whyvas/filament-falcon/docs/SPEC.md

# The Filament Falcon: master spec (v0.1)

A three-seat home spaceship cockpit: two small front seats (kids) side by side, one larger seat behind and centered (dad). Everything that a person touches is 3D printed and bolts to a wooden frame. This file is the single source of truth that the CAD, electronics, and game folders all follow. If something here has to change, change it here too.

## Computer
Linux Mint, AMD Ryzen 9 5900X (12c/24t), Radeon RX 6800 XT (16 GB, Vulkan/Mesa RADV), 32 GB RAM.
Four displays on the 6800 XT (2 x DP 1.4, 1 x HDMI 2.1, 1 x USB-C; max 4 heads, so all four heads are now in use), all 1920 x 1080 (mechanical details in `docs/mechanical/displays.md`). Screen roles, with the owner's xrandr output names as of v0.3:
- LEFT WINDOW (PILOT): Sceptre C275B-144R, 27" 1800R curved, up to 144 Hz (run at 75 Hz), VESA 100. Output DisplayPort-2.
- RIGHT WINDOW (OPS): Sceptre C275W-1920RN, 27" 1800R curved, 75 Hz, VESA 75. Output DisplayPort-1.
- KIDS' CONSOLE: ViewSonic TD2220, 21.5" optical touch (USB-B), VESA 100, DVI-D/VGA only -> DP (or USB-C) to DVI-D adapter. It lies flat in the reclining center console between the kids and faces them when reclined. Output DisplayPort-0. Use it in landscape (the game also handles portrait). The touch input must be mapped to this output (`xinput map-to-output`; `game/tools/setup_displays.sh` does it and `game/run.sh` runs it before every launch). While the game runs, `game/tools/touch_isolate.sh` keeps touches off the mouse pointer and the Commander's keyboard focus.
- COMMANDER: a 31.5" 1920 x 1080 monitor at dad's seat (mouse + keyboard, no touch). Output HDMI-A-0.
- The game assigns the roles by output name and physical size (console = the ~22" or portrait panel, commander = the biggest remaining screen, windows left to right). Each role can be pinned to any output in the settings file or on the Commander SETUP page. With only three screens the Commander UI becomes a tab on the kids' console (Esc). With fewer, dev mode tiles all four views in one window.
- VR: a Meta Quest 3 on a USB-C cable to the same PC, streamed by WiVRn (Flatpak `io.github.wivrn.wivrn`), which is the OpenXR runtime while the headset is connected. Setup in `docs/game/VR_SETUP.md`.
- With all four heads used, a later projector dome (`docs/mechanical/projector_dome_study.md`) has to replace the two window monitors, or use a USB/DP-MST splitter.

## Seats and motion
(Changed on the `cad` branch, v0.2: the swinging/raised seat platform is gone. Details in `frame/README.md`.)
- The seats sit on a floor-level frame. Flight sequence: (1) the kids' seat cradle (both kid seats, side consoles, sticks, center touchscreen) reclines 35 deg backwards, astronaut launch-style; (2) then the instrument POD (both monitors, dash panels, overhead panels) rotates down from its parked position above the kids into place in front of them. Exit = reverse order (pod up first, then seats upright).
- Both motions use 12 V self-locking linear actuators (2 for the cradle; ONE for the pod, in the left casing, with a steel torque tube tying the right pod cheek to the driven left one), slow (~35-40 s per motion). The pod's gas struts make it slightly lift-biased so an actuator failure sends it up, away from the kids, its pivot is the reclined head centre so it cannot approach the faces, steel hard stops set the end positions with measured clearances (>= 195 mm to the thighs, >= 250 mm to the head), and spring pawls lock it mechanically both UP and DOWN.
- Hardwired sequencing with limit switches: the pod can only come down when the seats are fully reclined, and the seats can only move while the pod is up and locked.
- Controls only at dad's seat, hardwired (no microcontroller in the loop): key switch, E-stop, a momentary hold-to-run FLT/BRD toggle, plus a latch-release lever that must be held for any pod motion (two-hand control). Circuit: 20 A fuse, key + E-stop drop a MOTION relay, 4 automotive relays as 2 H-bridges (cradle, pod), NC limit switches each bridged by a 1N5408, lock and lever switches in the relay coil paths, a safety edge on the pod chin in series with "pod DOWN" (`docs/electronics` diagram 04).
- The software may READ cradle/pod positions but never drives the actuators: three separate dry contacts through PC817 optocouplers into Falcon Command: CRADLE_RECLINED (GPIO39), POD_DOWN_LOCKED (GPIO40) and the optional POD_UP_LOCKED (GPIO41). The game shows POD UP / MOVING / DOWN-LOCKED and SEATS UPRIGHT / MOVING / RECLINED on the Commander screen and announces "pod coming down" etc. over the intercom.
- Dad's seat is fixed (no recline, no pod): he is the safety observer and must see the kids while anything moves.
- Homemade 4-point harnesses through a printed hub that houses the kit's own buckles (positioning harness, not crash-rated; load path through webbing and a steel ring). Motion only after the "harnesses fastened" step of the checklist (honour system, game shows it).

## Roles (designed to be equally fun)
- Left seat, PILOT ("Flight"): rotation and main engine. Joystick = pitch/roll/yaw + trigger. Throttle lever. Engine arm (covered toggle), ignition button, landing gear lever, flight-assist mode rotary (OFF / STAB / PROGRADE / HOLD), airbrake/flaps, boost, view cycle, horn.
- Right seat, OPS ("Systems/Commander"): translation, systems, and payload. Joystick = RCS translate X/Y + Z(twist) + trigger (also drives the robotic arm, tractor beam, and sensor camera depending on mode). Power distribution toggles (REACTOR, LIFE SUPPORT, SHIELDS, COMMS, SENSORS), mode rotary (RCS / ARM / SCANNER), cargo bay doors, docking clamp, scanner ping, fire suppression, nav target select, jump/warp arm + engage (covered).
- Each mission gives both seats a hero moment (e.g. Pilot flies the launch and landing; Ops does the docking translation, arm capture, and hyperspace jump).
- Rear seat, COMMANDER / MISSION CONTROL (dad): crew-motion hold switch + pod release lever (hardwired), key switch MASTER POWER, mission select rotary, START / PAUSE, MASTER CAUTION reset, failure-injection buttons (ENGINE FIRE, CABIN LEAK, POWER FAULT, SENSOR GLITCH), INTERCOM push-to-talk and ALL-CALL/PA buttons, cockpit lights dimmer.
- Optional 4th crew member, SPACEWALKER (VR): wears the Quest 3 and does spacewalks (EVA) standing in a clear area OUTSIDE the cockpit frame: handrails, SAFER jetpack, tether, tools, samples, the robotic arm's foot restraint. The crew sees them in the window views and camera feeds; the Commander starts and ends every EVA. Optional: everything also works on screen with no headset.
- Overhead console (shared, above the kids): launch checklist switch row (BATTERY, FUEL PUMPS, AVIONICS, APU START, GUIDANCE, IGNITION ARM), cabin lights, beacon, strobe, EJECT (covered, just for fun), each with a backlit label and status LED.
- Each kid also has a push-to-talk button on their board (16 mm momentary, within reach of the stick).
- Kids' console touchscreen (game UI, only for the two kids): attitude ball, speed/altitude tapes, fuel, engine/gear/flaps/assist, power distribution toggles, RCS/ARM/SCANNER mode, cargo doors, docking clamp, nav target and steer-to, overhead checklist status, camera feeds (docking/arm/chase), each kid's current task and MASTER CAUTION, a TALK pad per kid. Every touch control mirrors a hardware control; plugged-in hardware wins. While a board is unplugged its panels are drawn on screen (virtual panels, generated from the CAD layouts; guarded switches need two taps), with a touch joystick for a missing stick; the same for Falcon Command on the Commander screen.
- Commander screen (game UI, dad, mouse/keyboard): mission select and briefing, START/PAUSE/RESTART/skip step, harness check, failure injection, MASTER CAUTION reset, difficulty and assist settings, time warp, live score, a mission-control overview (orbit map, telemetry, crew status with both kids' current tasks, ship health, faults, crew position, intercom TALK / ALL-CALL / mutes), controls test, board status (plugged in or virtual), the Falcon Command panels on screen, the intercom page, and SETUP (screen roles, headsets, quality, FPS cap, vsync).

## Panels
- Dark panel body, white letters that go all the way through the panel so LEDs behind shine through them. One multi-material 3MF per panel: the panel and the letters are separate objects, each with its own extruder and colour. The letter object includes a 0.8 mm box behind every label (diffuser, inside the light box).
- A WS2812B strip channel on the back directly behind each lettered label, with light-blocking walls between labels. ONE continuous WS2812B strip snakes through every panel; segments are mapped later in `shared/led_segments.json`.
- Every panel uses one mounting standard: a 40 mm grid, M5 bolts into M5 T-nuts (or 1/4-20 if the owner prefers) pressed into 18 mm (3/4") plywood rails. Max part size 220 x 220 mm so it fits most printer beds; bigger panels split along the grid with alignment pins.
- Standard holes: 6.2 mm mini toggle, 12 mm and 16 mm momentary buttons, 19 mm/22 mm arcade buttons, 5 mm LED, EC11 rotary encoder (7 mm), key switch (19 mm), plus printed toggle covers (missile-switch guards).

## Electronics
- Microcontroller: ESP32-S3 (DevKitC-1 or equivalent with the native USB port). Reason: native USB so it enumerates as a real HID joystick on Linux and Windows with no drivers; the ESP8266 and classic ESP32 have no native USB.
- Three boards, each its own USB HID gamepad with a distinct product name: "Falcon Pilot" (left), "Falcon Ops" (right), "Falcon Command" (dad + overhead). Falcon Command is a composite device (HID + USB CDC serial) and also drives the single WS2812B data line.
- Lots of switches go through 74HC165 shift registers or MCP23017 expanders; analog axes go to ADC1 pins (3.3 V reference).
- The game sends LED state to Falcon Command over the CDC serial port using the protocol in `shared/led_protocol.md`.

## Intercom (ICS)
- Three USB headsets (Pilot, Ops, Commander). Each mic is heard in the other two headsets (optional low sidetone in your own); game audio (engine, alarms) and the voice callouts reach all three, with per-seat game and intercom volume.
- Per seat: VOX (threshold, attack, hang, live level meter) or push-to-talk (board button, keyboard key, or the on-screen TALK pad). Commander extras: ALL-CALL / PA to both kids (ducks game audio and the kids' mics), mute either kid's mic, and the MISSION CONTROL channel that carries the game's callouts.
- Optional radio effect: 300-3400 Hz band-pass, light compression, static, squelch tail, mic click / roger beep.
- Implementation: a separate low-latency helper (`game/tools/falcon_ics.py`, Python + numpy) on the PulseAudio protocol (`pactl`/`parec`/`pacat`), so it works on PulseAudio and PipeWire (`pipewire-pulse`). 5 ms blocks, target < 40 ms mic-to-ear. The game talks to it over localhost UDP (game -> 47810, helper -> 47811), routes its own output to the helper's `falcon_game` sink and its callouts to `falcon_mc`; `run.sh` starts it; without it the game plays sound normally.
- 4th seat SPACEWALKER: the Quest 3's speaker and mic as exposed by WiVRn ("WiVRn" sink, "WiVRn(microphone)" source), picked automatically; "suit radio" sound (400-2600 Hz, more static, Quindar tones); PTT on the left Touch controller. If the devices are missing the seat is empty (or a 4th USB headset is used).
- Headsets are assigned on Commander SETUP / ICS (IDENTIFY plays a tone in one headset), saved by product name + USB serial + USB port so replugging or re-ordering keeps them.

## Shared files (contracts between folders)
- `shared/panel_labels.json`: every backlit label id, its panel, and its text (written by CAD).
- `shared/input_map.json`: every game action -> device name + button index or axis (written by firmware; the game loads it and falls back to built-in defaults).
- `shared/led_segments.json`: label id -> start index + LED count on the one strip (placeholder until the owner measures the real strip).
- `shared/led_protocol.md`: serial protocol from game to Falcon Command.

## Game
Godot 4 (latest stable 4.x), Forward+ renderer on Vulkan, four windows (one per display: left window, right window, kids' console, commander), GDScript, plus the intercom helper (Python). Missions: launch to orbit, dock with a space station, lunar landing, asteroid-field rescue/mining, reentry and runway landing, plus a free-flight sandbox.
- VR spacewalks run in a SEPARATE process of the same project (`godot --xr-mode on -- --eva-client`, `run.sh --eva-vr`) that owns the OpenXR session and streams the astronaut's pose to the cockpit over localhost UDP 47820 at >= 60 Hz (~90 Hz); the cockpit interpolates it (45 ms buffer) and never loads OpenXR, so it runs unchanged with no headset or runtime. Spacewalks: window visit, antenna swap, asteroid sample + beacon, moonwalk, Canadarm rescue; the kids' console gets an EVA page (suit telemetry, HELMET CAM, EVA DRONE) during an EVA.

## Folders
- `cad/` 3D models (OpenSCAD source + exported 3MF + PNG renders); `frame/` wooden frame drawings, cut list, BOM.
- `firmware/` ESP32-S3 code; `docs/electronics/` wiring diagrams.
- `game/` Godot project; `docs/game/` design notes.
