whyvas/filament-falcon/frame/cut_list.md

# Cut list (generated by `frame/frame_model.py`)

All sizes in mm with inches in brackets. 2x4 = 38 x 89 mm actual (1.5" x 3.5").
Groups: **fixed** = base, nose box, towers/casings, ramp, dad dais; **cradle** = the reclining kid-seat frame; **pod** = the rotating instrument pod. Check every length against your real lumber before cutting.

| # | Group | Part | Material | Length | Width | Notes |
|---|---|---|---|---|---|---|
| 1 | fixed | Sill L | 2x4 (38 x 89) | 2450 (8' 0.5") |  | on edge, full length |
| 2 | fixed | Sill R | 2x4 (38 x 89) | 2450 (8' 0.5") |  | on edge, full length |
| 3 | fixed | Base cross, nose rear | 2x4 (38 x 89) | 1860 (6' 1.2") |  | 2x4 laid FLAT (actuators pass over it) |
| 4 | fixed | Base cross, cradle front | 2x4 (38 x 89) | 1860 (6' 1.2") |  | 2x4 laid FLAT; carries the cradle rest pads |
| 5 | fixed | Base cross, nose front | 2x4 (38 x 89) | 1860 (6' 1.2") |  | on edge between the sills |
| 6 | fixed | Base cross, cradle pivot | 2x4 (38 x 89) | 1860 (6' 1.2") |  | on edge between the sills |
| 7 | fixed | Base cross, casing front | 2x4 (38 x 89) | 1860 (6' 1.2") |  | on edge between the sills |
| 8 | fixed | Base cross, dais front | 2x4 (38 x 89) | 1860 (6' 1.2") |  | on edge between the sills |
| 9 | fixed | Base cross, dais mid | 2x4 (38 x 89) | 1860 (6' 1.2") |  | on edge between the sills |
| 10 | fixed | Base cross, rear | 2x4 (38 x 89) | 1860 (6' 1.2") |  | on edge between the sills |
| 11 | fixed | Base cross, recline stops | 2x4 (38 x 89) | 1860 (6' 1.2") |  | 2x4 laid FLAT (38 high) between the sills |
| 12 | fixed | Nose post front L | 2x4 (38 x 89) | 369 (14.5") |  | corner post |
| 13 | fixed | Nose post rear L | 2x4 (38 x 89) | 369 (14.5") |  | corner post |
| 14 | fixed | Nose post front R | 2x4 (38 x 89) | 369 (14.5") |  | corner post |
| 15 | fixed | Nose post rear R | 2x4 (38 x 89) | 369 (14.5") |  | corner post |
| 16 | fixed | Nose box front skin | 12 mm ply | 1960 (6' 5.2") | 470 (18.5") | 12 mm ply, full width |
| 17 | fixed | Nose box lid | 12 mm ply | 1936 (6' 4.2") | 300 (11.8") | screwed down (service lid), carpet on top = foot step |
| 18 | fixed | Nose box rear wall | 12 mm ply | 1860 (6' 1.2") | 369 (14.5") | 2 slots 80 x 360 for the actuators + brush strip; >= 30 mm gap to the cradle front |
| 19 | fixed | Tower post outer L | 2x4 (38 x 89) | 1011 (3' 3.8") |  | pod pivot: 25 mm shaft in a 4-bolt flange bearing / SHF25 + 6 mm steel plate on the post |
| 20 | fixed | Tower post inner L | 2x4 (38 x 89) | 1011 (3' 3.8") |  | inner shaft support (the 25 mm pod shaft is carried at both ends) |
| 21 | fixed | Casing post L d1262 | 2x4 (38 x 89) | 1011 (3' 3.8") |  | casing corner post |
| 22 | fixed | Casing post outer L d1262 | 2x4 (38 x 89) | 1011 (3' 3.8") |  | casing corner post |
| 23 | fixed | Casing post L d1922 | 2x4 (38 x 89) | 1011 (3' 3.8") |  | casing corner post |
| 24 | fixed | Casing post outer L d1922 | 2x4 (38 x 89) | 1011 (3' 3.8") |  | casing corner post |
| 25 | fixed | Casing tie L | 2x4 (38 x 89) | 190 (7.5") |  | top tie inner/outer posts |
| 26 | fixed | Side skin (casing) L | 12 mm ply | 1112 (3' 7.8") | 698 (2' 3.5") | 12 mm ply outer skin |
| 27 | fixed | Casing back L | 12 mm ply | 1112 (3' 7.8") | 278 (10.9") |  |
| 28 | fixed | Side skin (nose) L | 12 mm ply | 470 (18.5") | 300 (11.8") |  |
| 29 | fixed | Tower post outer R | 2x4 (38 x 89) | 1011 (3' 3.8") |  | pod pivot: 25 mm shaft in a 4-bolt flange bearing / SHF25 + 6 mm steel plate on the post |
| 30 | fixed | Tower post inner R | 2x4 (38 x 89) | 1011 (3' 3.8") |  | inner shaft support (the 25 mm pod shaft is carried at both ends) |
| 31 | fixed | Casing post R d1262 | 2x4 (38 x 89) | 1011 (3' 3.8") |  | casing corner post |
| 32 | fixed | Casing post outer R d1262 | 2x4 (38 x 89) | 1011 (3' 3.8") |  | casing corner post |
| 33 | fixed | Casing post R d1922 | 2x4 (38 x 89) | 1011 (3' 3.8") |  | casing corner post |
| 34 | fixed | Casing post outer R d1922 | 2x4 (38 x 89) | 1011 (3' 3.8") |  | casing corner post |
| 35 | fixed | Casing tie R | 2x4 (38 x 89) | 190 (7.5") |  | top tie inner/outer posts |
| 36 | fixed | Side skin (casing) R | 12 mm ply | 1112 (3' 7.8") | 698 (2' 3.5") | 12 mm ply outer skin |
| 37 | fixed | Casing back R | 12 mm ply | 1112 (3' 7.8") | 278 (10.9") |  |
| 38 | fixed | Side skin (nose) R | 12 mm ply | 470 (18.5") | 300 (11.8") |  |
| 39 | fixed | Ramp cheek L | 18 mm ply | 905 (2' 11.6") | 621 (2' 0.4") | triangular ply cheek under the ramp, screwed to the base (profile: see drawing 04) |
| 40 | fixed | Ramp cheek R | 18 mm ply | 905 (2' 11.6") | 621 (2' 0.4") | triangular ply cheek under the ramp, screwed to the base (profile: see drawing 04) |
| 41 | fixed | Ramp cheek centre | 18 mm ply | 905 (2' 11.6") | 621 (2' 0.4") | centre support (profile: see drawing 04) |
| 42 | fixed | Crush-zone ramp | 18 mm ply | 1083 (3' 6.6") | 1280 (4' 2.4") | 18 mm ply sloping sheet, parallel to the reclined seat backs, 120 mm below them; foam on top |
| 43 | fixed | Dais joist L | 2x4 (38 x 89) | 750 (2' 5.5") |  | 2x4 on edge on the base crosses + 72 mm block-up |
| 44 | fixed | Dais joist C | 2x4 (38 x 89) | 750 (2' 5.5") |  | 2x4 on edge on the base crosses + 72 mm block-up |
| 45 | fixed | Dais joist R | 2x4 (38 x 89) | 750 (2' 5.5") |  | 2x4 on edge on the base crosses + 72 mm block-up |
| 46 | fixed | Dais deck | 18 mm ply | 1200 (3' 11.2") | 750 (2' 5.5") |  |
| 47 | fixed | Dais front skin | 12 mm ply | 1200 (3' 11.2") | 250 (9.8") |  |
| 48 | fixed | Dad seat box | 18 mm ply box | 520 (20.5") | 450 (17.7") | outer 520 x 450 x 420 (W x D x H): top 520x450, 2 sides 450x402, front+back 484x402. 18 mm ply box, foam cushion |
| 49 | fixed | Dad seat back | 18 mm ply | 1310 (4' 3.6") | 520 (20.5") |  |
| 50 | fixed | Commander console | 18 mm ply box | 240 (9.4") | 400 (15.7") | outer 240 x 400 x 700 (W x D x H): top 240x400, 2 sides 400x682, front+back 204x682. CMD_A + CMD_B bay; motion switch + key + E-stop on CMD_B |
| 51 | fixed | Pod release lever box | 12 mm ply | 510 (20.1") | 160 (6.3") | left of dad's seat: 2 Bowden-cable latch release levers (second hand for the pod motion) |
| 52 | cradle | Cradle rail L | 2x4 (38 x 89) | 560 (22.0") |  | on edge; UCP205 pillow block bolted under the rear end (pivot) |
| 53 | cradle | Cradle rail R | 2x4 (38 x 89) | 560 (22.0") |  | on edge; UCP205 pillow block bolted under the rear end (pivot) |
| 54 | cradle | Cradle cross, front | 2x4 (38 x 89) | 1540 (5' 0.6") |  | 2x4 laid FLAT under the deck edge (actuators pass under it) |
| 55 | cradle | Cradle cross, actuator | 2x4 (38 x 89) | 1540 (5' 0.6") |  | on edge between the rails |
| 56 | cradle | Cradle cross, seats | 2x4 (38 x 89) | 1540 (5' 0.6") |  | on edge between the rails |
| 57 | cradle | Cradle cross, rear | 2x4 (38 x 89) | 1540 (5' 0.6") |  | on edge between the rails |
| 58 | cradle | Cradle joist L | 2x4 (38 x 89) | 371 (14.6") |  | between the crosses (pocket screws) |
| 59 | cradle | Cradle joist C | 2x4 (38 x 89) | 371 (14.6") |  | between the crosses (pocket screws) |
| 60 | cradle | Cradle joist R | 2x4 (38 x 89) | 371 (14.6") |  | between the crosses (pocket screws) |
| 61 | cradle | Cradle deck | 18 mm ply | 1616 (5' 3.6") | 560 (22.0") | footrest + seat base, glued + screwed |
| 62 | cradle | Cradle toe lip | 12 mm ply | 1616 (5' 3.6") | 70 (2.8") | keeps feet on the cradle |
| 63 | cradle | Cradle skirt L | 6 mm ply/hardboard | 460 (18.1") | 159 (6.3") | inner half of the telescoping side pinch guard |
| 64 | cradle | Cradle skirt R | 6 mm ply/hardboard | 460 (18.1") | 159 (6.3") | inner half of the telescoping side pinch guard |
| 65 | cradle | Kid seat box PILOT | 18 mm ply box | 340 (13.4") | 380 (15.0") | outer 340 x 380 x 193 (W x D x H): top 340x380, 2 sides 380x175, front+back 304x175. 18 mm ply box, foam cushion on top |
| 66 | cradle | Kid seat back PILOT | 18 mm ply | 1073 (3' 6.2") | 340 (13.4") | harness shoulder slots at 3 heights + headrest wings; the harness hub anchors to the cradle deck |
| 67 | cradle | Headrest wing PILOT out | 18 mm ply | 400 (15.7") | 130 (5.1") | side wings: head stays on the seat centre line |
| 68 | cradle | Headrest wing PILOT in | 18 mm ply | 400 (15.7") | 130 (5.1") | side wings: head stays on the seat centre line |
| 69 | cradle | Kid seat box OPS | 18 mm ply box | 340 (13.4") | 380 (15.0") | outer 340 x 380 x 193 (W x D x H): top 340x380, 2 sides 380x175, front+back 304x175. 18 mm ply box, foam cushion on top |
| 70 | cradle | Kid seat back OPS | 18 mm ply | 1073 (3' 6.2") | 340 (13.4") | harness shoulder slots at 3 heights + headrest wings; the harness hub anchors to the cradle deck |
| 71 | cradle | Headrest wing OPS in | 18 mm ply | 400 (15.7") | 130 (5.1") | side wings: head stays on the seat centre line |
| 72 | cradle | Headrest wing OPS out | 18 mm ply | 400 (15.7") | 130 (5.1") | side wings: head stays on the seat centre line |
| 73 | cradle | Centre console (TD2220) | 18 mm ply box | 560 (22.0") | 380 (15.0") | outer 560 x 380 x 333 (W x D x H): top 560x380, 2 sides 380x315, front+back 524x315. TD2220 drops into a 530 x 328 cut-out in the top, on a printed VESA riser + internal ply shelf; printed trim ring |
| 74 | cradle | Front pedestal | 18 mm ply box | 560 (22.0") | 180 (7.1") | outer 560 x 180 x 243 (W x D x H): top 560x180, 2 sides 180x225, front+back 524x225. pilot joystick + OPS_SIDE panel |
| 75 | cradle | Side console PILOT | 18 mm ply box | 200 (7.9") | 240 (9.4") | outer 200 x 240 x 391 (W x D x H): top 200x240, 2 sides 240x373, front+back 164x373. PILOT_SIDE + throttle + gear |
| 76 | cradle | Side console OPS | 18 mm ply box | 200 (7.9") | 240 (9.4") | outer 200 x 240 x 391 (W x D x H): top 200x240, 2 sides 240x373, front+back 164x373. Ops joystick |
| 77 | pod | Pod back sheet | 12 mm ply | 1612 (5' 3.5") | 735 (2' 4.9") | monitors' VESA adapters bolt through it |
| 78 | pod | Pod lower band (dash) | 18 mm ply | 1612 (5' 3.5") | 195 (7.7") | 2 dash bays 400 x 160 + M5 T-nuts on the 40 mm grid |
| 79 | pod | Pod top band (overhead) | 18 mm ply | 1612 (5' 3.5") | 140 (5.5") | overhead bay 600 x 120 |
| 80 | pod | Pod chin plate | 12 mm ply | 1612 (5' 3.5") | 102 (4.0") | leading edge; safety edge + 25 mm foam on its front |
| 81 | pod | Pod top cap | 12 mm ply | 1612 (5' 3.5") | 102 (4.0") |  |
| 82 | pod | Pod stiffener rail 1 | 2x4 (38 x 89) | 1612 (5' 3.5") |  | 2x4 flat behind the back sheet |
| 83 | pod | Pod stiffener rail 2 | 2x4 (38 x 89) | 1612 (5' 3.5") |  | 2x4 flat behind the back sheet |
| 84 | pod | Pod cheek L | 18 mm ply | 1183 (3' 10.6") | 907 (2' 11.7") | 2 x 18 mm ply laminated (glue + screws); UCF205 flange bearing at the pivot, crank pins for strut + actuator (profile: see drawing 04) |
| 85 | pod | Pod cheek R | 18 mm ply | 1183 (3' 10.6") | 907 (2' 11.7") | 2 x 18 mm ply laminated (glue + screws); UCF205 flange bearing at the pivot, crank pins for strut + actuator (profile: see drawing 04) |
| 86 | fixed | Casing inner wall L | 12 mm ply | 1112 (3' 7.8") | 698 (2' 3.5") | 12 mm ply between kid and mechanism (full height) |
| 87 | fixed | Casing front wall L (inner) | 12 mm ply | 1112 (3' 7.8") | 110 (4.3") | slot for the cheek next to it, brush strip on both slot edges |
| 88 | fixed | Casing front wall L (outer) | 12 mm ply | 1112 (3' 7.8") | 120 (4.7") |  |
| 89 | fixed | Casing front wall L (below slot) | 12 mm ply | 839 (2' 9.0") | 48 (1.9") | slot bottom = lowest cheek edge - 40 mm |
| 90 | fixed | Casing top L (inner) | 12 mm ply | 710 (2' 4.0") | 110 (4.3") | lift-off service lid |
| 91 | fixed | Casing top L (outer) | 12 mm ply | 710 (2' 4.0") | 120 (4.7") |  |
| 92 | fixed | Casing top L (behind slot) | 12 mm ply | 375 (14.8") | 48 (1.9") |  |
| 93 | fixed | Strut anchor post L | 2x4 (38 x 89) | 1011 (3' 3.8") |  | gas-strut lower ball stud on a steel angle bracket |
| 94 | fixed | Casing inner wall R | 12 mm ply | 1112 (3' 7.8") | 698 (2' 3.5") | 12 mm ply between kid and mechanism (full height) |
| 95 | fixed | Casing front wall R (inner) | 12 mm ply | 1112 (3' 7.8") | 110 (4.3") | slot for the cheek next to it, brush strip on both slot edges |
| 96 | fixed | Casing front wall R (outer) | 12 mm ply | 1112 (3' 7.8") | 120 (4.7") |  |
| 97 | fixed | Casing front wall R (below slot) | 12 mm ply | 839 (2' 9.0") | 48 (1.9") | slot bottom = lowest cheek edge - 40 mm |
| 98 | fixed | Casing top R (inner) | 12 mm ply | 710 (2' 4.0") | 110 (4.3") | lift-off service lid |
| 99 | fixed | Casing top R (outer) | 12 mm ply | 710 (2' 4.0") | 120 (4.7") |  |
| 100 | fixed | Casing top R (behind slot) | 12 mm ply | 375 (14.8") | 48 (1.9") |  |
| 101 | fixed | Strut anchor post R | 2x4 (38 x 89) | 1011 (3' 3.8") |  | gas-strut lower ball stud on a steel angle bracket |

**2x4 boards:** 45 pieces from **22 x 8 ft (2438 mm)** + **2 x 10 ft (3048 mm)** boards (first-fit packing, 4 mm kerf; buy 3 spares). The 2450 mm sills need 10 ft boards (or 2 x 8 ft spliced over a base cross).

Board packing:
- board 1 (10 ft): 2450  (waste 594 mm)
- board 2 (10 ft): 2450  (waste 594 mm)
- board 3 (8 ft): 1860 + 560  (waste 10 mm)
- board 4 (8 ft): 1860 + 560  (waste 10 mm)
- board 5 (8 ft): 1860 + 371 + 190  (waste 5 mm)
- board 6 (8 ft): 1860 + 371 + 190  (waste 5 mm)
- board 7 (8 ft): 1860 + 371  (waste 199 mm)
- board 8 (8 ft): 1860 + 369  (waste 201 mm)
- board 9 (8 ft): 1860 + 369  (waste 201 mm)
- board 10 (8 ft): 1860 + 369  (waste 201 mm)
- board 11 (8 ft): 1860 + 369  (waste 201 mm)
- board 12 (8 ft): 1612 + 750  (waste 68 mm)
- board 13 (8 ft): 1612 + 750  (waste 68 mm)
- board 14 (8 ft): 1540 + 750  (waste 140 mm)
- board 15 (8 ft): 1540  (waste 894 mm)
- board 16 (8 ft): 1540  (waste 894 mm)
- board 17 (8 ft): 1540  (waste 894 mm)
- board 18 (8 ft): 1011 + 1011  (waste 408 mm)
- board 19 (8 ft): 1011 + 1011  (waste 408 mm)
- board 20 (8 ft): 1011 + 1011  (waste 408 mm)
- board 21 (8 ft): 1011 + 1011  (waste 408 mm)
- board 22 (8 ft): 1011 + 1011  (waste 408 mm)
- board 23 (8 ft): 1011 + 1011  (waste 408 mm)
- board 24 (8 ft): 1011 + 1011  (waste 408 mm)

**Sheet goods** (area incl. seat/console boxes; 4 x 8 ft = 1220 x 2440 mm sheets, ~30 % waste allowance; the pod cheeks are 2 layers each):

- 12 mm ply: 9.16 m2 (99 sq ft) -> **4 sheet(s)**
- 18 mm ply: 13.48 m2 (145 sq ft) -> **6 sheet(s)**
- 6 mm ply/hardboard: 0.15 m2 (2 sq ft) -> **1 sheet(s)**
