whyvas/filament-falcon/docs/game/CREDITS.md

# Credits: The Filament Falcon game

- **Engine:** [Godot Engine](https://godotengine.org) 4.7 (MIT). It is not bundled in this repo.
- **Art:** none downloaded. The planet, clouds, city lights, Moon, terrain, star field, Milky Way, ship,
  station, asteroids and runway are all generated procedurally at run time from code and shaders in `game/`.
- **Audio:** none downloaded. Engine rumble, RCS puffs, alarms, clunks, the laser and tones are synthesized in
  `game/scripts/autoload/sfx.gd`.
- **Voice:** uses the player's system `espeak-ng` (GPL-3.0) or a user-installed piper voice at run time. Nothing is bundled.
- **Font:** Godot's built-in default font.

Total size of third-party assets in the repo: **0 bytes**.
