whyvas/filament-falcon/frame/drawings/frame_drawings.pdf

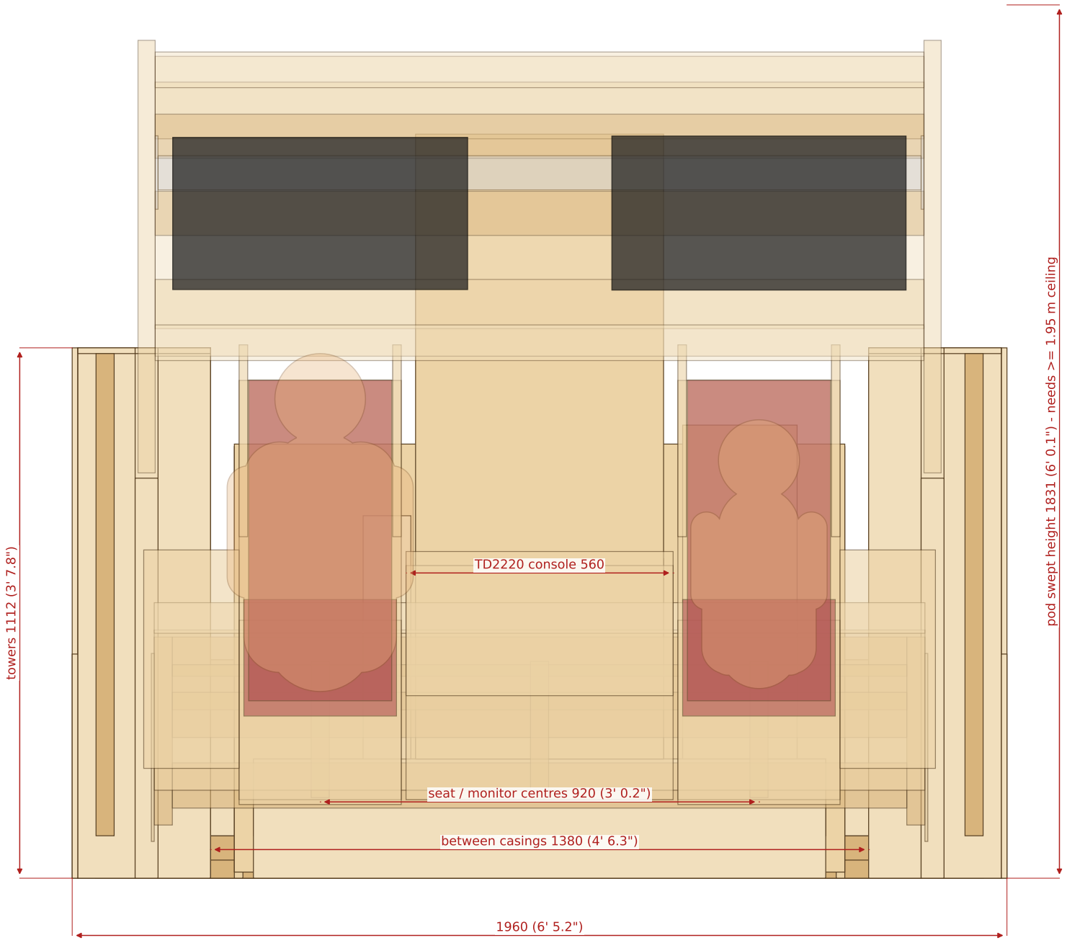
[picture p117: figure]
towers 1112 (3' 7.8"); seat / monitor centres 920 (3' 0.2"); between casings 1380 (4' 6.3"); TD2220 console 560

pod swept height 1831 (6' 0.1") - needs >= 1.95 m ceiling

Pod (blue-grey) carries both monitors, the 4 dash panels (lower band) and the 3 overhead panels (top band). The cradle carries the seats, the TD2220 centre console, both side consoles and the sticks. Dad's dais (behind) is fixed.

1. Front elevation, FLIGHT position (cradle reclined 35 deg, pod down) - nose box front skin removed
The Filament Falcon - frame v0.3 (recline + drop-down pod, single pod actuator) | all dimensions mm (inches) | 2x4 = 38 x 89 mm, ply 18 mm unless noted | generated by frame/make_drawings.py from frame/frame_model.py

the pod body never enters this | 574 mm radius around the pivot
(it rotates AROUND the head | - it cannot approach the face)

2 x cradle actuators in the nose box 10" stroke, travel 231 mm,
376 -> 607 pin-pin, PUSH to recline

ONE pod actuator (LEFT casing only)
12" stroke, 1500 N self-locking, travel 270 mm,
436 -> 706 pin-pin, retract = pod up, extend = pod down

TORQUE TUBE 2x2x1/8" steel, cheek to cheek (drives the right cheek; 298 N*m/deg)

2 x gas struts, one per side (1050 N ext / ~1575 N compressed, ~240 mm ext., >= 71 mm stroke): pod LIFT-biased +16..+88 N*m

fixed CRUSH-ZONE RAMP: 120 | mm under the
reclined seat | backs, | nothing can be trapped
between seat backs | and floor

MOTION: hold FLIGHT -> cradle reclines 0 -> 35 deg (~39 s), then the pod swings down 95 -> 40 deg (~34 s). Hold BOARD -> pod up first, then seats upright.

Clearances at the hard stops (12 yr manikin = worst case): pod chin to thighs/shins 195 mm (ISO 13854 leg >= 180), pod to head 251 mm, pod parked UP: lowest point over the seats z = 1639 mm. Eye -> screen centre: 12 yr 542 mm, 6 yr 590 mm. Pod mass 52 kg (model), CG 613 mm from its pivot.

2450 (8' 0.5")

towers 1112

200

840

pod pivot 1375 (4' 6.1") behind the front

1005

dais 250
CRADLE PIVOT
25 mm shaft, 2 x UCP205
(840, 200)

POD PIVOT = reclined
12 yr head centre
(1375, 1005)

pod chin path (r 733)
55 deg of travel
2. Side elevation + MOTION GEOMETRY (from the right, front at the right). Solid = BOARDING (upright, pod up 95 deg), blue dashed = FLIGHT (recline 35 deg, pod down 40 deg)

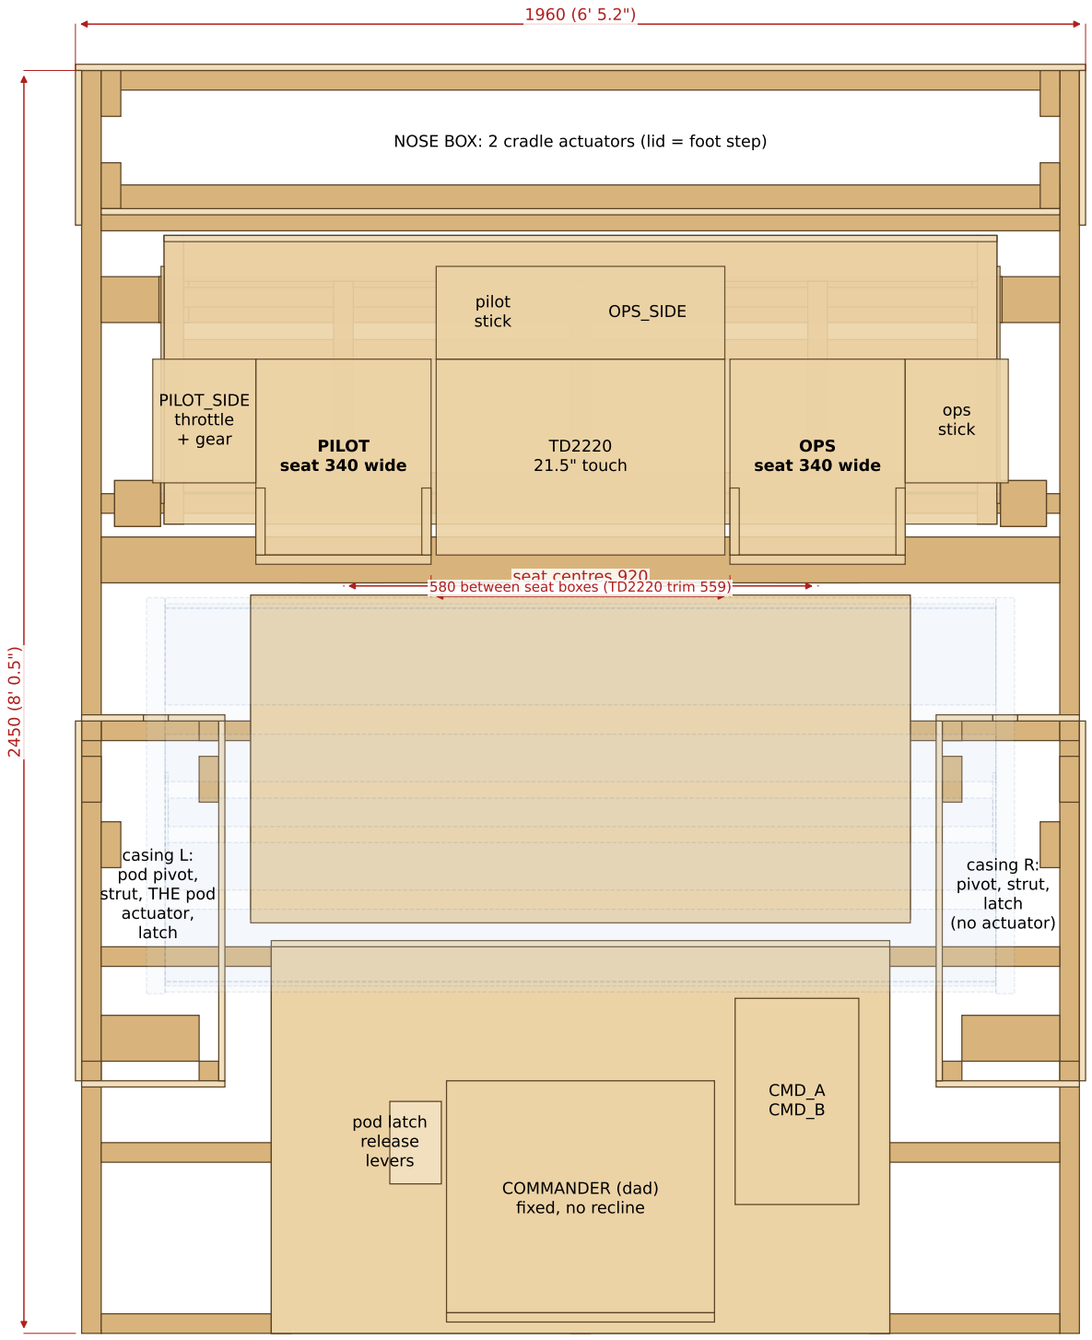
[picture p118: figure]
PILOT seat 340 wide; OPS seat 340 wide; TD2220 21.5" touch; pilot; stick; OPS_SIDE; PILOT_SIDE throttle + gear; ops stick; COMMANDER (dad); fixed, no; recline; CMD_A CMD_B pod latch; release levers; casing L:; pod; pivot,; strut,; THE pod; actuator, latch; casing R: pivot, strut, latch (no actuator)

NOSE BOX: 2 cradle actuators (lid = foot step)

seat centres 920 580 between seat boxes (TD2220 trim 559)

3. Plan view, BOARDING position (from above, front at the top; pod parked up shown dashed)

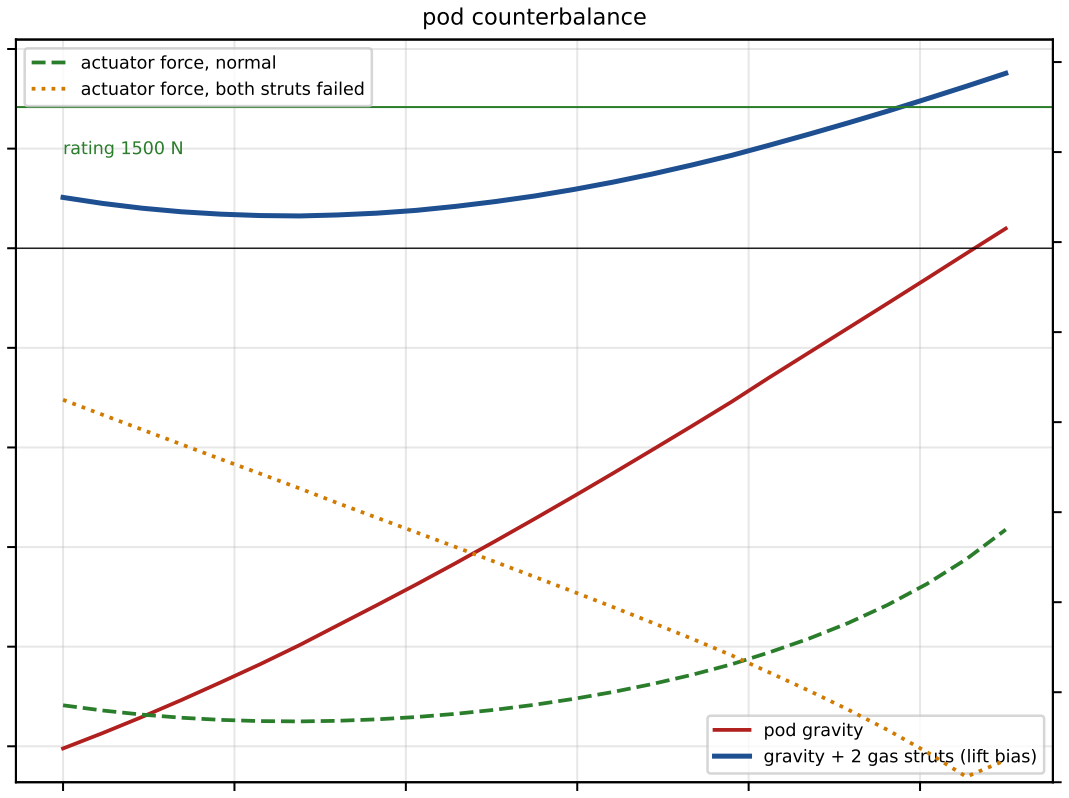
[picture p119: figure]
pod counterbalance; pod gravity; gravity + 2 gas struts (lift bias); rating 1500 N

40 | 50 | 60 | 70 | 80 | 90

### pod angle (deg): 40 = down / flight, 95 = up / boarding

−250

−200

−150

−100

−50

0

50

100

### N*m (+ = lifts)

0

200

400

600

800

1000

1200

1400

1600

### single actuator force (N)

actuator force, normal actuator force, both struts failed

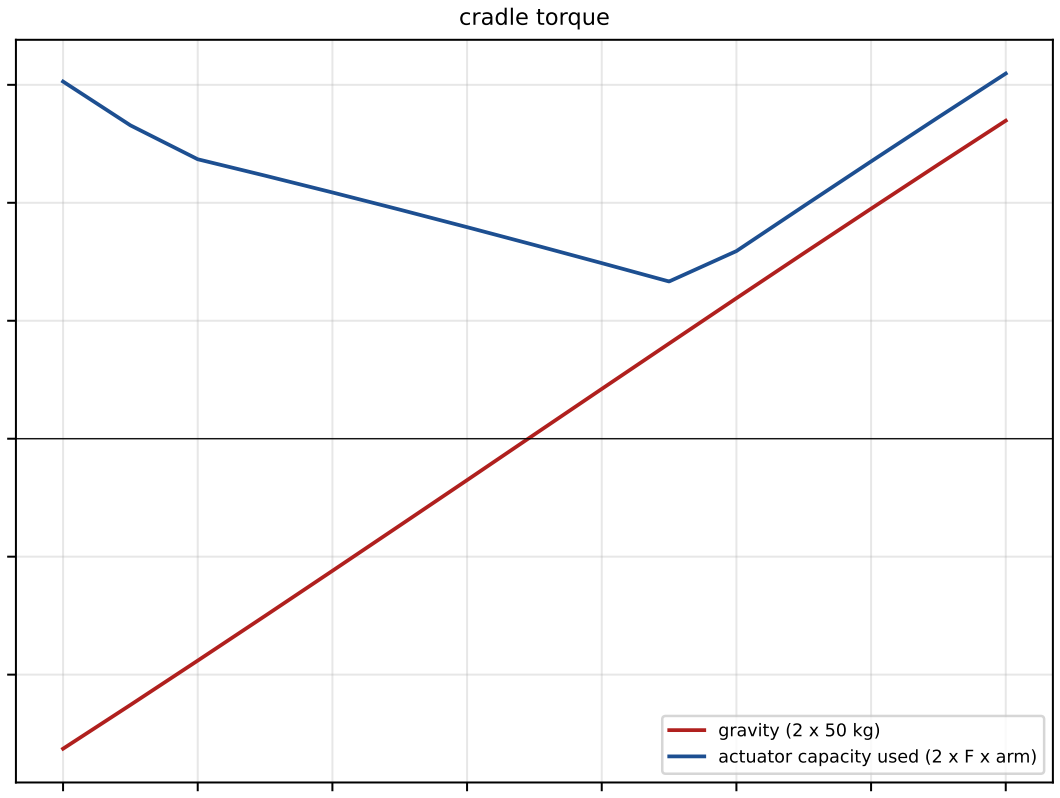
[picture p120: figure]
cradle torque; gravity (2 x 50 kg); actuator capacity; used (2 x F x arm)

0 | 5 | 10 | 15 | 20 | 25 | 30 | 35

### recline (deg)

−200

−100

0

100

200

300

N*m

## 4. Mechanism sizing, locks, hard stops and the hardwired interlock

CRADLE (both kid seats, consoles, TD2220) - recline 0 -> 35 deg about the 25 mm shaft at (840, 200)
design load: 2 occupants x 50 kg + cradle ~158 kg -> gravity torque -263 .. +270 N*m
(negative = wants to sit up: rests on the front rubber pads; positive = wants to lie back: rests on the recline stop blocks) 2 actuators, 10" (254 mm) stroke, retracted ~364 pin-pin; used travel 376 -> 607 mm
peak force 775 N EACH (incl. +40 N*m friction) -> BUY 2 x 1500 N (330 lbf) 12 V, self-locking (acme), ~5-8 mm/s

POD (2 monitors, 7 panels, torque tube, ~52 kg) - swings 95 -> 40 deg about (1375, 1005) = the reclined 12 yr head centre
gravity torque -251 .. +10 N*m; with the 2 gas struts: +16 .. +88 N*m
-> LIFT-BIASED over the whole travel: if the actuator or its clevis pin fails the pod rises to the UP stop (away from the kids); at DOWN the spring pawls + the self-locking actuator hold it; at UP the struts press it on the stop and the pawls lock it. gas struts: 2 x ~1050 N (F1, extended, progression 1.5), ~240 mm extended, >= 71 mm stroke, M8 eye ends, rod DOWN, damped
ONE pod actuator (left casing, x = -773), 12" stroke (retracted ~420), travel 436 -> 706 mm, pin (1677, 960), anchor (1402, 310)
force: normal (2 struts, +25 N*m friction) <= 561 N; | one strut failed 466 N; | BOTH struts failed 850 N
-> BUY 1 x 1500 N (337 lbf) 12 V self-locking, <= 10 mm/s (~27 s); margin 1.8x struts-failed, 2.7x normal
TORQUE TUBE 2 x 2 x 1/8 in square steel tube (50.8 x 50.8 x 3.2), 1600 mm cheek to cheek, J = 345e3 mm4, 298 N*m/deg:
normal (2 struts) | 44 N*m, twist 0.15 deg, chin | 2.1 mm, 3 MPa
far-side strut failed | 126 N*m, twist 0.42 deg, chin | 6.0 mm, 9 MPa
both struts failed | 126 N*m, twist 0.42 deg, chin | 6.0 mm, 9 MPa
actuator stall at rating vs far-side stop | 458 N*m, twist 1.53 deg, chin 22.0 mm, 32 MPa
ends: welded 6 mm plates, 4 x M10 through each 36 mm cheek + 6 mm backing plate.
Set the RIGHT cheek's stops 1-2 mm 'later' than the left so the actuator never twists the tube
against a stop; the far side is carried by the tube, not by racking the cheeks.

HARD STOPS (steel, bolted; they - not the actuators - define the end positions):
cradle upright: rails on 6 mm rubber pads (z 114); cradle reclined: seat boxes land on rubber stop blocks at 35 deg (+0.5) pod DOWN: 6 mm steel stop pin on each cheek crank lands on a rubber-faced steel angle in the casing at 40 deg
pod UP: same pin on a second stop at 95 deg. External limit switches stop the actuators 2-3 mm before each stop.

LOCKS (mechanical, both ends):
pod: spring-loaded steel pawl in each casing drops into a notch in a 6 mm steel latch plate on the cheek at UP and at DOWN (ramped like a door latch: it clicks in by itself). Dad releases both pawls with one Bowden-cable lever LEFT of his seat; a micro switch on the lever is in series with the pod motors -> the pod can only move while dad holds the lever
AND the switch (two-hand hold-to-run). 'Pawl engaged' micro switches feed the interlock below.
cradle: self-locking actuators + stops; the pod interlock keeps it from moving under a lowered pod.

HARDWIRED INTERLOCK (no microcontroller can move anything; the game only READS 3 isolated senses):
12V+ --[20A fuse]--[MOTION key]--[E-STOP NC]--+--CREW POS (ON)-OFF-(ON) hold-to-run DPDT (drives 4 relays)
ONE pod limit set: POD_UP + POD_DOWN roller switches on the LEFT (driven) cheek only; the right side has only its pawl switch. FLIGHT (toggle up):
cradle RECLINE runs | while | POD_UP_LOCKED (both pawls) | AND | NOT CRADLE_RECLINED limit
pod DOWN runs | while | CRADLE_RECLINED (both sides) AND | release lever held | AND | NOT POD_DOWN limit
BOARD (toggle down):
pod UP runs | while | release lever held | AND | NOT POD_UP limit
cradle UPRIGHT runs | while | POD_UP limit AND POD_UP_LOCKED | AND | NOT CRADLE_UPRIGHT limit
=> the pod can never come down unless the seats are fully reclined, and the seats never move under a lowered pod.
Pod chin carries a pressure-sensitive SAFETY EDGE (NC) in series with 'pod DOWN'.
Limit switches: roller-lever micro switches (NC) on the stops, 1N5408 diode across each so you can always reverse.
Relays: 4 x 30 A automotive SPDT (Bosch-type) wired as 2 H-bridges (cradle: 2 actuators in parallel; pod: 1 actuator); 12 V 20 A supply. Position senses (READ-ONLY, 3 separate NO micro switches, PC817 optos -> Falcon Command GPIO39/40/41):
CRADLE_RECLINED, POD_DOWN_LOCKED (pawl in DOWN notch), POD_UP_LOCKED (optional). Never in the motor path.
The Filament Falcon - frame v0.3 (single pod actuator) | numbers from frame/generated/geometry.json (frame_model.py) | ISO 13854 min. gaps: finger 25, hand/arm 100-120, foot 120, leg 180 mm

## 5. Pinch points, guards and computed clearances

Computed by frame_model.py from the CAD (manikins: 95th pct 12 yr / 50th pct 6 yr, capsule bodies).

POD (sweeping 95 -> 40 deg) vs the RECLINED kids - closest approach anywhere in the travel:
PILOT upper arm | 155 mm | (pod at | 95.0 deg, Pod cheek L)
PILOT thigh | 195 mm | (pod at | 40.0 deg, Pod chin plate)
PILOT shin | 220 mm | (pod at | 40.0 deg, Pod chin plate)
PILOT torso | 233 mm | (pod at | 95.0 deg, Pod cheek L)
OPS | upper arm | 241 mm | (pod at | 95.0 deg, Pod cheek R)
PILOT head | 251 mm | (pod at | 40.0 deg, Pod cheek L)
OPS | head | 261 mm | (pod at | 76.7 deg, Pod cheek R)
OPS | torso | 288 mm | (pod at | 95.0 deg, Pod cheek R)
PILOT neck | 296 mm | (pod at | 88.1 deg, Pod cheek L)
PILOT forearm | 303 mm | (pod at | 95.0 deg, Pod cheek L)

CRADLE (reclining with the pod parked up) vs fixed structure / pod / dad:
34 mm | Cradle rail L | <-> Nose box rear wall | at | 7.5 deg
35 mm | PILOT kid upper arm | <-> Casing front wall L (inner) | at 32.5 deg
35 mm | PILOT kid upper arm | <-> Casing inner wall L | at 35.0 deg
35 mm | Cradle rail R | <-> Nose box rear wall | at | 5.0 deg
40 mm | Cradle toe lip | <-> Nose box rear wall | at | 0.0 deg
47 mm | PILOT kid foot | <-> Nose box rear wall | at | 0.0 deg
60 mm | Kid seat back PILOT | <-> Casing top L (inner) | at 27.5 deg
60 mm | Headrest wing PILOT out | <-> Casing front wall L (inner) | at 30.0 deg
60 mm | Kid seat back OPS | <-> Casing inner wall R | at 35.0 deg
60 mm | Headrest wing OPS out | <-> Casing inner wall R | at 32.5 deg
64 mm | PILOT kid shin | <-> Nose box lid | at | 0.0 deg
81 mm | PILOT kid foot | <-> Nose box lid | at 17.5 deg

POD vs structure:
176 mm | Pod cheek L <-> (cradle reclined) Headrest wing PILOT out at 90.4 deg
176 mm | Pod cheek L <-> (cradle reclined) Kid seat back PILOT at 79.0 deg

Pod cheek in its casing slot: 66 mm to the inner post, 50 mm to the outer post (strut lives there).

HOW EACH PINCH POINT IS HANDLED:
1 pod chin vs knees/shins/hands : hard stop keeps >= 180 mm (leg); 25 mm foam + NC safety edge on the chin; slow (<= 10 mm/s)
2 pod vs heads | : pivot = head centre -> constant radius, the pod cannot close on a head (>= 250 mm)
3 cheeks in the casing slots | : 48 mm slot, cheek 36 mm -> 6 mm each side (< finger) + brush strip both edges
4 struts / pod actuator | : fully inside the casings (12 mm ply, screwed lids); only the cheek crosses the slot
5 cradle front vs nose box | : >= 30 mm gap all the way (finger 25) + brush strip on the actuator slots
6 cradle sides vs floor | : 6 mm hardboard skirts on the cradle sides overlap the fixed base skins (telescoping guard)
7 under the reclining seat backs: fixed crush-zone ramp 120 mm below the reclined backs (arm); foam on top
8 seat backs vs casings | : 60 mm side gap, motion is parallel to the wall (no closing edge)
9 kids' arms vs casing front edge: arm-to-casing >= 35 mm laterally at full recline; 'hands on lap' + dad watches
10 dad | : fixed seat, nothing moves within his reach except the pod back (>= 400 mm from his head)
11 cables across both pivots | : printed pivot clamps <= 60 mm from the axis + 200 mm U service loop in braided sleeve

The Filament Falcon - frame v0.3

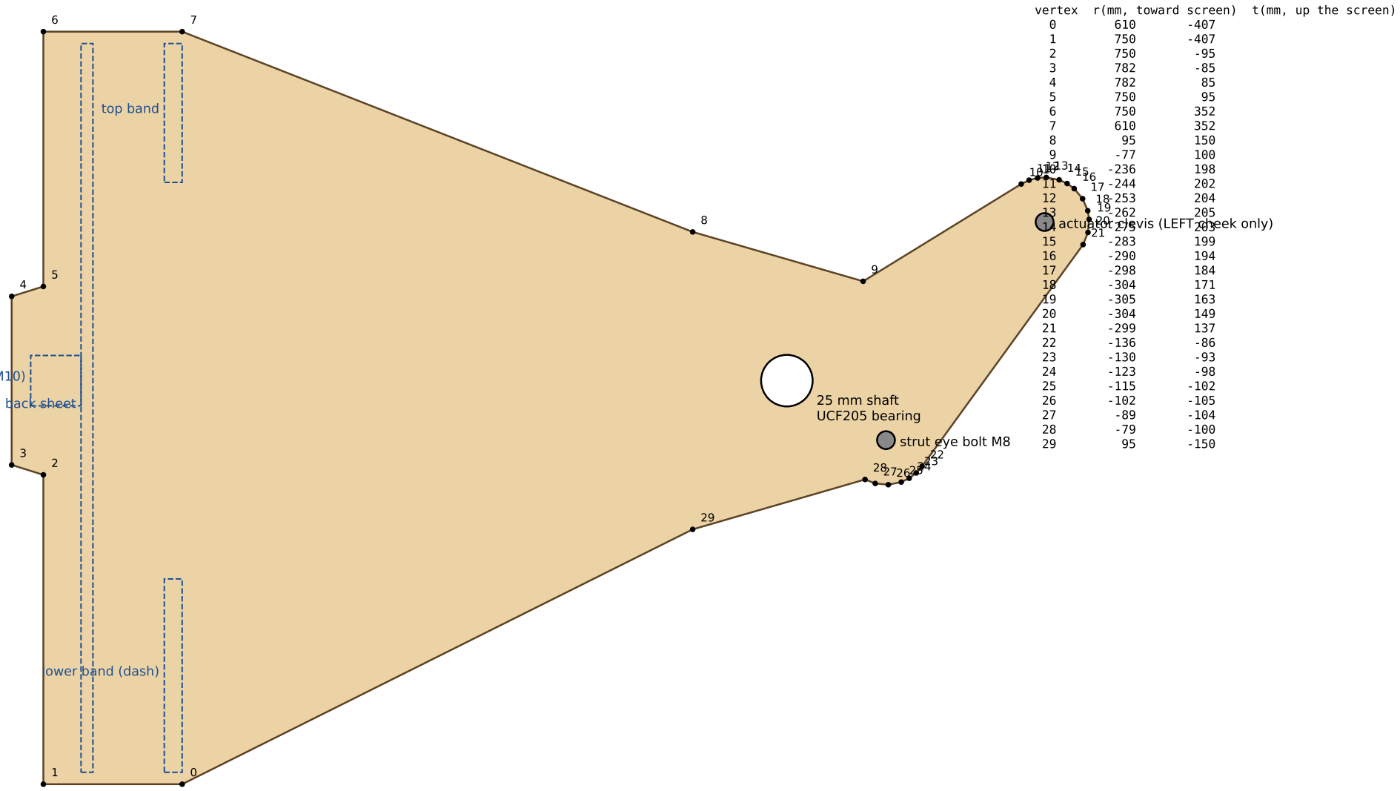
[picture p121: figure]
25 mm shaft UCF205 bearing; strut eye bolt M8; actuator clevis (LEFT cheek only); lower; band (dash); top band; back sheet; vertex; r(mm, toward screen); t(mm, up the screen)

TORQUE TUBE 2x2" + 6 mm end plate (4 x M10)

Latch plate (6 mm steel, bolted to the cheek, centred on the pivot): notches at the UP and DOWN angles.
Stop pin (12 mm steel) through the crank lobe hits rubber-faced steel angles in the casing at both ends.
Print this sheet 1:1 in tiles or transfer the coordinates; both cheeks of a side are glued + screwed together (36 mm).
6. Pod cheek (2 per side, 18 mm ply, laminated) - cutting template coordinates, pivot at (0,0), screen axis to the left

18 mm ply
band

printed panel, 3 mm

light boxes
+ switches
live in the
opening

M5 x 20 button head + washer from the front,
4-prong M5 T-nut pressed into the back of the band

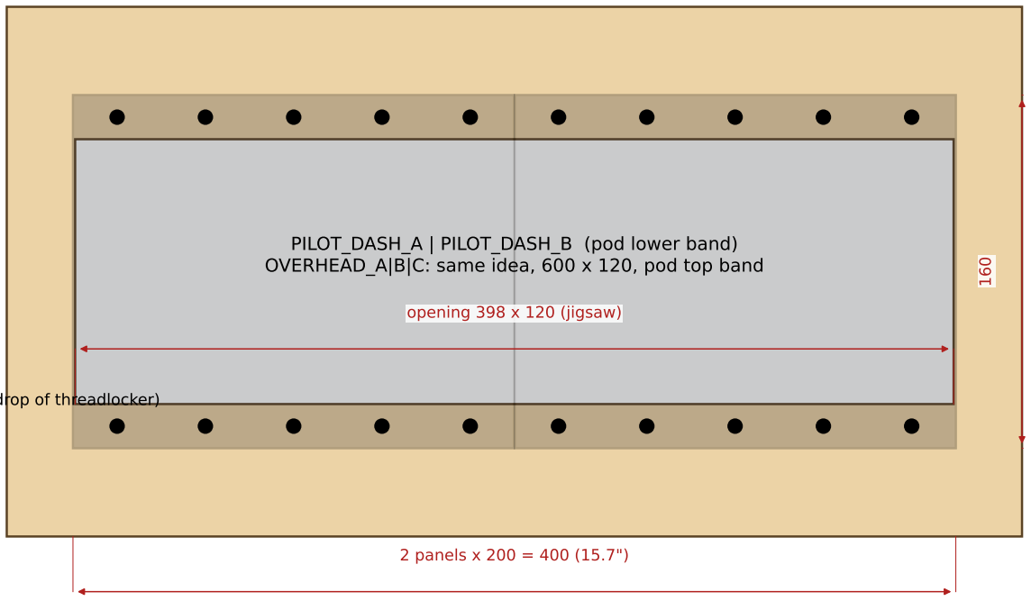
[picture p122: figure]
2 panels x 200 = 400 (15.7"); opening 398 x 120 (jigsaw)

(the pod turns the panels face-DOWN when parked: use nyloc T-nuts or a drop of threadlocker)

Panel = n x 40 mm nominal (printed 0.5 mm smaller). Top + bottom 20 mm bands sit flat on the plywood.
PILOT_DASH_A | PILOT_DASH_B (pod lower band) OVERHEAD_A|B|C: same idea, 600 x 120, pod top band
7. Panel bay detail - how every printed panel bolts to the plywood bands (40 mm grid, M5 into T-nuts)
