whyvas/filament-falcon/cad/export/png/dome_concept_3q.png

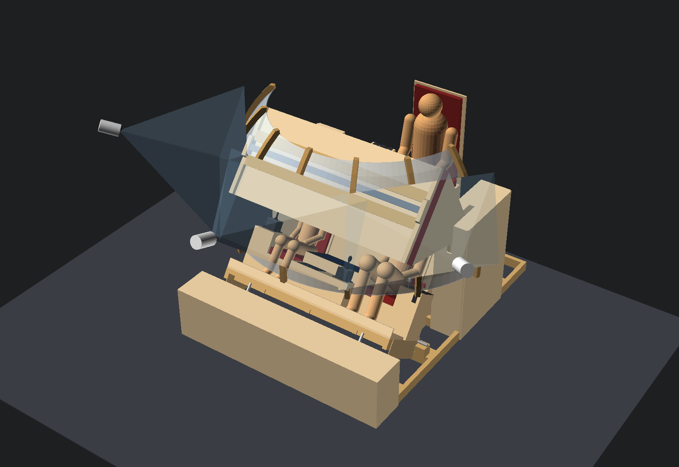
cad/export/png/dome_concept_3q.png
