whyvas/filament-falcon/cad/export/png/dome_concept_side.png

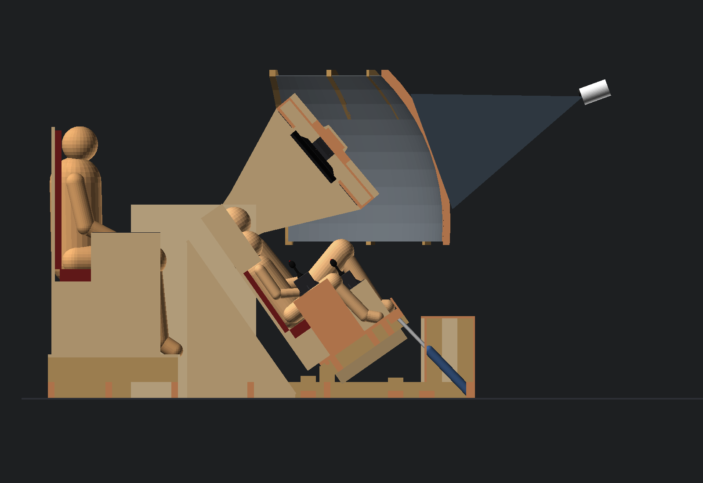
cad/export/png/dome_concept_side.png
