whyvas/filament-falcon/cad/export/png/overview_boarding.png

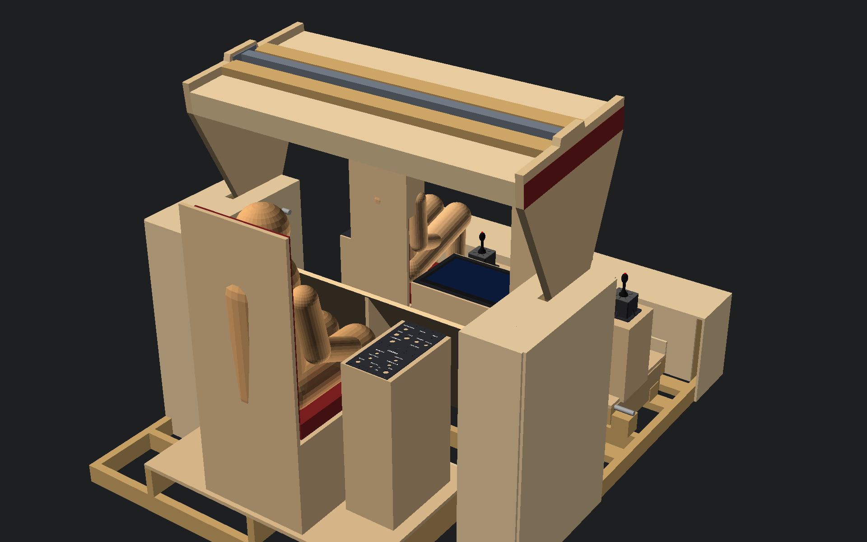
cad/export/png/overview_boarding.png
