whyvas/filament-falcon/cad/export/png/overview_boarding_front.png

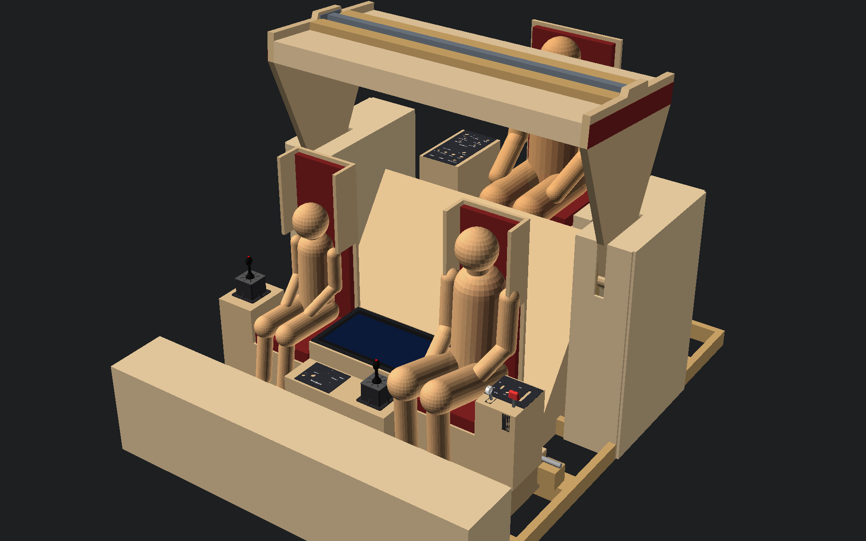
cad/export/png/overview_boarding_front.png
