whyvas/filament-falcon/cad/export/png/overview_dad_view.png

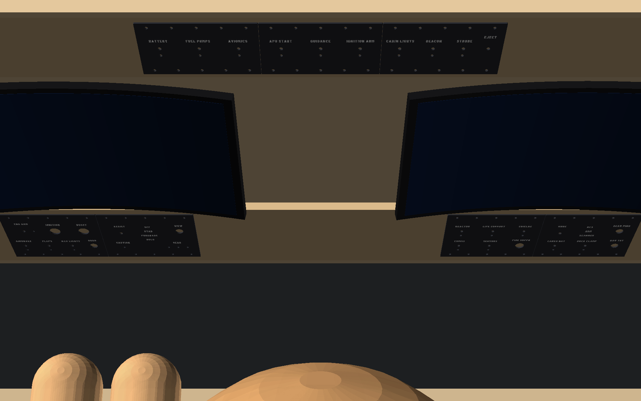
cad/export/png/overview_dad_view.png
