whyvas/filament-falcon/cad/export/png/overview_flight_front.png

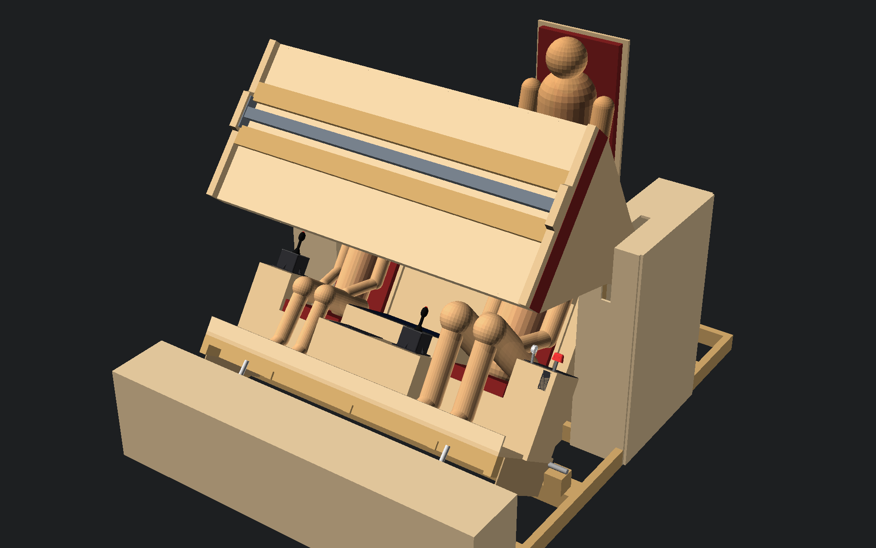
cad/export/png/overview_flight_front.png
