whyvas/filament-falcon/cad/export/png/overview_side_boarding.png

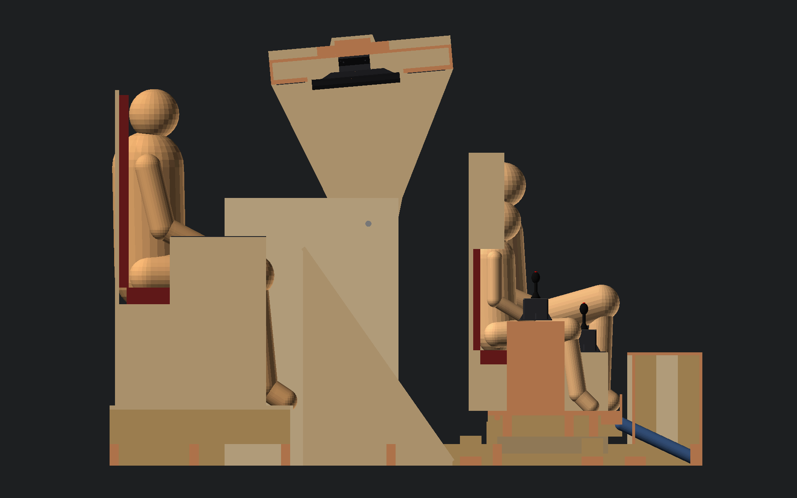
cad/export/png/overview_side_boarding.png
