whyvas/filament-falcon/cad/export/png/overview_side_flight.png

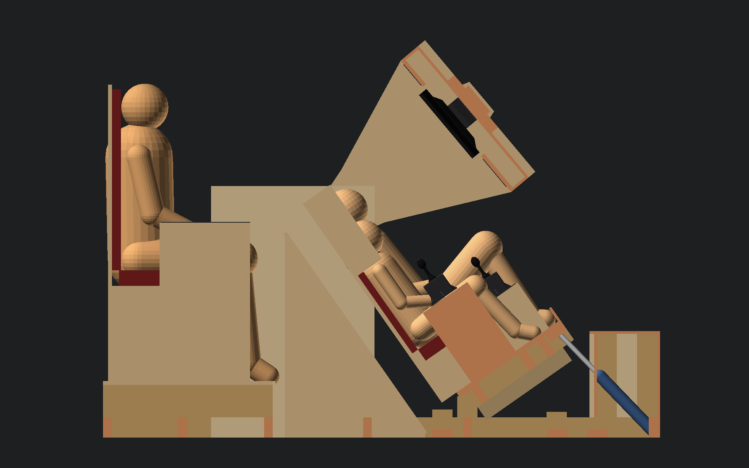
cad/export/png/overview_side_flight.png
