whyvas/filament-falcon/cad/export/png/overview_side_reclined.png

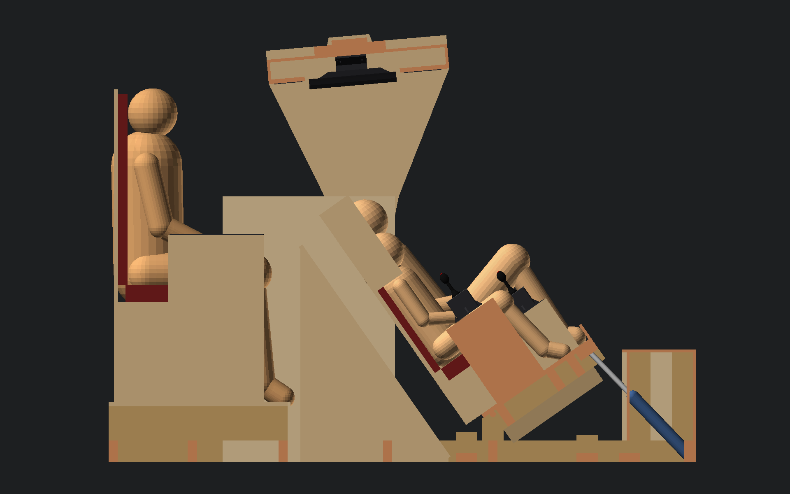
cad/export/png/overview_side_reclined.png
