whyvas/filament-falcon/cad/export/png/panels/CMD_A_back.png

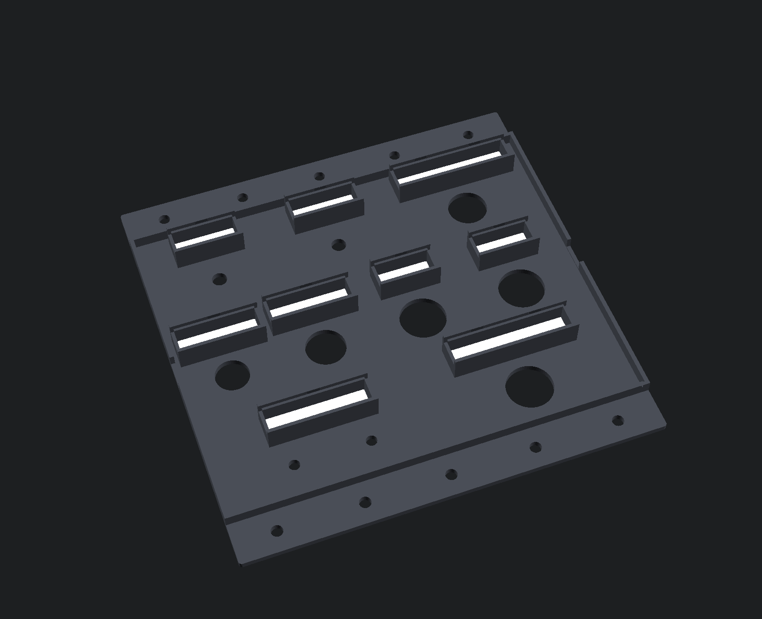
cad/export/png/panels/CMD_A_back.png
