whyvas/filament-falcon/cad/export/png/panels/CMD_A_front.png

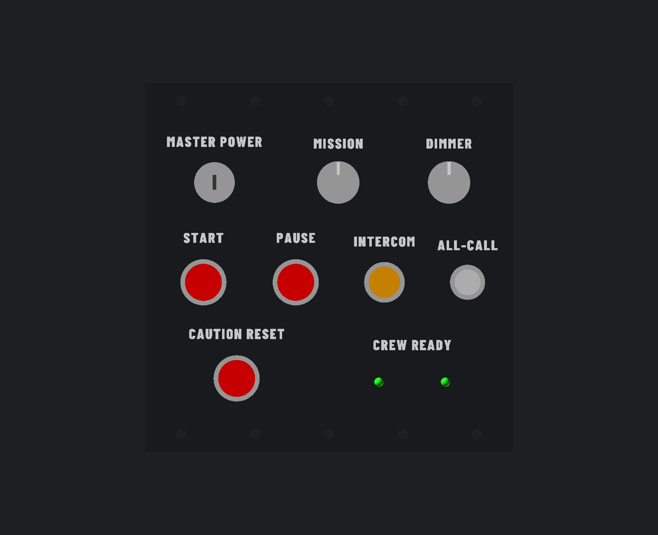
cad/export/png/panels/CMD_A_front.png
