whyvas/filament-falcon/cad/export/png/panels/CMD_B_back.png

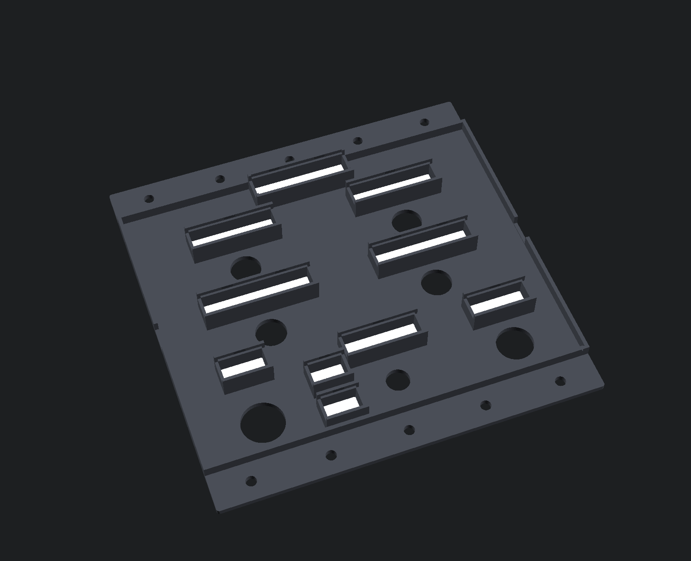
cad/export/png/panels/CMD_B_back.png
