whyvas/filament-falcon/cad/export/png/panels/CMD_B_front.png

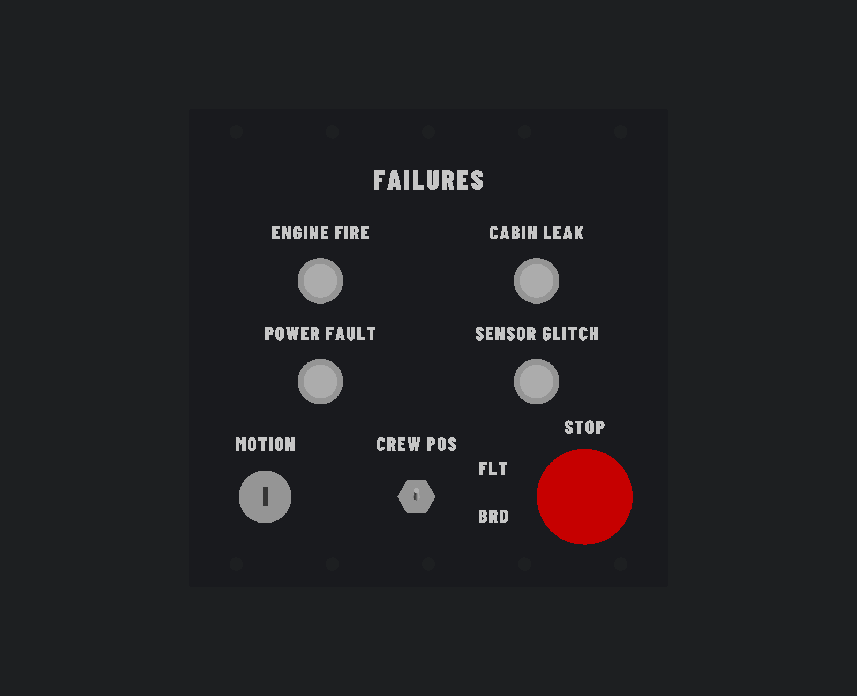
cad/export/png/panels/CMD_B_front.png
