whyvas/filament-falcon/cad/export/png/panels/OPS_DASH_A_back.png

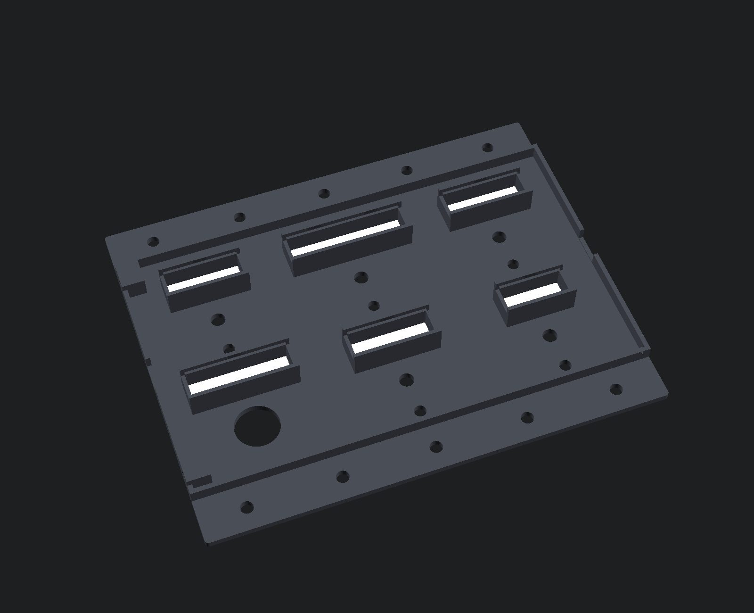
cad/export/png/panels/OPS_DASH_A_back.png
