whyvas/filament-falcon/cad/export/png/panels/OPS_DASH_A_front.png

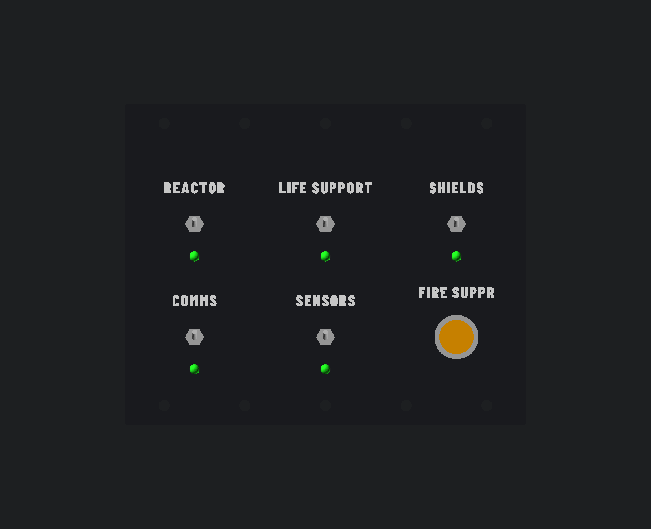
cad/export/png/panels/OPS_DASH_A_front.png
