whyvas/filament-falcon/cad/export/png/panels/OPS_SIDE_back.png

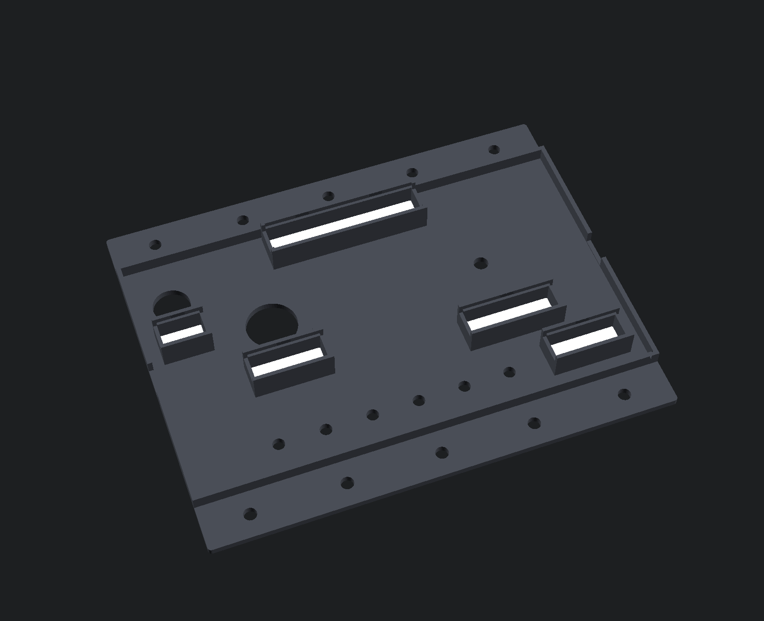
cad/export/png/panels/OPS_SIDE_back.png
