whyvas/filament-falcon/cad/export/png/panels/OPS_SIDE_front.png

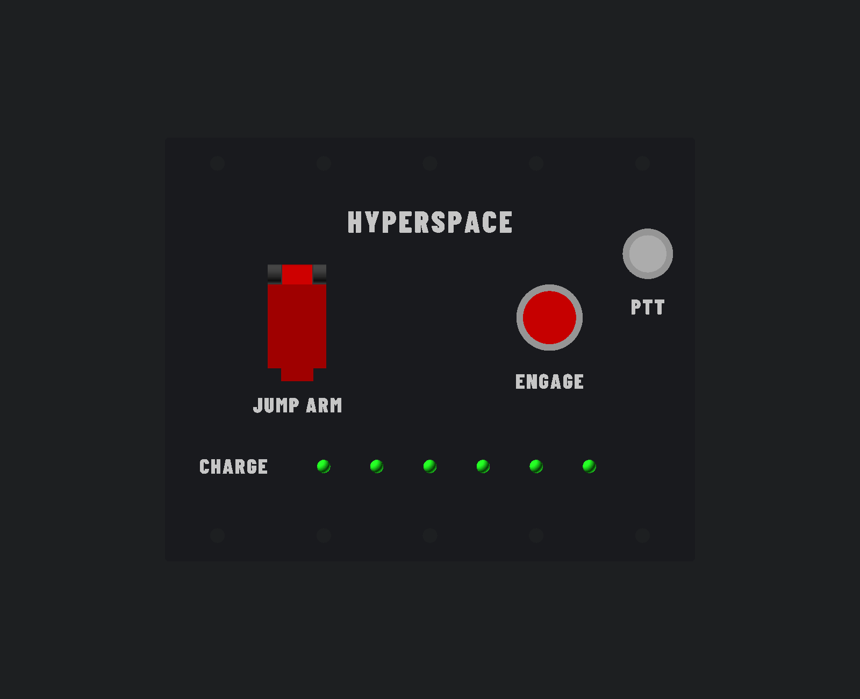
cad/export/png/panels/OPS_SIDE_front.png
