whyvas/filament-falcon/cad/export/png/panels/OVERHEAD_A_back.png

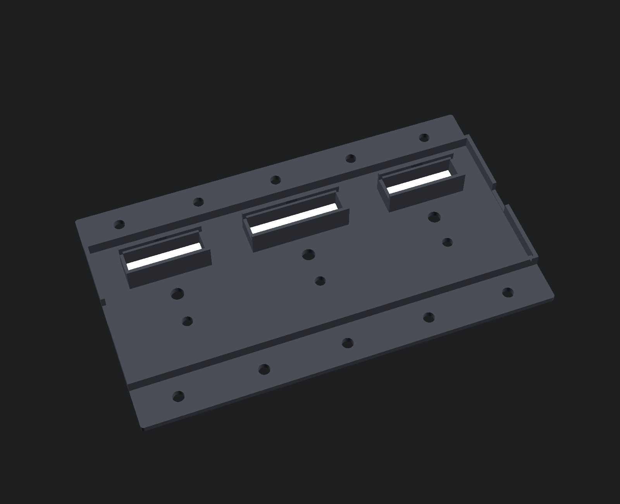
cad/export/png/panels/OVERHEAD_A_back.png
