whyvas/filament-falcon/cad/export/png/panels/OVERHEAD_A_front.png

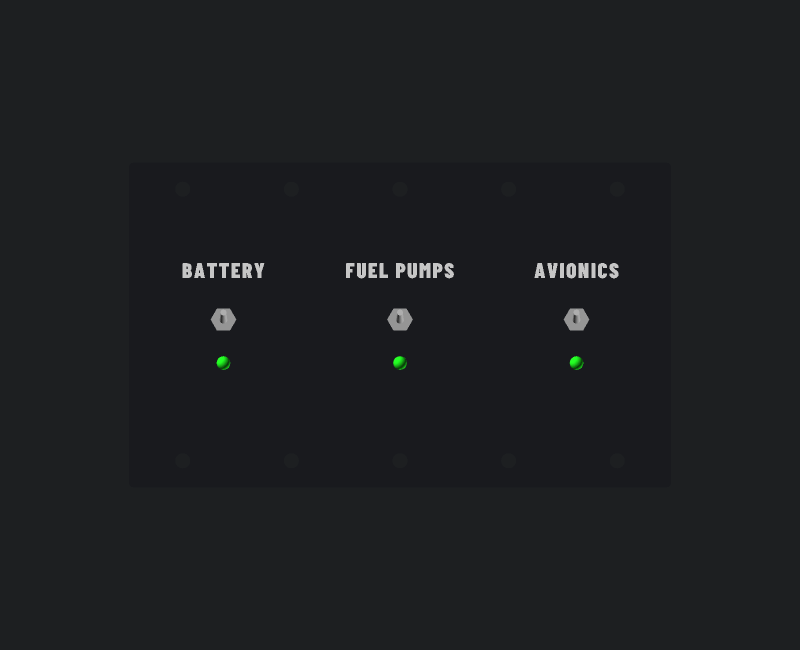
cad/export/png/panels/OVERHEAD_A_front.png
