whyvas/filament-falcon/cad/export/png/panels/OVERHEAD_C_front.png

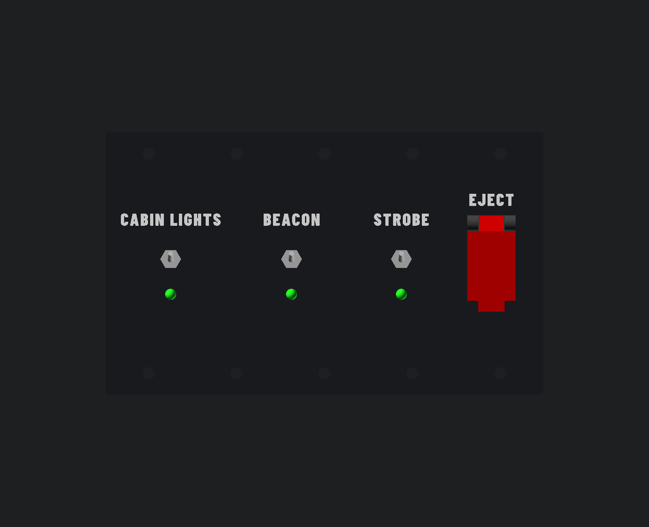
cad/export/png/panels/OVERHEAD_C_front.png
