whyvas/filament-falcon/cad/export/png/panels/PILOT_DASH_B_back.png

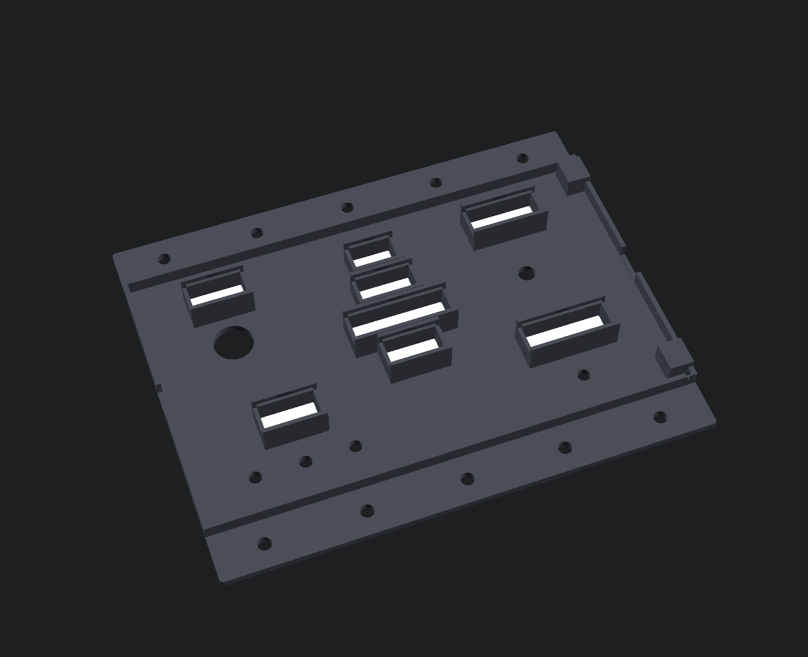
cad/export/png/panels/PILOT_DASH_B_back.png
