whyvas/filament-falcon/cad/export/png/panels/PILOT_DASH_B_front.png

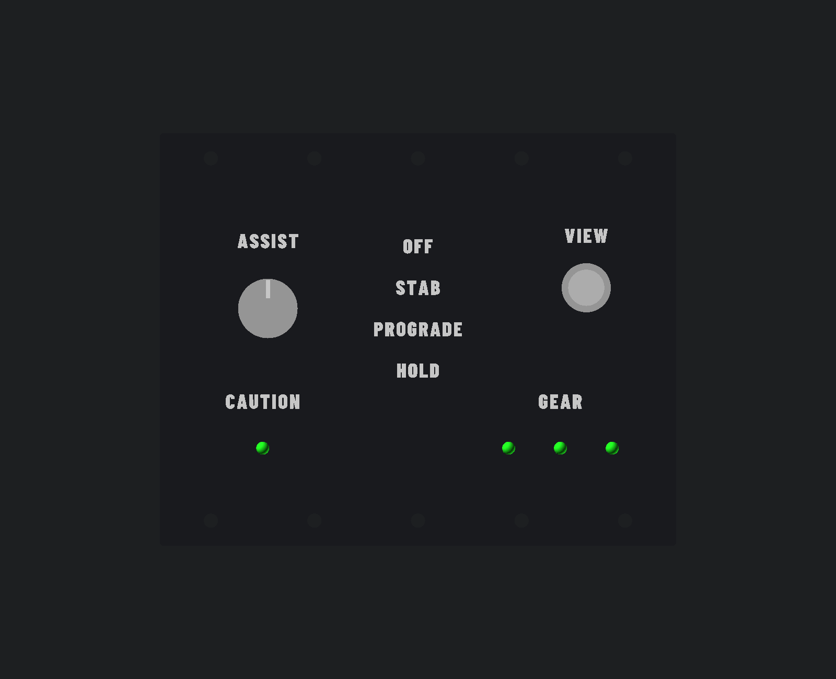
cad/export/png/panels/PILOT_DASH_B_front.png
