whyvas/filament-falcon/cad/export/png/panels/PILOT_SIDE_front.png

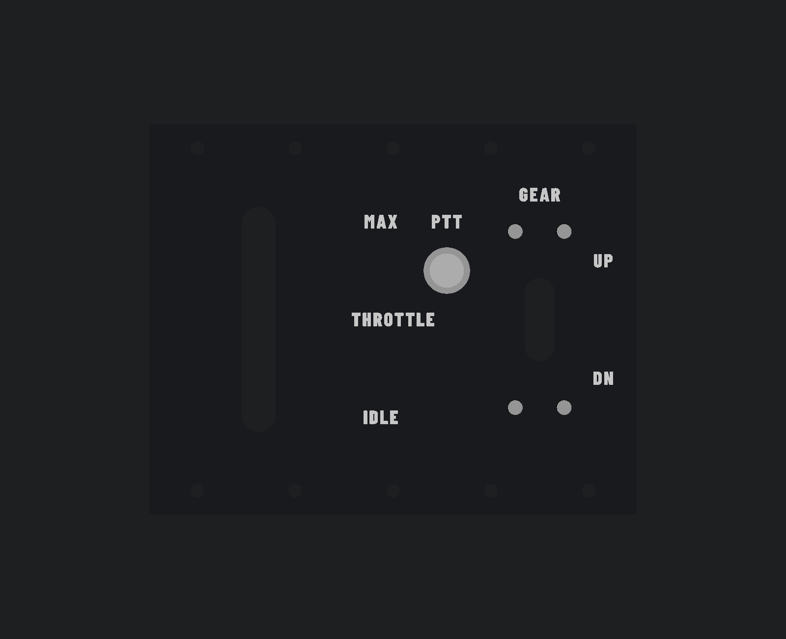
cad/export/png/panels/PILOT_SIDE_front.png
