whyvas/filament-falcon/docs/electronics/01_simple_joystick.png

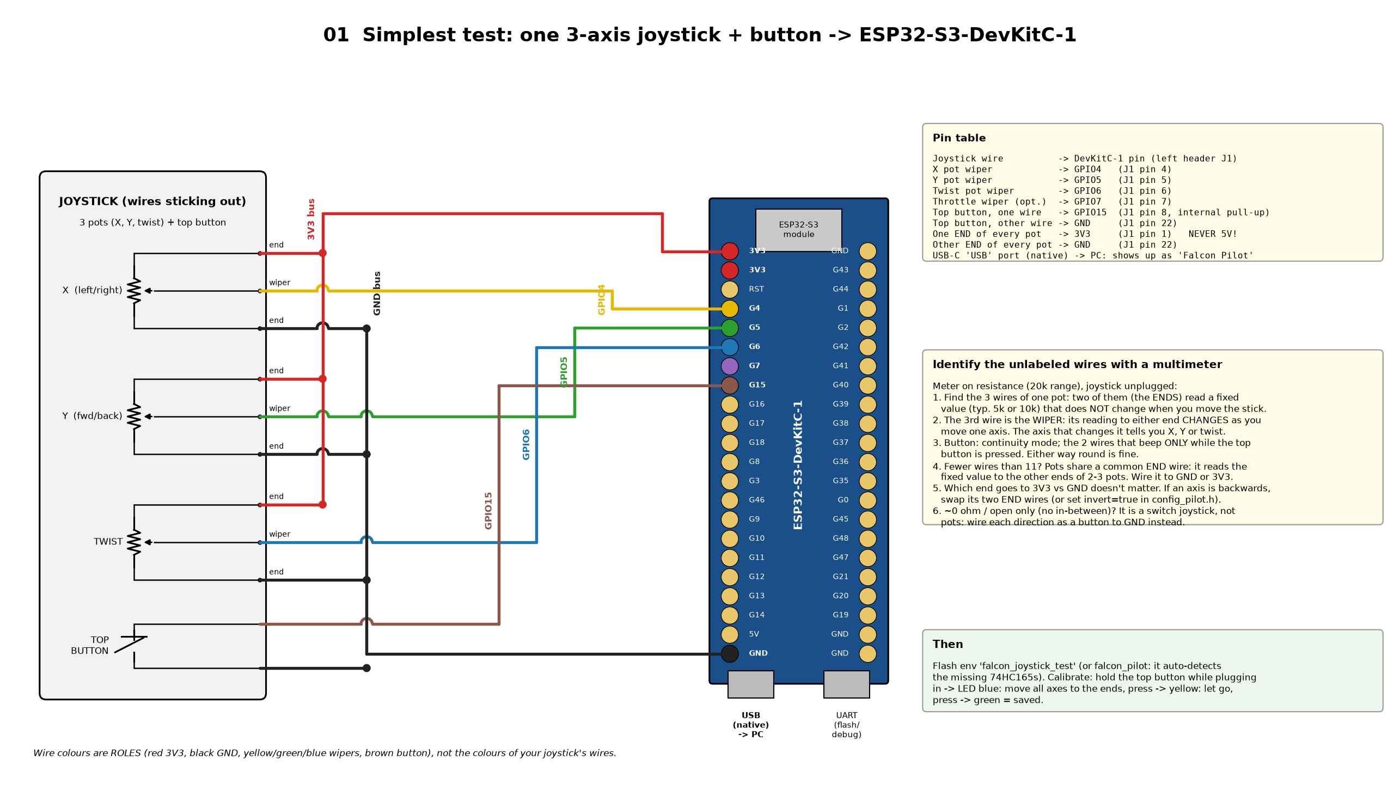
docs/electronics/01_simple_joystick.png
