whyvas/filament-falcon/docs/game/screenshots/01_launch_pad_chase.jpg

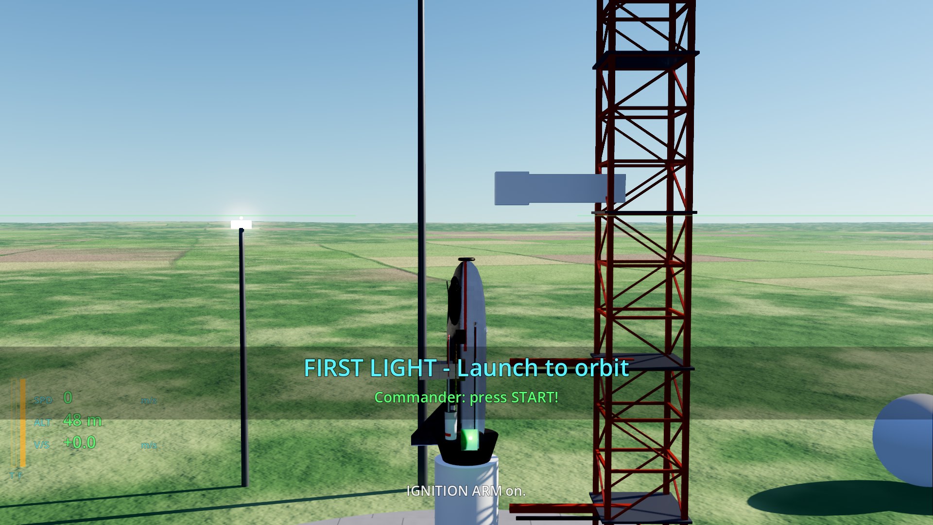
docs/game/screenshots/01_launch_pad_chase.jpg
