whyvas/filament-falcon/docs/game/screenshots/02_cockpit_tiled_briefing.jpg

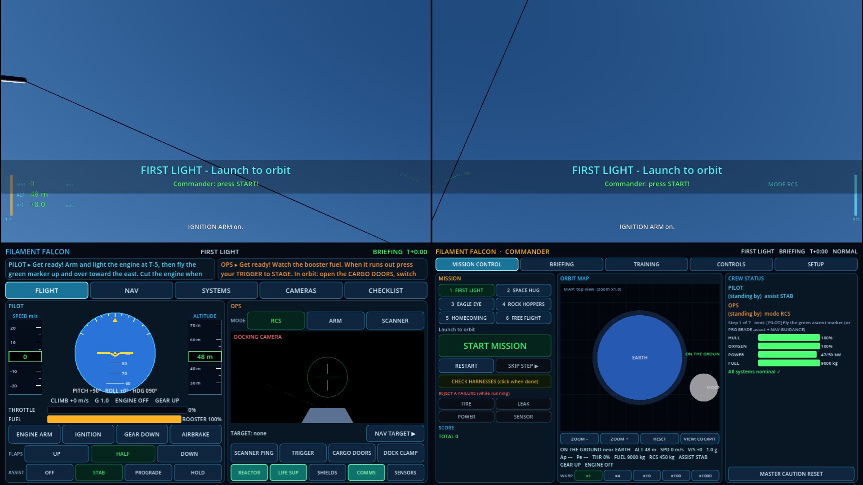
docs/game/screenshots/02_cockpit_tiled_briefing.jpg
