whyvas/filament-falcon/docs/game/screenshots/03_launch_ascent_chase.jpg

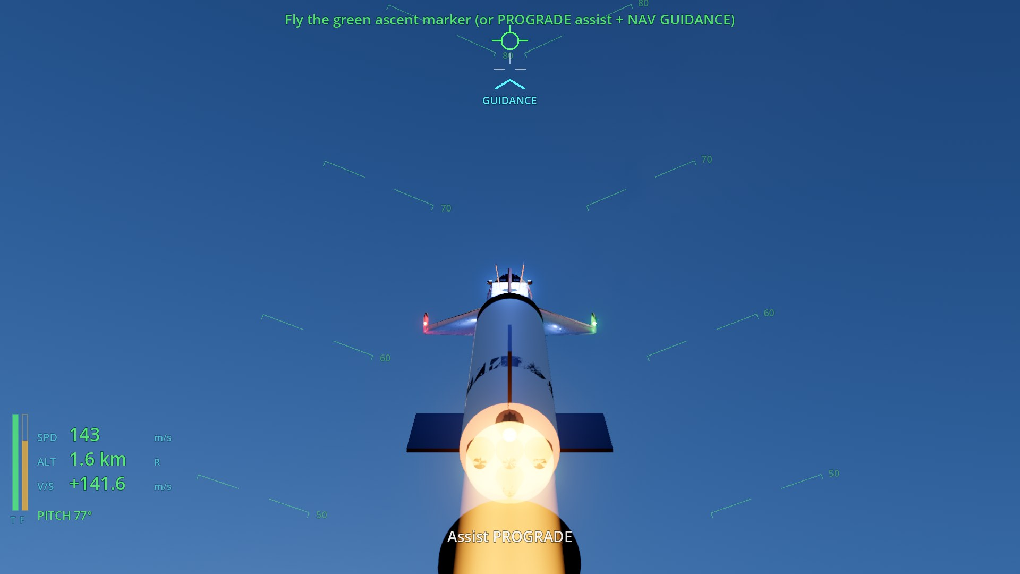
docs/game/screenshots/03_launch_ascent_chase.jpg
