whyvas/filament-falcon/docs/game/screenshots/04_launch_ascent_cockpit.jpg

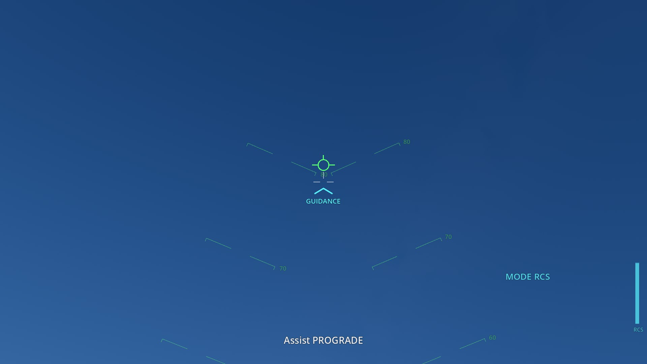
docs/game/screenshots/04_launch_ascent_cockpit.jpg
