whyvas/filament-falcon/docs/game/screenshots/05_orbit_station_tiled.jpg

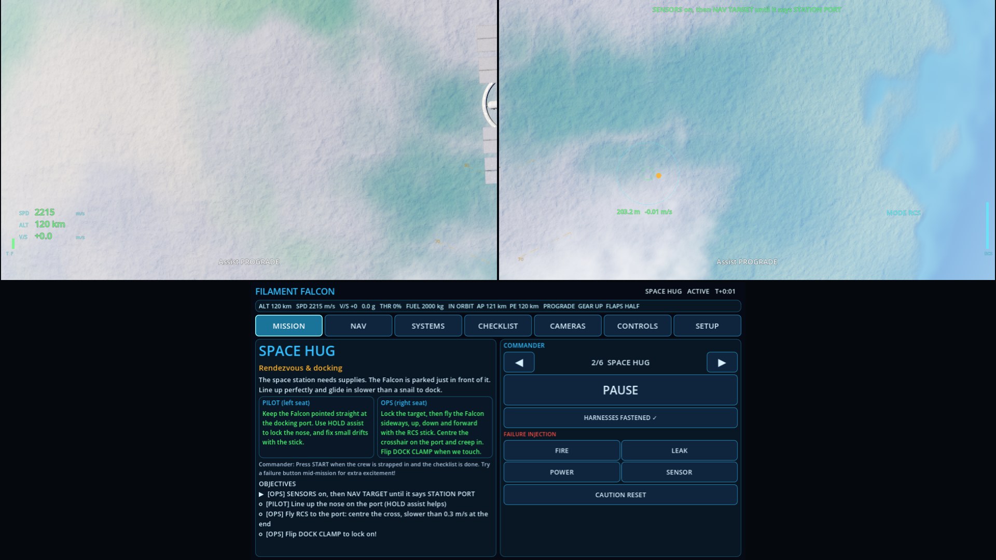
docs/game/screenshots/05_orbit_station_tiled.jpg
