whyvas/filament-falcon/docs/game/screenshots/06_orbit_station_left.jpg

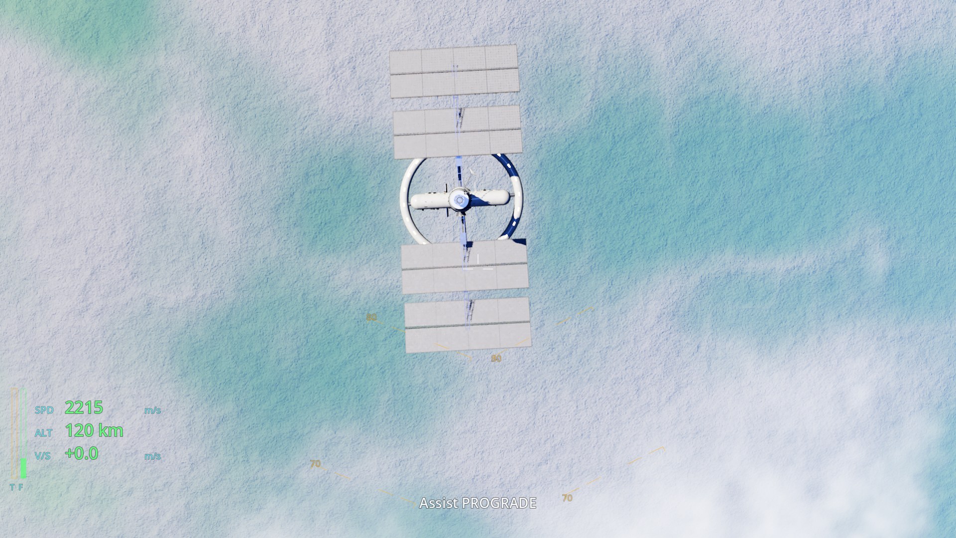
docs/game/screenshots/06_orbit_station_left.jpg
