whyvas/filament-falcon/docs/game/screenshots/09_lunar_descent.jpg

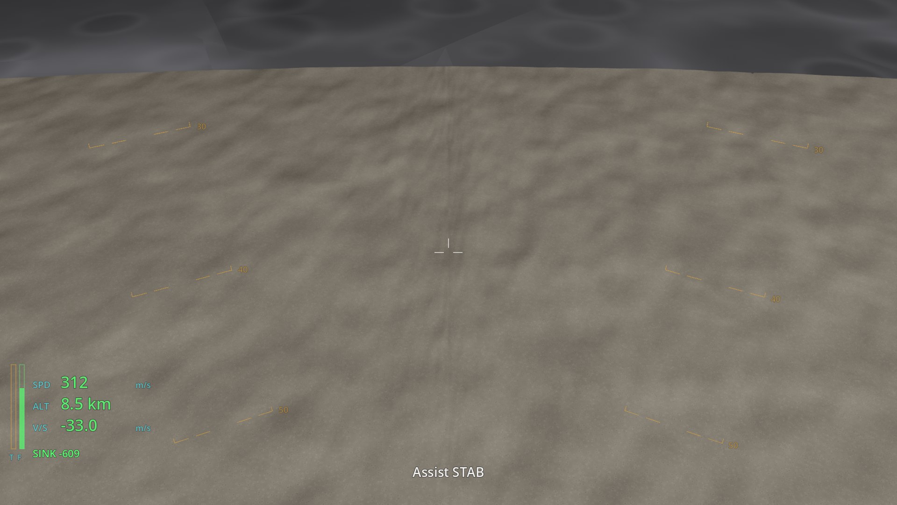
docs/game/screenshots/09_lunar_descent.jpg
