whyvas/filament-falcon/docs/game/screenshots/10_lunar_chase.jpg

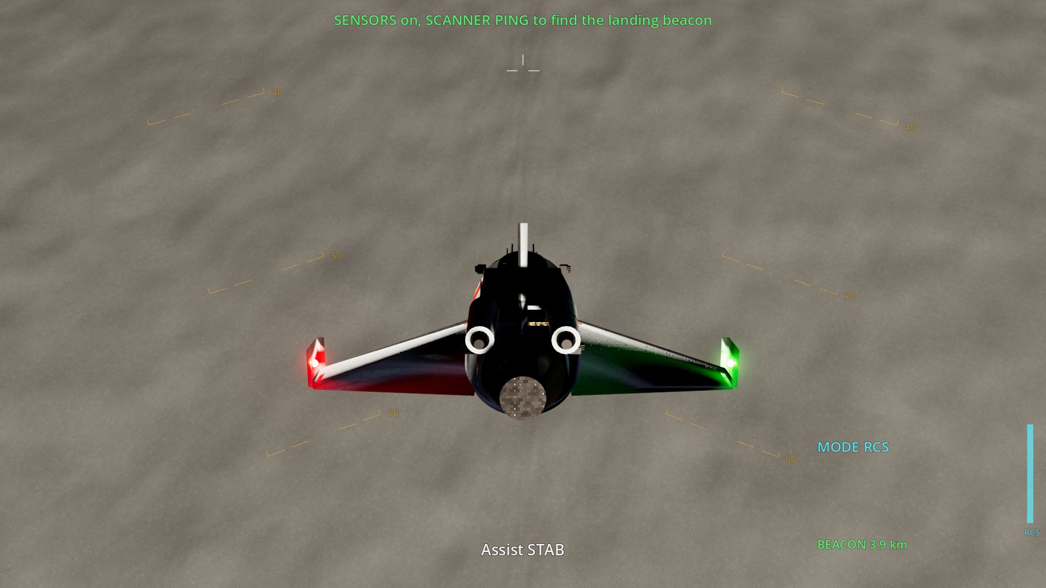
docs/game/screenshots/10_lunar_chase.jpg
