whyvas/filament-falcon/docs/game/screenshots/13_reentry_plasma_chase.jpg

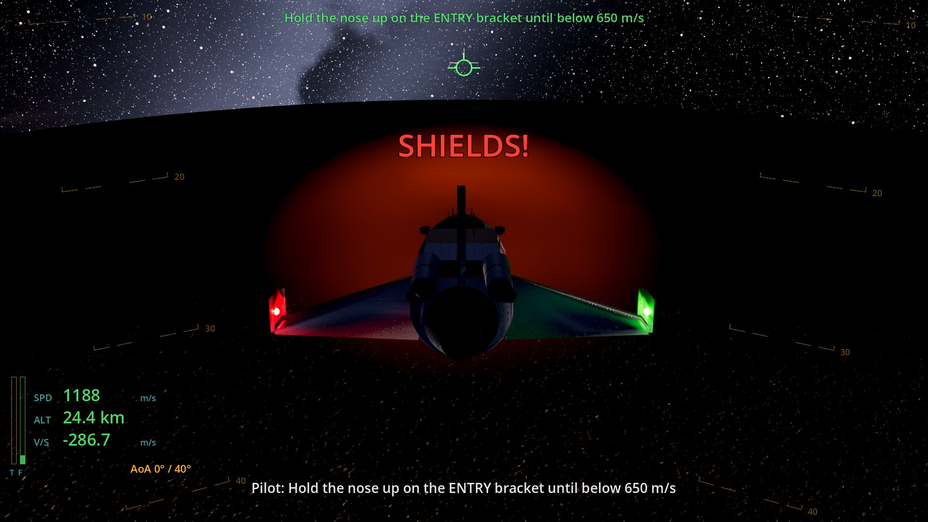
docs/game/screenshots/13_reentry_plasma_chase.jpg
