whyvas/filament-falcon/docs/game/screenshots/14_reentry_plasma_cockpit.jpg

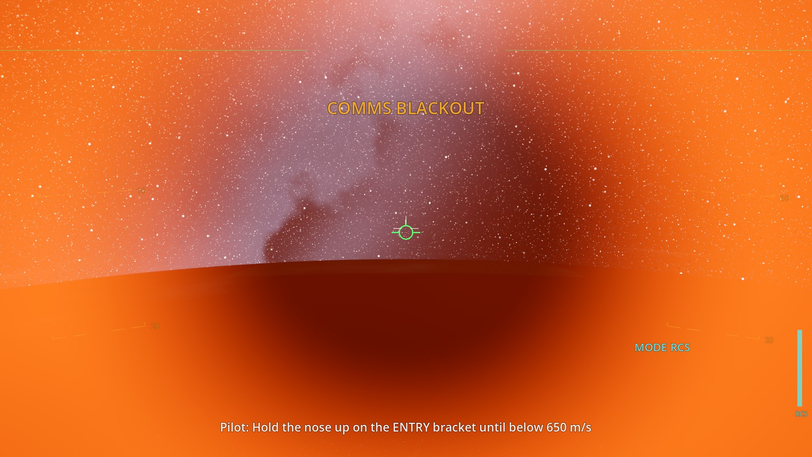
docs/game/screenshots/14_reentry_plasma_cockpit.jpg
