whyvas/filament-falcon/docs/game/screenshots/15_runway_approach.jpg

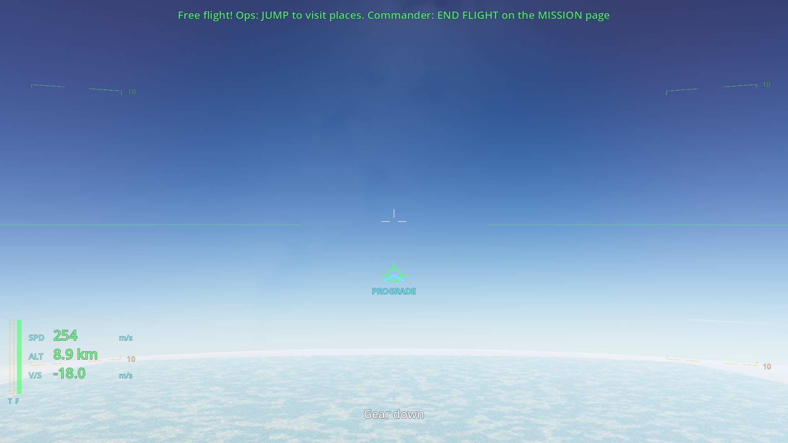
docs/game/screenshots/15_runway_approach.jpg
