whyvas/filament-falcon/docs/game/screenshots/16_runway_chase.jpg

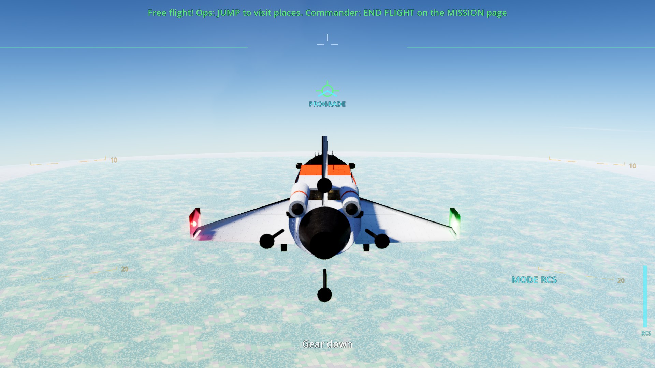
docs/game/screenshots/16_runway_chase.jpg
