whyvas/filament-falcon/docs/game/screenshots/17_mission_complete.jpg

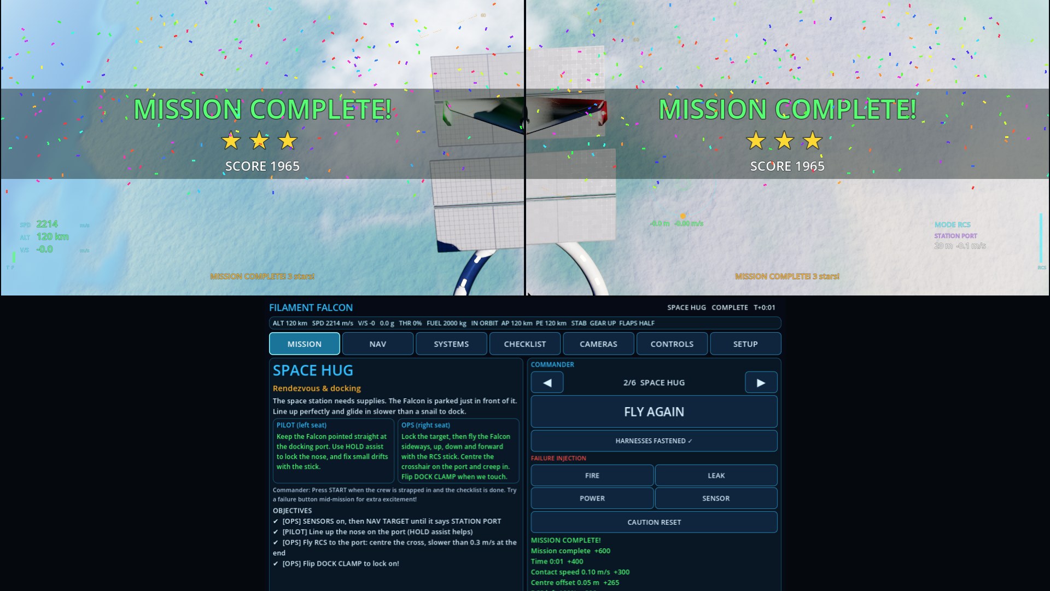
docs/game/screenshots/17_mission_complete.jpg
