whyvas/filament-falcon/docs/game/screenshots/18_console_flight.jpg

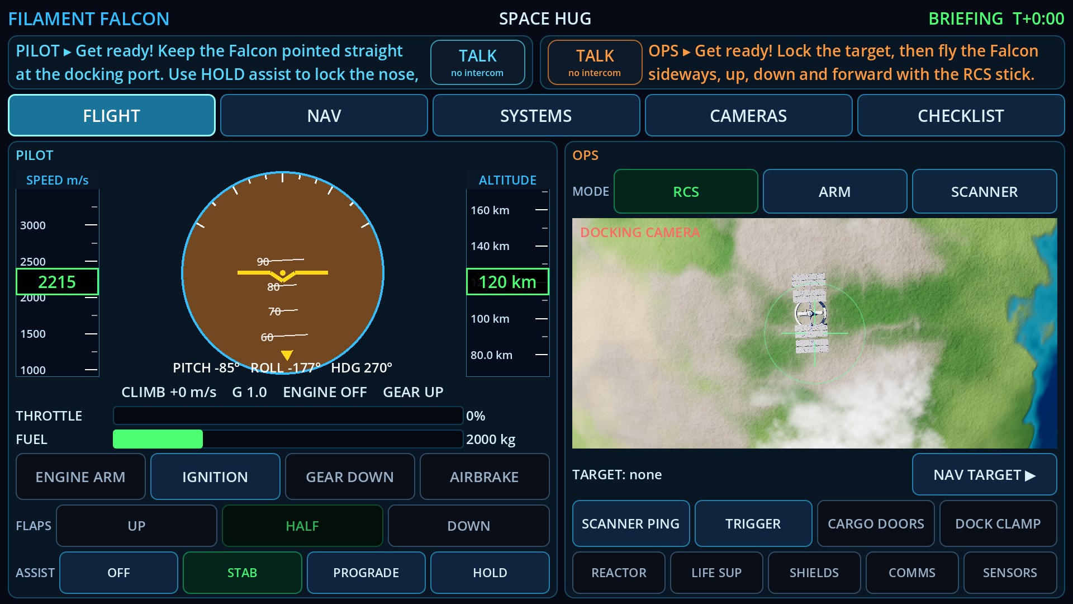
docs/game/screenshots/18_console_flight.jpg
