whyvas/filament-falcon/docs/game/screenshots/19_console_nav.jpg

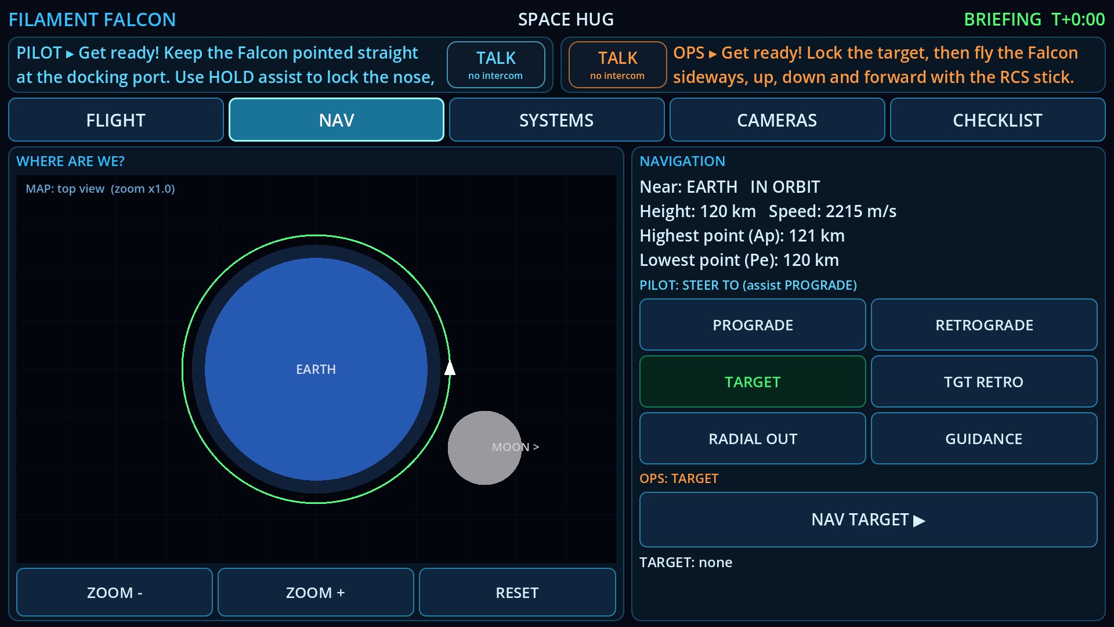
docs/game/screenshots/19_console_nav.jpg
