whyvas/filament-falcon/docs/game/screenshots/20_console_systems.jpg

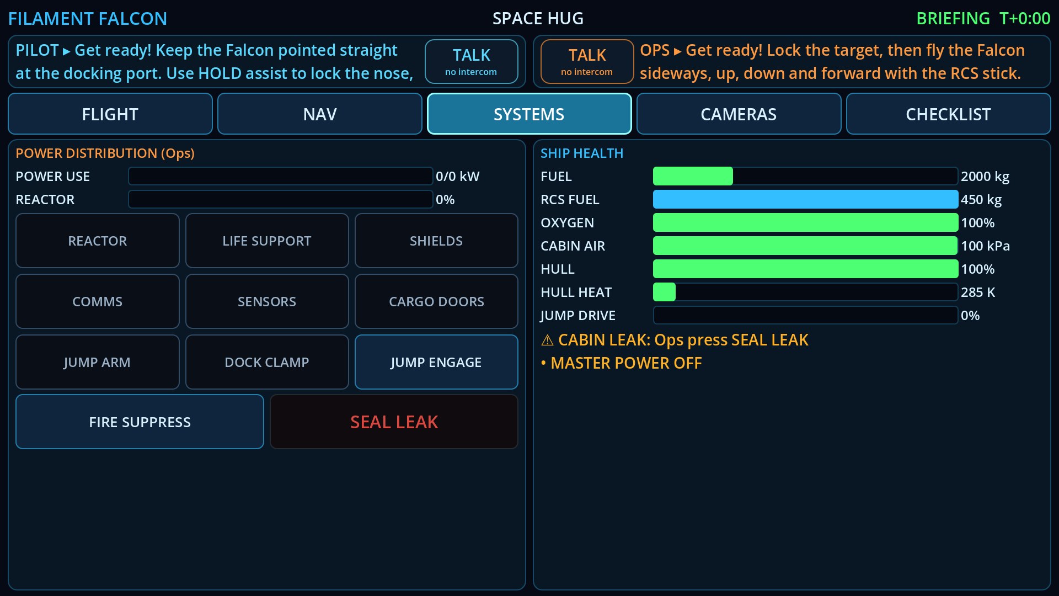
docs/game/screenshots/20_console_systems.jpg
