whyvas/filament-falcon/docs/game/screenshots/21_console_cameras.jpg

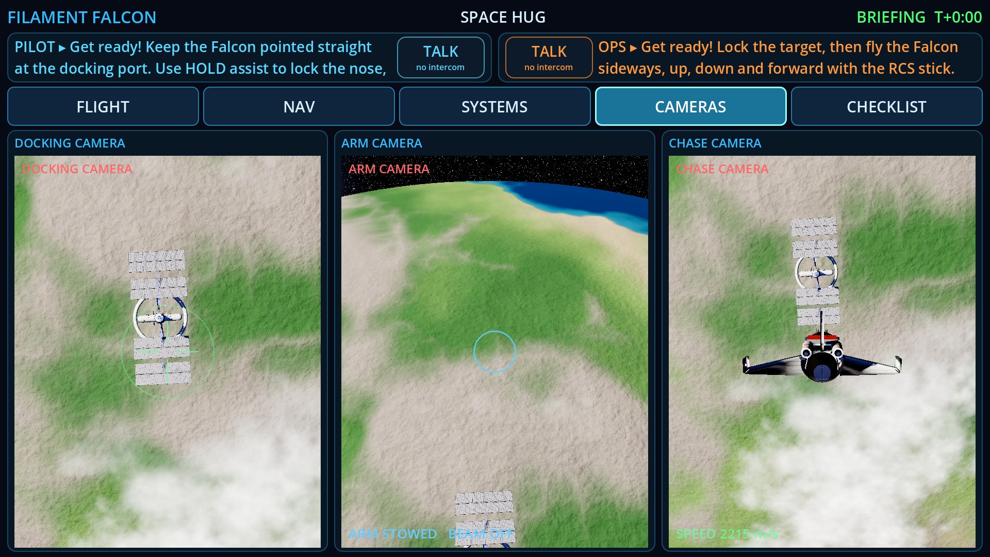
docs/game/screenshots/21_console_cameras.jpg
