whyvas/filament-falcon/docs/game/screenshots/22_console_checklist.jpg

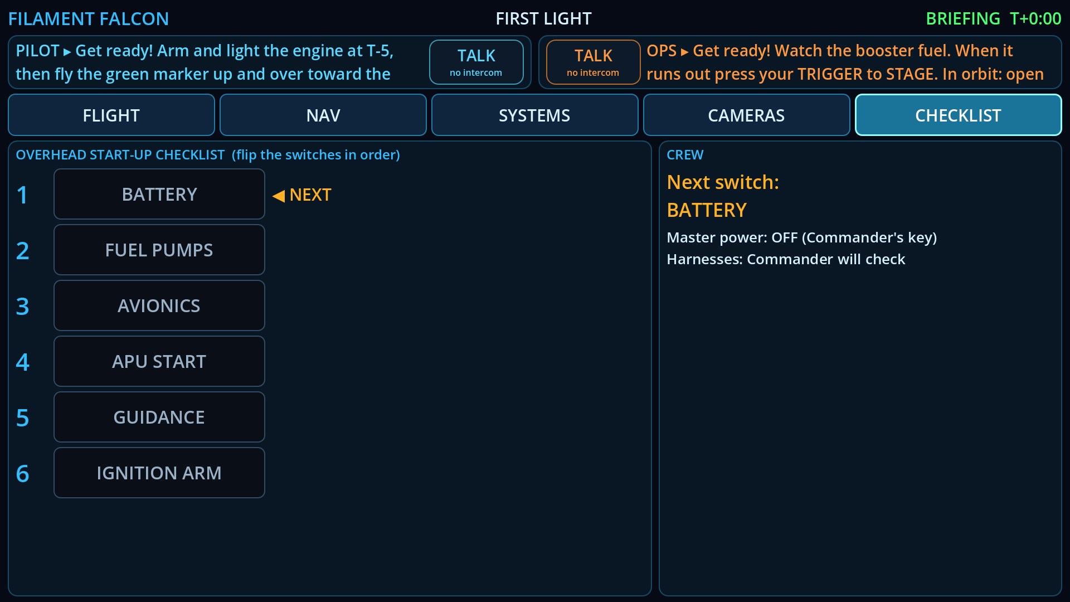
docs/game/screenshots/22_console_checklist.jpg
