whyvas/filament-falcon/docs/game/screenshots/23_commander_mission_control.jpg

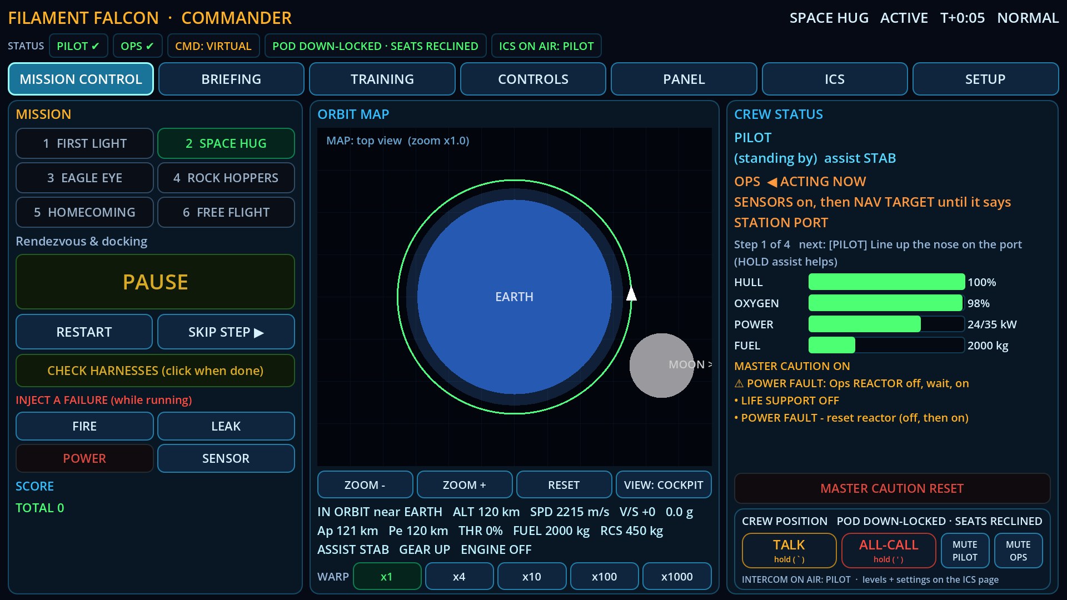
docs/game/screenshots/23_commander_mission_control.jpg
