whyvas/filament-falcon/docs/game/screenshots/24_commander_briefing.jpg

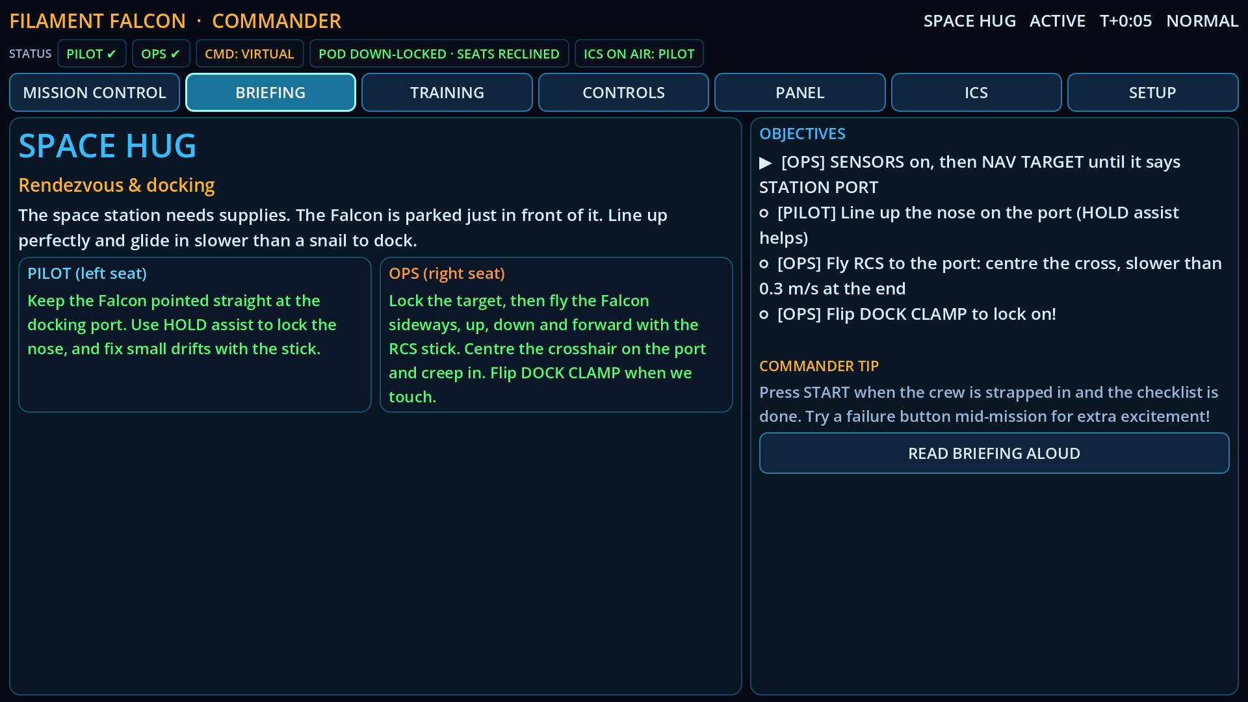
docs/game/screenshots/24_commander_briefing.jpg
