whyvas/filament-falcon/docs/game/screenshots/25_commander_training.jpg

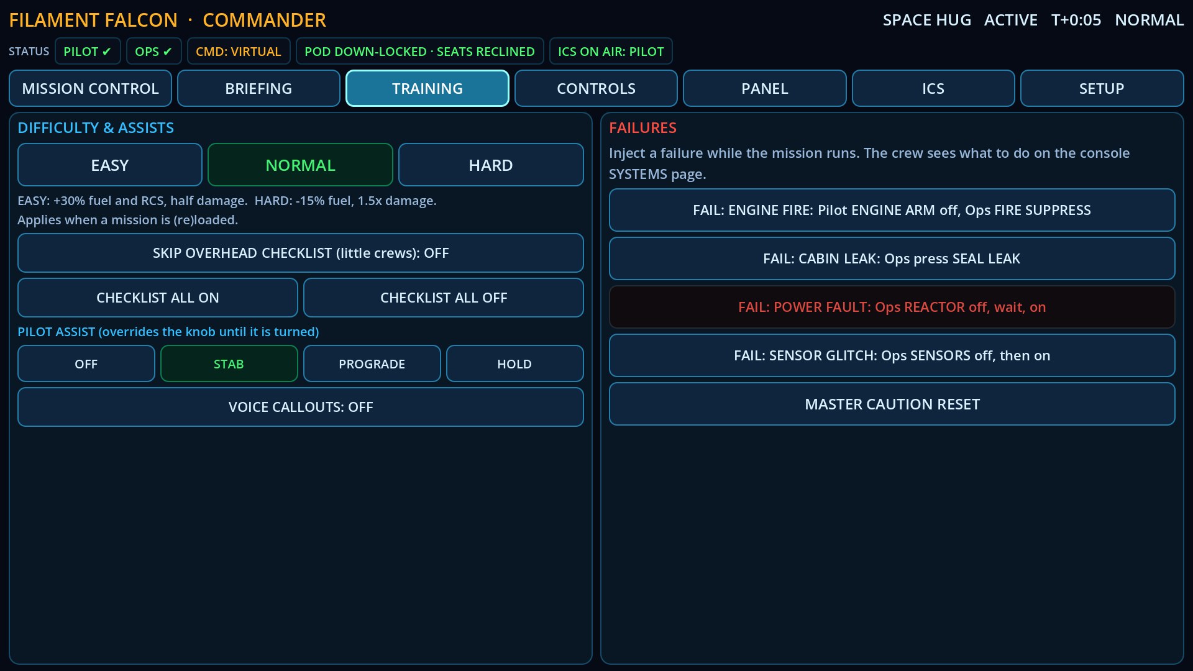
docs/game/screenshots/25_commander_training.jpg
