whyvas/filament-falcon/docs/game/screenshots/26_commander_controls.jpg

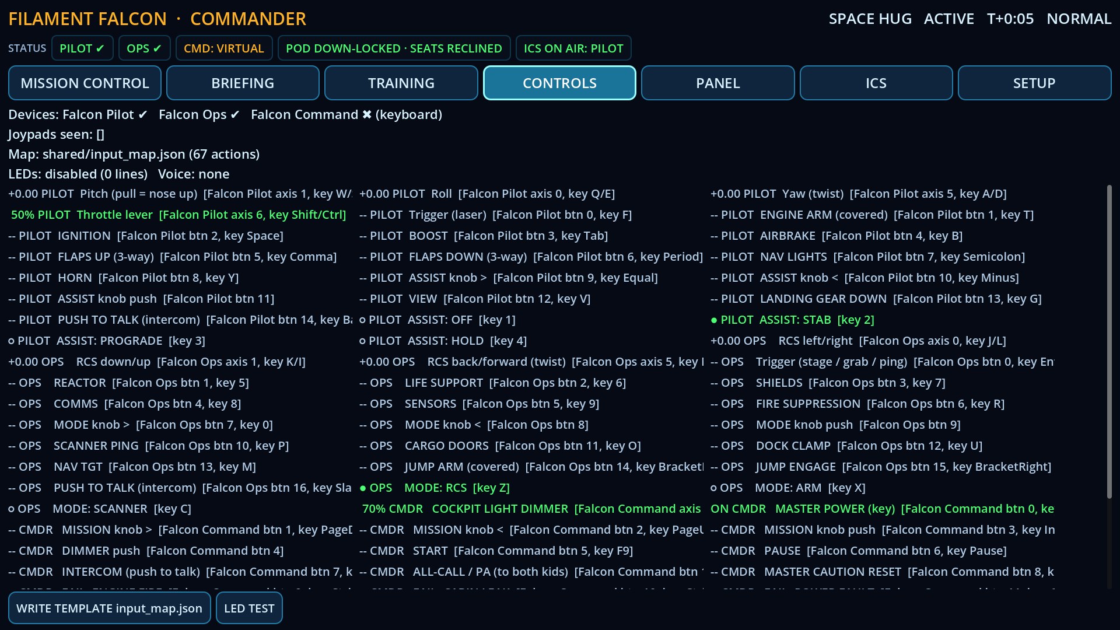
docs/game/screenshots/26_commander_controls.jpg
