whyvas/filament-falcon/docs/game/screenshots/28_console_commander_tab.jpg

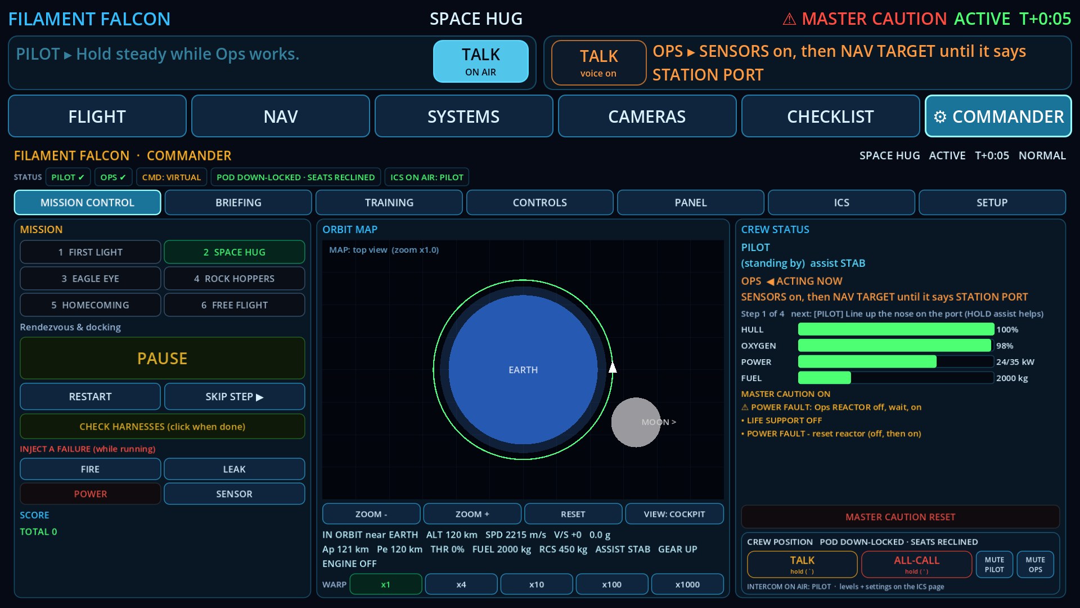
docs/game/screenshots/28_console_commander_tab.jpg
