whyvas/filament-falcon/docs/game/screenshots/29_console_virtual_panels.jpg

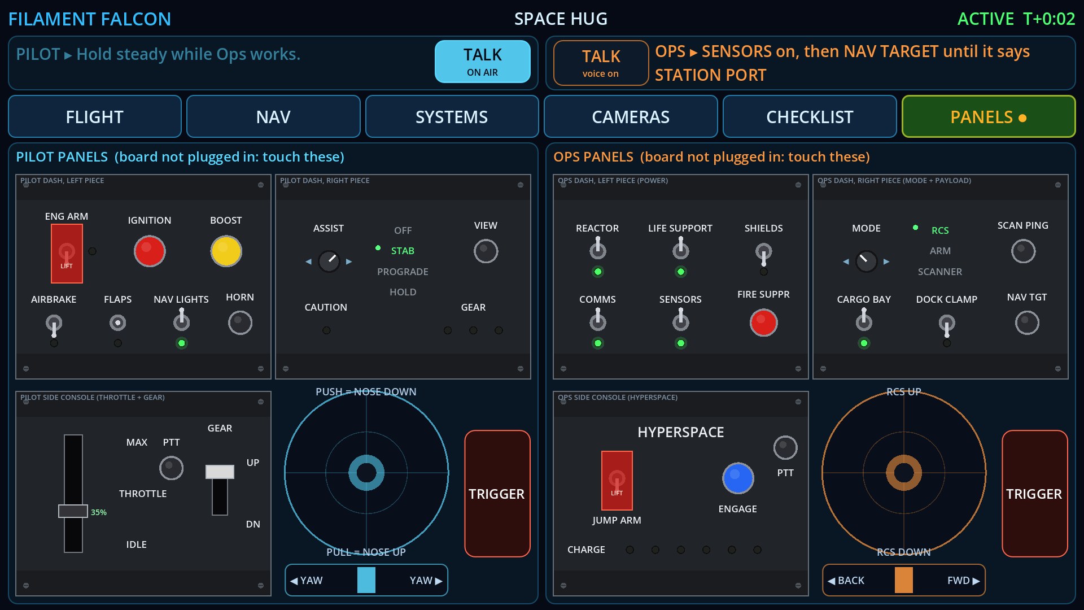
docs/game/screenshots/29_console_virtual_panels.jpg
