whyvas/filament-falcon/docs/game/screenshots/30_console_checklist_overhead.jpg

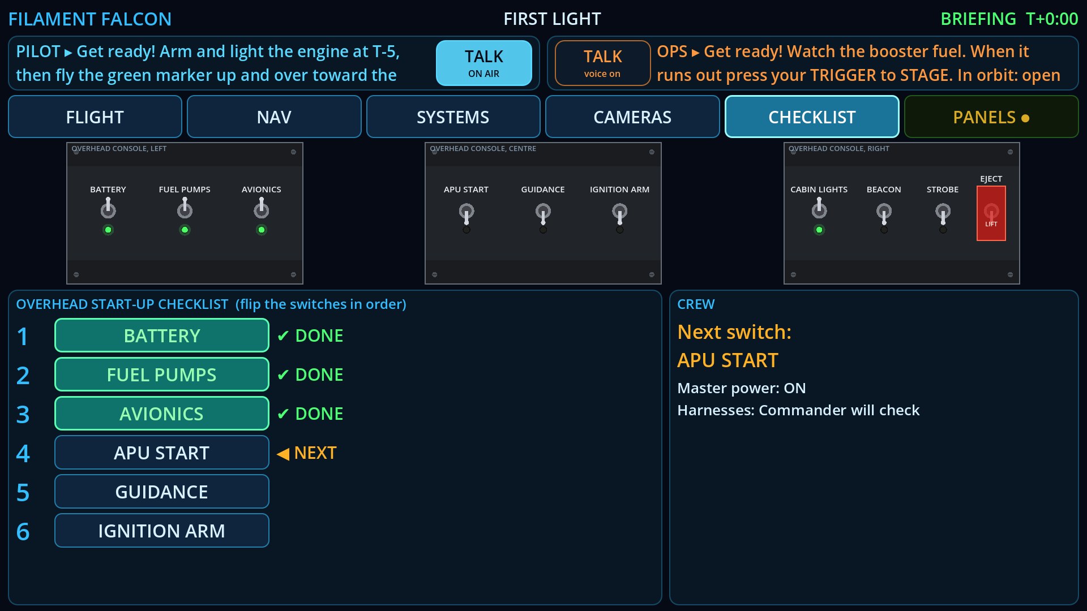
docs/game/screenshots/30_console_checklist_overhead.jpg
