whyvas/filament-falcon/docs/game/screenshots/31_commander_panel.jpg

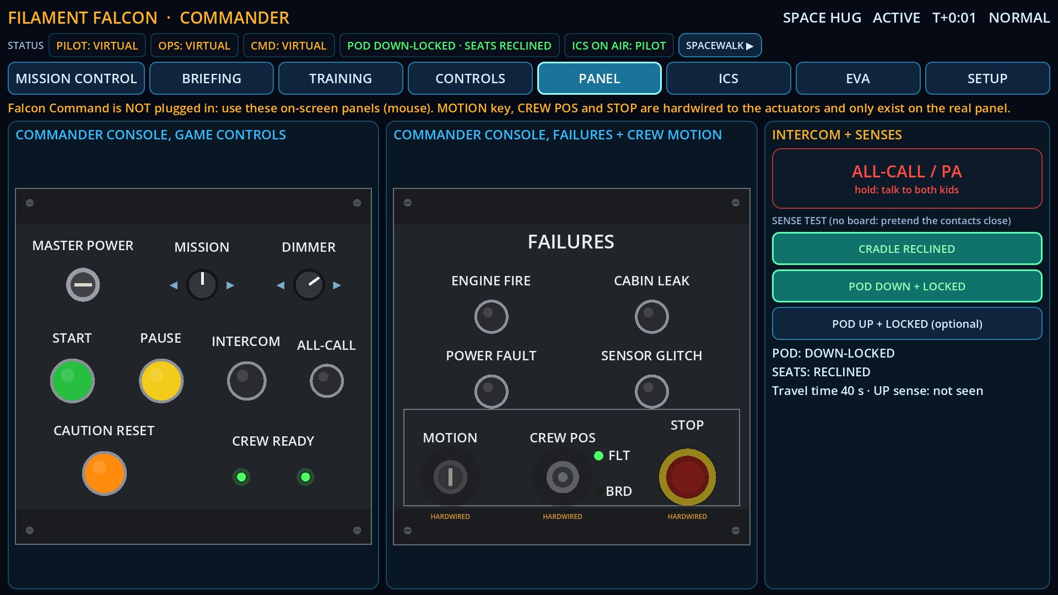
docs/game/screenshots/31_commander_panel.jpg
