whyvas/filament-falcon/docs/game/screenshots/32_commander_ics.jpg

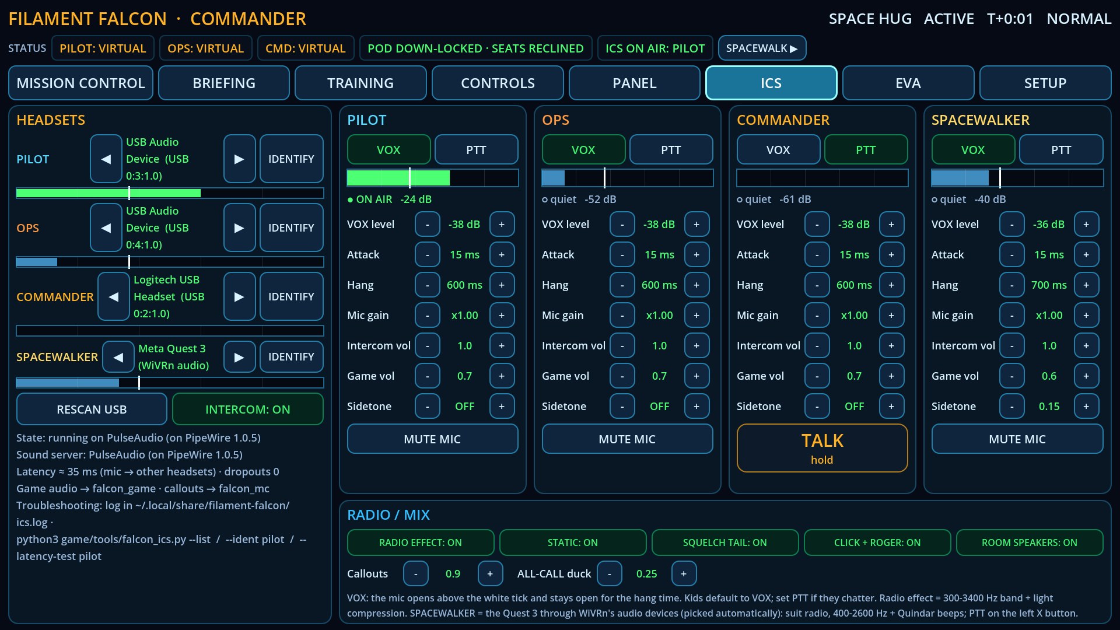
docs/game/screenshots/32_commander_ics.jpg
