whyvas/filament-falcon/docs/game/screenshots/36_console_eva_suit_telemetry.jpg

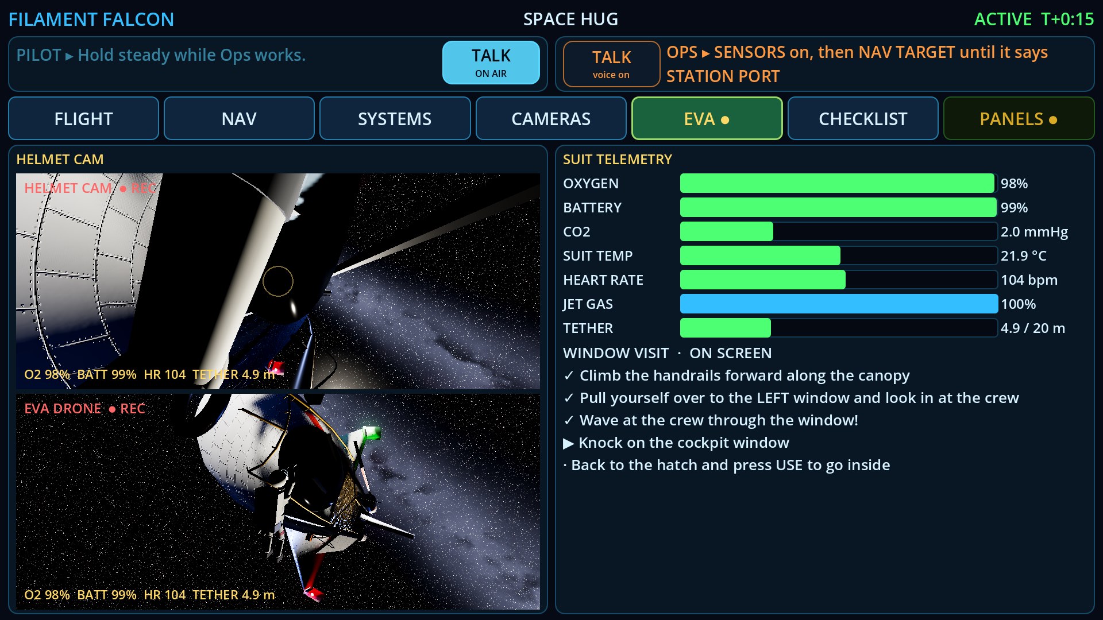
docs/game/screenshots/36_console_eva_suit_telemetry.jpg
