whyvas/filament-falcon/docs/game/screenshots/37_commander_eva.jpg

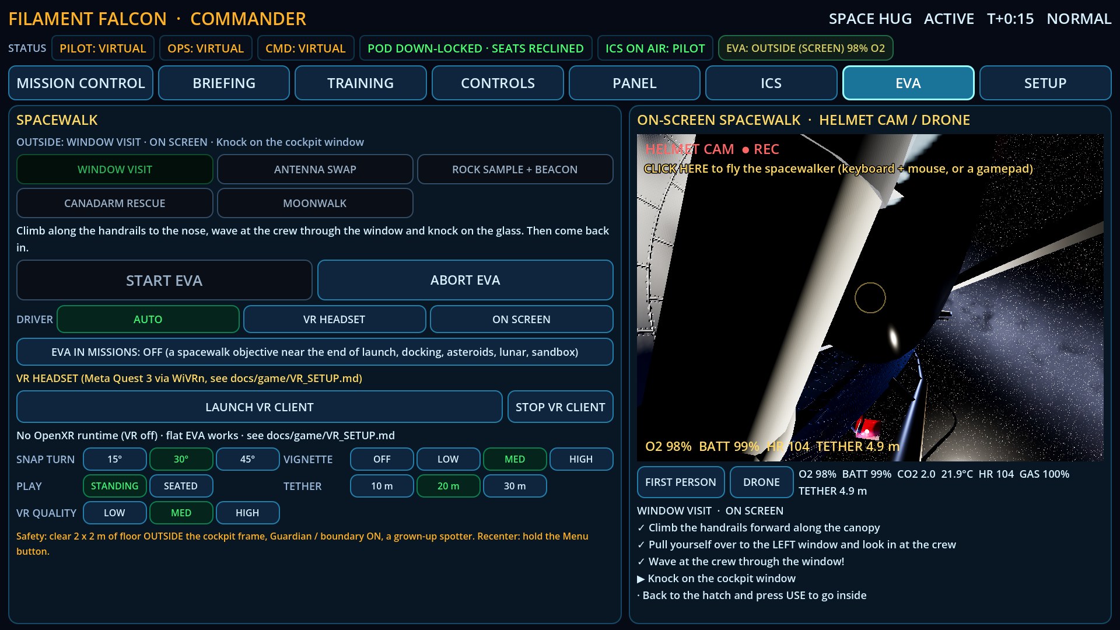
docs/game/screenshots/37_commander_eva.jpg
