whyvas/filament-falcon/docs/game/screenshots/38_eva_astronaut_view_ship_earth.jpg

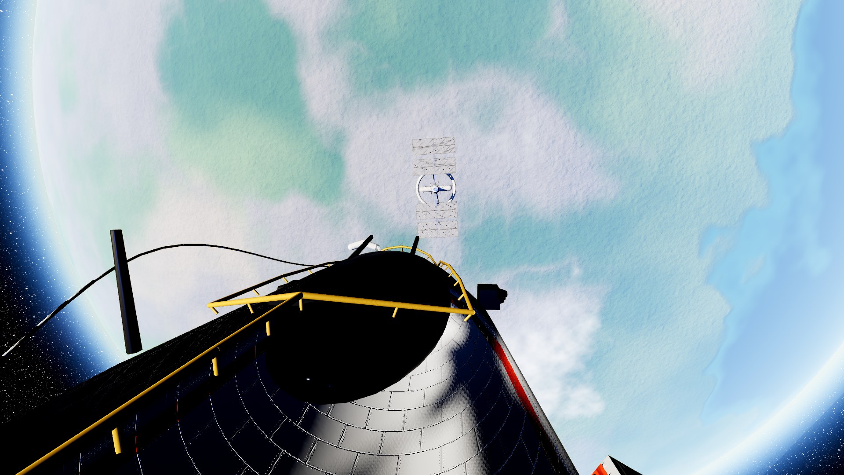
docs/game/screenshots/38_eva_astronaut_view_ship_earth.jpg
