whyvas/filament-falcon/docs/game/screenshots/39_eva_drone_view.jpg

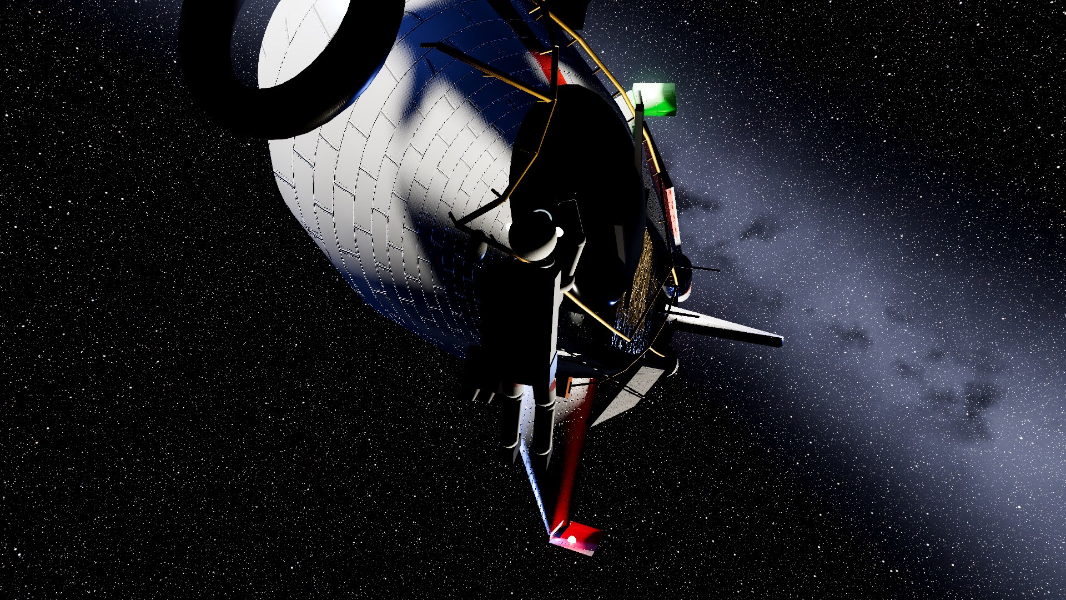
docs/game/screenshots/39_eva_drone_view.jpg
