whyvas/filament-falcon/frame/drawings/01_front_elevation.png

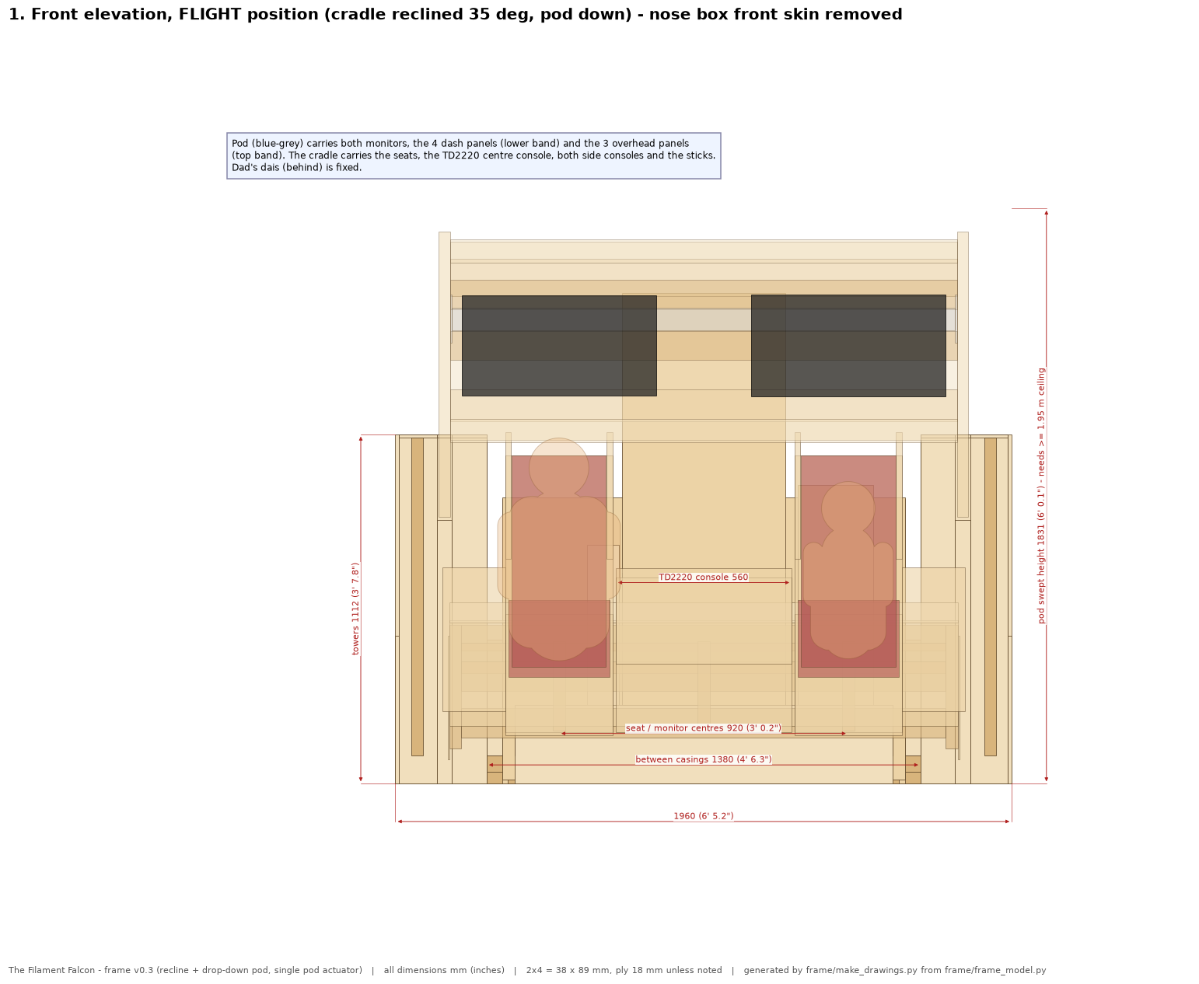
frame/drawings/01_front_elevation.png
