whyvas/filament-falcon/frame/drawings/02_side_motion_geometry.png

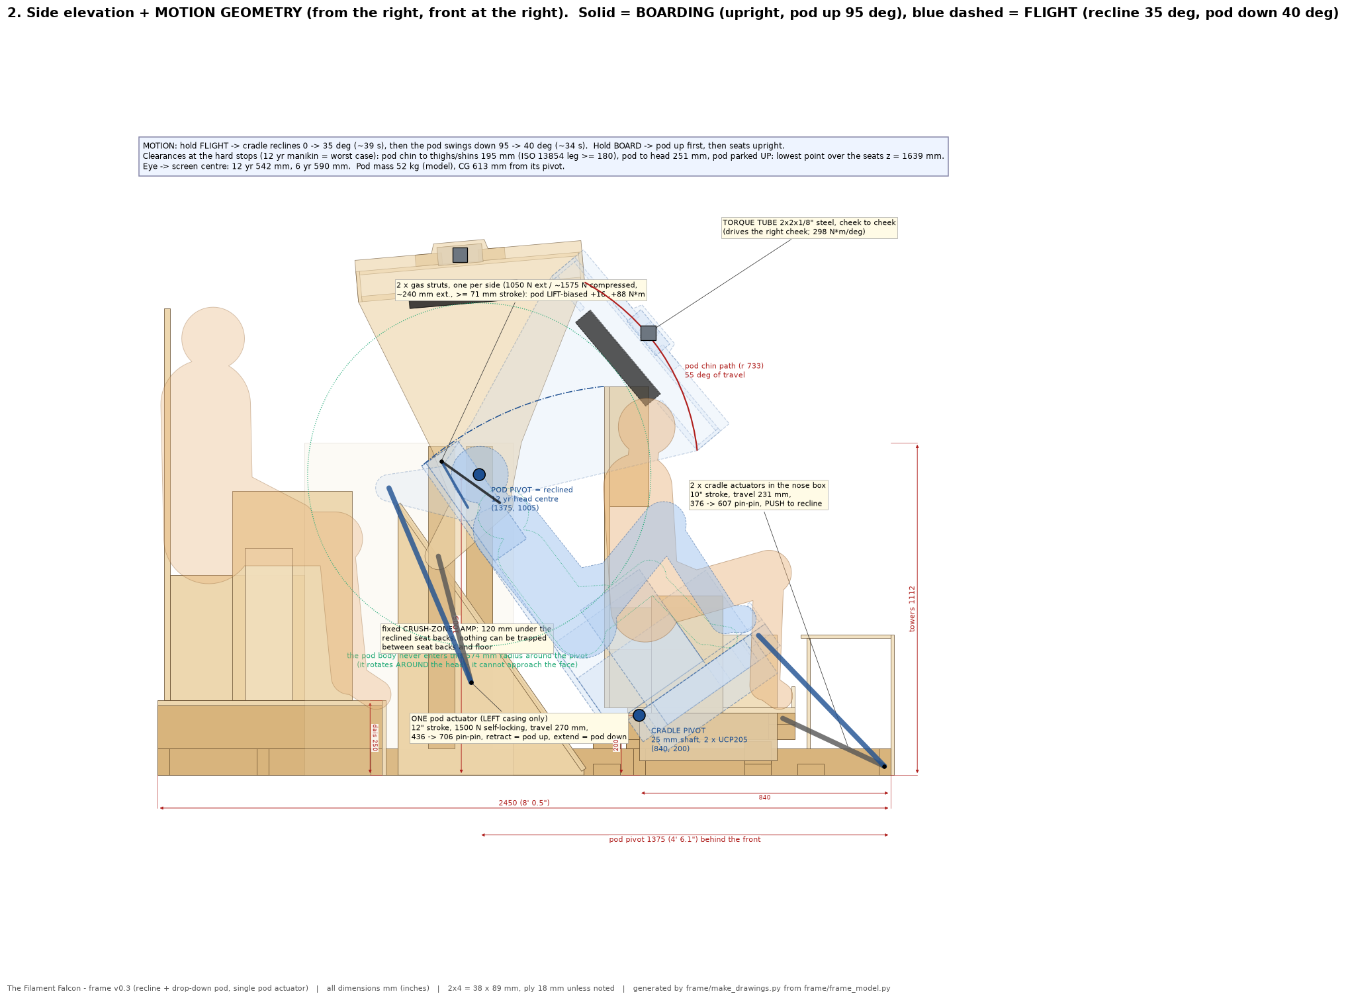
frame/drawings/02_side_motion_geometry.png
