whyvas/filament-falcon/frame/drawings/03_plan_view.png

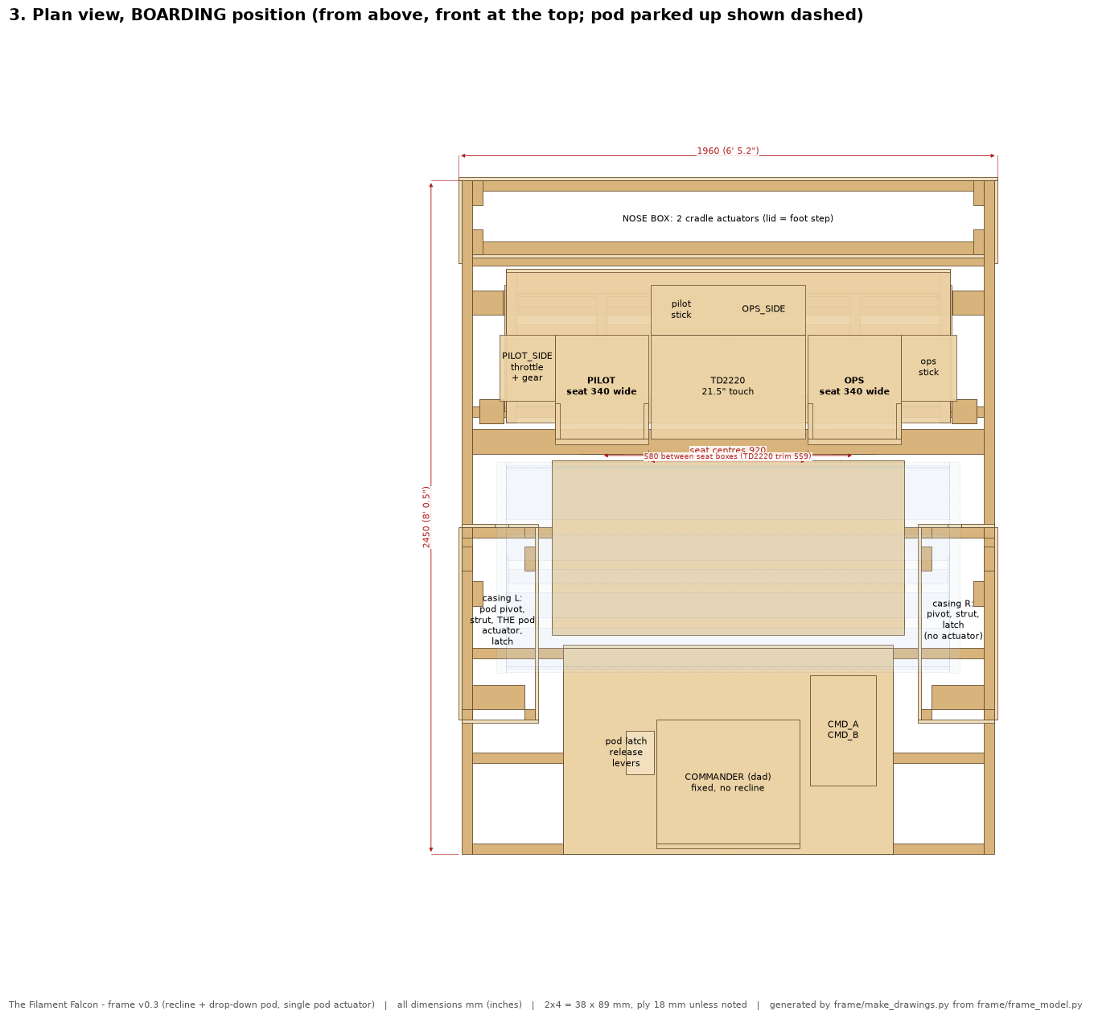
frame/drawings/03_plan_view.png
