whyvas/filament-falcon/frame/drawings/04_mechanism_interlock.png

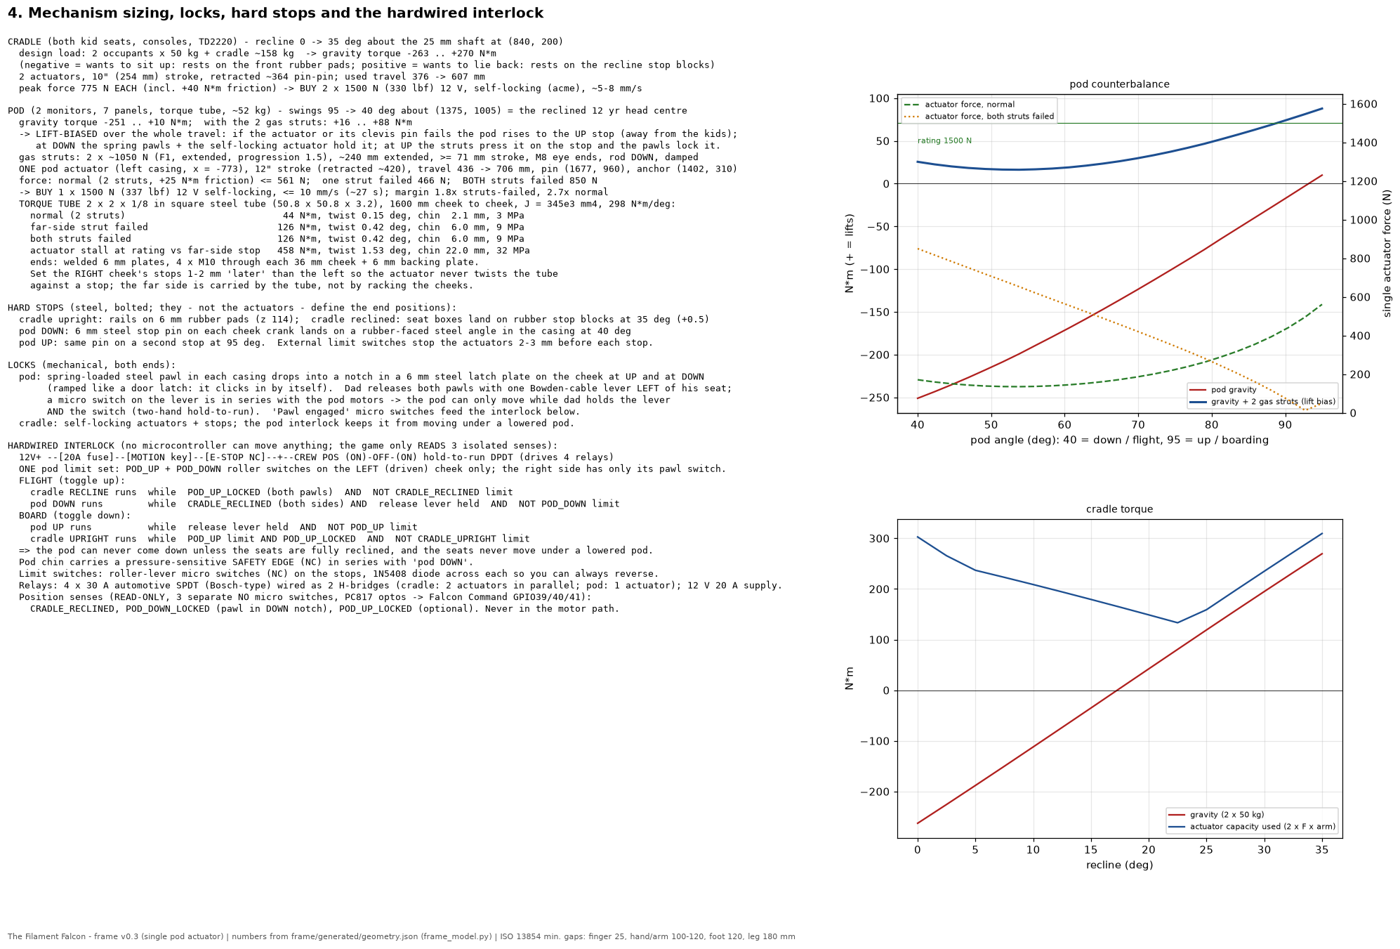
frame/drawings/04_mechanism_interlock.png
