whyvas/filament-falcon/frame/drawings/05_pinch_points_clearances.png

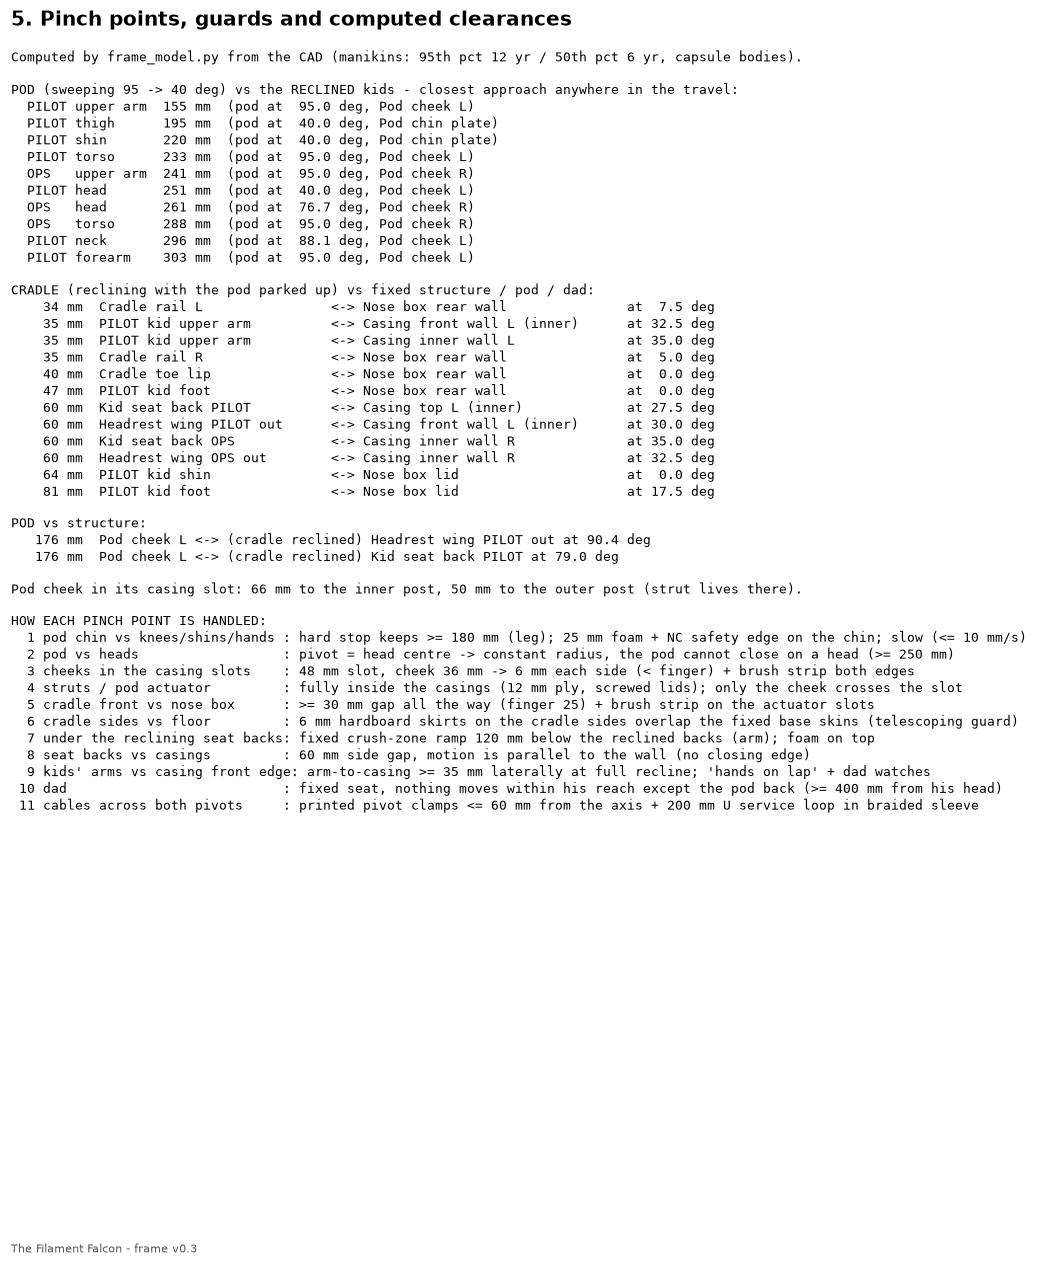
frame/drawings/05_pinch_points_clearances.png
