whyvas/filament-falcon/frame/drawings/06_pod_cheek_template.png

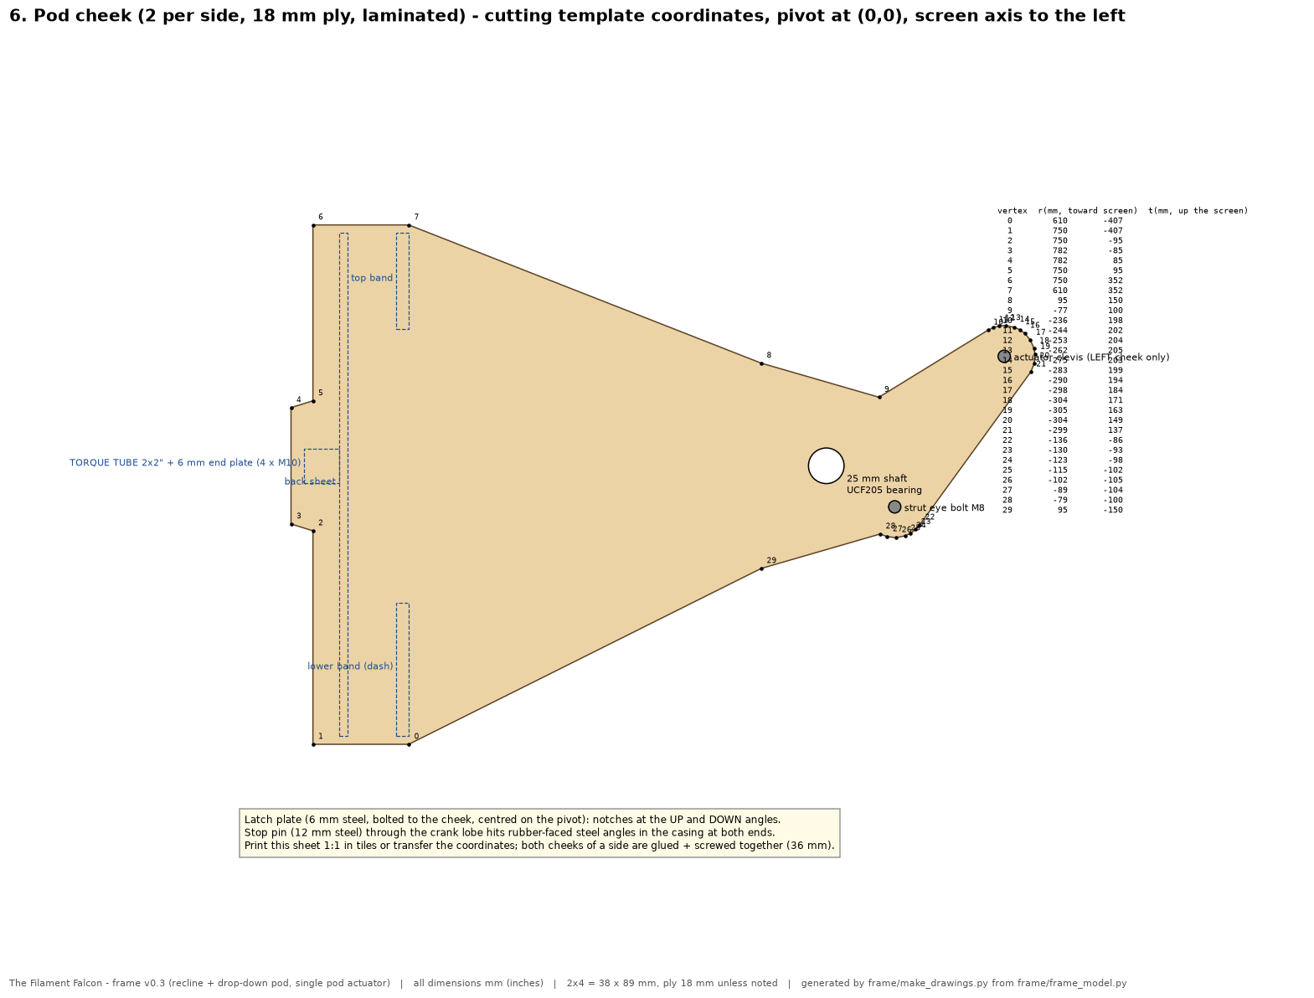
frame/drawings/06_pod_cheek_template.png
