whyvas/filament-falcon/frame/drawings/07_panel_bay_detail.png

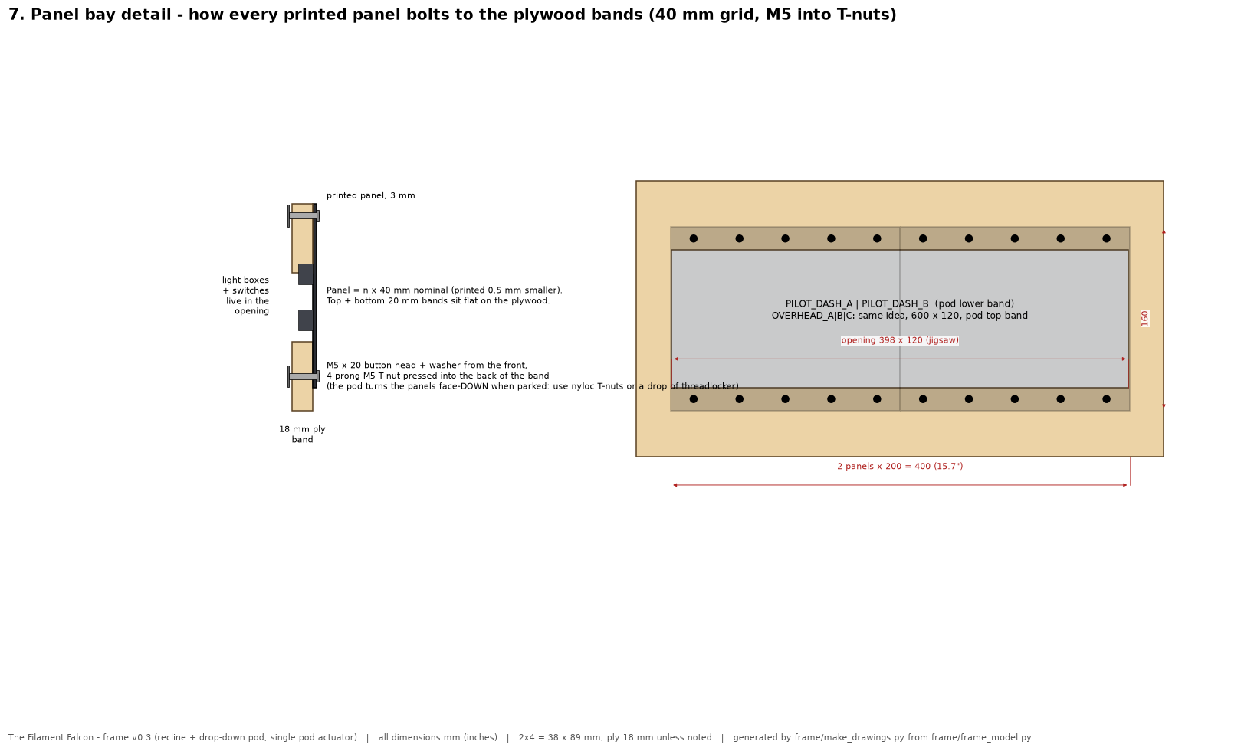
frame/drawings/07_panel_bay_detail.png
