whyvas/filament-falcon/docs/mechanical/switch_bom.md

# Bill of switches, buttons and indicators per panel

Generated by `cad/tools/switch_bom.py` from `cad/tools/layouts.py` - do not edit by hand.

## PILOT_DASH_A (200 x 160 mm) - Pilot dash, left piece; pod lower band (drops down in front of the reclined crew), in front of the LEFT seat, outboard half

| Qty | Part | Used for |
|---|---|---|
| 2 | 22 mm push button, 22 mm panel hole (industrial 22 mm or mini arcade) | BOOST, IGNITION |
| 1 | 16 mm momentary push button (metal/illuminated ok) | HORN |
| 4 | 5 mm LED + bezel/holder (or a WS2812B 5 mm through-hole) | AIRBRAKE status, ENG ARM status, FLAPS status, NAV LIGHTS status |
| 3 | Mini toggle switch SPST/SPDT, 6 mm (1/4") bushing (MTS-102 style) | AIRBRAKE, FLAPS, NAV LIGHTS |
| 1 | Mini toggle 6 mm + printed missile guard (toggle_guard.3mf) | ENG ARM |

## PILOT_DASH_B (200 x 160 mm) - Pilot dash, right piece; pod lower band in front of the LEFT seat, inboard half

| Qty | Part | Used for |
|---|---|---|
| 1 | 16 mm momentary push button (metal/illuminated ok) | VIEW |
| 1 | EC11 rotary encoder with push switch + knob |  |
| 4 | 5 mm LED + bezel/holder (or a WS2812B 5 mm through-hole) | MASTER CAUTION (red), gear down (green) |

## PILOT_SIDE (200 x 160 mm) - Pilot side console (throttle + gear); outboard LEFT side console of the reclining cradle, horizontal, top of panel = forward

| Qty | Part | Used for |
|---|---|---|
| 1 | 16 mm momentary push button (metal/illuminated ok) | PTT |
| 2 | lever slot (printed mechanism below the panel) | LANDING GEAR lever slot (gear lever box mounts below), THROTTLE lever slot (throttle quadrant mounts below) |

## OPS_DASH_A (200 x 160 mm) - Ops dash, left piece (power); pod lower band in front of the RIGHT seat, inboard half

| Qty | Part | Used for |
|---|---|---|
| 1 | 19 mm push button, 19 mm panel hole (metal anti-vandal or mini arcade) | FIRE SUPPR |
| 5 | 5 mm LED + bezel/holder (or a WS2812B 5 mm through-hole) | COMMS status, LIFE SUPPORT status, REACTOR status, SENSORS status, SHIELDS status |
| 5 | Mini toggle switch SPST/SPDT, 6 mm (1/4") bushing (MTS-102 style) | COMMS, LIFE SUPPORT, REACTOR, SENSORS, SHIELDS |

## OPS_DASH_B (200 x 160 mm) - Ops dash, right piece (mode + payload); pod lower band in front of the RIGHT seat, outboard half

| Qty | Part | Used for |
|---|---|---|
| 2 | 16 mm momentary push button (metal/illuminated ok) | NAV TGT, SCAN PING |
| 1 | EC11 rotary encoder with push switch + knob |  |
| 2 | 5 mm LED + bezel/holder (or a WS2812B 5 mm through-hole) | CARGO BAY status, DOCK CLAMP status |
| 2 | Mini toggle switch SPST/SPDT, 6 mm (1/4") bushing (MTS-102 style) | CARGO BAY, DOCK CLAMP |

## OPS_SIDE (200 x 160 mm) - Ops side console (hyperspace); front pedestal of the reclining cradle, between the kids just ahead of the TD2220 touchscreen, horizontal, top of panel = forward

| Qty | Part | Used for |
|---|---|---|
| 1 | 22 mm push button, 22 mm panel hole (industrial 22 mm or mini arcade) | ENGAGE |
| 1 | 16 mm momentary push button (metal/illuminated ok) | PTT |
| 6 | 5 mm LED + bezel/holder (or a WS2812B 5 mm through-hole) | jump charge bar (blue) |
| 1 | Mini toggle 6 mm + printed missile guard (toggle_guard.3mf) | JUMP ARM |

## OVERHEAD_A (200 x 120 mm) - Overhead console, left; pod top band above the monitors, left third (faces the reclined crew, top of panel = up the pod)

| Qty | Part | Used for |
|---|---|---|
| 3 | 5 mm LED + bezel/holder (or a WS2812B 5 mm through-hole) | AVIONICS status, BATTERY status, FUEL PUMPS status |
| 3 | Mini toggle switch SPST/SPDT, 6 mm (1/4") bushing (MTS-102 style) | AVIONICS, BATTERY, FUEL PUMPS |

## OVERHEAD_B (200 x 120 mm) - Overhead console, centre; pod top band above the monitors, centre third

| Qty | Part | Used for |
|---|---|---|
| 3 | 5 mm LED + bezel/holder (or a WS2812B 5 mm through-hole) | APU START status, GUIDANCE status, IGNITION ARM status |
| 3 | Mini toggle switch SPST/SPDT, 6 mm (1/4") bushing (MTS-102 style) | APU START, GUIDANCE, IGNITION ARM |

## OVERHEAD_C (200 x 120 mm) - Overhead console, right; pod top band above the monitors, right third

| Qty | Part | Used for |
|---|---|---|
| 3 | 5 mm LED + bezel/holder (or a WS2812B 5 mm through-hole) | BEACON status, CABIN LIGHTS status, STROBE status |
| 3 | Mini toggle switch SPST/SPDT, 6 mm (1/4") bushing (MTS-102 style) | BEACON, CABIN LIGHTS, STROBE |
| 1 | Mini toggle 6 mm + printed missile guard (toggle_guard.3mf) | EJECT |

## CMD_A (200 x 200 mm) - Commander console, game controls; dad's right-hand console on the fixed rear dais

| Qty | Part | Used for |
|---|---|---|
| 1 | 19 mm push button, 19 mm panel hole (metal anti-vandal or mini arcade) | INTERCOM |
| 3 | 22 mm push button, 22 mm panel hole (industrial 22 mm or mini arcade) | CAUTION RESET, PAUSE, START |
| 1 | 16 mm momentary push button (metal/illuminated ok) | ALL-CALL |
| 2 | EC11 rotary encoder with push switch + knob | DIMMER, MISSION |
| 1 | 19 mm key switch, 2 position, key removable in OFF only | MASTER POWER |
| 2 | 5 mm LED + bezel/holder (or a WS2812B 5 mm through-hole) | OPS ready (green), PILOT ready (green) |

## CMD_B (200 x 200 mm) - Commander console, failures + crew motion; dad's right-hand console on the fixed rear dais, behind CMD_A

| Qty | Part | Used for |
|---|---|---|
| 4 | 16 mm momentary push button (metal/illuminated ok) | CABIN LEAK, ENGINE FIRE, POWER FAULT, SENSOR GLITCH |
| 1 | 22 mm mushroom E-stop, NC, latching, twist-release | STOP |
| 1 | 19 mm key switch, 2 position, key removable in OFF only | MOTION |
| 1 | Heavy toggle 12 mm bushing, DPDT (ON)-OFF-(ON) momentary, >= 15 A @ 12 V DC | CREW POS |

## Totals (all panels)

| Qty | Part |
|---|---|
| 2 | 19 mm push button, 19 mm panel hole (metal anti-vandal or mini arcade) |
| 6 | 22 mm push button, 22 mm panel hole (industrial 22 mm or mini arcade) |
| 11 | 16 mm momentary push button (metal/illuminated ok) |
| 4 | EC11 rotary encoder with push switch + knob |
| 1 | 22 mm mushroom E-stop, NC, latching, twist-release |
| 2 | 19 mm key switch, 2 position, key removable in OFF only |
| 32 | 5 mm LED + bezel/holder (or a WS2812B 5 mm through-hole) |
| 2 | lever slot (printed mechanism below the panel) |
| 1 | Heavy toggle 12 mm bushing, DPDT (ON)-OFF-(ON) momentary, >= 15 A @ 12 V DC |
| 19 | Mini toggle switch SPST/SPDT, 6 mm (1/4") bushing (MTS-102 style) |
| 3 | Mini toggle 6 mm + printed missile guard (toggle_guard.3mf) |

Buy ~10 % spares of the small parts. Panel thickness is 3 mm, so every nut-mounted part fits;
snap-in buttons rated for 1-3 mm panels clip in directly.
