whyvas/filament-falcon/bom/Filament_Falcon_BOM.xlsx

Sheet: BOM
Category | Item | Spec/notes | Used for | Qty needed | Have it | Qty to buy | Unit price CAD | Line total | Store | Link | Search link | Price checked date | Price status
Computer & displays (owned) | Gaming PC (Ryzen 9 5900X, RX 6800 XT 16 GB, 32 GB RAM) | Linux Mint; RX 6800 XT: 2x DP 1.4, 1x HDMI 2.1, 1x USB-C, max 4 displays | Runs the Godot game (3 windows) | 1 |  |  | $0.00 |  | Owned |  |  |  | Owned
Computer & displays (owned) | Sceptre C275B-144R 27" curved monitor | 1920x1080 144 Hz, 1800R, VESA 100 M4, HDMI/DP/DVI, 3.80 kg | PILOT window (left kid), in the pod | 1 |  |  | $0.00 |  | Owned |  |  |  | Owned
Computer & displays (owned) | Sceptre C275W-1920RN 27" curved monitor | 1920x1080 75 Hz, 1800R, VESA 75 M4, HDMI + VGA only, 3.40 kg | OPS window (right kid), in the pod | 1 |  |  | $0.00 |  | Owned |  |  |  | Owned
Computer & displays (owned) | ViewSonic TD2220 22" touchscreen | 21.5" 1920x1080, optical 2-point touch over USB-B, VGA + DVI-D only, VESA 100 | Centre console touchscreen (in the cradle) | 1 |  |  | $0.00 |  | Owned |  |  |  | Owned
Computer & displays (owned) | HY300 mini projectors | Only in the projector-dome feasibility study (docs/mechanical/projector_dome_study.md); not in the core build | Optional dome / ambient projection | 3 |  |  | $0.00 |  | Owned |  |  |  | Owned
Computer & displays (owned) | 3-axis joysticks with top button (X, Y, twist pots + button) | "A couple" owned; assumed potentiometer sticks (see electronics README). Mounting pattern still to measure | PILOT and OPS sticks | 2 |  |  | $0.00 |  | Owned |  |  |  | Owned
Computer & displays (owned) | USB headsets with microphone | Already plugged into the PC (any brand; a serial number helps tell identical ones apart). The intercom runs on the PC, not the boards | Intercom (ICS): PILOT, OPS, Commander | 3 |  |  | $0.00 |  | Owned |  |  |  | Owned
Video & USB cabling | DisplayPort 1.4 cable, 3 m (10 ft), VESA certified | Latching connectors; 3-5 m per displays.md - measure from the PC location | Listing: "Silkland VESA Certified DisplayPort Cable, Long DP Cable 10FT, Braided" | GPU DP1 -> C275B-144R (1080p 144 Hz) | 1 |  |  | $16.99 |  | Amazon.ca | https://www.amazon.ca/dp/B0BRPZHK36 | https://www.amazon.ca/s?k=displayport+1.4+cable+10+ft | 2026-10-08 | Verified amazon.ca price
Video & USB cabling | HDMI cable, 3 m (10 ft) | High speed; C275W only has HDMI/VGA | Listing: "Amazon Basics High-Speed 4K HDMI Cable - 10 Feet" | GPU HDMI -> C275W-1920RN (1080p 75 Hz) | 1 |  |  | $10.76 |  | Amazon.ca | https://www.amazon.ca/dp/B014I8T0YQ | https://www.amazon.ca/s?k=hdmi+cable+10+ft | 2026-10-08 | Verified amazon.ca price
Video & USB cabling | DisplayPort -> DVI-D adapter cable, passive, 3 m (10 ft) | Single-link DVI-D, 1080p60, passive DP++ is fine. One-piece cable = no separate DVI cable needed. Alternative if you already have the TD2220 DVI cable: StarTech DP2DVI2 passive adapter https://www.amazon.ca/dp/B0035PS57C | Listing: "BENFEI DisplayPort to DVI 10 Feet Cable, Uni-Directional" | GPU DP2 -> TD2220 DVI-D in | 1 |  |  | $16.99 |  | Amazon.ca | https://www.amazon.ca/dp/B06WD33P34 | https://www.amazon.ca/s?k=displayport+to+dvi-d+cable+10+ft | 2026-10-08 | Verified amazon.ca price
Video & USB cabling | USB-A to USB-B cable, 3 m (10 ft) | USB 2.0; <= 5 m (or use an active extension) | Listing: "AINOPE USB Printer Cable 10FT, Nylon Braided USB A to USB B MIDI Cable" | PC -> TD2220 touch (HID) | 1 |  |  | $12.99 |  | Amazon.ca | https://www.amazon.ca/dp/B07ZRBRDHG | https://www.amazon.ca/s?k=usb+a+to+usb+b+cable+10+ft | 2026-10-08 | Verified amazon.ca price
Video & USB cabling | USB-A to USB-C data cables 1.8 m (6 ft), 3-pack | Must be DATA cables; plug into each board's "USB" port (not "UART") | Listing: "Cable Matters 3-Pack USB A to USB C Cable, 6ft, Black" | 3x ESP32-S3 boards -> PC / hub | 1 |  |  | $9.99 |  | Amazon.ca | https://www.amazon.ca/dp/B0CLZ9J2F5 | https://www.amazon.ca/s?k=usb+a+to+usb+c+data+cable+6+ft+3+pack | 2026-10-08 | Verified amazon.ca price
Video & USB cabling | Powered USB 3.0 hub, 7-port, with power adapter | Electronics README: a powered USB 3 hub is fine | Listing: "TP-Link UH720, Powered USB 3.0 Hub, 7 Data + 2 Charging Ports" | 3x ESP32-S3 + TD2220 touch | 1 |  |  | $39.99 |  | Amazon.ca | https://www.amazon.ca/dp/B00SCX6I8A | https://www.amazon.ca/s?k=powered+usb+3.0+hub+7+port | 2026-10-08 | Verified amazon.ca price
Video & USB cabling | Expandable braided sleeve 25 mm (1"), 7.6 m (25 ft) | BOM: 5 m of 25-30 mm sleeve | Listing: "25ft - 1 inch PET Expandable Braided Sleeving – Black – Alex Tech Braided Cable Sleeve" | 200 mm U service loops at the pod + cradle pivots | 1 |  |  | $15.98 |  | Amazon.ca | https://www.amazon.ca/dp/B073YLYBJF | https://www.amazon.ca/s?k=braided+cable+sleeve+1+inch+25+ft | 2026-10-08 | Verified amazon.ca price
Controllers & logic | ESP32-S3-DevKitC-1-N8R8, 5-pack | Must be the S3 DevKitC-1 with both "USB" + "UART" ports. 3 needed + 2 spares | Listing: "5pcs ESP32 S3 Development Board ESP32-S3-DevKitC-1-N8R8 MCU Module" | Falcon Pilot / Ops / Command | 1 |  |  | $71.98 |  | Amazon.ca | https://www.amazon.ca/dp/B0D93FLZLH | https://www.amazon.ca/s?k=ESP32-S3-DevKitC-1+N8R8 | 2026-10-08 | Verified amazon.ca price
Controllers & logic | 74HC165 shift register DIP-16, 25 pcs | 10 needed (3 Pilot, 3 Ops, 4 Command) + 2 spares | Listing: "SING F LTD 25Pcs DIP16 IC 8BIT Parallel-in/Serial-Out Shift Register 16 Pin Computer Through Hole De" | Switch inputs | 1 |  |  | $18.49 |  | Amazon.ca | https://www.amazon.ca/dp/B0D2THXFQ6 | https://www.amazon.ca/s?k=SN74HC165N+DIP-16 | 2026-10-08 | Verified amazon.ca price
Controllers & logic | DIP IC socket assortment (incl. 14- and 16-pin) | 12x DIP-16 for the 74HC165s + 1x DIP-14 for the 74AHCT125 | Listing: "Glarks 122Pcs 2.54mm Pitch DIP IC Sockets Solder Type Adaptor Assortment Kit (6 / 8 / 14 / 16 / 18 /" | Socketed chips on the perfboards | 1 |  |  | $16.99 |  | Amazon.ca | https://www.amazon.ca/dp/B01GOLSUAU | https://www.amazon.ca/s?k=dip+ic+socket+assortment | 2026-10-08 | Verified amazon.ca price
Controllers & logic | 10 kOhm bussed resistor network SIP-9 (A103J), 20 pcs | 12 needed (one per 74HC165, 8 pull-ups) | Listing: "20pcs A103J 9pin 10K ohm DIP Exclusion 9 PINS Network Resistor Array" | 74HC165 input pull-ups | 1 |  |  | $8.88 |  | Amazon.ca | https://www.amazon.ca/dp/B0D4BXJ1SX | https://www.amazon.ca/s?k=10k+bussed+resistor+network+sip+9+A103J | 2026-10-08 | Verified amazon.ca price
Controllers & logic | 100 nF ceramic capacitors, 100 pcs | 52 needed: 20 at chips/boards + 32 at the WS2812D-F5 LEDs | Listing: "50V Ceramic Capacitor,50V 100NF(104 100pcs" | Decoupling | 1 |  |  | $6.55 |  | Amazon.ca | https://www.amazon.ca/dp/B09JWTW1GT | https://www.amazon.ca/s?k=100nf+ceramic+capacitor+104+100pcs | 2026-10-08 | Verified amazon.ca price
Controllers & logic | Electrolytic capacitor assortment 0.1-1000 uF (10-50 V) | Covers 5x 10 uF (boards + overhead cable end) and 1x 1000 uF 10 V+ across the LED strip input | Listing: "Swpeet 240Pcs 24 Kinds Different Electrolytic Capacitors Range 0.1uF－1000uF Assortment Kit, 10V/16V/" | Bulk decoupling | 1 |  |  | $16.99 |  | Amazon.ca | https://www.amazon.ca/dp/B07KC99W2K | https://www.amazon.ca/s?k=electrolytic+capacitor+assortment+1000uf | 2026-10-08 | Verified amazon.ca price
Controllers & logic | 74AHCT125N DIP-14 level shifter, 10 pcs | 1 needed (3.3 V -> 5 V LED data) | Listing: "10PCS SN74AHCT125N 74AHCT125N 74AHCT125 DIP-14 Buffer line Driver" | WS2812B data line from Falcon Command | 1 |  |  | $11.56 |  | Amazon.ca | https://www.amazon.ca/dp/B0C6FNV224 | https://www.amazon.ca/s?k=74AHCT125N+DIP-14 | 2026-10-08 | Verified amazon.ca price
Controllers & logic | Resistor kit 1/4 W 1%, 50 values | Covers 2x 330 Ohm (LED data), 2x 100 Ohm (CLK series), 3x 10 kOhm opto pull-ups (GPIO39/40/41) + spares | Listing: "BOJACK 50 Values 1350 Pcs Resistor Kit 0 Ohm-5.6M Ohm with 1% 1/4W Metal Film Resistors Assortment" | Misc. resistors | 1 |  |  | $19.99 |  | Amazon.ca | https://www.amazon.ca/dp/B07P3MFG5D | https://www.amazon.ca/s?k=resistor+assortment+kit+1%2F4w+metal+film | 2026-10-08 | Verified amazon.ca price
Controllers & logic | 2.2 kOhm 1/2 W resistors, 10 pcs | 3 needed (one per PC817 LED from 12 V: cradle reclined, pod down-locked, pod up-locked) | Listing: "E-Projects 10EP5122K20 2.2k Ohm Resistors, 1/2 W, 5% (Pack of 10)" | Isolated seat/pod sense | 1 |  |  | $8.76 |  | Amazon.ca | https://www.amazon.ca/dp/B0185FKB2S | https://www.amazon.ca/s?k=2.2k+ohm+1%2F2w+resistor | 2026-10-08 | Verified amazon.ca price
Controllers & logic | PC817 optocoupler DIP-4, 20 pcs | 3 needed (READ-ONLY position senses -> Falcon Command GPIO39/40/41: cradle reclined, pod down-locked, pod up-locked optional); pack covers it | Listing: "Gikfun OPTOCOUPLER DIP-4 PC817C PC817 for Arduino DIY (Pack of 20pcs) AE1143" | Isolated position sense into Falcon Command | 1 |  |  | $10.68 |  | Amazon.ca | https://www.amazon.ca/dp/B01JG8EJVW | https://www.amazon.ca/s?k=pc817+optocoupler+dip | 2026-10-08 | Verified amazon.ca price
Controllers & logic | Perfboard 7 x 9 cm, 10 pcs | 3 needed (one carrier per DevKitC-1, fits the printed enclosure) | Listing: "10pcs 7x9cm Universal PCB Prototype Single Sided DIY Universal Circuit Board, Circuit Board Point to" | ESP32 carrier boards | 1 |  |  | $12.96 |  | Amazon.ca | https://www.amazon.ca/dp/B07GJ788H4 | https://www.amazon.ca/s?k=perfboard+7x9+cm | 2026-10-08 | Verified amazon.ca price
Controllers & logic | 2.54 mm male + female pin header kit | Female headers to socket each DevKitC-1 | Listing: "Glarks 40pcs 2.54mm Male and Female Pin Header Connectors 8 Kinds Header Connector Kit for Arduino P" | ESP32 carrier boards | 1 |  |  | $18.99 |  | Amazon.ca | https://www.amazon.ca/dp/B01GY36RJY | https://www.amazon.ca/s?k=2.54mm+male+female+pin+header+kit | 2026-10-08 | Verified amazon.ca price
Controllers & logic | JST-XH 2.54 mm connector kit with pre-crimped leads | No crimper needed | Listing: "XH 2.54mm Connector Kit with pre-Crimped Cable Wire 2/3/4/5/6/7/8/9/10 Pin Housing JST Adapter Cable" | Panel harness connectors | 1 |  |  | $20.99 |  | Amazon.ca | https://www.amazon.ca/dp/B08G18PWQ6 | https://www.amazon.ca/s?k=jst+xh+connector+kit+pre+crimped | 2026-10-08 | Verified amazon.ca price
Controllers & logic | Dupont jumper wires, 120 pcs | Bench testing + short links | Listing: "ELEGOO 120pcs 20cm Multicolored Dupont Wire for Programming Coding Stem" | Prototyping | 1 |  |  | $12.99 |  | Amazon.ca | https://www.amazon.ca/dp/B01EV70C78 | https://www.amazon.ca/s?k=dupont+jumper+wires | 2026-10-08 | Verified amazon.ca price
Controllers & logic | Cat6 patch cable 7.6 m (25 ft) | Measure Command board -> overhead (pod top band) first; route through the pod pivot service loop | Listing: "Cable Matters 10Gbps Snagless Cat 6 Ethernet Cable, 25ft, Black" | Falcon Command -> overhead 74HC165 chain (CLK, LOAD, DATA, 3V3, GND) | 1 |  |  | $17.99 |  | Amazon.ca | https://www.amazon.ca/dp/B007NZGPAY | https://www.amazon.ca/s?k=cat6+patch+cable+25+ft | 2026-10-08 | Verified amazon.ca price
Controllers & logic | 22 AWG stranded hookup wire kit (6 colours) | Not in the source parts lists, but needed to wire ~60 switches/LEDs to the boards | Listing: "Fermerry 22 Gauge Wire Silicone Electrical Wire Kit 6 Colors 10ft Each" | Switch + LED wiring | 1 |  |  | $20.49 |  | Amazon.ca | https://www.amazon.ca/dp/B089CQHRDT | https://www.amazon.ca/s?k=22+awg+stranded+hookup+wire+kit | 2026-10-08 | Verified amazon.ca price
Panel controls | Mini toggle switch MTS-102, 6 mm (1/4") bushing, 10 pcs | 26 needed: 22 ON-OFF (use 2 of 3 pins) + 4 under printed missile guards (ENG ARM, JUMP ARM, EJECT +1). Note: you may already own some of these (tick Have it if so). | Listing: "MTS-102 6A 125V Mini 3PIN ON-Off Toggle Switches for Switching Lights Motors 10pcs (MTS-102)" | Pilot/Ops/overhead toggles | 3 |  |  | $8.45 |  | Amazon.ca | https://www.amazon.ca/dp/B0CX9FDTJ8 | https://www.amazon.ca/s?k=mts-102+mini+toggle+switch+6mm | 2026-10-08 | Verified amazon.ca price
Panel controls | Mini toggle MTS-103 ON-OFF-ON, 6 mm bushing, 10 pcs | 2 needed (+1 spare). Note: you may already own some of these (tick Have it if so). | Listing: "MTS-103 6A 125V Mini 3PIN ON-Off-ON Toggle Switches for Switching Lights Motors 10pcs (MTS-103)" | Pilot FLAPS | 1 |  |  | $12.99 |  | Amazon.ca | https://www.amazon.ca/dp/B0D47RXXMK | https://www.amazon.ca/s?k=mts-103+on-off-on+mini+toggle | 2026-10-08 | Verified amazon.ca price
Panel controls | 22 mm momentary push buttons (LA38, 5 colours), 6 pcs | 8 needed (6 + 2 spares); 3 mm panel. Note: you may already own some of these (tick Have it if so). | Listing: "6 Pcs 440V 22mm Momentary Push Button Switch 10A 5 Color (Red/Bule/Green/White/Yellow/Black) LA38-11" | IGNITION, BOOST, ENGAGE, START, PAUSE, CAUTION RESET | 2 |  |  | $19.49 |  | Amazon.ca | https://www.amazon.ca/dp/B09F39MBKD | https://www.amazon.ca/s?k=22mm+momentary+push+button | 2026-10-08 | Verified amazon.ca price
Panel controls | 19 mm momentary metal push buttons, 2 pcs | 3 needed (2 + 1 spare). Note: you may already own some of these (tick Have it if so). | Listing: "2pcs 19mm Momentary Metal Push Button Switch High Round Head with Pre-soldered Cable 3/4" Mounting H" | FIRE SUPPR, INTERCOM | 2 |  |  | $15.39 |  | Amazon.ca | https://www.amazon.ca/dp/B0GGYZJFHD | https://www.amazon.ca/s?k=19mm+momentary+push+button+metal | 2026-10-08 | Verified amazon.ca price
Panel controls | 16 mm momentary metal push buttons, 5 pcs | 13 needed (11 on the CAD panels + 2 spares) -> 3 packs. Note: you may already own some of these (tick Have it if so). | Listing: "Gebildet 5pcs Momentary Push Button Screw Type Terminals Stainless Steel Metal Waterproof Button 16m" | HORN, VIEW, SCAN PING, NAV TGT, 4 failure buttons + intercom PILOT PTT (PILOT_SIDE), OPS PTT (OPS_SIDE), ALL-CALL (CMD_A) | 3 |  |  | $11.99 |  | Amazon.ca | https://www.amazon.ca/dp/B081JJBN4G | https://www.amazon.ca/s?k=16mm+momentary+push+button+metal | 2026-10-08 | Verified amazon.ca price
Panel controls | EC11 rotary encoder with push switch + knob, 10 pcs | 5 needed (4 + 1 spare), 7 mm panel hole. Note: you may already own some of these (tick Have it if so). | Listing: "WMYCONGCONG 10 PCS 20MM EC11 Rotary Encoder Code Switch 7 Pins Digital Potentiometer with Knob Cap" | FLIGHT ASSIST, OPS MODE, MISSION, DIMMER | 1 |  |  | $17.99 |  | Amazon.ca | https://www.amazon.ca/dp/B07VCNNV88 | https://www.amazon.ca/s?k=ec11+rotary+encoder+with+knob | 2026-10-08 | Verified amazon.ca price
Panel controls | B10K linear potentiometer, 16 mm, 6 mm D shaft | 1 needed; check pack size on the listing | Listing: "Variable Resistor Potentiometer Flatted 6mm D Shaft Linear Taper Pot B D (B10K)" | Pilot throttle lever (printed quadrant) | 1 |  |  | $6.95 |  | Amazon.ca | https://www.amazon.ca/dp/B0CLP8SVJN | https://www.amazon.ca/s?k=b10k+linear+potentiometer+6mm+d+shaft | 2026-10-08 | Verified amazon.ca price
Panel controls | KW11 lever micro switch, 10 pcs | 2 needed in the printed gear lever box | Listing: "OTOTEC 10Pcs 3 Pin Mini Micro Limit Switch 5A 125/250V Lever Type Micro Switch for Electronic Equipm" | LANDING GEAR lever | 1 |  |  | $15.79 |  | Amazon.ca | https://www.amazon.ca/dp/B0F9XYYSPZ | https://www.amazon.ca/s?k=kw11+micro+switch+lever | 2026-10-08 | Verified amazon.ca price
Panel controls | 19 mm key switch, 2 position, key removable in OFF | MASTER POWER (game input). Rotary 2-position metal key switch, 1NO1NC. Check key is removable in OFF only | Listing: "19mm 3/4" ON/OFF Rotary Key Switch, Metal Lock Switch with Kept Lock and Wired Lock (19mm 2 Position" | CMD_A MASTER POWER | 1 |  |  | $26.11 |  | Amazon.ca | https://www.amazon.ca/dp/B09M849WCK | https://www.amazon.ca/s?k=19mm+key+switch+2+position | 2026-10-08 | Verified amazon.ca price
LED backlighting | WS2812B LED strip 5 V, 60 LED/m, 5 m, IP30 (no sleeve) | BTF-LIGHTING ECO; this ASIN is the Black PCB / IP30 / 5 m 60 LED/m variant (checked). 10 mm wide strip fits the 12 mm channels; ~136 label LEDs + panel hops | Listing: "BTF-LIGHTING WS2812B IC ECO Individually Addressable RGB LED Strip Lights" | Backlit labels, one continuous strip | 1 |  |  | $25.99 |  | Amazon.ca | https://www.amazon.ca/dp/B0F8VDHK22 | https://www.amazon.ca/s?k=ws2812b+5m+60+led+ip30 | 2026-10-08 | Verified amazon.ca price
LED backlighting | WS2812D-F5 5 mm through-hole addressable RGB LEDs, ~40 pcs | 32 status holes + spares; spliced into the same data line. NOT found on amazon.ca (only plain 4-pin RGB). Try AliExpress / Digi-Key, or use plain LEDs + 74HC595 (firmware change) | Status/indicator LEDs (*_LED ids) | 1 |  |  | $20.00 |  | Amazon.ca |  | https://www.amazon.ca/s?k=WS2812D-F5+5mm+addressable+RGB+LED |  | No suitable listing found - estimate
LED backlighting | 5 mm LED holders / bezels, 50 pcs | 32 needed. Note: you may already own some of these (tick Have it if so). | Listing: "PATIKIL 5mm Emitting Diode Holder, 50 Pcs Plastic Flat LED Holder Clip Mounting Bracket Socket Cap f" | Status LED holes | 1 |  |  | $9.19 |  | Amazon.ca | https://www.amazon.ca/dp/B0DJR583BY | https://www.amazon.ca/s?k=5mm+led+holder+bezel | 2026-10-08 | Verified amazon.ca price
LED backlighting | Mean Well LRS-50-5 (5 V 10 A) power supply | Firmware caps strip at 8 A; inject power at start/middle/end | Listing: "Mean Well LRS-50-5 Switching Power Supply, Single Output, 5V, 10A, 50W, 3.9" L x 3.23" W x 1.18" H" | LED strip power | 1 |  |  | $31.75 |  | Amazon.ca | https://www.amazon.ca/dp/B019GYOCMM | https://www.amazon.ca/s?k=mean+well+lrs-50-5 | 2026-10-08 | Verified amazon.ca price
LED backlighting | Inline 5x20 mm fuse holders + fast-blow fuse kit | Use a 10 A fuse at the PSU output | Listing: "Fuse Kit Car Fuses - 10pcs 5x20mm AGC Inline Fuse Holder + 100pcs 5x20mm Fast-Blow Glass Fuses Quick" | LED PSU output fuse | 1 |  |  | $14.99 |  | Amazon.ca | https://www.amazon.ca/dp/B07X8WL5TC | https://www.amazon.ca/s?k=inline+fuse+holder+5x20+kit | 2026-10-08 | Verified amazon.ca price
LED backlighting | 16 AWG red/black 2-conductor wire, 15 m (50 ft) | LED power trunk. Prefer pure copper (check listing) | Listing: "VIABRICO 16AWG 50FT Electrical Wire Cable 2 Conductors Red Black Cable Hookup LED Lighting Strips Fl" | LED 5 V trunk | 1 |  |  | $16.99 |  | Amazon.ca | https://www.amazon.ca/dp/B0CNRTZ4N3 | https://www.amazon.ca/s?k=16+awg+red+black+wire+copper | 2026-10-08 | Verified amazon.ca price
LED backlighting | 18 AWG red/black silicone wire, 7.6 m (25 ft) | Injection drops; 2nd roll for the 12 V switch circuits of the interlock | Listing: "BNTECHGO 18 AWG Silicone Wire Red Black 25ft Stranded Tinned Copper Wire" | LED injection + interlock switch wiring | 2 |  |  | $19.82 |  | Amazon.ca | https://www.amazon.ca/dp/B07HGTKQ89 | https://www.amazon.ca/s?k=18+awg+red+black+silicone+wire | 2026-10-08 | Verified amazon.ca price
LED backlighting | JST-SM 3-pin pigtails (WS2812), 60 pcs | Panel-to-panel strip hops, removable panels | Listing: "JST SM 3 Pin Connectors for WS2812B WS2812 WS2811, 22AWG LED Male/Female Connector Adapter Open Wire" | LED strip connectors | 1 |  |  | $18.59 |  | Amazon.ca | https://www.amazon.ca/dp/B0CP94DL4F | https://www.amazon.ca/s?k=jst+sm+3+pin+connector+ws2812 | 2026-10-08 | Verified amazon.ca price
Printed parts: filament & inserts | PETG filament 1.75 mm BLACK, 1 kg | Estimate 5.3 kg incl. 15 % waste (see Notes sheet) -> 6 spools. Panels, enclosures, mounts, harness hub (PETG required there) | Listing: "ELEGOO PETG 3D Printer Filament 1.75mm Black 1KG, Strong & Durable" | All black printed parts | 6 |  |  | $19.94 |  | Amazon.ca | https://www.amazon.ca/dp/B0D41Y3WWZ | https://www.amazon.ca/s?k=petg+filament+1.75+black+1kg | 2026-10-08 | Verified amazon.ca price
Printed parts: filament & inserts | PETG filament 1.75 mm WHITE, 1 kg | Estimate only ~0.06 kg (letters and backing boxes) - 1 spool is plenty | Listing: "ELEGOO Rapid PETG 3D Printer Filament 1.75mm White 1KG" | Backlit letters / letters and the box behind each label | 1 |  |  | $20.89 |  | Amazon.ca | https://www.amazon.ca/dp/B0CMC78XKT | https://www.amazon.ca/s?k=petg+filament+1.75+white+1kg | 2026-10-08 | Verified amazon.ca price
Printed parts: filament & inserts | Brass heat-set inserts kit M2-M6 (360 pcs) | Harness hub 5x M3 each; pivot cable clamps M4 | Listing: "Besitu 360Pcs Threaded Inserts M2 M2.5 M3 M4 M5 M6 Brass Heat Set Insert for Plastic Metric Knurled " | Harness hub, pivot cable clamps | 1 |  |  | $26.99 |  | Amazon.ca | https://www.amazon.ca/dp/B0CNRSJ1B2 | https://www.amazon.ca/s?k=heat+set+inserts+kit+m3+m4 | 2026-10-08 | Verified amazon.ca price
Printed parts: filament & inserts | Metric socket screw assortment M2-M5 (1760 pcs) | Covers M3x20 (hub), M3x12, M4x12/16/20/25 (TD2220, monitors, clamps). Check M4 lengths vs your VESA inserts | Listing: "Besitu 1760pcs M2 M3 M4 M5 Metric Screw Assortment, Grade 12.9 Alloy Steel Hex Socket Head Cap Metri" | Printed-part and display screws | 1 |  |  | $28.99 |  | Amazon.ca | https://www.amazon.ca/dp/B0C38YFL3D | https://www.amazon.ca/s?k=m2+m3+m4+m5+socket+head+screw+assortment | 2026-10-08 | Verified amazon.ca price
Printed parts: filament & inserts | Self-tapping screw assortment M2 / M2.5 / M3 | 12x M2.5x6 (perfboards) + 12x M3x10 (enclosure lids) | Listing: "1200Pcs M2 M2.5 M3 Small Phillips Flat Head Self Tapping Screws for Wood,Plastic and Soft Metal,Coun" | ESP32 enclosures | 1 |  |  | $16.99 |  | Amazon.ca | https://www.amazon.ca/dp/B09CT54JJZ | https://www.amazon.ca/s?k=self+tapping+screw+assortment+m2.5+m3 | 2026-10-08 | Verified amazon.ca price
Frame lumber & sheet goods | 2x4 SPF stud 8 ft (2438 mm), kiln dried | 22 used by the cut list + 2 spares. 38 x 89 mm (1.5" x 3.5"). Pick straight boards. Kent Fredericton price (South/Bishop Dr and North/Two Nations Crossing, same price) checked 2026-10-09 | Frame (see frame/cut_list.md) | 24 |  |  | $3.98 |  | Kent | https://kent.ca/en/2-x-4-x-8-spf-stud-kiln-dried-1016318 | https://kent.ca/en/search?q=2x4x8+stud | 2026-10-09 | Kent.ca web price (Fredericton store)
Frame lumber & sheet goods | 2x4 SPF 10 ft (3048 mm), kiln dried | The two 2450 mm sills. Kent Fredericton price checked 2026-10-09 | Base sills | 2 |  |  | $5.88 |  | Kent | https://kent.ca/en/2-x-4-x-10-2-better-spf-lumber-kiln-dried-1016338 | https://kent.ca/en/search?q=2x4x10 | 2026-10-09 | Kent.ca web price (Fredericton store)
Frame lumber & sheet goods | Plywood 18 mm (3/4") 4x8 ft (1220 x 2440), spruce standard | 13.5 m2 net + ~30 % waste. Seat boxes/backs, consoles, cradle deck, pod cheeks (2 layers), pod bands, dais | Frame panels | 6 |  |  | $63.98 |  | Kent | https://kent.ca/en/3-4-x-4-x-8-18-5mm-spruce-plywood-standard-1015824 | https://kent.ca/en/search?q=3%2F4+plywood+4x8 | 2026-10-09 | Kent.ca web price (Fredericton store)
Frame lumber & sheet goods | Plywood 12 mm (1/2") 4x8 ft, spruce standard | 9.2 m2 net. Casings, skins, nose box, pod back sheet + chin, crush-zone ramp | Frame skins | 4 |  |  | $39.98 |  | Kent | https://kent.ca/en/1-2-x-4-x-8-12-5mm-spruce-plywood-standard-1015823 | https://kent.ca/en/search?q=1%2F2+plywood+4x8 | 2026-10-09 | Kent.ca web price (Fredericton store)
Frame lumber & sheet goods | 6 mm (1/4") hardboard or plywood, 4x8 ft | Small covers / templates. Price shown is Kent 1/4" meranti ply (hardboard is cheaper) | Covers, templates | 1 |  |  | $24.99 |  | Kent | https://kent.ca/en/1-4-x-4-x-8-meranti-plywood-1015821 | https://kent.ca/en/search?q=1%2F4+hardboard+4x8 | 2026-10-09 | Kent.ca web price (Fredericton store)
Fasteners & general hardware | Construction screws 5 x 80 mm (#10 x 3"), 1 box | 2x4 joints, 2 per joint min. | Frame | 1 |  |  | $25.00 |  | Kent / Home Depot |  | https://kent.ca/en/search?q=construction+screws+%2310+x+3 |  | Estimate - check in store
Fasteners & general hardware | Wood screws 4 x 40 mm (#8 x 1-1/2"), 1 box | Ply to 2x4 | Frame | 1 |  |  | $15.00 |  | Kent / Home Depot |  | https://kent.ca/en/search?q=wood+screws+%238+x+1-1%2F2 |  | Estimate - check in store
Fasteners & general hardware | Wood screws 4 x 25 mm (#8 x 1"), 1 box | Skins, clips, limit-switch brackets; also the 30x M4x25 countersunk screws for the TD2220 trim laps | Frame, trim ring | 1 |  |  | $12.00 |  | Kent / Home Depot |  | https://kent.ca/en/search?q=wood+screws+%238+x+1 |  | Estimate - check in store
Fasteners & general hardware | PVA wood glue, 1 L | Cheek laminations, boxes | Frame | 1 |  |  | $15.00 |  | Kent / Home Depot |  | https://kent.ca/en/search?q=wood+glue+1+l |  | Estimate - check in store
Fasteners & general hardware | M5 four-prong T-nuts, M5 x 8 mm, 200 pcs | Drill the barrel hole (~7 mm, check) on the 40 mm grid, press in from the back | Listing: "M4 M5 M6 M8 M10 M12 Carbon Steel 4 Prongs T Nut Tee Nuts Furniture Wood Insert (200,M5 x 8mm)" | Panel bays | 1 |  |  | $44.38 |  | Amazon.ca | https://www.amazon.ca/dp/B0FF4HDSK3 | https://www.amazon.ca/s?k=m5+tee+nut+4+prong+200 | 2026-10-08 | Verified amazon.ca price
Fasteners & general hardware | M5 x 20 flanged button-head socket screws, black, 50 pcs | 200 needed -> 4 packs (flanged, washers optional) | Listing: "50Pcs M5 x 20mm Flanged Button Head Socket Cap Screws Bolts, Allen Socket Drive M5 Screws Bolts Blac" | Panels into T-nuts | 4 |  |  | $14.99 |  | Amazon.ca | https://www.amazon.ca/dp/B0FR1FQ1B7 | https://www.amazon.ca/s?k=m5+x+20+button+head+socket+screw+black | 2026-10-08 | Verified amazon.ca price
Fasteners & general hardware | M5 flat washers, 200 pcs | Optional with flanged screws | Listing: "M5 Flat Washers Carbon Steel 200HV Color Zinc Plated, 200 PCS Metric Plain Washers Heavy Duty Hardwa" | Panels | 1 |  |  | $9.99 |  | Amazon.ca | https://www.amazon.ca/dp/B0GX28963L | https://www.amazon.ca/s?k=m5+flat+washers+200 | 2026-10-08 | Verified amazon.ca price
Fasteners & general hardware | M6 x 50 carriage bolts + fender washers + nylocks | 2 printed monitor standoffs x 4 bolts through the pod back sheet | Monitor standoffs | 8 |  |  | $1.50 |  | Kent / Home Depot |  | https://kent.ca/en/search?q=m6+x+50+carriage+bolt |  | Estimate - check in store
Fasteners & general hardware | 2 mm stainless safety cable with loops, 300 mm (12"), 5 pcs | REQUIRED: one per monitor, VESA screw -> eye screw in the back sheet, <= 50 mm slack (the pod parks monitors face-down). Plus 2 eye screws (Kent) | Listing: "PATIKIL 2mmD x 12" L Outdoor Travel Security Cable, 5PCS 304 Stainless Steel Safety Wire Rope Luggag" | Monitor safety tethers | 1 |  |  | $9.99 |  | Amazon.ca | https://www.amazon.ca/dp/B0FQP7W6J3 | https://www.amazon.ca/s?k=2mm+stainless+safety+cable+loops+12+inch | 2026-10-08 | Verified amazon.ca price
Fasteners & general hardware | Pivot bolts M6 x 30 + M4 x 40 with nylocks | Throttle lever pivot (M6x30), gear lever pivot (M4x40) | Throttle + gear lever | 1 |  |  | $4.00 |  | Kent / Home Depot |  | https://kent.ca/en/search?q=m6+x+30+bolt |  | Estimate - check in store
Motion system: pivots, shafts, bearings | 25 mm linear shaft, 1000 mm, 2 pcs | Cradle shaft (one per side). Case-hardened chrome rod is hard to cut - bright steel h9 from a metal supplier is the BOM spec and cuts easily | Listing: "VEVOR 2PCS Linear Motion Rod, 25 mm x 1000 mm (0.98 x 39.4 in), SFC25 Carbon Steel Linear Rod Shaft," | Cradle pivot | 1 |  |  | $46.99 |  | Amazon.ca | https://www.amazon.ca/dp/B0G5ZDQB47 | https://www.amazon.ca/s?k=25mm+shaft+1000mm | 2026-10-08 | Verified amazon.ca price
Motion system: pivots, shafts, bearings | 25 mm bright steel round bar (h9), 2 x ~250 mm | Pod shaft stubs (tower post outer -> inner). Local metal supplier / cut from bar | Pod pivot | 1 |  |  | $30.00 |  | Local metal supplier |  | https://www.google.com/search?q=25mm+steel+round+bar+Fredericton+NB |  | Estimate - get a quote
Motion system: pivots, shafts, bearings | SHF25 shaft supports, 4 pcs | 6 needed (cradle shaft on 2 pedestals, pod shaft on inner tower posts + 2 spare positions) -> 2 packs | Listing: "PATIKIL SHF25 Aluminum Linear Motion Rod Rail Clamping Guide Support, 4 Pcs for 25mm Dia Shaft" | Cradle + pod shafts | 2 |  |  | $13.49 |  | Amazon.ca | https://www.amazon.ca/dp/B0D9RTBQF2 | https://www.amazon.ca/s?k=shf25+shaft+support | 2026-10-08 | Verified amazon.ca price
Motion system: pivots, shafts, bearings | UCP205 pillow block bearings 25 mm, 2-pack | Under the rear ends of the cradle rails | Listing: "XIKE UCP205 Pillow Block Bearing, 25 mm Bore, Self-Aligning Mounted Bearing Unit, 2-Pack" | Cradle pivot | 1 |  |  | $37.75 |  | Amazon.ca | https://www.amazon.ca/dp/B08HJYZK1X | https://www.amazon.ca/s?k=ucp205+pillow+block+bearing+25mm | 2026-10-08 | Verified amazon.ca price
Motion system: pivots, shafts, bearings | UCF205 4-bolt flange bearing 25 mm | In the pod cheeks (one each side) | Listing: "uxcell UCF205 Flange Block Bearings 25mm Bore Cast Iron Bearing Unit Set Screw Lock" | Pod pivot | 2 |  |  | $20.79 |  | Amazon.ca | https://www.amazon.ca/dp/B0BLLVF9DB | https://www.amazon.ca/s?k=ucf205+flange+bearing+25mm | 2026-10-08 | Verified amazon.ca price
Motion system: pivots, shafts, bearings | 25 mm steel double-split shaft collars, 2 pcs | 4 needed -> 2 packs | Listing: "uxcell 2pcs Double Split Shaft Collars 25mm Bore, Two-Piece Clamping Collar 38mm OD 12mm Thickness C" | Stop shafts walking | 2 |  |  | $17.49 |  | Amazon.ca | https://www.amazon.ca/dp/B0G2Q98L26 | https://www.amazon.ca/s?k=25mm+shaft+collar+steel | 2026-10-08 | Verified amazon.ca price
Motion system: pivots, shafts, bearings | 6 mm steel plate 120 x 120 mm with 4 holes | Under the pod bearings / supports on the tower posts. Metal shop or cut from flat bar | Pod pivot | 4 |  |  | $10.00 |  | Local metal supplier |  | https://www.google.com/search?q=6mm+steel+plate+Fredericton+NB |  | Estimate - get a quote
Motion system: pivots, shafts, bearings | M10 x 90 coach screws + washers | Bearings and shaft supports to the frame (~4 per bearing/support) | Bearings | 20 |  |  | $1.25 |  | Kent / Home Depot |  | https://kent.ca/en/search?q=m10+x+90+lag+screw |  | Estimate - check in store
Motion system: pivots, shafts, bearings | M8 x 60 bolts + nylocks + washers | Actuator clevises (use your actuators' pin size) + strut brackets | Actuators, struts | 8 |  |  | $1.50 |  | Kent / Home Depot |  | https://kent.ca/en/search?q=m8+x+60+bolt |  | Estimate - check in store
Motion system: drive & locks | Cradle linear actuator 12 V, 10" (254 mm) stroke, 1500 N (330 lbf), self-locking | Spec: ~364 mm (14.3") retracted pin-to-pin +-10 mm, <= 10 mm/s, internal limits, PUSH to recline; worst case ~775 N each. Listing (checked 2026-10-08): 250 mm stroke, retracted 370 mm (within +-10), extended 620 mm, self-locking, built-in limits, 4 A, brackets + polarity switch included | Listing: "Fast Linear Motion Actuator 10mm/s 12V Linear Actuator, 10" Stroke 330lb (1500N) Heavy Duty Actuator" | Seat recline (2 per cradle) | 2 |  |  | $62.33 |  | Amazon.ca | https://www.amazon.ca/dp/B0FKMS7Y12 | https://www.amazon.ca/s?k=12v+linear+actuator+10+inch+stroke+330+lbs | 2026-10-08 | Verified amazon.ca price
Motion system: drive & locks | Pod linear actuator 12 V, 12" (300 mm) stroke, 1500 N (330 lbf), self-locking - ONE (left casing) | Spec: 420 mm retracted pin-to-pin (model uses 436 -> 706 mm of 420 -> 720), <= 10 mm/s, EXTEND to lower / RETRACT to raise; <= 561 N normally, 850 N if both struts fail (1.8x margin). Listing (checked 2026-10-10, CA$67.82): RVMARINEPAT LA03-12-300-1500N, 300 mm stroke, 420/720 mm, 10 mm/s, self-locking, built-in limits, 4 A, brackets + polarity switch; same family as the cradle actuators. Pick size "300-1500N" | Listing: "Electric Actuator 12V 12 Inch Stroke, 330lb Heavy Duty Linear Actuator Lift, High Speed Linear Actua" | Pod rotate up/down (single actuator + torque tube) | 1 |  |  | $67.82 |  | Amazon.ca | https://www.amazon.ca/dp/B0FKMVCQPC | https://www.amazon.ca/s?k=12v+linear+actuator+12+inch+stroke+330+lbs+1500N | 2026-10-08 | Verified amazon.ca price
Motion system: drive & locks | Gas struts (pair), ~250 mm extended, ~1050 N (235 lbf) each, M8 eye ends | SPEC: F1 ~1050 N (buy 1000-1100 N), ~240 mm extended, >= 71 mm stroke, 10 mm rod / 22-28 mm body, M8 eyelets (NOT 10 mm ball studs - only ~890 N rated). Sized so the pod is LIFT-biased (+16..+88 N m): an actuator failure sends it UP. Candidate (not verifiable today): YLLL 250 mm universal gas strut pair, 1000/1100 N, 8 mm eye hole, https://www.amazon.ca/dp/B09VDN2PX8 - price is an estimate | Pod counterbalance | 1 |  |  | $60.00 |  | Amazon.ca |  | https://www.amazon.ca/s?k=gas+strut+1000N+250mm+M8+eyelet+pair |  | No suitable listing found - estimate
Motion system: drive & locks | Steel angle brackets 50 x 50 x 5 mm with M8 hole | 2 strut anchors + 1 pod actuator anchor on the casings (heavy, not shelf brackets) | Strut + actuator anchors | 3 |  |  | $8.00 |  | Kent / Home Depot |  | https://kent.ca/en/search?q=heavy+steel+angle+bracket |  | Estimate - check in store
Motion system: drive & locks | Torque tube: 2" x 2" x 1/8" square steel tube (HSS / A500), 1600 mm | Ties the right cheek to the driven left cheek, behind the back sheet between the 2x4 stiffener rails. 298 N m/deg: 0.42 deg (6 mm at the chin) with both struts failed; 1.5 deg / 32 MPa if the actuator stalls against a right-side stop. Cut to length at the metal shop | Pod: one actuator drives both cheeks without racking | 1 |  |  | $45.00 |  | Local metal supplier |  | https://www.google.com/search?q=2x2x1%2F8+square+steel+tube+Fredericton+NB |  | Estimate - get a quote
Motion system: drive & locks | 6 mm steel plates 150 x 61 mm, 4 x 11 mm holes (2 welded tube end plates + 2 backing plates) | End plates welded square to the tube (or no-weld: 2 x 50x50x5 angles per end); backing plates on the outside of each cheek | Torque tube to cheeks | 4 |  |  | $10.00 |  | Local metal supplier |  | https://www.google.com/search?q=6mm+steel+plate+cut+to+size+welding+Fredericton+NB |  | Estimate - get a quote
Motion system: drive & locks | M10 x 70 bolts grade 8.8 + nylocks + washers | 4 per tube end through the 36 mm cheek + backing plate; 1 mm reamed holes, torque to spec | Torque tube to cheeks | 8 |  |  | $2.00 |  | Kent / Home Depot |  | https://kent.ca/en/search?q=m10+x+70+bolt+grade+8.8 |  | Estimate - check in store
Motion system: drive & locks | 6 mm steel latch plates with UP and DOWN notches | Laser cut / filed from cheek template drawing 06; bolted to the cheeks | Pod mechanical locks | 2 |  |  | $25.00 |  | Local metal supplier |  | https://www.google.com/search?q=laser+cutting+steel+plate+Fredericton+NB |  | Estimate - get a quote
Motion system: drive & locks | Spring-loaded steel pawl (barrel bolt / gate latch) | Engages the latch plates, one per casing | Listing: "PEAKTOW PTT0023 Heavy Duty 6-7/8” Metal Lock Barrel Bolt Spring Loaded Latch W/Hardware for Gate Doo" | Pod mechanical locks | 2 |  |  | $16.99 |  | Amazon.ca | https://www.amazon.ca/dp/B07GZHSCP6 | https://www.amazon.ca/s?k=spring+loaded+barrel+bolt+latch+heavy+duty | 2026-10-08 | Verified amazon.ca price
Motion system: drive & locks | Bowden cables + levers (bike brake lever set) | Release both pawls from the lever box left of dad's seat (second hand needed for pod motion) | Listing: "Glarks 8Pcs Bike Brake Set Including 2 Pairs Black V-Type Brakes, 1 Pair Handlebars Brake Levers, 2P" | Pod lock release | 1 |  |  | $23.99 |  | Amazon.ca | https://www.amazon.ca/dp/B0B8C66T4Q | https://www.amazon.ca/s?k=bicycle+brake+lever+cable+set | 2026-10-08 | Verified amazon.ca price
Motion system: drive & locks | Steel stop pins 12 mm (or 1/2" bolts) for hard stops | Pod UP / DOWN hard stops on the cheeks hitting steel angles | Pod hard stops | 4 |  |  | $4.00 |  | Kent / Home Depot |  | https://kent.ca/en/search?q=1%2F2+inch+clevis+pin |  | Estimate - check in store
Motion system: drive & locks | Rubber bumper / stop pads with screws (assorted) | Bumpers on the pod stop pins; cradle recline stop (10 mm) and upright stop (6 mm) pads | Listing: "Swpeet 52 Sets 3 Sizes 18mm & 24mm & 30mm Round Black Furniture Pads with Screws, Heavy Duty Rubber " | Hard stops | 1 |  |  | $17.99 |  | Amazon.ca | https://www.amazon.ca/dp/B0D1XSZ8SF | https://www.amazon.ca/s?k=rubber+bumper+pads+with+screws | 2026-10-08 | Verified amazon.ca price
Motion system: hardwired interlock | 12 V 20 A (240 W) enclosed power supply | BOM: 12 V 20 A, enclosed, mains fused. Only one motion runs at a time (cradle: 2 actuators in parallel, pod: 1 actuator) | Listing: "inShareplus 12V 20A 240W, DC Universal Regulated Switching Power Supply, Converter AC 100-240V to DC" | Actuator power | 1 |  |  | $33.99 |  | Amazon.ca | https://www.amazon.ca/dp/B07RJMG3FB | https://www.amazon.ca/s?k=12v+20a+power+supply+enclosed | 2026-10-08 | Verified amazon.ca price
Motion system: hardwired interlock | Inline ATC fuse holder 12 AWG with 20/30/40 A fuses | Use the 20 A blade fuse, right at the PSU | Listing: "DaierTek Inline Fuse Holder 12 AWG Waterproof ATC/ATO Blade Fuse Holder with 20 Amp 30 Amp 40 Amp In" | Actuator circuit fuse | 1 |  |  | $18.99 |  | Amazon.ca | https://www.amazon.ca/dp/B0BHY1RQQR | https://www.amazon.ca/s?k=12+awg+inline+atc+fuse+holder | 2026-10-08 | Verified amazon.ca price
Motion system: hardwired interlock | 19 mm key switch, 2 position (MOTION key) - drives a 30 A relay | Key out = no motion. Same part as MASTER POWER | Listing: "19mm 3/4" ON/OFF Rotary Key Switch, Metal Lock Switch with Kept Lock and Wired Lock (19mm 2 Position" | CMD_B MOTION key | 1 |  |  | $26.11 |  | Amazon.ca | https://www.amazon.ca/dp/B09M849WCK | https://www.amazon.ca/s?k=19mm+key+switch+2+position | 2026-10-08 | Verified amazon.ca price
Motion system: hardwired interlock | 22 mm mushroom E-stop, NC, latching, twist release | In series with the whole motion circuit | Listing: "uxcell 22mm NC N/C Red Mushroom Emergency Stop Push Button Switch 600V 10A Plastic Mounting" | CMD_B STOP | 1 |  |  | $16.24 |  | Amazon.ca | https://www.amazon.ca/dp/B019DSZWPC | https://www.amazon.ca/s?k=22mm+emergency+stop+nc | 2026-10-08 | Verified amazon.ca price
Motion system: hardwired interlock | DPDT (ON)-OFF-(ON) momentary toggle, 12 mm bushing | Hold-to-run FLT / BRD (CREW POS); relays carry the motor current. Check bushing/hole size | Listing: "Joinfworld Momentary Toggle Switch 12V DC 3 Way 30 Amp DPDT 6 Pin (ON)-Off-(ON) Waterproof Marine To" | CMD_B hold-to-run | 1 |  |  | $13.98 |  | Amazon.ca | https://www.amazon.ca/dp/B0C22K75FZ | https://www.amazon.ca/s?k=dpdt+momentary+toggle+on+off+on | 2026-10-08 | Verified amazon.ca price
Motion system: hardwired interlock | 12 V 30/40 A automotive relays SPDT 5-pin, 10 pcs | 5 needed: 4 as two H-bridges (cradle: 2 actuators in parallel; pod: the single actuator) + 1 for the key. Add relay sockets/harnesses | Listing: "10 Pcs 5-Pin Automotive Relays, 12V 30/40 A SPDT Relays, Electrical Relays Switch for Truck Marine B" | Motor switching | 1 |  |  | $22.99 |  | Amazon.ca | https://www.amazon.ca/dp/B0DNJVMMF9 | https://www.amazon.ca/s?k=12v+30a+relay+spdt+5+pin | 2026-10-08 | Verified amazon.ca price
Motion system: hardwired interlock | V-15 roller-lever micro switches 15 A, 10 pcs | 11 needed (8 motor-path limit/lock switches: CRADLE_UPRIGHT, CRADLE_RECLINED x2, ONE pod limit set POD_UP + POD_DOWN on the left/driven cheek only, POD_UP_LOCKED x2, lever switch; + 3 READ-ONLY position senses: cradle reclined, pod down-locked, pod up-locked) + printed limit_switch_mount; 2 packs = 20 | Listing: "10pcs Micro Switches V-156-1C25 15A 125/250VAC Hinge Roller Lever Switch" | Limit + lock switches | 2 |  |  | $16.69 |  | Amazon.ca | https://www.amazon.ca/dp/B0F8HJ4V9J | https://www.amazon.ca/s?k=v-156-1c25+roller+lever+micro+switch+15a | 2026-10-08 | Verified amazon.ca price
Motion system: hardwired interlock | 6A10 rectifier diodes (6 A, 1000 V), 20 pcs | 8 needed across the motor-path limit switches (frame BOM says 1N5408 3 A; 6A10 per electronics README is the stronger choice) | Listing: "(Pack of 20 Pieces) Chanzon 6A10 Rectifier Diode 6A 1000V R-6 Axial 6 Amp 1000 Volt Electronic Silic" | Limit switch drive-back diodes | 1 |  |  | $8.99 |  | Amazon.ca | https://www.amazon.ca/dp/B079KF3VJG | https://www.amazon.ca/s?k=6a10+diode | 2026-10-08 | Verified amazon.ca price
Motion system: hardwired interlock | Pressure-sensitive safety edge (NC), ~900 mm, with mounting profile | Along the pod chin, in series with "pod DOWN". Not found on amazon.ca - industrial / gate-operator supplier; price is a placeholder | Pod pinch protection | 1 |  |  | $150.00 |  | Industrial supplier |  | https://www.amazon.ca/s?k=pressure+sensitive+safety+edge+NC |  | Estimate - get a quote
Motion system: hardwired interlock | 14 AWG red/black 2-conductor wire, 15 m (50 ft) | 20 m needed -> 2 rolls. Use pure copper (not CCA) for motor current | Listing: "14 Gauge Electrical Wire 50FT, 14 AWG 2 Pin Red and Black Cable 12V" | Actuator power path | 2 |  |  | $17.09 |  | Amazon.ca | https://www.amazon.ca/dp/B0CXY76JGX | https://www.amazon.ca/s?k=14+awg+red+black+copper+wire+50+ft | 2026-10-08 | Verified amazon.ca price
Motion system: hardwired interlock | Heat-shrink ring terminal kit, 260 pcs (22-10 AWG) | Plus heat shrink; printed cable clips | Listing: "260PCS Heat Shrink Ring Connectors with Thicker Red Copper, AWG22-10 Waterproof Electrical Terminals" | Interlock wiring | 1 |  |  | $29.99 |  | Amazon.ca | https://www.amazon.ca/dp/B0B569WMNP | https://www.amazon.ca/s?k=heat+shrink+ring+terminal+kit | 2026-10-08 | Verified amazon.ca price
Motion system: guards | Strip brush 25 mm in aluminium holder, ~5 m | 4 m for the cheek slots (2 edges each) + 1 m for the nose-box actuator slots. Not found as a good match on amazon.ca; placeholder price | Slot guards | 1 |  |  | $60.00 |  | Amazon.ca |  | https://www.amazon.ca/s?k=strip+brush+aluminum+holder+25mm |  | No suitable listing found - estimate
Motion system: guards | High-density foam 25 mm (1") x 610 x 1830 mm | Pod chin (behind the safety edge) and pod lower edges; cover with the vinyl below | Listing: "FoamTouch High Density Upholstery Foam (1" x 24" x 72"), 1.79LB Density-45LB ILD, Made in USA – Idea" | Pod edge padding | 1 |  |  | $32.15 |  | Amazon.ca | https://www.amazon.ca/dp/B0DQXC46NQ | https://www.amazon.ca/s?k=high+density+foam+1+inch+24+x+72 | 2026-10-08 | Verified amazon.ca price
Seats & harnesses | Buckle kit: 25 mm side-release buckles + 9 m webbing (REDAPRIC) | REQUIRED LINK per design. WARNING: plastic (POM) luggage/backpack buckles, seller quotes ~50-136 kg breaking load, NOT safety-rated. Positioning harness only (see docs/mechanical/README.md safety note). Use the kit webbing for nothing structural. 2 kid seats x 4 buckles = 8 of 10. No featured offer on 2026-10-08 (other sellers only): price is a placeholder | Listing: "1 Inch 10 Yards Nylon Webbing Strap Kit with 10 Quick Release Side Buckles & 20 Tri-Glide Slides, No" | Kid 4-point harness + printed harness_hub | 1 |  |  | $13.00 |  | Amazon.ca | https://www.amazon.ca/dp/B0B3J1GCVQ | https://www.amazon.ca/s?k=1+inch+side+release+buckle+kit | 2026-10-08 | Link verified; price NOT shown (placeholder estimate)
Seats & harnesses | Rated 25 mm (1") webbing, >= 700 kg | BOM asks polyester >= 700 kg; this is 1" nylon tubular climbing webbing Listing: UIAA/CE certified, 17.8 kN (4000 lb). Choose the 10 yd length variant | Listing: "NewDoar 1 Inch Nylon Webbing Strap/Tubular Climbing Webbing - Heavy Duty Strap for Rescue, Climbing," | Kid harness straps (sewn bar-tack loops) | 1 |  |  | $19.99 |  | Amazon.ca | https://www.amazon.ca/dp/B0B7RHCFMV | https://www.amazon.ca/s?k=1+inch+rated+webbing+4000+lb+polyester | 2026-10-08 | Verified amazon.ca price
Seats & harnesses | Welded steel O-rings 50 mm (2") OD | Listing: 50 mm ID, 5 mm wire, 304 stainless, 6-pack, NOT load-rated (BOM asks 50 mm OD, 6 mm wire, rated - a rated welded ring from a rigging supplier is better) | Listing: "BEYOURD 2 inch Metal O Rings, Stainless Steel Round Ring Buckles, Solid Welded Metal Loop for Dog Co" | Harness hub load ring (2 needed) | 1 |  |  | $15.99 |  | Amazon.ca | https://www.amazon.ca/dp/B0D781P6JB | https://www.amazon.ca/s?k=welded+steel+o+ring+2+inch+heavy+duty | 2026-10-08 | Verified amazon.ca price
Seats & harnesses | Welded steel D-rings 25 mm (1") | Optional - you asked for D-rings; frame BOM v0.2 only uses the O-ring. Useful as strap adjust/anchor points | Listing: "BEYOURD Metal D Rings, Heavy Duty 304 Stainless Steel Welded Dee Rings" | Harness adjusters (optional) | 1 |  |  | $15.97 |  | Amazon.ca | https://www.amazon.ca/dp/B0CS9SL864 | https://www.amazon.ca/s?k=welded+steel+d+ring+1+inch | 2026-10-08 | Verified amazon.ca price
Seats & harnesses | 3/8" (M10) forged eye bolts + fender washers + nylocks | Forged, not bent-wire. Anchors THROUGH the cradle rails / seat-back frames, never plywood alone | Harness anchors | 10 |  |  | $6.00 |  | Kent / Home Depot |  | https://kent.ca/en/search?q=forged+eye+bolt+3%2F8 |  | Estimate - check in store
Seats & harnesses | 2-point adjustable lap belt | Dad: fixed seat, no recline | Listing: "Universal 2 Point Seat Belt - Adjustable Lap Replacement for Most Cars, Strap with Buckle, Safety Ca" | Commander seat | 1 |  |  | $24.99 |  | Amazon.ca | https://www.amazon.ca/dp/B0BFPZ5ZGW | https://www.amazon.ca/s?k=2+point+lap+belt+adjustable | 2026-10-08 | Verified amazon.ca price
Seats & harnesses | High-density upholstery foam 50 mm (2") x 610 x 1830 mm | Cushions: kids 340 x 380, dad 520 x 480; offcut stacked as the 60-80 mm booster for the 6 yr | Listing: "AK TRADING CO. AK-Trading Upholstery High Density 2" Height x 24" Width x 72" Length-Home or Commerc" | Seat cushions | 1 |  |  | $54.54 |  | Amazon.ca | https://www.amazon.ca/dp/B078SJ86G7 | https://www.amazon.ca/s?k=high+density+foam+2+inch+24+x+72 | 2026-10-08 | Verified amazon.ca price
Seats & harnesses | Marine vinyl, black, 1.5 m x 1.37 m (5 ft x 54") | Covers for 3 cushions + pod chin foam | Listing: "VViViD Black Weatherproof Faux Leather Finish Marine Vinyl Fabric - 5ft x 54 Inch" | Upholstery | 1 |  |  | $43.69 |  | Amazon.ca | https://www.amazon.ca/dp/B0744QFFS8 | https://www.amazon.ca/s?k=marine+vinyl+fabric+black | 2026-10-08 | Verified amazon.ca price
Seats & harnesses - ALTERNATIVE (not in totals) | ALTERNATIVE: complete 4-point harness, 50 mm (2") straps, metal buckle | Instead of the DIY buckle-kit harness: a bought go-kart/sim 4-point harness with metal latch (frame BOM v0.1 recommendation). Check it fits a kid (6-12 yr) torso. Excluded from Grand total and Amazon cart | Listing: "RASTP 4 Point Racing Safety Harness Set with 2" Straps for Racing Seat&Go Kart Seat,Dark Red(Pack of" | Kid seats (instead of buckle kit + webbing + O-rings) | 2 |  |  | $55.99 |  | Amazon.ca | https://www.amazon.ca/dp/B08TB7NLJB | https://www.amazon.ca/s?k=4+point+harness+metal+buckle+2+inch | 2026-10-08 | Verified amazon.ca price

Sheet: Summary
Category | Lines | Lines still to buy | Total to buy CAD
Computer & displays (owned)
Video & USB cabling
Controllers & logic
Panel controls
LED backlighting
Printed parts: filament & inserts
Frame lumber & sheet goods
Fasteners & general hardware
Motion system: pivots, shafts, bearings
Motion system: drive & locks
Motion system: hardwired interlock
Motion system: guards
Seats & harnesses
Seats & harnesses - ALTERNATIVE (not in totals)
GRAND TOTAL to buy (excl. ALTERNATIVE rows)
of which Amazon.ca
of which Kent / Home Depot
of which local / industrial suppliers
of which based on VERIFIED prices (amazon.ca / kent.ca)
of which ESTIMATES / placeholders
ALTERNATIVE rated harness option (if chosen)
Totals update automatically when you change "Have it" on the BOM sheet (TRUE = already owned -> Qty to buy 0).
Prices are before tax/shipping (NB HST 15 %). Amazon prices change daily; dates are in the BOM sheet.

Sheet: Amazon cart
# | Item | Qty to buy | Unit price CAD | Line total | Link | Search link | Lists only Amazon.ca rows with Qty to buy > 0 (alternatives excluded). Built with INDEX/MATCH on a hidden helper column (BOM!O) so it works in every LibreOffice and Excel version (FILTER needs LO 24.8+/Excel 365). Updates when Have it changes.
 | Amazon cart total

Sheet: Notes
The Filament Falcon - BOM notes (built 2026-10-09, Atlantic time ADT/AST; location Fredericton, NB)
Sources: filament-falcon/docs/SPEC.md; ff-fw/docs/electronics/README.md; filament-falcon (branch pod-single, frame v0.3 single pod actuator): frame/BOM.md v0.3, frame/cut_list.md, docs/mechanical/README.md, switch_bom.md, displays.md.
Filament method: python trimesh volume V and surface area A of every 3MF (panels: black panel object + white letters object, including the backing boxes; printed parts x quantities from docs/mechanical/README.md). Printed volume = shell + infill x (V - shell), shell = min(V, A x 1.2 mm) (3 perimeters x 0.4 mm, also used as top/bottom skin proxy); infill 25 % (monitor standoffs 50 %, harness hub 45 %). PETG 1.27 g/cm3, +15 % for purge/brim/failed prints.
Filament result: black 3601 cm3 -> 5.26 kg (buy 6 x 1 kg); white 44 cm3 -> 0.06 kg (buy 1 x 1 kg). Red/grey parts (guard lids, throttle grip, gear arm, adapter plates) are counted in black - print them in red/grey if you have it. PLA would need ~2 % less mass, but PETG is required for the harness hub and recommended everywhere.
Prices: "Verified amazon.ca price" = read from the amazon.ca product page on 2026-10-08 (buy-box price, CAD, before tax). Kent prices were read from kent.ca on 2026-10-09 with the Fredericton store selected (Fredericton South, 809 Bishop Dr, and Fredericton North, 25 Two Nations Crossing showed identical prices); they can change, check before buying. Local metal-supplier rows have Google search links for Fredericton NB. Rows marked Estimate/placeholder are NOT verified prices.
Motion system (v0.3, branch pod-single): 2 cradle actuators 10"/1500 N (~364 mm retracted, self-locking); ONE pod actuator 12"/1500 N self-locking (420 mm retracted, left casing) driving both pod cheeks through a 2x2x1/8" steel torque tube; 2 gas struts ~1050 N with M8 eye ends, sized so the pod is lift-biased (actuator or clevis-pin failure sends it UP, never down); 25 mm shafts, UCP205/UCF205/SHF25; spring pawls + latch plates + Bowden release; steel hard stops; key, E-stop, 20 A fuse, hold-to-run DPDT, relays as 2 H-bridges, one pod limit set (left cheek), roller limit switches, safety edge. Check actuator retracted length and self-locking before ordering.
SAFETY: the B0B3J1GCVQ buckles are plastic luggage buckles (~50 kg quoted break load, not safety-rated). Positioning harness only for a slow reclining seat. A rated metal-buckle 4-point harness is listed as an ALTERNATIVE row (excluded from totals; switch if you prefer).
Displays: GPU DP1 -> C275B, HDMI -> C275W (HDMI/VGA only), DP2 -> DP-to-DVI-D -> TD2220 (VGA/DVI only), USB-A -> USB-B for touch. GPU USB-C is spare (4th display max).
Owned items: PC, both Sceptres, TD2220, 3 HY300, 2 joysticks have Have it = TRUE. Buttons/switches/LEDs you may own are FALSE - tick them.
