whyvas/filament-falcon/cad/export/png/parts/cable_clips.png

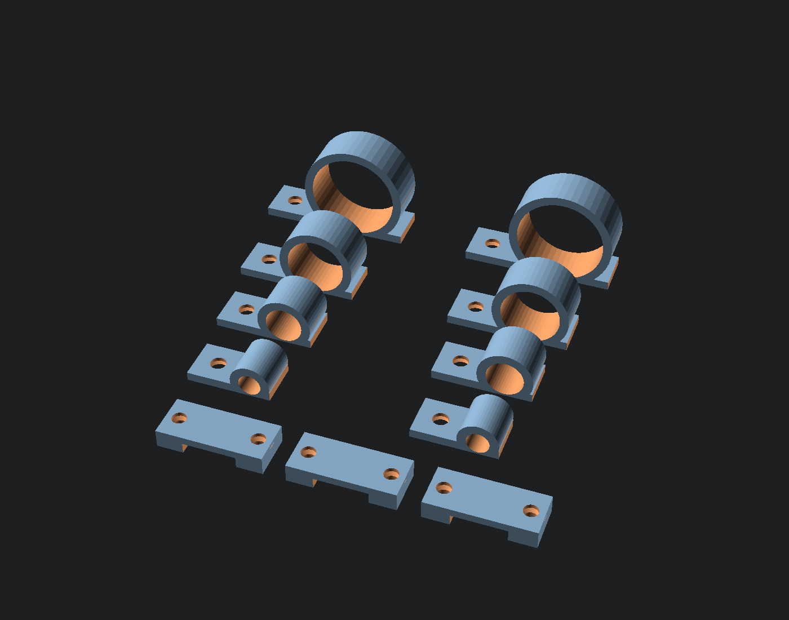
cad/export/png/parts/cable_clips.png
