whyvas/filament-falcon/cad/export/png/parts/engage_button_collar.png

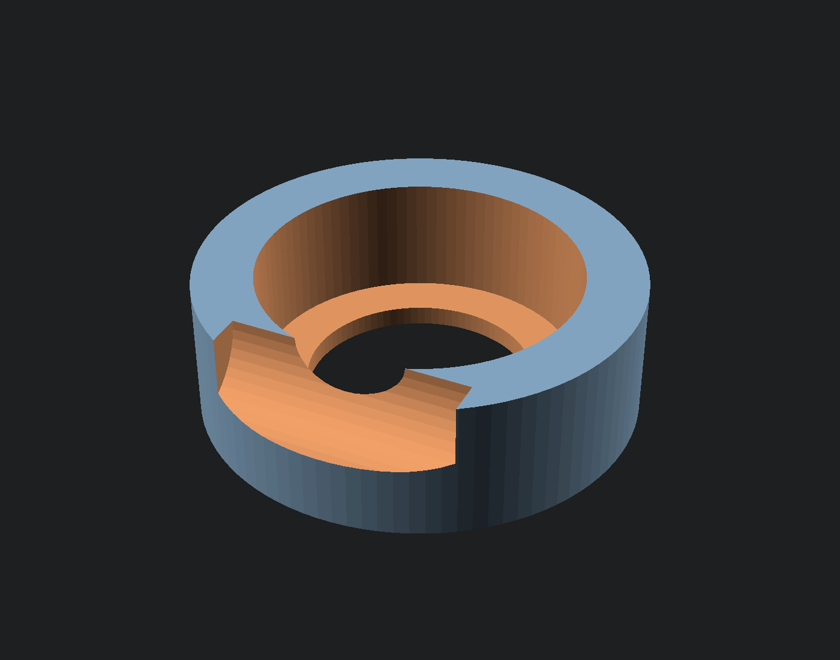
cad/export/png/parts/engage_button_collar.png
