whyvas/filament-falcon/cad/export/png/parts/esp32_enclosure.png

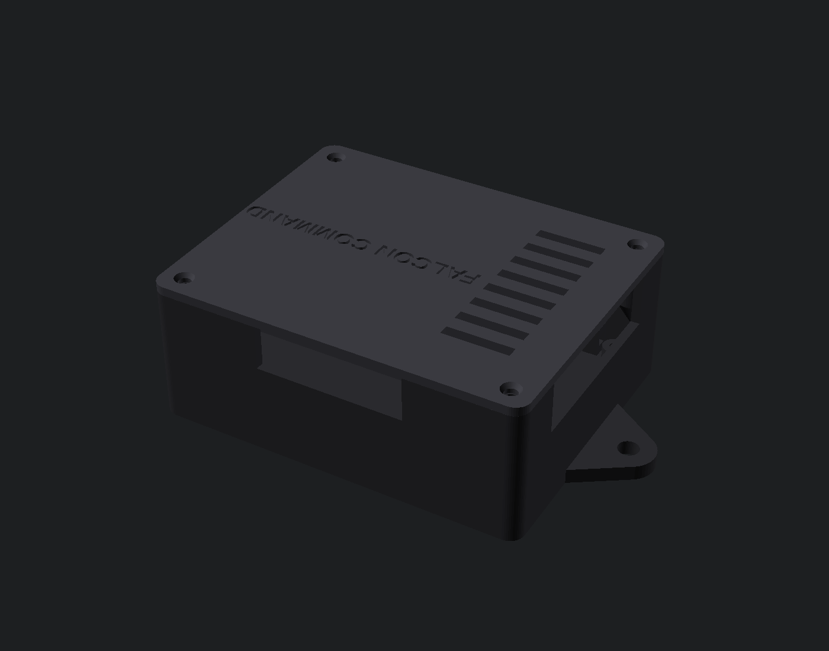
cad/export/png/parts/esp32_enclosure.png
