whyvas/filament-falcon/cad/export/png/parts/gear_lever.png

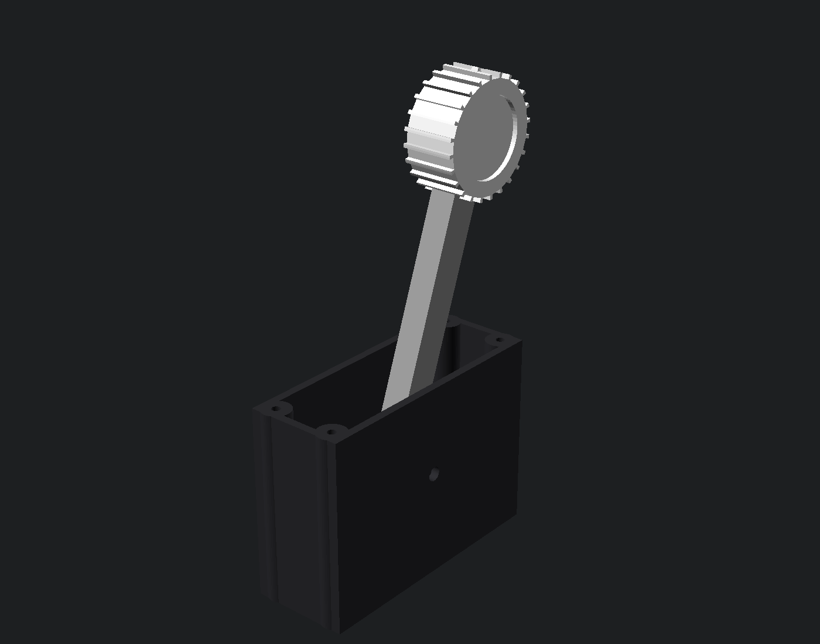
cad/export/png/parts/gear_lever.png
