whyvas/filament-falcon/cad/export/png/parts/harness_hub.png

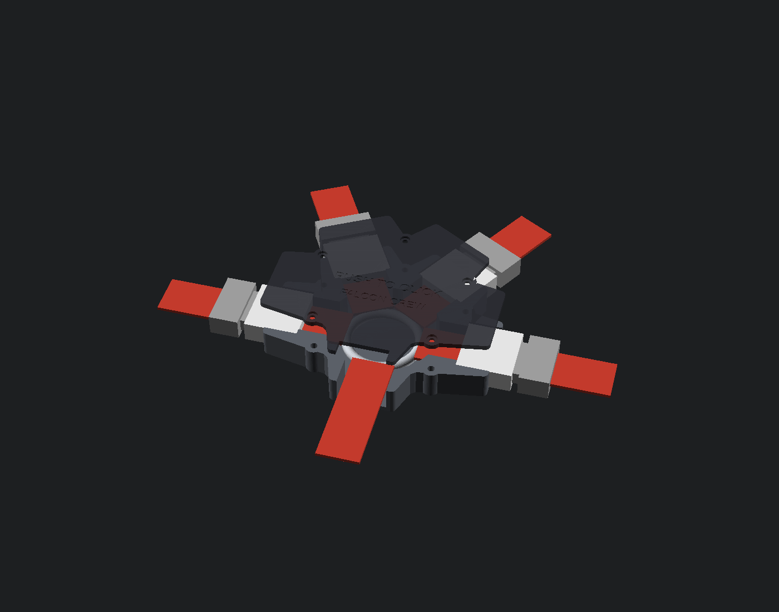
cad/export/png/parts/harness_hub.png
