whyvas/filament-falcon/cad/export/png/parts/harness_hub_base_only.png

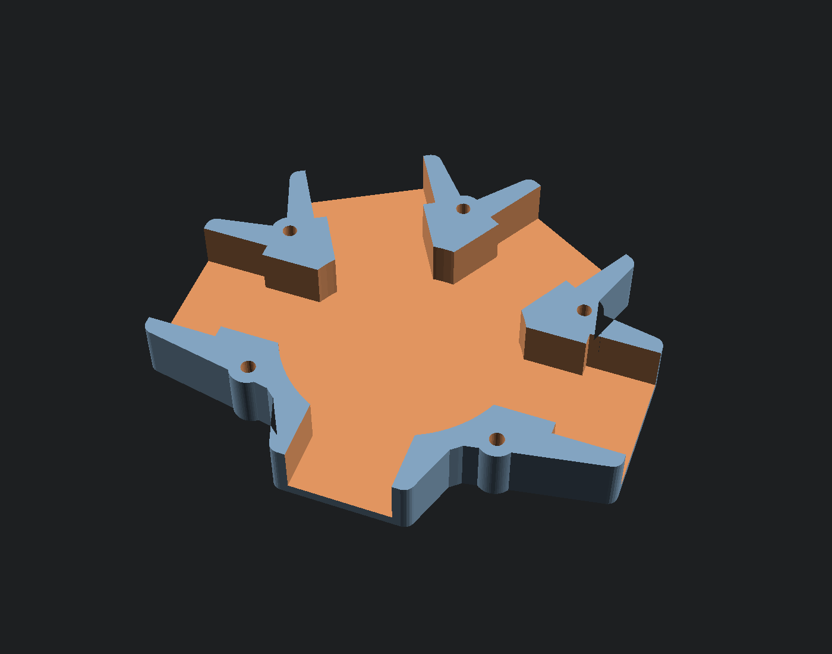
cad/export/png/parts/harness_hub_base_only.png
