whyvas/filament-falcon/cad/export/png/parts/joystick_housing.png

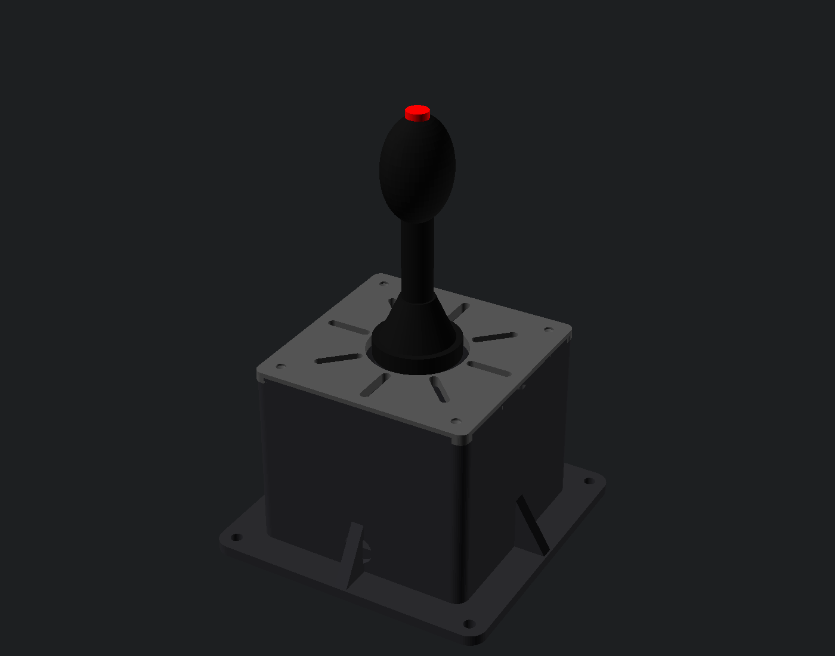
cad/export/png/parts/joystick_housing.png
