whyvas/filament-falcon/cad/export/png/parts/limit_switch_mount.png

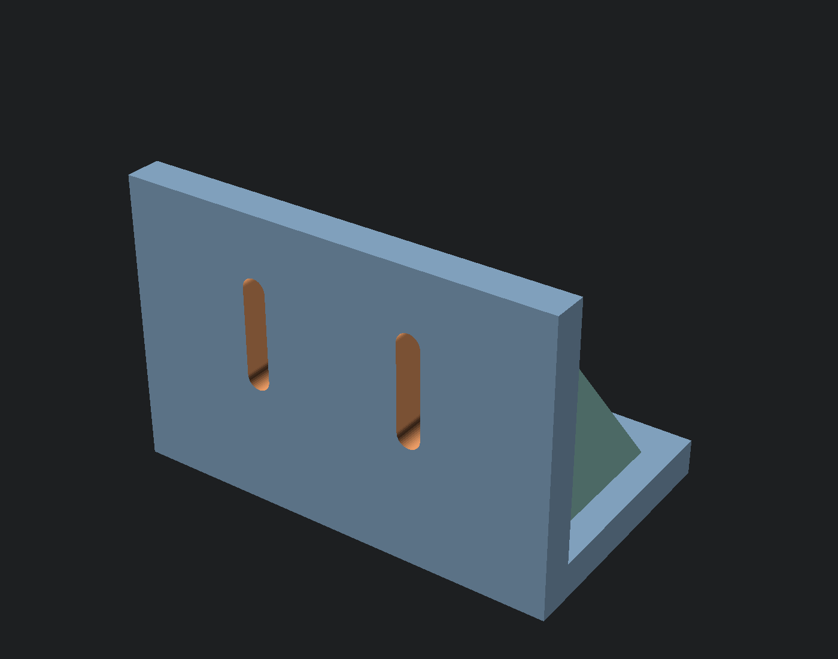
cad/export/png/parts/limit_switch_mount.png
