whyvas/filament-falcon/cad/export/png/parts/monitor_mount.png

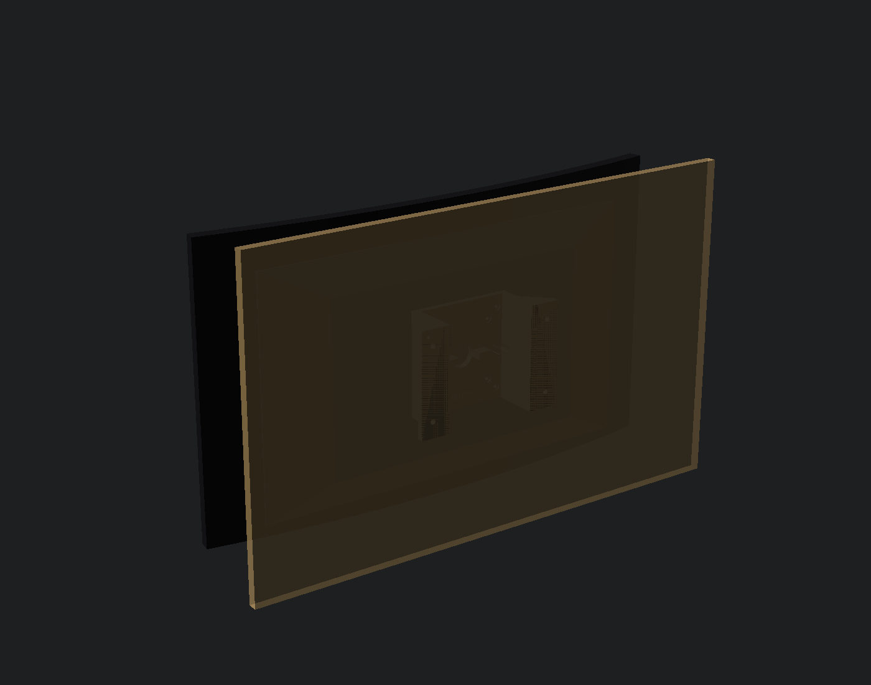
cad/export/png/parts/monitor_mount.png
