whyvas/filament-falcon/cad/export/png/parts/pivot_cable_clamp.png

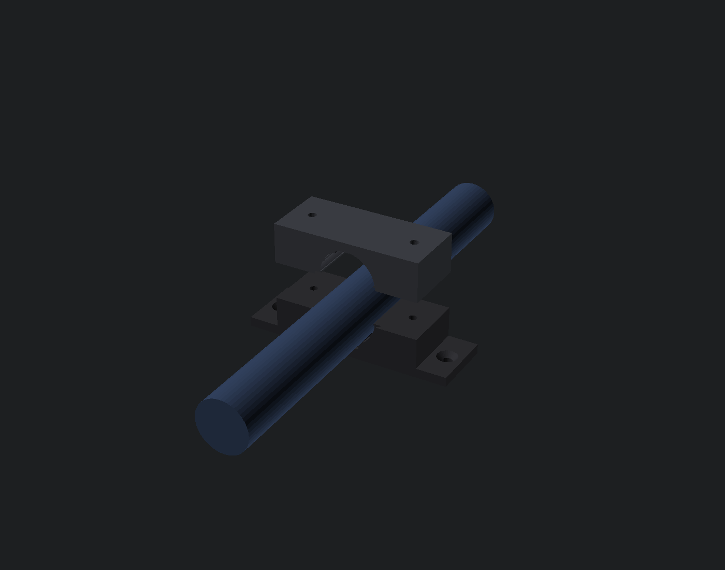
cad/export/png/parts/pivot_cable_clamp.png
