whyvas/filament-falcon/cad/export/png/parts/throttle_quadrant.png

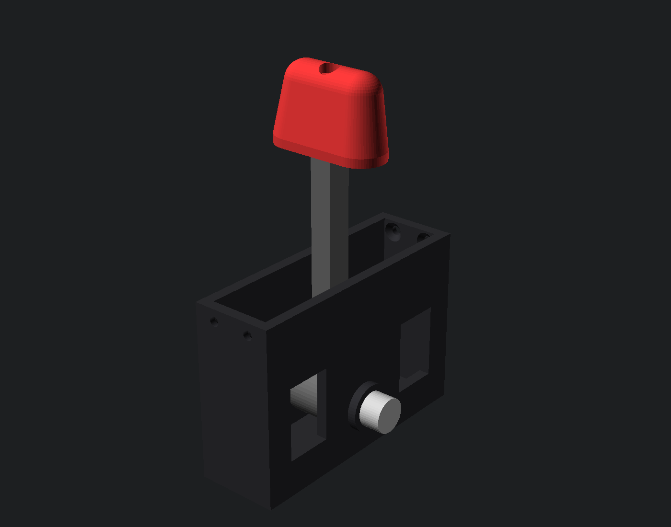
cad/export/png/parts/throttle_quadrant.png
