whyvas/filament-falcon/cad/export/png/parts/toggle_guard.png

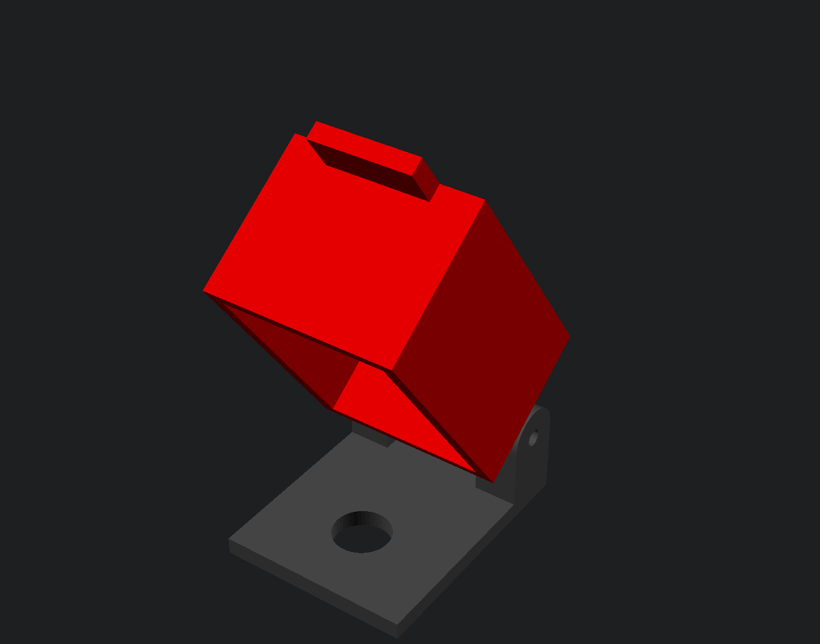
cad/export/png/parts/toggle_guard.png
