whyvas/filament-falcon/cad/export/png/parts/touchscreen_bezel.png

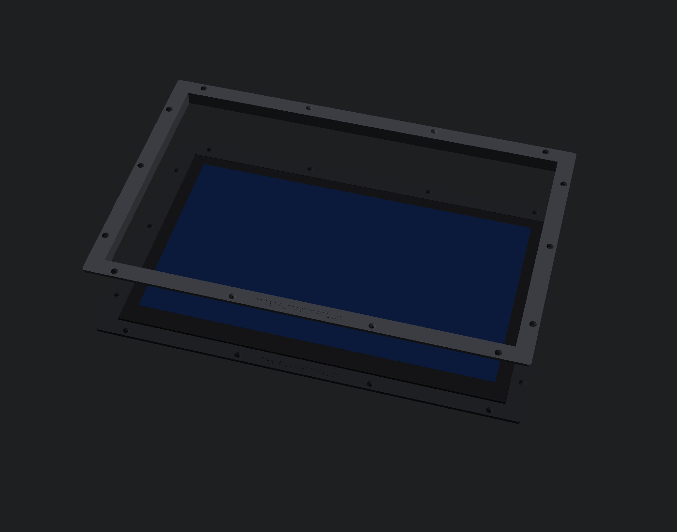
cad/export/png/parts/touchscreen_bezel.png
