whyvas/filament-falcon/cad/export/3mf/parts/pivot_cable_clamp_base.3mf

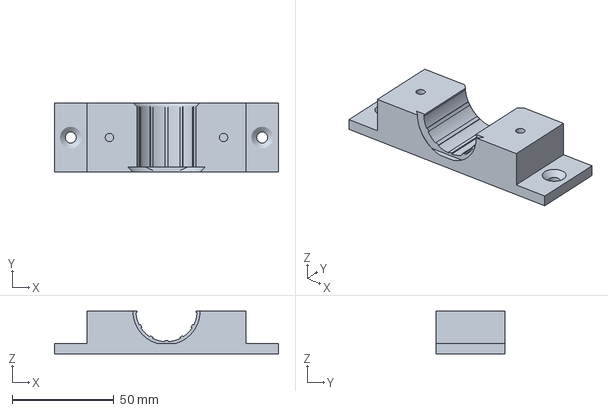
[picture p199: CAD file, 2026-10-14]
cad/export/3mf/parts/pivot_cable_clamp_base.3mf
110.0 x 34.0 x 21.0 mm
