whyvas/filament-falcon/cad/export/3mf/panels/OVERHEAD_B.3mf

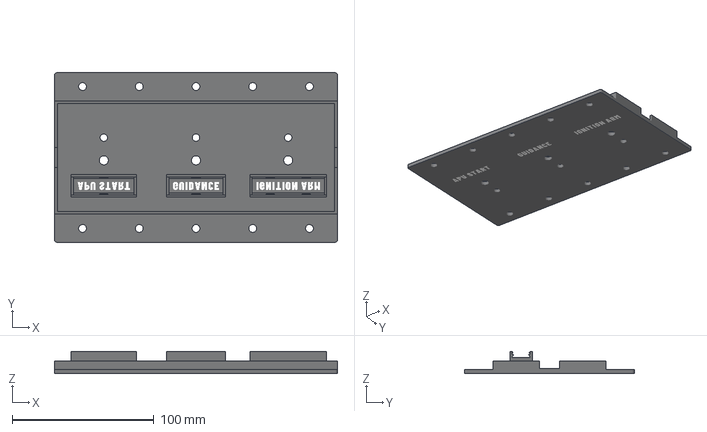
[picture p200: CAD file, 2026-10-14]
cad/export/3mf/panels/OVERHEAD_B.3mf
199.5 x 119.5 x 15.8 mm
