whyvas/filament-falcon/cad/export/3mf/parts/toggle_guard_base.3mf

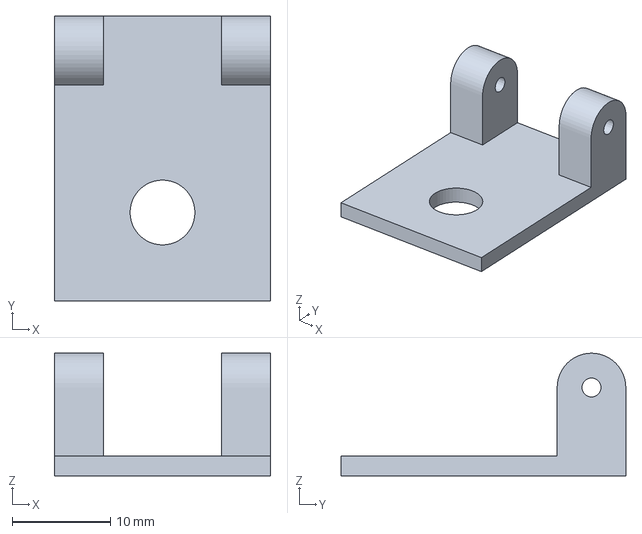
[picture p201: CAD file, 2026-10-14]
cad/export/3mf/parts/toggle_guard_base.3mf
22.0 x 29.0 x 12.5 mm
