whyvas/filament-falcon/cad/export/3mf/panels/PILOT_DASH_B.3mf

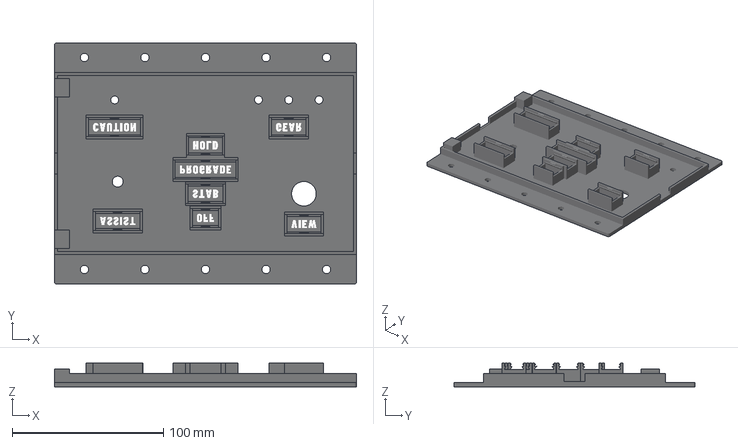
[picture p202: CAD file, 2026-10-14]
cad/export/3mf/panels/PILOT_DASH_B.3mf
199.5 x 159.5 x 15.8 mm
