whyvas/filament-falcon/cad/export/3mf/parts/gear_lever_wheel_knob.3mf

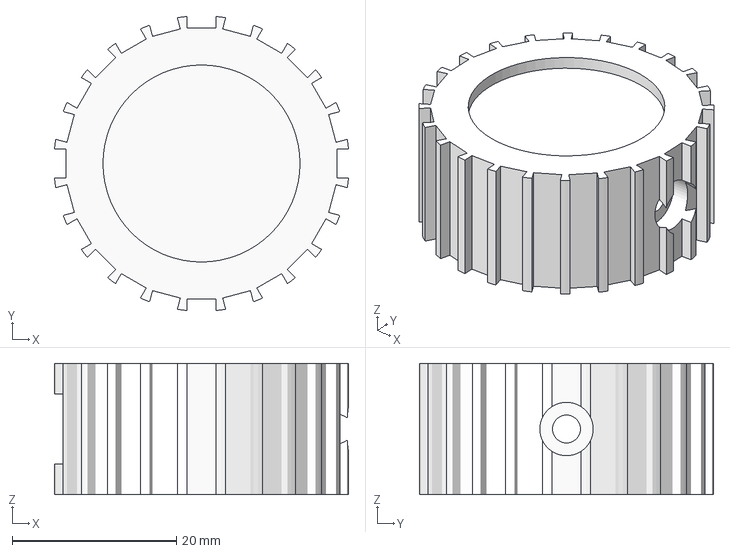
[picture p203: CAD file, 2026-10-14]
cad/export/3mf/parts/gear_lever_wheel_knob.3mf
35.8 x 35.8 x 16.0 mm
