whyvas/filament-falcon/cad/export/3mf/panels/PILOT_SIDE.3mf

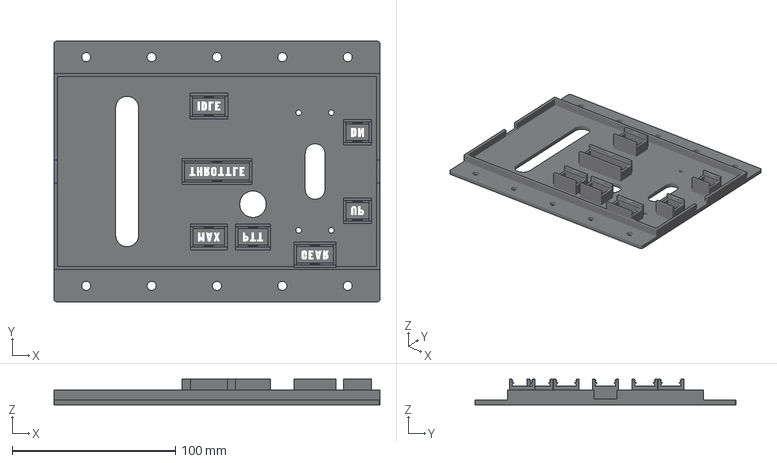
[picture p204: CAD file, 2026-10-14]
cad/export/3mf/panels/PILOT_SIDE.3mf
199.5 x 159.5 x 15.8 mm
