whyvas/filament-falcon/cad/export/3mf/parts/throttle_housing.3mf

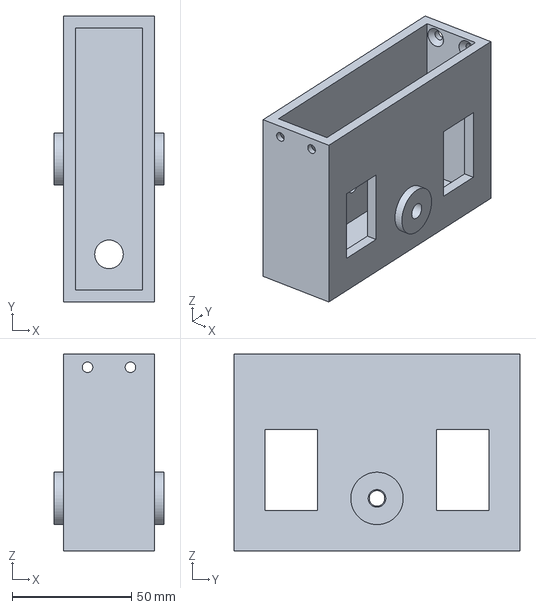
[picture p205: CAD file, 2026-10-14]
cad/export/3mf/parts/throttle_housing.3mf
46.0 x 120.0 x 82.5 mm
