whyvas/filament-falcon/cad/export/3mf/parts/engage_button_collar.3mf

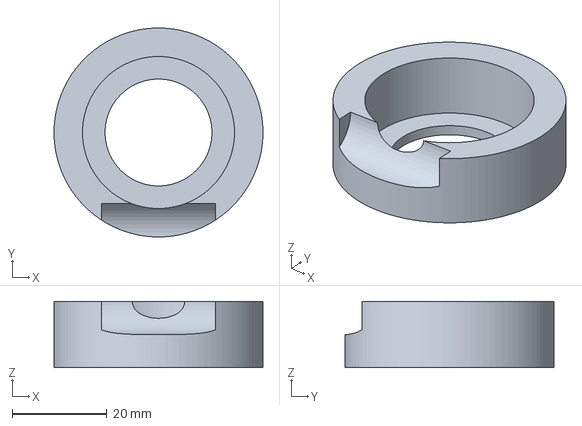
[picture p206: CAD file, 2026-10-14]
cad/export/3mf/parts/engage_button_collar.3mf
44.0 x 44.0 x 14.0 mm
