whyvas/filament-falcon/cad/export/3mf/parts/throttle_grip.3mf

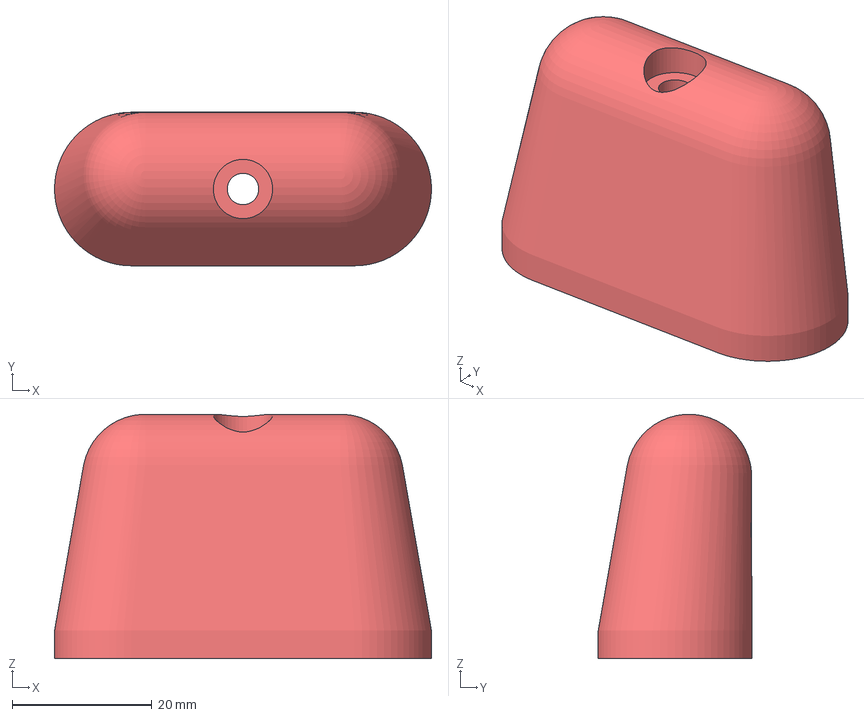
[picture p208: CAD file, 2026-10-14]
cad/export/3mf/parts/throttle_grip.3mf
54.0 x 22.0 x 35.0 mm
