whyvas/filament-falcon/cad/export/3mf/panels/OVERHEAD_A.3mf

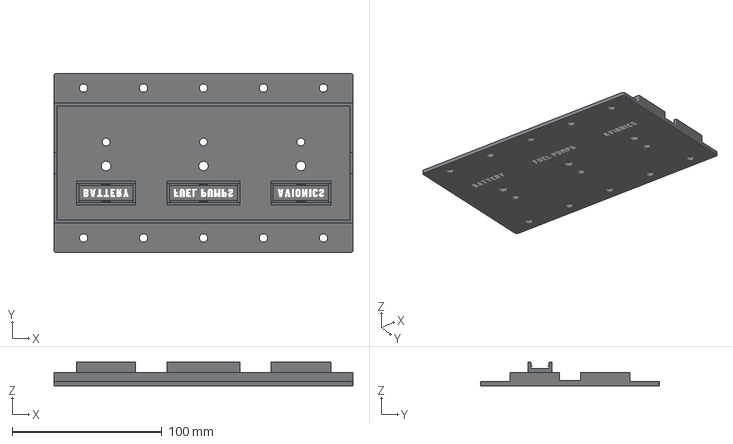
[picture p209: CAD file, 2026-10-14]
cad/export/3mf/panels/OVERHEAD_A.3mf
199.5 x 119.5 x 15.8 mm
