whyvas/filament-falcon/cad/export/3mf/parts/td2220_trim_middle_front.3mf

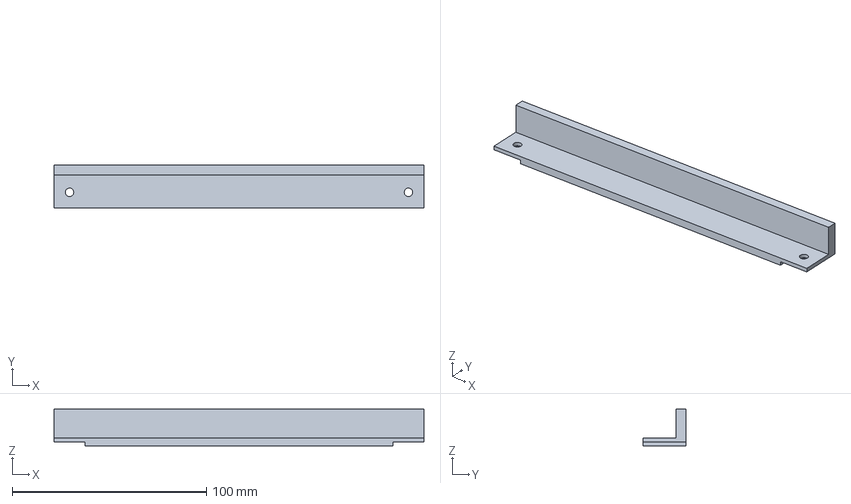
[picture p210: CAD file, 2026-10-14]
cad/export/3mf/parts/td2220_trim_middle_front.3mf
190.5 x 22.0 x 19.0 mm
