whyvas/filament-falcon/cad/export/3mf/parts/monitor_standoff_C275B_vesa100.3mf

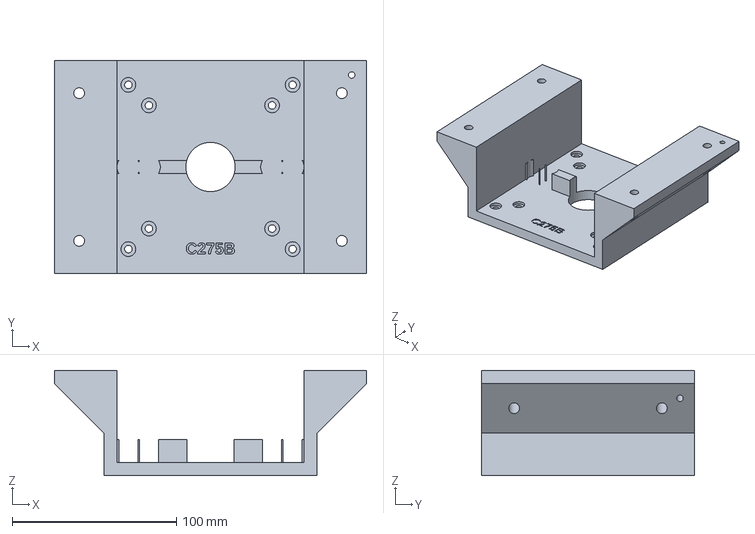
[picture p212: CAD file, 2026-10-14]
cad/export/3mf/parts/monitor_standoff_C275B_vesa100.3mf
190.0 x 130.0 x 64.0 mm
