whyvas/filament-falcon/cad/export/3mf/panels/CMD_A.3mf

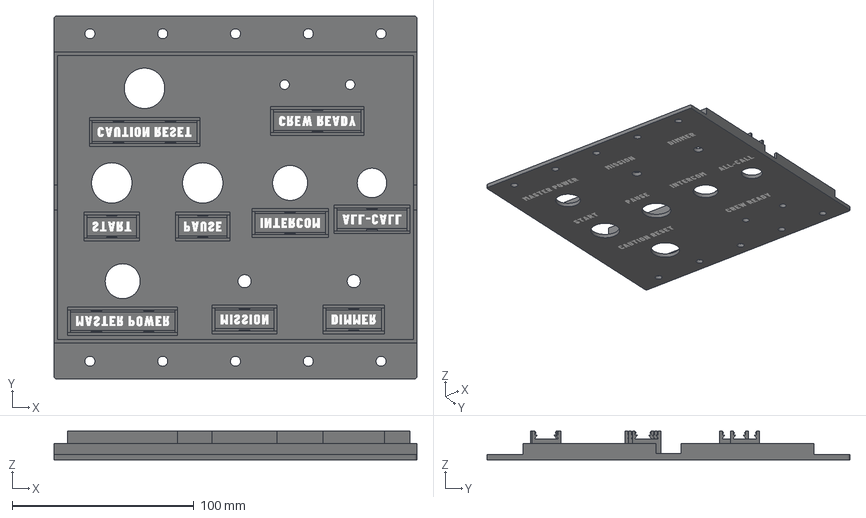
[picture p213: CAD file, 2026-10-14]
cad/export/3mf/panels/CMD_A.3mf
199.5 x 199.5 x 15.8 mm
