whyvas/filament-falcon/cad/export/3mf/parts/harness_hub_base.3mf

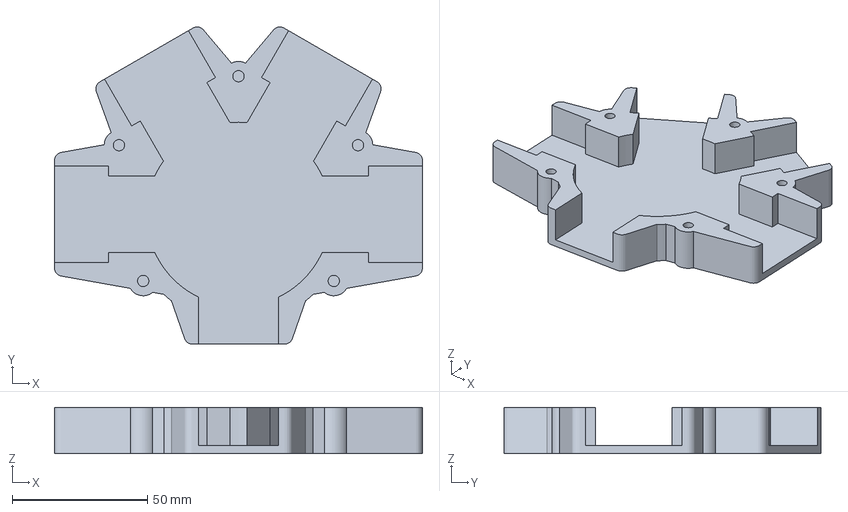
[picture p214: CAD file, 2026-10-14]
cad/export/3mf/parts/harness_hub_base.3mf
136.0 x 117.2 x 17.0 mm
