whyvas/filament-falcon/cad/export/3mf/parts/td2220_trim_corner_front_right.3mf

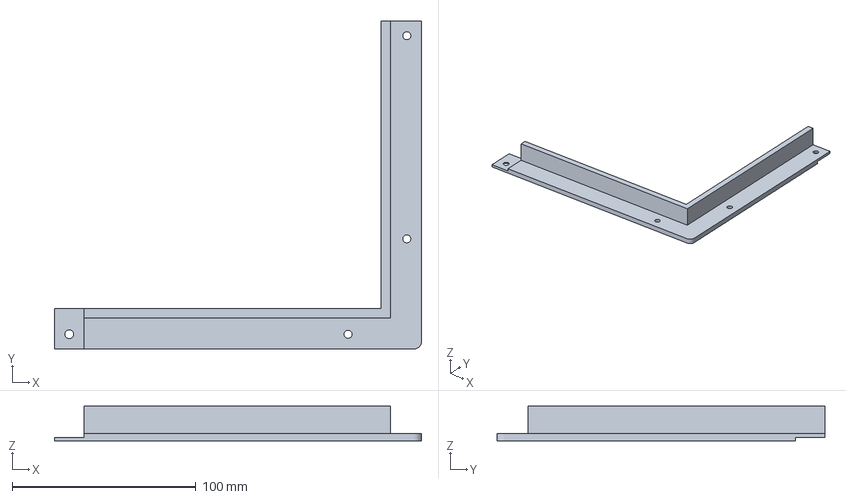
[picture p216: CAD file, 2026-10-14]
cad/export/3mf/parts/td2220_trim_corner_front_right.3mf
200.0 x 178.7 x 19.0 mm
