whyvas/filament-falcon/cad/export/3mf/parts/gear_lever_box.3mf

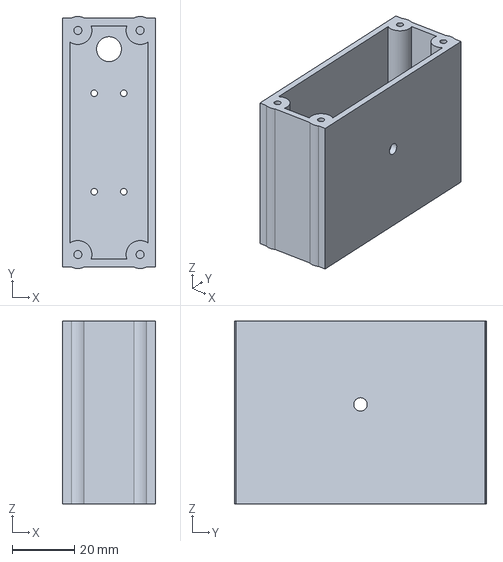
[picture p218: CAD file, 2026-10-14]
cad/export/3mf/parts/gear_lever_box.3mf
30.0 x 81.0 x 58.8 mm
