whyvas/filament-falcon/cad/export/3mf/parts/monitor_standoff_C275W_vesa75.3mf

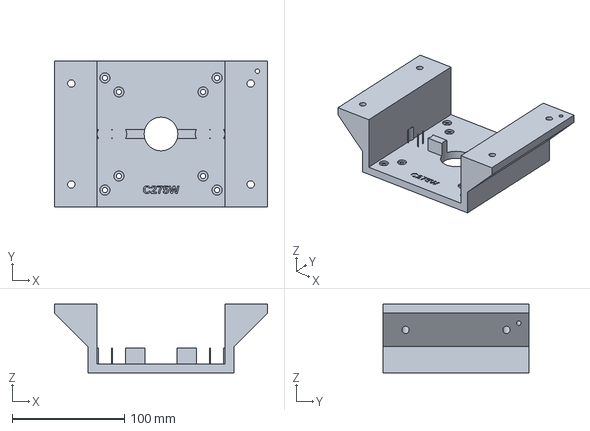
[picture p219: CAD file, 2026-10-14]
cad/export/3mf/parts/monitor_standoff_C275W_vesa75.3mf
190.0 x 130.0 x 61.4 mm
