whyvas/filament-falcon/cad/export/3mf/parts/esp32_enclosure_lid_COMMAND.3mf

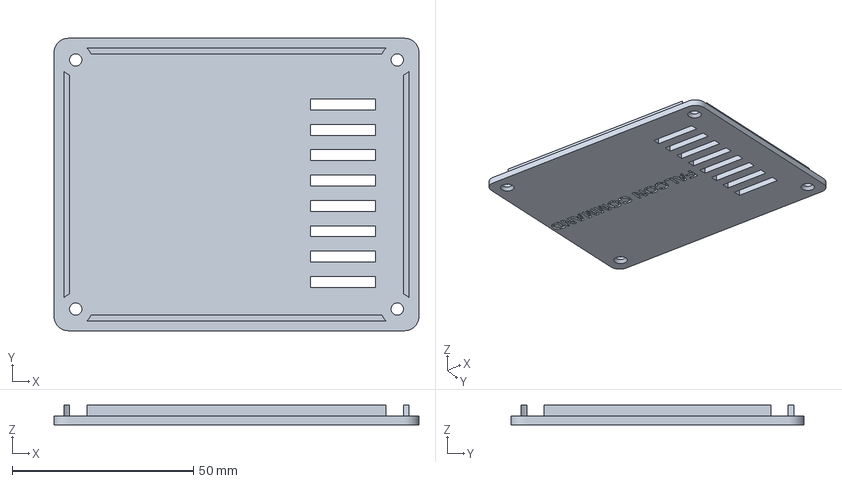
[picture p220: CAD file, 2026-10-14]
cad/export/3mf/parts/esp32_enclosure_lid_COMMAND.3mf
100.8 x 80.8 x 5.39 mm
