whyvas/filament-falcon/cad/export/3mf/parts/harness_hub_lid.3mf

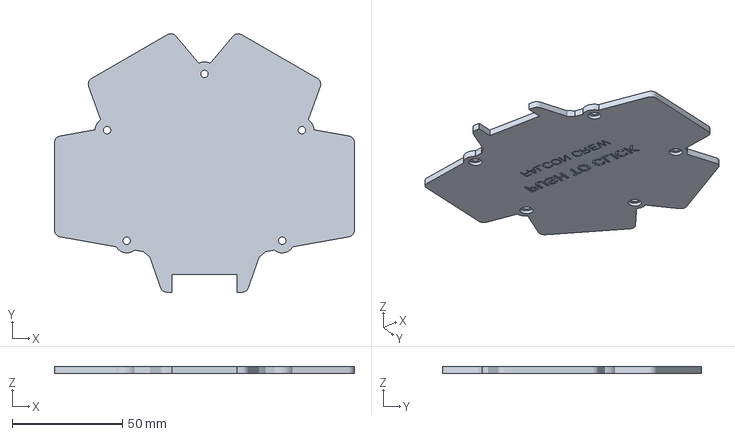
[picture p221: CAD file, 2026-10-14]
cad/export/3mf/parts/harness_hub_lid.3mf
136.0 x 117.2 x 3.00 mm
