whyvas/filament-falcon/cad/export/3mf/parts/limit_switch_mount.3mf

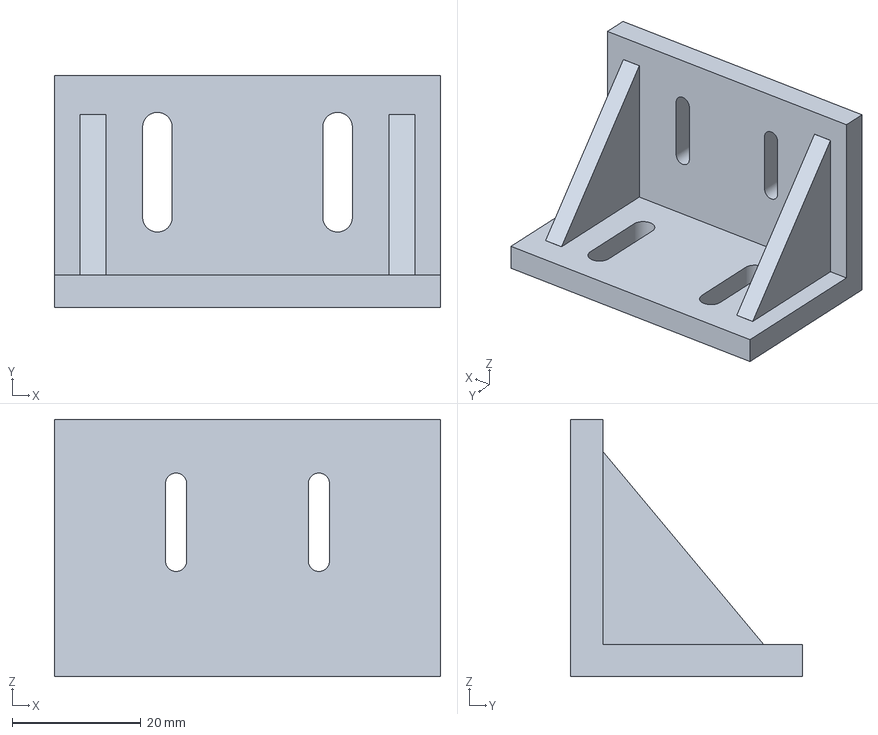
[picture p222: CAD file, 2026-10-14]
cad/export/3mf/parts/limit_switch_mount.3mf
60.0 x 36.0 x 40.0 mm
