whyvas/filament-falcon/cad/export/3mf/parts/td2220_trim_corner_rear_left.3mf

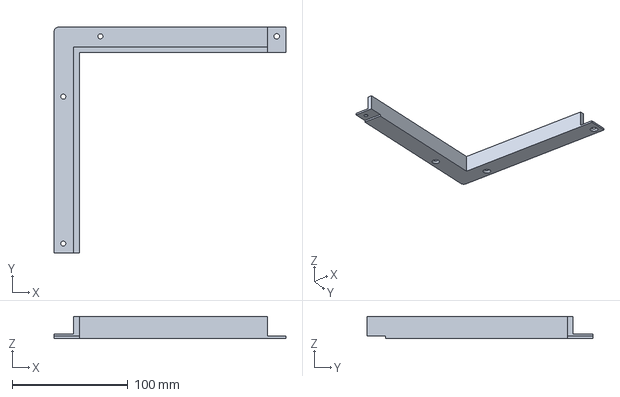
[picture p223: CAD file, 2026-10-14]
cad/export/3mf/parts/td2220_trim_corner_rear_left.3mf
200.0 x 194.7 x 19.0 mm
