whyvas/filament-falcon/cad/export/3mf/parts/pivot_cable_clamp_cap.3mf

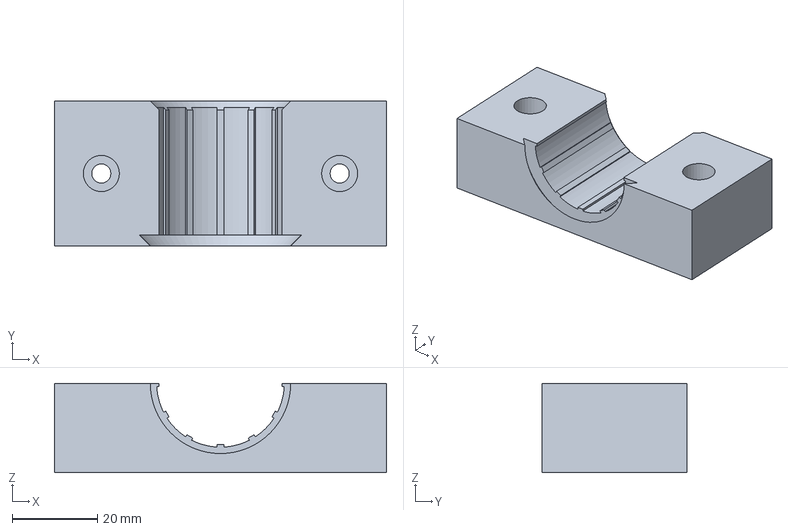
[picture p224: CAD file, 2026-10-14]
cad/export/3mf/parts/pivot_cable_clamp_cap.3mf
78.0 x 34.0 x 21.0 mm
