whyvas/filament-falcon/cad/export/3mf/parts/throttle_lever.3mf

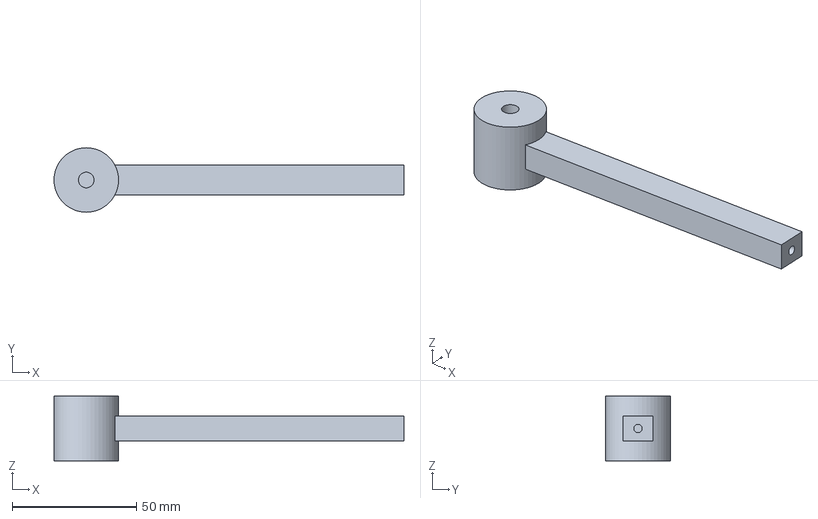
[picture p225: CAD file, 2026-10-14]
cad/export/3mf/parts/throttle_lever.3mf
141.0 x 26.0 x 26.0 mm
