whyvas/filament-falcon/cad/export/3mf/parts/gear_lever_arm.3mf

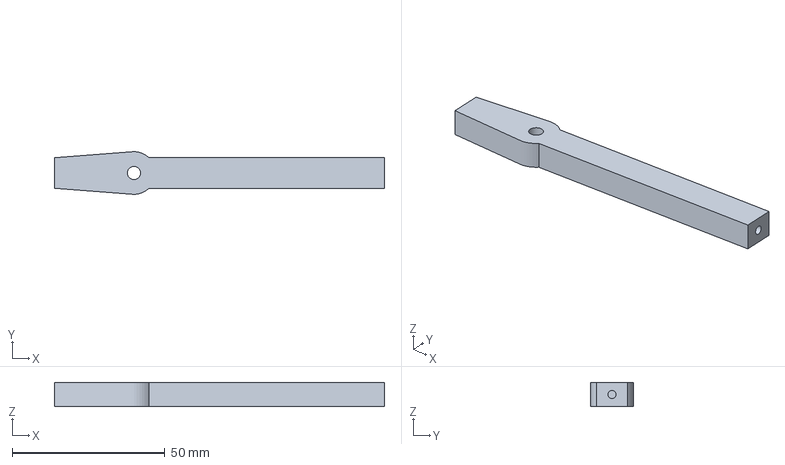
[picture p226: CAD file, 2026-10-14]
cad/export/3mf/parts/gear_lever_arm.3mf
108.0 x 14.0 x 8.00 mm
