whyvas/filament-falcon/cad/export/3mf/parts/td2220_vesa100_riser.3mf

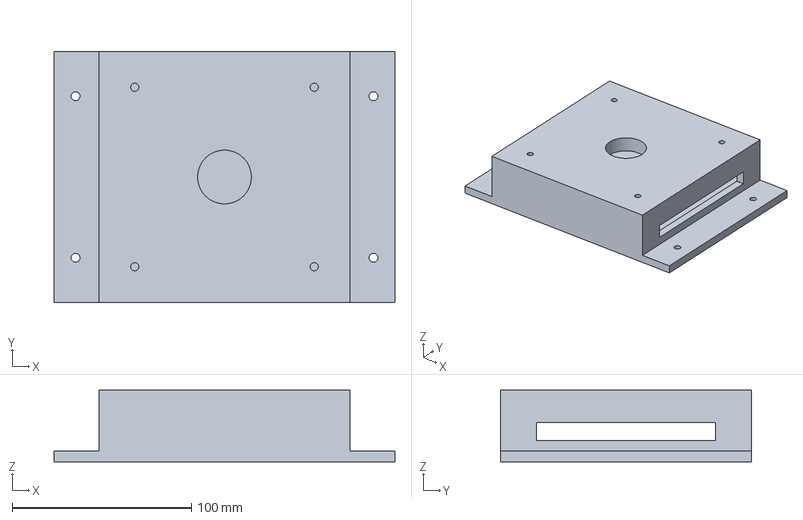
[picture p227: CAD file, 2026-10-14]
cad/export/3mf/parts/td2220_vesa100_riser.3mf
190.0 x 140.0 x 40.0 mm
