whyvas/filament-falcon/cad/export/3mf/parts/td2220_trim_middle_rear.3mf

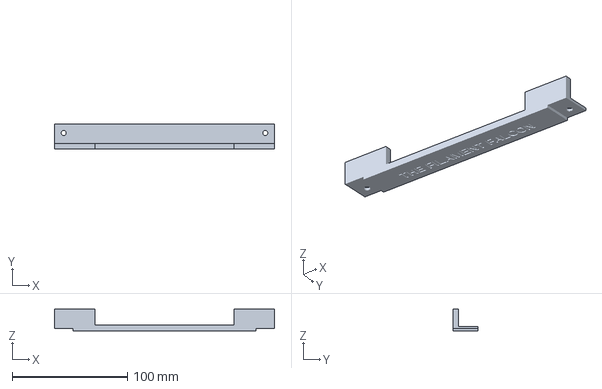
[picture p229: CAD file, 2026-10-14]
cad/export/3mf/parts/td2220_trim_middle_rear.3mf
190.5 x 22.0 x 19.0 mm
