whyvas/filament-falcon/cad/export/3mf/parts/alignment_pins_x8.3mf

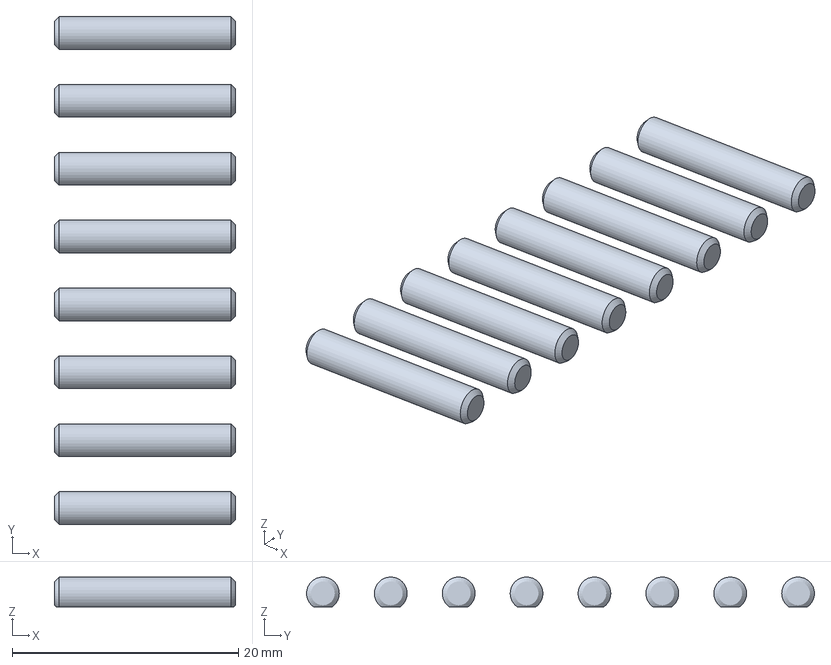
[picture p230: CAD file, 2026-10-14]
cad/export/3mf/parts/alignment_pins_x8.3mf
16.0 x 44.9 x 2.65 mm
