whyvas/filament-falcon/cad/export/3mf/parts/esp32_enclosure_base.3mf

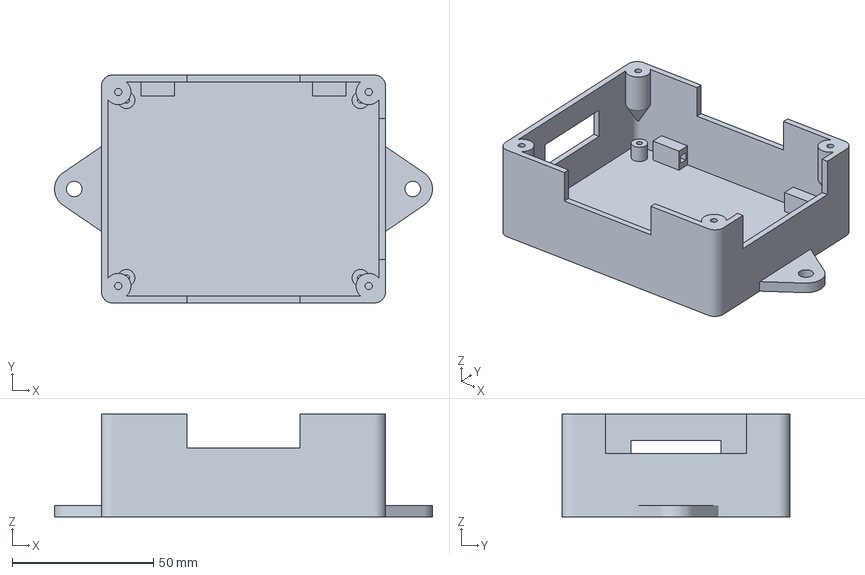
[picture p231: CAD file, 2026-10-14]
cad/export/3mf/parts/esp32_enclosure_base.3mf
134.0 x 80.8 x 36.4 mm
