whyvas/filament-falcon/cad/export/3mf/parts/cable_clips_set.3mf

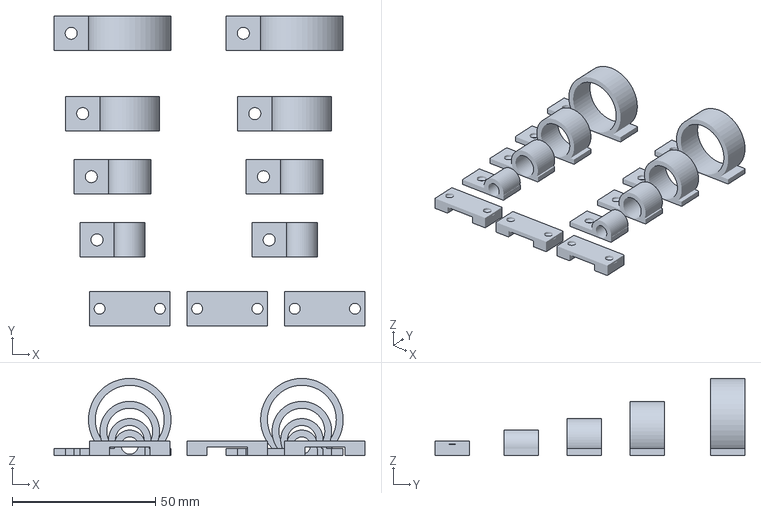
[picture p232: CAD file, 2026-10-14]
cad/export/3mf/parts/cable_clips_set.3mf
108.4 x 108.0 x 26.9 mm
