whyvas/filament-falcon/cad/export/3mf/parts/joystick_adapter_plate.3mf

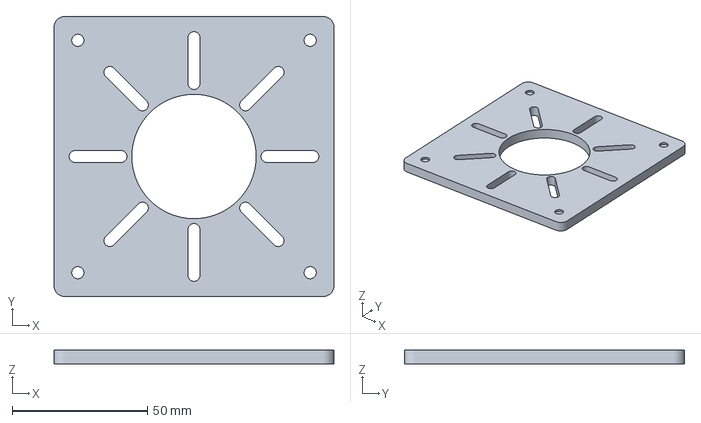
[picture p233: CAD file, 2026-10-14]
cad/export/3mf/parts/joystick_adapter_plate.3mf
103.6 x 103.6 x 5.00 mm
