whyvas/filament-falcon/cad/export/3mf/parts/joystick_housing.3mf

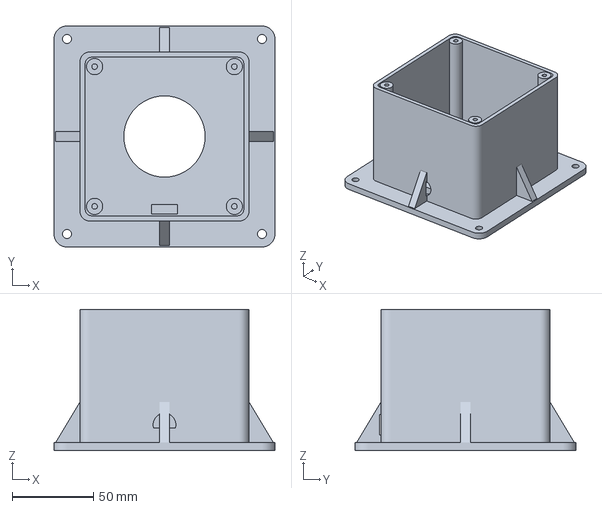
[picture p234: CAD file, 2026-10-14]
cad/export/3mf/parts/joystick_housing.3mf
136.0 x 136.0 x 87.0 mm
