whyvas/filament-falcon/cad/export/3mf/parts/toggle_guard_lid_RED.3mf

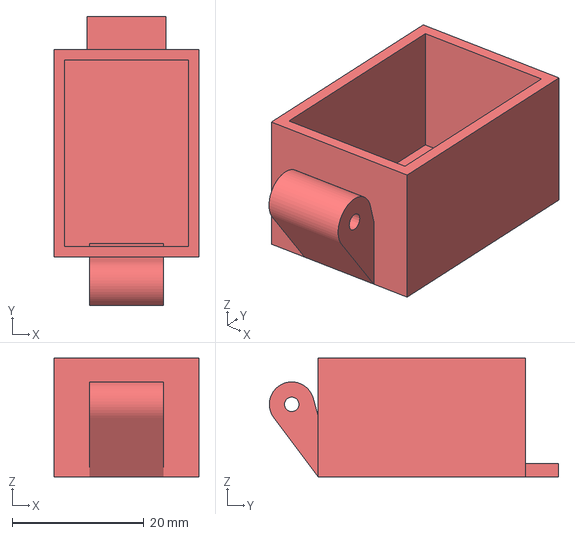
[picture p235: CAD file, 2026-10-14]
cad/export/3mf/parts/toggle_guard_lid_RED.3mf
22.0 x 43.9 x 18.0 mm
