whyvas/filament-falcon/frame/generated/frame.scad

// GENERATED by frame/frame_model.py - do not edit by hand.
FF_RECLINE = 35.0;
FF_ALPHA_DN = 40.0;
FF_ALPHA_UP = 95.0;
FF_CP = [0.0,-840.0,200.0];
FF_PP = [0.0,-1375.0,1005.0];

module ff_frame_fixed(ghost = false) {
  color("#c8a165", ghost ? 0.25 : 1) multmatrix([[1.0000,0.0000,0.0000,-968.0000],[0.0000,1.0000,0.0000,-2450.0000],[0.0000,0.0000,1.0000,0.0000],[0.0000,0.0000,0.0000,1.0000]]) cube([38.0,2450.0,89.0]);  // Sill L
  color("#c8a165", ghost ? 0.25 : 1) multmatrix([[1.0000,0.0000,0.0000,930.0000],[0.0000,1.0000,0.0000,-2450.0000],[0.0000,0.0000,1.0000,0.0000],[0.0000,0.0000,0.0000,1.0000]]) cube([38.0,2450.0,89.0]);  // Sill R
  color("#c8a165", ghost ? 0.25 : 1) multmatrix([[1.0000,0.0000,0.0000,-930.0000],[0.0000,1.0000,0.0000,-311.0000],[0.0000,0.0000,1.0000,0.0000],[0.0000,0.0000,0.0000,1.0000]]) cube([1860.0,89.0,38.0]);  // Base cross, nose rear
  color("#c8a165", ghost ? 0.25 : 1) multmatrix([[1.0000,0.0000,0.0000,-930.0000],[0.0000,1.0000,0.0000,-489.0000],[0.0000,0.0000,1.0000,0.0000],[0.0000,0.0000,0.0000,1.0000]]) cube([1860.0,89.0,38.0]);  // Base cross, cradle front
  color("#c8a165", ghost ? 0.25 : 1) multmatrix([[1.0000,0.0000,0.0000,-930.0000],[0.0000,1.0000,0.0000,-38.0000],[0.0000,0.0000,1.0000,0.0000],[0.0000,0.0000,0.0000,1.0000]]) cube([1860.0,38.0,89.0]);  // Base cross, nose front
  color("#c8a165", ghost ? 0.25 : 1) multmatrix([[1.0000,0.0000,0.0000,-930.0000],[0.0000,1.0000,0.0000,-859.0000],[0.0000,0.0000,1.0000,0.0000],[0.0000,0.0000,0.0000,1.0000]]) cube([1860.0,38.0,89.0]);  // Base cross, cradle pivot
  color("#c8a165", ghost ? 0.25 : 1) multmatrix([[1.0000,0.0000,0.0000,-930.0000],[0.0000,1.0000,0.0000,-1300.0000],[0.0000,0.0000,1.0000,0.0000],[0.0000,0.0000,0.0000,1.0000]]) cube([1860.0,38.0,89.0]);  // Base cross, casing front
  color("#c8a165", ghost ? 0.25 : 1) multmatrix([[1.0000,0.0000,0.0000,-930.0000],[0.0000,1.0000,0.0000,-1738.0000],[0.0000,0.0000,1.0000,0.0000],[0.0000,0.0000,0.0000,1.0000]]) cube([1860.0,38.0,89.0]);  // Base cross, dais front
  color("#c8a165", ghost ? 0.25 : 1) multmatrix([[1.0000,0.0000,0.0000,-930.0000],[0.0000,1.0000,0.0000,-2118.0000],[0.0000,0.0000,1.0000,0.0000],[0.0000,0.0000,0.0000,1.0000]]) cube([1860.0,38.0,89.0]);  // Base cross, dais mid
  color("#c8a165", ghost ? 0.25 : 1) multmatrix([[1.0000,0.0000,0.0000,-930.0000],[0.0000,1.0000,0.0000,-2450.0000],[0.0000,0.0000,1.0000,0.0000],[0.0000,0.0000,0.0000,1.0000]]) cube([1860.0,38.0,89.0]);  // Base cross, rear
  color("#c8a165", ghost ? 0.25 : 1) multmatrix([[1.0000,0.0000,0.0000,-818.0000],[0.0000,1.0000,0.0000,-489.0000],[0.0000,0.0000,1.0000,38.0000],[0.0000,0.0000,0.0000,1.0000]]) cube([58.0,89.0,76.0]);  // Cradle rest pad L
  color("#c8a165", ghost ? 0.25 : 1) multmatrix([[1.0000,0.0000,0.0000,760.0000],[0.0000,1.0000,0.0000,-489.0000],[0.0000,0.0000,1.0000,38.0000],[0.0000,0.0000,0.0000,1.0000]]) cube([58.0,89.0,76.0]);  // Cradle rest pad R
  color("#c8a165", ghost ? 0.25 : 1) multmatrix([[1.0000,0.0000,0.0000,-904.0000],[0.0000,1.0000,0.0000,-884.5000],[0.0000,0.0000,1.0000,89.0000],[0.0000,0.0000,0.0000,1.0000]]) cube([89.0,89.0,93.0]);  // Cradle pivot pedestal L
  color("#c8a165", ghost ? 0.25 : 1) multmatrix([[1.0000,0.0000,0.0000,-904.0000],[0.0000,1.0000,0.0000,-884.5000],[0.0000,0.0000,1.0000,89.0000],[0.0000,0.0000,0.0000,1.0000]]) cube([89.0,89.0,1.0]);  // Cradle pivot pedestal L (block)
  color("#c8a165", ghost ? 0.25 : 1) multmatrix([[1.0000,0.0000,0.0000,815.0000],[0.0000,1.0000,0.0000,-884.5000],[0.0000,0.0000,1.0000,89.0000],[0.0000,0.0000,0.0000,1.0000]]) cube([89.0,89.0,93.0]);  // Cradle pivot pedestal R
  color("#c8a165", ghost ? 0.25 : 1) multmatrix([[1.0000,0.0000,0.0000,815.0000],[0.0000,1.0000,0.0000,-884.5000],[0.0000,0.0000,1.0000,89.0000],[0.0000,0.0000,0.0000,1.0000]]) cube([89.0,89.0,1.0]);  // Cradle pivot pedestal R (block)
  color("#c8a165", ghost ? 0.25 : 1) multmatrix([[1.0000,0.0000,0.0000,-540.0000],[0.0000,1.0000,0.0000,-994.0000],[0.0000,0.0000,1.0000,89.0000],[0.0000,0.0000,0.0000,1.0000]]) cube([160.0,89.0,36.0]);  // Recline stop block L
  color("#c8a165", ghost ? 0.25 : 1) multmatrix([[1.0000,0.0000,0.0000,380.0000],[0.0000,1.0000,0.0000,-994.0000],[0.0000,0.0000,1.0000,89.0000],[0.0000,0.0000,0.0000,1.0000]]) cube([160.0,89.0,36.0]);  // Recline stop block R
  color("#c8a165", ghost ? 0.25 : 1) multmatrix([[1.0000,0.0000,0.0000,-930.0000],[0.0000,1.0000,0.0000,-994.0000],[0.0000,0.0000,1.0000,0.0000],[0.0000,0.0000,0.0000,1.0000]]) cube([1860.0,89.0,38.0]);  // Base cross, recline stops
  color("#c8a165", ghost ? 0.25 : 1) multmatrix([[1.0000,0.0000,0.0000,-930.0000],[0.0000,1.0000,0.0000,-89.0000],[0.0000,0.0000,1.0000,89.0000],[0.0000,0.0000,0.0000,1.0000]]) cube([38.0,89.0,369.0]);  // Nose post front L
  color("#c8a165", ghost ? 0.25 : 1) multmatrix([[1.0000,0.0000,0.0000,-930.0000],[0.0000,1.0000,0.0000,-268.0000],[0.0000,0.0000,1.0000,89.0000],[0.0000,0.0000,0.0000,1.0000]]) cube([38.0,89.0,369.0]);  // Nose post rear L
  color("#c8a165", ghost ? 0.25 : 1) multmatrix([[1.0000,0.0000,0.0000,892.0000],[0.0000,1.0000,0.0000,-89.0000],[0.0000,0.0000,1.0000,89.0000],[0.0000,0.0000,0.0000,1.0000]]) cube([38.0,89.0,369.0]);  // Nose post front R
  color("#c8a165", ghost ? 0.25 : 1) multmatrix([[1.0000,0.0000,0.0000,892.0000],[0.0000,1.0000,0.0000,-268.0000],[0.0000,0.0000,1.0000,89.0000],[0.0000,0.0000,0.0000,1.0000]]) cube([38.0,89.0,369.0]);  // Nose post rear R
  color("#e3c79c", ghost ? 0.25 : 1) multmatrix([[1.0000,0.0000,0.0000,-980.0000],[0.0000,1.0000,0.0000,-0.0000],[0.0000,0.0000,1.0000,0.0000],[0.0000,0.0000,0.0000,1.0000]]) cube([1960.0,12.0,470.0]);  // Nose box front skin
  color("#e3c79c", ghost ? 0.25 : 1) multmatrix([[1.0000,0.0000,0.0000,-968.0000],[0.0000,1.0000,0.0000,-300.0000],[0.0000,0.0000,1.0000,458.0000],[0.0000,0.0000,0.0000,1.0000]]) cube([1936.0,300.0,12.0]);  // Nose box lid
  color("#e3c79c", ghost ? 0.25 : 1) multmatrix([[1.0000,0.0000,0.0000,-930.0000],[0.0000,1.0000,0.0000,-280.0000],[0.0000,0.0000,1.0000,89.0000],[0.0000,0.0000,0.0000,1.0000]]) cube([1860.0,12.0,369.0]);  // Nose box rear wall
  color("#c8a165", ghost ? 0.25 : 1) multmatrix([[1.0000,0.0000,0.0000,-968.0000],[0.0000,1.0000,0.0000,-1419.5000],[0.0000,0.0000,1.0000,89.0000],[0.0000,0.0000,0.0000,1.0000]]) cube([38.0,89.0,1011.0]);  // Tower post outer L
  color("#c8a165", ghost ? 0.25 : 1) multmatrix([[1.0000,0.0000,0.0000,-740.0000],[0.0000,1.0000,0.0000,-1419.5000],[0.0000,0.0000,1.0000,89.0000],[0.0000,0.0000,0.0000,1.0000]]) cube([38.0,89.0,1011.0]);  // Tower post inner L
  color("#c8a165", ghost ? 0.25 : 1) multmatrix([[1.0000,0.0000,0.0000,-740.0000],[0.0000,1.0000,0.0000,-1300.0000],[0.0000,0.0000,1.0000,89.0000],[0.0000,0.0000,0.0000,1.0000]]) cube([38.0,38.0,1011.0]);  // Casing post L d1262
  color("#c8a165", ghost ? 0.25 : 1) multmatrix([[1.0000,0.0000,0.0000,-968.0000],[0.0000,1.0000,0.0000,-1300.0000],[0.0000,0.0000,1.0000,89.0000],[0.0000,0.0000,0.0000,1.0000]]) cube([38.0,38.0,1011.0]);  // Casing post outer L d1262
  color("#c8a165", ghost ? 0.25 : 1) multmatrix([[1.0000,0.0000,0.0000,-740.0000],[0.0000,1.0000,0.0000,-1960.0000],[0.0000,0.0000,1.0000,89.0000],[0.0000,0.0000,0.0000,1.0000]]) cube([38.0,38.0,1011.0]);  // Casing post L d1922
  color("#c8a165", ghost ? 0.25 : 1) multmatrix([[1.0000,0.0000,0.0000,-968.0000],[0.0000,1.0000,0.0000,-1960.0000],[0.0000,0.0000,1.0000,89.0000],[0.0000,0.0000,0.0000,1.0000]]) cube([38.0,38.0,1011.0]);  // Casing post outer L d1922
  color("#c8a165", ghost ? 0.25 : 1) multmatrix([[1.0000,0.0000,0.0000,-930.0000],[0.0000,1.0000,0.0000,-1922.0000],[0.0000,0.0000,1.0000,1062.0000],[0.0000,0.0000,0.0000,1.0000]]) cube([190.0,89.0,38.0]);  // Casing tie L
  color("#e3c79c", ghost ? 0.25 : 1) multmatrix([[1.0000,0.0000,0.0000,-980.0000],[0.0000,1.0000,0.0000,-1960.0000],[0.0000,0.0000,1.0000,0.0000],[0.0000,0.0000,0.0000,1.0000]]) cube([12.0,698.0,1112.0]);  // Side skin (casing) L
  color("#e3c79c", ghost ? 0.25 : 1) multmatrix([[1.0000,0.0000,0.0000,-968.0000],[0.0000,1.0000,0.0000,-1972.0000],[0.0000,0.0000,1.0000,0.0000],[0.0000,0.0000,0.0000,1.0000]]) cube([278.0,12.0,1112.0]);  // Casing back L
  color("#e3c79c", ghost ? 0.25 : 1) multmatrix([[1.0000,0.0000,0.0000,-980.0000],[0.0000,1.0000,0.0000,-300.0000],[0.0000,0.0000,1.0000,0.0000],[0.0000,0.0000,0.0000,1.0000]]) cube([12.0,300.0,470.0]);  // Side skin (nose) L
  color("#c8a165", ghost ? 0.25 : 1) multmatrix([[1.0000,0.0000,0.0000,930.0000],[0.0000,1.0000,0.0000,-1419.5000],[0.0000,0.0000,1.0000,89.0000],[0.0000,0.0000,0.0000,1.0000]]) cube([38.0,89.0,1011.0]);  // Tower post outer R
  color("#c8a165", ghost ? 0.25 : 1) multmatrix([[1.0000,0.0000,0.0000,702.0000],[0.0000,1.0000,0.0000,-1419.5000],[0.0000,0.0000,1.0000,89.0000],[0.0000,0.0000,0.0000,1.0000]]) cube([38.0,89.0,1011.0]);  // Tower post inner R
  color("#c8a165", ghost ? 0.25 : 1) multmatrix([[1.0000,0.0000,0.0000,702.0000],[0.0000,1.0000,0.0000,-1300.0000],[0.0000,0.0000,1.0000,89.0000],[0.0000,0.0000,0.0000,1.0000]]) cube([38.0,38.0,1011.0]);  // Casing post R d1262
  color("#c8a165", ghost ? 0.25 : 1) multmatrix([[1.0000,0.0000,0.0000,930.0000],[0.0000,1.0000,0.0000,-1300.0000],[0.0000,0.0000,1.0000,89.0000],[0.0000,0.0000,0.0000,1.0000]]) cube([38.0,38.0,1011.0]);  // Casing post outer R d1262
  color("#c8a165", ghost ? 0.25 : 1) multmatrix([[1.0000,0.0000,0.0000,702.0000],[0.0000,1.0000,0.0000,-1960.0000],[0.0000,0.0000,1.0000,89.0000],[0.0000,0.0000,0.0000,1.0000]]) cube([38.0,38.0,1011.0]);  // Casing post R d1922
  color("#c8a165", ghost ? 0.25 : 1) multmatrix([[1.0000,0.0000,0.0000,930.0000],[0.0000,1.0000,0.0000,-1960.0000],[0.0000,0.0000,1.0000,89.0000],[0.0000,0.0000,0.0000,1.0000]]) cube([38.0,38.0,1011.0]);  // Casing post outer R d1922
  color("#c8a165", ghost ? 0.25 : 1) multmatrix([[1.0000,0.0000,0.0000,740.0000],[0.0000,1.0000,0.0000,-1922.0000],[0.0000,0.0000,1.0000,1062.0000],[0.0000,0.0000,0.0000,1.0000]]) cube([190.0,89.0,38.0]);  // Casing tie R
  color("#e3c79c", ghost ? 0.25 : 1) multmatrix([[1.0000,0.0000,0.0000,968.0000],[0.0000,1.0000,0.0000,-1960.0000],[0.0000,0.0000,1.0000,0.0000],[0.0000,0.0000,0.0000,1.0000]]) cube([12.0,698.0,1112.0]);  // Side skin (casing) R
  color("#e3c79c", ghost ? 0.25 : 1) multmatrix([[1.0000,0.0000,0.0000,690.0000],[0.0000,1.0000,0.0000,-1972.0000],[0.0000,0.0000,1.0000,0.0000],[0.0000,0.0000,0.0000,1.0000]]) cube([278.0,12.0,1112.0]);  // Casing back R
  color("#e3c79c", ghost ? 0.25 : 1) multmatrix([[1.0000,0.0000,0.0000,968.0000],[0.0000,1.0000,0.0000,-300.0000],[0.0000,0.0000,1.0000,0.0000],[0.0000,0.0000,0.0000,1.0000]]) cube([12.0,300.0,470.0]);  // Side skin (nose) R
  color("#d9b98a", ghost ? 0.25 : 1) translate([-640.0,0,0]) rotate([90,0,90]) linear_extrude(18.0) polygon([[-1025.1,18.0],[-1646.2,905.1],[-1646.2,0.0],[-1025.1,0.0]]);  // Ramp cheek L
  color("#d9b98a", ghost ? 0.25 : 1) translate([622.0,0,0]) rotate([90,0,90]) linear_extrude(18.0) polygon([[-1025.1,18.0],[-1646.2,905.1],[-1646.2,0.0],[-1025.1,0.0]]);  // Ramp cheek R
  color("#d9b98a", ghost ? 0.25 : 1) translate([-9.0,0,0]) rotate([90,0,90]) linear_extrude(18.0) polygon([[-1025.1,18.0],[-1646.2,905.1],[-1646.2,0.0],[-1025.1,0.0]]);  // Ramp cheek centre
  color("#d9b98a", ghost ? 0.25 : 1) translate([-640.0,0,0]) rotate([90,0,90]) linear_extrude(1280.0) polygon([[-1017.7,23.2],[-1638.9,910.2],[-1653.6,899.9],[-1032.5,12.8]]);  // Crush-zone ramp
  color("#c8a165", ghost ? 0.25 : 1) multmatrix([[1.0000,0.0000,0.0000,-600.0000],[0.0000,1.0000,0.0000,-2450.0000],[0.0000,0.0000,1.0000,89.0000],[0.0000,0.0000,0.0000,1.0000]]) cube([38.0,750.0,143.0]);  // Dais joist L
  color("#c8a165", ghost ? 0.25 : 1) multmatrix([[1.0000,0.0000,0.0000,-19.0000],[0.0000,1.0000,0.0000,-2450.0000],[0.0000,0.0000,1.0000,89.0000],[0.0000,0.0000,0.0000,1.0000]]) cube([38.0,750.0,143.0]);  // Dais joist C
  color("#c8a165", ghost ? 0.25 : 1) multmatrix([[1.0000,0.0000,0.0000,562.0000],[0.0000,1.0000,0.0000,-2450.0000],[0.0000,0.0000,1.0000,89.0000],[0.0000,0.0000,0.0000,1.0000]]) cube([38.0,750.0,143.0]);  // Dais joist R
  color("#d9b98a", ghost ? 0.25 : 1) multmatrix([[1.0000,0.0000,0.0000,-600.0000],[0.0000,1.0000,0.0000,-2450.0000],[0.0000,0.0000,1.0000,232.0000],[0.0000,0.0000,0.0000,1.0000]]) cube([1200.0,750.0,18.0]);  // Dais deck
  color("#e3c79c", ghost ? 0.25 : 1) multmatrix([[1.0000,0.0000,0.0000,-600.0000],[0.0000,1.0000,0.0000,-1700.0000],[0.0000,0.0000,1.0000,0.0000],[0.0000,0.0000,0.0000,1.0000]]) cube([1200.0,12.0,250.0]);  // Dais front skin
  color("#d9b98a", ghost ? 0.25 : 1) multmatrix([[1.0000,0.0000,0.0000,-260.0000],[0.0000,1.0000,0.0000,-2410.0000],[0.0000,0.0000,1.0000,250.0000],[0.0000,0.0000,0.0000,1.0000]]) cube([520.0,450.0,420.0]);  // Dad seat box
  color("#d9b98a", ghost ? 0.25 : 1) multmatrix([[1.0000,0.0000,0.0000,-260.0000],[0.0000,1.0000,0.0000,-2428.0000],[0.0000,0.0000,1.0000,250.0000],[0.0000,0.0000,0.0000,1.0000]]) cube([520.0,18.0,1310.0]);  // Dad seat back
  color("#d9b98a", ghost ? 0.25 : 1) multmatrix([[1.0000,0.0000,0.0000,300.0000],[0.0000,1.0000,0.0000,-2200.0000],[0.0000,0.0000,1.0000,250.0000],[0.0000,0.0000,0.0000,1.0000]]) cube([240.0,400.0,700.0]);  // Commander console
  color("#e3c79c", ghost ? 0.25 : 1) multmatrix([[1.0000,0.0000,0.0000,-370.0000],[0.0000,1.0000,0.0000,-2160.0000],[0.0000,0.0000,1.0000,250.0000],[0.0000,0.0000,0.0000,1.0000]]) cube([100.0,160.0,510.0]);  // Pod release lever box
  color("#7a1f1f", ghost ? 0.25 : 1) multmatrix([[1.0000,0.0000,0.0000,-240.0000],[0.0000,1.0000,0.0000,-2380.0000],[0.0000,0.0000,1.0000,670.0000],[0.0000,0.0000,0.0000,1.0000]]) cube([480.0,410.0,70.0]);  // Cushion dad
  color("#7a1f1f", ghost ? 0.25 : 1) multmatrix([[1.0000,0.0000,0.0000,-230.0000],[0.0000,1.0000,0.0000,-2410.0000],[0.0000,0.0000,1.0000,740.0000],[0.0000,0.0000,0.0000,1.0000]]) cube([460.0,40.0,800.0]);  // Back cushion dad
  color("#e3c79c", ghost ? 0.25 : 1) multmatrix([[1.0000,0.0000,0.0000,-702.0000],[0.0000,1.0000,0.0000,-1960.0000],[0.0000,0.0000,1.0000,0.0000],[0.0000,0.0000,0.0000,1.0000]]) cube([12.0,698.0,1112.0]);  // Casing inner wall L
  color("#e3c79c", ghost ? 0.25 : 1) multmatrix([[1.0000,0.0000,0.0000,-800.0000],[0.0000,1.0000,0.0000,-1262.0000],[0.0000,0.0000,1.0000,0.0000],[0.0000,0.0000,0.0000,1.0000]]) cube([110.0,12.0,1112.0]);  // Casing front wall L (inner)
  color("#e3c79c", ghost ? 0.25 : 1) multmatrix([[1.0000,0.0000,0.0000,-968.0000],[0.0000,1.0000,0.0000,-1262.0000],[0.0000,0.0000,1.0000,0.0000],[0.0000,0.0000,0.0000,1.0000]]) cube([120.0,12.0,1112.0]);  // Casing front wall L (outer)
  color("#e3c79c", ghost ? 0.25 : 1) multmatrix([[1.0000,0.0000,0.0000,-848.0000],[0.0000,1.0000,0.0000,-1262.0000],[0.0000,0.0000,1.0000,0.0000],[0.0000,0.0000,0.0000,1.0000]]) cube([48.0,12.0,838.8]);  // Casing front wall L (below slot)
  color("#e3c79c", ghost ? 0.25 : 1) multmatrix([[1.0000,0.0000,0.0000,-800.0000],[0.0000,1.0000,0.0000,-1960.0000],[0.0000,0.0000,1.0000,1100.0000],[0.0000,0.0000,0.0000,1.0000]]) cube([110.0,710.0,12.0]);  // Casing top L (inner)
  color("#e3c79c", ghost ? 0.25 : 1) multmatrix([[1.0000,0.0000,0.0000,-968.0000],[0.0000,1.0000,0.0000,-1960.0000],[0.0000,0.0000,1.0000,1100.0000],[0.0000,0.0000,0.0000,1.0000]]) cube([120.0,710.0,12.0]);  // Casing top L (outer)
  color("#e3c79c", ghost ? 0.25 : 1) multmatrix([[1.0000,0.0000,0.0000,-848.0000],[0.0000,1.0000,0.0000,-1960.0000],[0.0000,0.0000,1.0000,1100.0000],[0.0000,0.0000,0.0000,1.0000]]) cube([48.0,374.7,12.0]);  // Casing top L (behind slot)
  color("#c8a165", ghost ? 0.25 : 1) multmatrix([[1.0000,0.0000,0.0000,-930.0000],[0.0000,1.0000,0.0000,-1546.5000],[0.0000,0.0000,1.0000,89.0000],[0.0000,0.0000,0.0000,1.0000]]) cube([38.0,89.0,1011.0]);  // Strut anchor post L
  color("#e3c79c", ghost ? 0.25 : 1) multmatrix([[1.0000,0.0000,0.0000,690.0000],[0.0000,1.0000,0.0000,-1960.0000],[0.0000,0.0000,1.0000,0.0000],[0.0000,0.0000,0.0000,1.0000]]) cube([12.0,698.0,1112.0]);  // Casing inner wall R
  color("#e3c79c", ghost ? 0.25 : 1) multmatrix([[1.0000,0.0000,0.0000,690.0000],[0.0000,1.0000,0.0000,-1262.0000],[0.0000,0.0000,1.0000,0.0000],[0.0000,0.0000,0.0000,1.0000]]) cube([110.0,12.0,1112.0]);  // Casing front wall R (inner)
  color("#e3c79c", ghost ? 0.25 : 1) multmatrix([[1.0000,0.0000,0.0000,848.0000],[0.0000,1.0000,0.0000,-1262.0000],[0.0000,0.0000,1.0000,0.0000],[0.0000,0.0000,0.0000,1.0000]]) cube([120.0,12.0,1112.0]);  // Casing front wall R (outer)
  color("#e3c79c", ghost ? 0.25 : 1) multmatrix([[1.0000,0.0000,0.0000,800.0000],[0.0000,1.0000,0.0000,-1262.0000],[0.0000,0.0000,1.0000,0.0000],[0.0000,0.0000,0.0000,1.0000]]) cube([48.0,12.0,838.8]);  // Casing front wall R (below slot)
  color("#e3c79c", ghost ? 0.25 : 1) multmatrix([[1.0000,0.0000,0.0000,690.0000],[0.0000,1.0000,0.0000,-1960.0000],[0.0000,0.0000,1.0000,1100.0000],[0.0000,0.0000,0.0000,1.0000]]) cube([110.0,710.0,12.0]);  // Casing top R (inner)
  color("#e3c79c", ghost ? 0.25 : 1) multmatrix([[1.0000,0.0000,0.0000,848.0000],[0.0000,1.0000,0.0000,-1960.0000],[0.0000,0.0000,1.0000,1100.0000],[0.0000,0.0000,0.0000,1.0000]]) cube([120.0,710.0,12.0]);  // Casing top R (outer)
  color("#e3c79c", ghost ? 0.25 : 1) multmatrix([[1.0000,0.0000,0.0000,800.0000],[0.0000,1.0000,0.0000,-1960.0000],[0.0000,0.0000,1.0000,1100.0000],[0.0000,0.0000,0.0000,1.0000]]) cube([48.0,374.7,12.0]);  // Casing top R (behind slot)
  color("#c8a165", ghost ? 0.25 : 1) multmatrix([[1.0000,0.0000,0.0000,892.0000],[0.0000,1.0000,0.0000,-1546.5000],[0.0000,0.0000,1.0000,89.0000],[0.0000,0.0000,0.0000,1.0000]]) cube([38.0,89.0,1011.0]);  // Strut anchor post R
}
module ff_frame_cradle(ghost = false) {
  color("#c8a165", ghost ? 0.25 : 1) multmatrix([[1.0000,0.0000,0.0000,-808.0000],[0.0000,1.0000,0.0000,-880.0000],[0.0000,0.0000,1.0000,120.0000],[0.0000,0.0000,0.0000,1.0000]]) cube([38.0,560.0,89.0]);  // Cradle rail L
  color("#c8a165", ghost ? 0.25 : 1) multmatrix([[1.0000,0.0000,0.0000,770.0000],[0.0000,1.0000,0.0000,-880.0000],[0.0000,0.0000,1.0000,120.0000],[0.0000,0.0000,0.0000,1.0000]]) cube([38.0,560.0,89.0]);  // Cradle rail R
  color("#c8a165", ghost ? 0.25 : 1) multmatrix([[1.0000,0.0000,0.0000,-770.0000],[0.0000,1.0000,0.0000,-409.0000],[0.0000,0.0000,1.0000,171.0000],[0.0000,0.0000,0.0000,1.0000]]) cube([1540.0,89.0,38.0]);  // Cradle cross, front
  color("#c8a165", ghost ? 0.25 : 1) multmatrix([[1.0000,0.0000,0.0000,-770.0000],[0.0000,1.0000,0.0000,-459.0000],[0.0000,0.0000,1.0000,120.0000],[0.0000,0.0000,0.0000,1.0000]]) cube([1540.0,38.0,89.0]);  // Cradle cross, actuator
  color("#c8a165", ghost ? 0.25 : 1) multmatrix([[1.0000,0.0000,0.0000,-770.0000],[0.0000,1.0000,0.0000,-560.0000],[0.0000,0.0000,1.0000,120.0000],[0.0000,0.0000,0.0000,1.0000]]) cube([1540.0,38.0,89.0]);  // Cradle cross, seats
  color("#c8a165", ghost ? 0.25 : 1) multmatrix([[1.0000,0.0000,0.0000,-770.0000],[0.0000,1.0000,0.0000,-818.0000],[0.0000,0.0000,1.0000,120.0000],[0.0000,0.0000,0.0000,1.0000]]) cube([1540.0,38.0,89.0]);  // Cradle cross, rear
  color("#c8a165", ghost ? 0.25 : 1) multmatrix([[1.0000,0.0000,0.0000,-479.0000],[0.0000,1.0000,0.0000,-780.0000],[0.0000,0.0000,1.0000,120.0000],[0.0000,0.0000,0.0000,1.0000]]) cube([38.0,371.0,89.0]);  // Cradle joist L
  color("#c8a165", ghost ? 0.25 : 1) multmatrix([[1.0000,0.0000,0.0000,-19.0000],[0.0000,1.0000,0.0000,-780.0000],[0.0000,0.0000,1.0000,120.0000],[0.0000,0.0000,0.0000,1.0000]]) cube([38.0,371.0,89.0]);  // Cradle joist C
  color("#c8a165", ghost ? 0.25 : 1) multmatrix([[1.0000,0.0000,0.0000,441.0000],[0.0000,1.0000,0.0000,-780.0000],[0.0000,0.0000,1.0000,120.0000],[0.0000,0.0000,0.0000,1.0000]]) cube([38.0,371.0,89.0]);  // Cradle joist R
  color("#d9b98a", ghost ? 0.25 : 1) multmatrix([[1.0000,0.0000,0.0000,-808.0000],[0.0000,1.0000,0.0000,-880.0000],[0.0000,0.0000,1.0000,209.0000],[0.0000,0.0000,0.0000,1.0000]]) cube([1616.0,560.0,18.0]);  // Cradle deck
  color("#e3c79c", ghost ? 0.25 : 1) multmatrix([[1.0000,0.0000,0.0000,-808.0000],[0.0000,1.0000,0.0000,-332.0000],[0.0000,0.0000,1.0000,227.0000],[0.0000,0.0000,0.0000,1.0000]]) cube([1616.0,12.0,70.0]);  // Cradle toe lip
  color("#b89a6e", ghost ? 0.25 : 1) multmatrix([[1.0000,0.0000,0.0000,-814.0000],[0.0000,1.0000,0.0000,-840.0000],[0.0000,0.0000,1.0000,50.0000],[0.0000,0.0000,0.0000,1.0000]]) cube([6.0,460.0,159.0]);  // Cradle skirt L
  color("#b89a6e", ghost ? 0.25 : 1) multmatrix([[1.0000,0.0000,0.0000,808.0000],[0.0000,1.0000,0.0000,-840.0000],[0.0000,0.0000,1.0000,50.0000],[0.0000,0.0000,0.0000,1.0000]]) cube([6.0,460.0,159.0]);  // Cradle skirt R
  color("#d9b98a", ghost ? 0.25 : 1) multmatrix([[1.0000,0.0000,0.0000,-630.0000],[0.0000,1.0000,0.0000,-940.0000],[0.0000,0.0000,1.0000,227.0000],[0.0000,0.0000,0.0000,1.0000]]) cube([340.0,380.0,193.0]);  // Kid seat box PILOT
  color("#d9b98a", ghost ? 0.25 : 1) multmatrix([[1.0000,0.0000,0.0000,-630.0000],[0.0000,1.0000,0.0000,-958.0000],[0.0000,0.0000,1.0000,227.0000],[0.0000,0.0000,0.0000,1.0000]]) cube([340.0,18.0,1073.0]);  // Kid seat back PILOT
  color("#d9b98a", ghost ? 0.25 : 1) multmatrix([[1.0000,0.0000,0.0000,-630.0000],[0.0000,1.0000,0.0000,-940.0000],[0.0000,0.0000,1.0000,900.0000],[0.0000,0.0000,0.0000,1.0000]]) cube([18.0,130.0,400.0]);  // Headrest wing PILOT out
  color("#d9b98a", ghost ? 0.25 : 1) multmatrix([[1.0000,0.0000,0.0000,-308.0000],[0.0000,1.0000,0.0000,-940.0000],[0.0000,0.0000,1.0000,900.0000],[0.0000,0.0000,0.0000,1.0000]]) cube([18.0,130.0,400.0]);  // Headrest wing PILOT in
  color("#d9b98a", ghost ? 0.25 : 1) multmatrix([[1.0000,0.0000,0.0000,290.0000],[0.0000,1.0000,0.0000,-940.0000],[0.0000,0.0000,1.0000,227.0000],[0.0000,0.0000,0.0000,1.0000]]) cube([340.0,380.0,193.0]);  // Kid seat box OPS
  color("#d9b98a", ghost ? 0.25 : 1) multmatrix([[1.0000,0.0000,0.0000,290.0000],[0.0000,1.0000,0.0000,-958.0000],[0.0000,0.0000,1.0000,227.0000],[0.0000,0.0000,0.0000,1.0000]]) cube([340.0,18.0,1073.0]);  // Kid seat back OPS
  color("#d9b98a", ghost ? 0.25 : 1) multmatrix([[1.0000,0.0000,0.0000,290.0000],[0.0000,1.0000,0.0000,-940.0000],[0.0000,0.0000,1.0000,900.0000],[0.0000,0.0000,0.0000,1.0000]]) cube([18.0,130.0,400.0]);  // Headrest wing OPS in
  color("#d9b98a", ghost ? 0.25 : 1) multmatrix([[1.0000,0.0000,0.0000,612.0000],[0.0000,1.0000,0.0000,-940.0000],[0.0000,0.0000,1.0000,900.0000],[0.0000,0.0000,0.0000,1.0000]]) cube([18.0,130.0,400.0]);  // Headrest wing OPS out
  color("#d9b98a", ghost ? 0.25 : 1) multmatrix([[1.0000,0.0000,0.0000,-280.0000],[0.0000,1.0000,0.0000,-940.0000],[0.0000,0.0000,1.0000,227.0000],[0.0000,0.0000,0.0000,1.0000]]) cube([560.0,380.0,333.0]);  // Centre console (TD2220)
  color("#d9b98a", ghost ? 0.25 : 1) multmatrix([[1.0000,0.0000,0.0000,-280.0000],[0.0000,1.0000,0.0000,-560.0000],[0.0000,0.0000,1.0000,227.0000],[0.0000,0.0000,0.0000,1.0000]]) cube([560.0,180.0,243.0]);  // Front pedestal
  color("#d9b98a", ghost ? 0.25 : 1) multmatrix([[1.0000,0.0000,0.0000,-830.0000],[0.0000,1.0000,0.0000,-800.0000],[0.0000,0.0000,1.0000,209.0000],[0.0000,0.0000,0.0000,1.0000]]) cube([200.0,240.0,391.0]);  // Side console PILOT
  color("#d9b98a", ghost ? 0.25 : 1) multmatrix([[1.0000,0.0000,0.0000,630.0000],[0.0000,1.0000,0.0000,-800.0000],[0.0000,0.0000,1.0000,209.0000],[0.0000,0.0000,0.0000,1.0000]]) cube([200.0,240.0,391.0]);  // Side console OPS
  color("#7a1f1f", ghost ? 0.25 : 1) multmatrix([[1.0000,0.0000,0.0000,-620.0000],[0.0000,1.0000,0.0000,-910.0000],[0.0000,0.0000,1.0000,420.0000],[0.0000,0.0000,0.0000,1.0000]]) cube([320.0,340.0,60.0]);  // Cushion PILOT
  color("#7a1f1f", ghost ? 0.25 : 1) multmatrix([[1.0000,0.0000,0.0000,-610.0000],[0.0000,1.0000,0.0000,-940.0000],[0.0000,0.0000,1.0000,480.0000],[0.0000,0.0000,0.0000,1.0000]]) cube([300.0,30.0,800.0]);  // Back cushion PILOT
  color("#7a1f1f", ghost ? 0.25 : 1) multmatrix([[1.0000,0.0000,0.0000,300.0000],[0.0000,1.0000,0.0000,-910.0000],[0.0000,0.0000,1.0000,420.0000],[0.0000,0.0000,0.0000,1.0000]]) cube([320.0,340.0,60.0]);  // Cushion OPS
  color("#7a1f1f", ghost ? 0.25 : 1) multmatrix([[1.0000,0.0000,0.0000,310.0000],[0.0000,1.0000,0.0000,-940.0000],[0.0000,0.0000,1.0000,480.0000],[0.0000,0.0000,0.0000,1.0000]]) cube([300.0,30.0,800.0]);  // Back cushion OPS
}
module ff_frame_pod(ghost = false) {
  color("#e3c79c", ghost ? 0.25 : 1) multmatrix([[0.0000,1.0000,0.0000,-806.0000],[-0.6428,0.0000,0.7660,-584.8678],[0.7660,0.0000,0.6428,1152.3638],[0.0000,0.0000,0.0000,1.0000]]) cube([735.0,1612.0,12.0]);  // Pod back sheet
  color("#d9b98a", ghost ? 0.25 : 1) multmatrix([[0.0000,1.0000,0.0000,-806.0000],[-0.6428,0.0000,0.7660,-653.8118],[0.7660,0.0000,0.6428,1094.5129],[0.0000,0.0000,0.0000,1.0000]]) cube([195.0,1612.0,18.0]);  // Pod lower band (dash)
  color("#d9b98a", ghost ? 0.25 : 1) multmatrix([[0.0000,1.0000,0.0000,-806.0000],[-0.6428,0.0000,0.7660,-1036.2704],[0.7660,0.0000,0.6428,1550.3093],[0.0000,0.0000,0.0000,1.0000]]) cube([140.0,1612.0,18.0]);  // Pod top band (overhead)
  color("#e3c79c", ghost ? 0.25 : 1) multmatrix([[0.0000,1.0000,0.0000,-806.0000],[-0.6428,0.0000,0.7660,-646.0983],[0.7660,0.0000,0.6428,1085.3204],[0.0000,0.0000,0.0000,1.0000]]) cube([12.0,1612.0,102.0]);  // Pod chin plate
  color("#e3c79c", ghost ? 0.25 : 1) multmatrix([[0.0000,1.0000,0.0000,-806.0000],[-0.6428,0.0000,0.7660,-1126.2607],[0.7660,0.0000,0.6428,1657.5556],[0.0000,0.0000,0.0000,1.0000]]) cube([12.0,1612.0,102.0]);  // Pod top cap
  color("#c8a165", ghost ? 0.25 : 1) multmatrix([[0.0000,1.0000,0.0000,-806.0000],[-0.6428,0.0000,0.7660,-733.1582],[0.7660,0.0000,0.6428,1347.7581],[0.0000,0.0000,0.0000,1.0000]]) cube([89.0,1612.0,38.0]);  // Pod stiffener rail 1
  color("#c8a165", ghost ? 0.25 : 1) multmatrix([[0.0000,1.0000,0.0000,-806.0000],[-0.6428,0.0000,0.7660,-868.7864],[0.7660,0.0000,0.6428,1509.3935],[0.0000,0.0000,0.0000,1.0000]]) cube([89.0,1612.0,38.0]);  // Pod stiffener rail 2
  color("#6d7680", ghost ? 0.25 : 1) multmatrix([[0.0000,1.0000,0.0000,-800.0000],[-0.6428,0.0000,0.7660,-813.2496],[0.7660,0.0000,0.6428,1443.2072],[0.0000,0.0000,0.0000,1.0000]]) cube([50.8,1600.0,50.8]);  // Pod torque tube
  color("#6d7680", ghost ? 0.25 : 1) multmatrix([[0.0000,1.0000,0.0000,-806.0000],[-0.6428,0.0000,0.7660,-784.4315],[0.7660,0.0000,0.6428,1402.6403],[0.0000,0.0000,0.0000,1.0000]]) cube([150.0,6.0,60.8]);  // Torque tube end plate L
  color("#6d7680", ghost ? 0.25 : 1) multmatrix([[0.0000,1.0000,0.0000,800.0000],[-0.6428,0.0000,0.7660,-784.4315],[0.7660,0.0000,0.6428,1402.6403],[0.0000,0.0000,0.0000,1.0000]]) cube([150.0,6.0,60.8]);  // Torque tube end plate R
  color("#7a1f1f", ghost ? 0.25 : 1) multmatrix([[0.0000,1.0000,0.0000,-843.0000],[-0.6428,0.0000,0.7660,-646.0983],[0.7660,0.0000,0.6428,1085.3204],[0.0000,0.0000,0.0000,1.0000]]) cube([759.0,1.0,102.0]);  // Pod bumper L
  color("#7a1f1f", ghost ? 0.25 : 1) multmatrix([[0.0000,1.0000,0.0000,842.0000],[-0.6428,0.0000,0.7660,-646.0983],[0.7660,0.0000,0.6428,1085.3204],[0.0000,0.0000,0.0000,1.0000]]) cube([759.0,1.0,102.0]);  // Pod bumper R
  color("#d9b98a", ghost ? 0.25 : 1) translate([-842.0,0,0]) rotate([90,0,90]) linear_extrude(36.0) polygon([[-646.1,1085.3],[-538.9,1175.3],[-739.4,1414.3],[-721.3,1442.5],[-830.6,1572.8],[-861.5,1559.9],[-1026.7,1756.7],[-1134.0,1666.7],[-1398.6,1181.0],[-1498.4,1032.3],[-1683.6,1005.0],[-1692.2,1002.8],[-1700.1,999.1],[-1707.2,993.8],[-1715.6,983.6],[-1719.4,975.6],[-1721.5,967.0],[-1721.5,953.8],[-1717.7,941.2],[-1713.1,933.6],[-1703.8,924.3],[-1692.1,918.1],[-1423.9,851.1],[-1415.1,849.8],[-1406.2,850.3],[-1397.6,852.5],[-1386.0,858.8],[-1376.6,868.3],[-1371.4,878.0],[-1205.8,951.2]]);  // Pod cheek L
  color("#d9b98a", ghost ? 0.25 : 1) translate([806.0,0,0]) rotate([90,0,90]) linear_extrude(36.0) polygon([[-646.1,1085.3],[-538.9,1175.3],[-739.4,1414.3],[-721.3,1442.5],[-830.6,1572.8],[-861.5,1559.9],[-1026.7,1756.7],[-1134.0,1666.7],[-1398.6,1181.0],[-1498.4,1032.3],[-1683.6,1005.0],[-1692.2,1002.8],[-1700.1,999.1],[-1707.2,993.8],[-1715.6,983.6],[-1719.4,975.6],[-1721.5,967.0],[-1721.5,953.8],[-1717.7,941.2],[-1713.1,933.6],[-1703.8,924.3],[-1692.1,918.1],[-1423.9,851.1],[-1415.1,849.8],[-1406.2,850.3],[-1397.6,852.5],[-1386.0,858.8],[-1376.6,868.3],[-1371.4,878.0],[-1205.8,951.2]]);  // Pod cheek R
}
module ff_cradle_pose(th) { translate(FF_CP) rotate([th, 0, 0]) translate(-FF_CP) children(); }
module ff_pod_pose(al) { translate(FF_PP) rotate([al - FF_ALPHA_DN, 0, 0]) translate(-FF_PP) children(); }
function ff_rot(p, c, a) = [p[0], c[1] + (p[1]-c[1])*cos(a) - (p[2]-c[2])*sin(a), c[2] + (p[1]-c[1])*sin(a) + (p[2]-c[2])*cos(a)];
module ff_ram(a, b, d_body, d_rod, body_len, col = "#9aa0a6") {
  v = b - a; L = norm(v);
  color(col) hull() { translate(a) sphere(d = d_body); translate(a + v * min(body_len, L - 20) / L) sphere(d = d_body); }
  color("#d0d0d0") hull() { translate(a + v * min(body_len, L - 20) / L) sphere(d = d_rod); translate(b) sphere(d = d_rod); }
}
module ff_mechanisms(th, al) {
  ff_ram([-560.0,-20.0,30.0], ff_rot([-560.0,-360.0,190.0], FF_CP, th), 55, 22, 336, "#3b5b8a");
  ff_ram([-773.0,-1402.0,310.0], ff_rot([-773.0,-1677.0,960.4], FF_PP, al - FF_ALPHA_DN), 55, 22, 396, "#3b5b8a");
  ff_ram([-870.0,-1502.0,1050.0], ff_rot([-870.0,-1413.0,894.8], FF_PP, al - FF_ALPHA_DN), 28, 12, 149, "#222");
  ff_ram([560.0,-20.0,30.0], ff_rot([560.0,-360.0,190.0], FF_CP, th), 55, 22, 336, "#3b5b8a");
  ff_ram([870.0,-1502.0,1050.0], ff_rot([870.0,-1413.0,894.8], FF_PP, al - FF_ALPHA_DN), 28, 12, 149, "#222");
  color("#999") translate([-906.0,-840.0,200.0]) rotate([0,90,0]) cylinder(d = 25, h = 1812);
  for (s = [-1, 1]) color("#999") translate([0.0,-1375.0,1005.0] + [s > 0 ? 650 : -950, 0, 0]) rotate([0,90,0]) cylinder(d = 25, h = 300);
}
module ff_kid_PILOT() {
  hull() { translate([-460.0,-815.0,1165.0]) sphere(r = 95); translate([-460.0,-815.0,1165.0]) sphere(r = 95); }
  hull() { translate([-460.0,-830.0,1040.0]) sphere(r = 50); translate([-460.0,-815.0,1165.0]) sphere(r = 50); }
  hull() { translate([-460.0,-845.0,960.0]) sphere(r = 115); translate([-460.0,-820.0,560.0]) sphere(r = 115); }
  hull() { translate([-545.0,-820.0,560.0]) sphere(r = 75); translate([-545.0,-406.0,677.0]) sphere(r = 75); }
  hull() { translate([-545.0,-406.0,677.0]) sphere(r = 50); translate([-545.0,-420.0,300.0]) sphere(r = 50); }
  hull() { translate([-545.0,-420.0,300.0]) sphere(r = 45); translate([-545.0,-372.0,265.0]) sphere(r = 45); }
  hull() { translate([-610.0,-845.0,960.0]) sphere(r = 45); translate([-610.0,-830.0,720.0]) sphere(r = 45); }
  hull() { translate([-610.0,-830.0,720.0]) sphere(r = 40); translate([-570.0,-640.0,640.0]) sphere(r = 40); }
  hull() { translate([-375.0,-820.0,560.0]) sphere(r = 75); translate([-375.0,-406.0,677.0]) sphere(r = 75); }
  hull() { translate([-375.0,-406.0,677.0]) sphere(r = 50); translate([-375.0,-420.0,300.0]) sphere(r = 50); }
  hull() { translate([-375.0,-420.0,300.0]) sphere(r = 45); translate([-375.0,-372.0,265.0]) sphere(r = 45); }
  hull() { translate([-310.0,-845.0,960.0]) sphere(r = 45); translate([-310.0,-830.0,720.0]) sphere(r = 45); }
  hull() { translate([-310.0,-830.0,720.0]) sphere(r = 40); translate([-350.0,-640.0,640.0]) sphere(r = 40); }
}
module ff_kid_OPS() {
  hull() { translate([460.0,-825.0,1015.0]) sphere(r = 85); translate([460.0,-825.0,1015.0]) sphere(r = 85); }
  hull() { translate([460.0,-840.0,915.0]) sphere(r = 38); translate([460.0,-825.0,1015.0]) sphere(r = 38); }
  hull() { translate([460.0,-850.0,860.0]) sphere(r = 85); translate([460.0,-840.0,545.0]) sphere(r = 85); }
  hull() { translate([395.0,-840.0,545.0]) sphere(r = 55); translate([395.0,-545.0,560.0]) sphere(r = 55); }
  hull() { translate([395.0,-545.0,560.0]) sphere(r = 38); translate([395.0,-505.0,300.0]) sphere(r = 38); }
  hull() { translate([395.0,-505.0,300.0]) sphere(r = 35); translate([395.0,-450.0,245.0]) sphere(r = 35); }
  hull() { translate([350.0,-850.0,860.0]) sphere(r = 33); translate([350.0,-850.0,690.0]) sphere(r = 33); }
  hull() { translate([350.0,-850.0,690.0]) sphere(r = 28); translate([390.0,-700.0,600.0]) sphere(r = 28); }
  hull() { translate([525.0,-840.0,545.0]) sphere(r = 55); translate([525.0,-545.0,560.0]) sphere(r = 55); }
  hull() { translate([525.0,-545.0,560.0]) sphere(r = 38); translate([525.0,-505.0,300.0]) sphere(r = 38); }
  hull() { translate([525.0,-505.0,300.0]) sphere(r = 35); translate([525.0,-450.0,245.0]) sphere(r = 35); }
  hull() { translate([570.0,-850.0,860.0]) sphere(r = 33); translate([570.0,-850.0,690.0]) sphere(r = 33); }
  hull() { translate([570.0,-850.0,690.0]) sphere(r = 28); translate([530.0,-700.0,600.0]) sphere(r = 28); }
}
module ff_dad() {
  hull() { translate([0.0,-2265.0,1460.0]) sphere(r = 105); translate([0.0,-2265.0,1460.0]) sphere(r = 105); }
  hull() { translate([0.0,-2280.0,1330.0]) sphere(r = 60); translate([0.0,-2265.0,1460.0]) sphere(r = 60); }
  hull() { translate([0.0,-2290.0,1240.0]) sphere(r = 150); translate([0.0,-2280.0,790.0]) sphere(r = 150); }
  hull() { translate([-100.0,-2280.0,790.0]) sphere(r = 90); translate([-100.0,-1855.0,790.0]) sphere(r = 90); }
  hull() { translate([-100.0,-1855.0,790.0]) sphere(r = 60); translate([-100.0,-1810.0,330.0]) sphere(r = 60); }
  hull() { translate([-100.0,-1810.0,330.0]) sphere(r = 50); translate([-100.0,-1720.0,270.0]) sphere(r = 50); }
  hull() { translate([-210.0,-2290.0,1240.0]) sphere(r = 55); translate([-210.0,-2230.0,990.0]) sphere(r = 55); }
  hull() { translate([-210.0,-2230.0,990.0]) sphere(r = 50); translate([-170.0,-1980.0,860.0]) sphere(r = 50); }
  hull() { translate([100.0,-2280.0,790.0]) sphere(r = 90); translate([100.0,-1855.0,790.0]) sphere(r = 90); }
  hull() { translate([100.0,-1855.0,790.0]) sphere(r = 60); translate([100.0,-1810.0,330.0]) sphere(r = 60); }
  hull() { translate([100.0,-1810.0,330.0]) sphere(r = 50); translate([100.0,-1720.0,270.0]) sphere(r = 50); }
  hull() { translate([210.0,-2290.0,1240.0]) sphere(r = 55); translate([210.0,-2230.0,990.0]) sphere(r = 55); }
  hull() { translate([210.0,-2230.0,990.0]) sphere(r = 50); translate([170.0,-1980.0,860.0]) sphere(r = 50); }
}
module at_PILOT_DASH_A() multmatrix([[1.0000,0.0000,-0.0000,-660.0000],[0.0000,-0.6428,-0.7660,-668.9657],[0.0000,0.7660,-0.6428,1107.9054],[0.0000,0.0000,0.0000,1.0000]]) children();
module at_PILOT_DASH_B() multmatrix([[1.0000,0.0000,-0.0000,-460.0000],[0.0000,-0.6428,-0.7660,-668.9657],[0.0000,0.7660,-0.6428,1107.9054],[0.0000,0.0000,0.0000,1.0000]]) children();
module at_OPS_DASH_A() multmatrix([[1.0000,0.0000,-0.0000,260.0000],[0.0000,-0.6428,-0.7660,-668.9657],[0.0000,0.7660,-0.6428,1107.9054],[0.0000,0.0000,0.0000,1.0000]]) children();
module at_OPS_DASH_B() multmatrix([[1.0000,0.0000,-0.0000,460.0000],[0.0000,-0.6428,-0.7660,-668.9657],[0.0000,0.7660,-0.6428,1107.9054],[0.0000,0.0000,0.0000,1.0000]]) children();
module at_OVERHEAD_A() multmatrix([[1.0000,0.0000,-0.0000,-300.0000],[0.0000,-0.6428,-0.7660,-1044.9964],[0.0000,0.7660,-0.6428,1556.0414],[0.0000,0.0000,0.0000,1.0000]]) children();
module at_OVERHEAD_B() multmatrix([[1.0000,0.0000,-0.0000,-100.0000],[0.0000,-0.6428,-0.7660,-1044.9964],[0.0000,0.7660,-0.6428,1556.0414],[0.0000,0.0000,0.0000,1.0000]]) children();
module at_OVERHEAD_C() multmatrix([[1.0000,0.0000,-0.0000,100.0000],[0.0000,-0.6428,-0.7660,-1044.9964],[0.0000,0.7660,-0.6428,1556.0414],[0.0000,0.0000,0.0000,1.0000]]) children();
module at_PILOT_SIDE() multmatrix([[1.0000,0.0000,0.0000,-830.0000],[0.0000,1.0000,-0.0000,-790.0000],[0.0000,0.0000,1.0000,603.5000],[0.0000,0.0000,0.0000,1.0000]]) children();
module at_OPS_SIDE() multmatrix([[1.0000,0.0000,0.0000,30.0000],[0.0000,1.0000,-0.0000,-550.0000],[0.0000,0.0000,1.0000,473.5000],[0.0000,0.0000,0.0000,1.0000]]) children();
module at_CMD_A() multmatrix([[1.0000,0.0000,0.0000,320.0000],[0.0000,1.0000,-0.0000,-2000.0000],[0.0000,0.0000,1.0000,953.5000],[0.0000,0.0000,0.0000,1.0000]]) children();
module at_CMD_B() multmatrix([[1.0000,0.0000,0.0000,320.0000],[0.0000,1.0000,-0.0000,-2195.0000],[0.0000,0.0000,1.0000,953.5000],[0.0000,0.0000,0.0000,1.0000]]) children();
module at_throttle() multmatrix([[1.0000,0.0000,0.0000,-785.0000],[0.0000,1.0000,-0.0000,-620.0000],[0.0000,0.0000,1.0000,603.5000],[0.0000,0.0000,0.0000,1.0000]]) children();
module at_gear() multmatrix([[1.0000,0.0000,0.0000,-680.0000],[0.0000,1.0000,-0.0000,-620.0000],[0.0000,0.0000,1.0000,603.5000],[0.0000,0.0000,0.0000,1.0000]]) children();
module at_joystick_pilot() multmatrix([[1.0000,0.0000,0.0000,-170.0000],[0.0000,1.0000,-0.0000,-480.0000],[0.0000,0.0000,1.0000,473.0000],[0.0000,0.0000,0.0000,1.0000]]) children();
module at_joystick_ops() multmatrix([[1.0000,0.0000,0.0000,730.0000],[0.0000,1.0000,-0.0000,-680.0000],[0.0000,0.0000,1.0000,603.0000],[0.0000,0.0000,0.0000,1.0000]]) children();
module at_bezel() multmatrix([[1.0000,0.0000,0.0000,0.0000],[0.0000,1.0000,-0.0000,-750.0000],[0.0000,0.0000,1.0000,560.0000],[0.0000,0.0000,0.0000,1.0000]]) children();
module at_monitor_L() multmatrix([[1.0000,0.0000,-0.0000,-460.0000],[0.0000,-0.6428,-0.7660,-915.3733],[0.0000,0.7660,-0.6428,1390.6726],[0.0000,0.0000,0.0000,1.0000]]) children();
module at_monitor_R() multmatrix([[1.0000,0.0000,-0.0000,460.0000],[0.0000,-0.6428,-0.7660,-915.3733],[0.0000,0.7660,-0.6428,1390.6726],[0.0000,0.0000,0.0000,1.0000]]) children();
PLACE_GROUP = [["PILOT_DASH_A", "pod"], ["PILOT_DASH_B", "pod"], ["OPS_DASH_A", "pod"], ["OPS_DASH_B", "pod"], ["OVERHEAD_A", "pod"], ["OVERHEAD_B", "pod"], ["OVERHEAD_C", "pod"], ["PILOT_SIDE", "cradle"], ["OPS_SIDE", "cradle"], ["CMD_A", "fixed"], ["CMD_B", "fixed"], ["throttle", "cradle"], ["gear", "cradle"], ["joystick_pilot", "cradle"], ["joystick_ops", "cradle"], ["bezel", "cradle"], ["monitor_L", "pod"], ["monitor_R", "pod"]];
