whyvas/filament-falcon/cad/panels/CMD_A.scad

// GENERATED by cad/tools/gen_panels.py from cad/tools/layouts.py - edit the layout there.
// Commander console, game controls: dad's right-hand console on the fixed rear dais
// Nominal 200 x 200 mm (printed 199.5 x 199.5).
PART = "preview";
PANEL_ID = "CMD_A";
W = 200;
H = 200;
SEAM_L = false;
SEAM_R = false;
CUTS = [["key19", 38, 146], ["ec11", 105, 146], ["ec11", 165, 146], ["arc22", 32, 92], ["arc22", 82, 92], ["arc19", 130, 92], ["btn16", 175, 92], ["arc22", 50, 40], ["led5", 127, 38], ["led5", 163, 38]];
SLOTS = [];
GROOVES = [];
LABELS = [
  ["MASTER_POWER", 38, 168, 57.28, 12.6,
   [[[16.407,170.742],[16.461,170.695],[16.475,170.632],[16.475,165.368],[16.454,165.293],[16.407,165.258],[16.357,165.25],[15.116,165.25],[15.067,165.258],[15.02,165.293],[14.998,165.368],[14.996,168.584],[14.972,168.607],[14.949,168.591],[14.409,167.686],[13.885,168.591],[13.861,168.609],[13.84,168.596],[13.835,168.566],[13.827,165.319],[13.78,165.264],[13.717,165.25],[12.476,165.25],[12.401,165.272],[12.366,165.319],[12.358,165.368],[12.358,170.632],[12.38,170.707],[12.427,170.742],[12.476,170.75],[13.702,170.75],[13.788,170.728],[13.828,170.69],[14.393,169.658],[14.435,169.63],[14.99,170.664],[15.049,170.728],[15.132,170.75],[19.651,165.97],[19.602,165.996],[18.911,165.996],[18.877,165.986],[18.857,165.955],[18.772,165.326],[18.742,165.278],[18.688,165.253],[17.418,165.25],[17.351,165.264],[17.317,165.306],[17.316,165.376],[18.432,170.648],[18.477,170.724],[18.531,170.747],[19.995,170.75],[20.059,170.739],[20.119,170.679],[21.245,165.376],[21.232,165.292],[21.196,165.26],[21.135,165.25],[19.87,165.25],[19.803,165.262],[19.75,165.326],[19.475,167.14],[19.265,168.589],[19.241,168.621],[19.217,168.589],[19.03,167.161],[19.039,167.14],[19.068,167.128],[19.437,167.128],[22.093,166.957],[22.14,167.012],[22.203,167.026],[23.463,167.022],[23.504,167.004],[23.539,166.957],[23.562,166.621],[23.59,166.558],[23.655,166.487],[23.736,166.454],[23.853,166.47],[23.943,166.548],[23.98,166.635],[23.987,166.704],[23.973,166.792],[23.931,166.88],[23.861,166.967],[23.571,167.208],[22.976,167.643],[22.603,167.961],[22.376,168.238],[22.185,168.574],[22.138,168.698],[22.075,168.962],[22.054,169.249],[22.06,169.401],[22.077,169.546],[22.146,169.818],[22.199,169.946],[22.336,170.18],[22.514,170.381],[22.617,170.468],[22.851,170.616],[23.118,170.726],[23.41,170.791],[23.566,170.807],[23.892,170.807],[24.2,170.764],[24.481,170.676],[24.611,170.616],[24.846,170.468],[24.949,170.381],[25.127,170.18],[25.264,169.946],[25.316,169.818],[25.386,169.546],[25.403,169.401],[25.408,169.059],[25.377,168.99],[25.291,168.959],[24.024,168.966],[23.977,169.001],[23.959,169.042],[23.954,169.319],[23.927,169.419],[23.846,169.515],[23.76,169.546],[23.664,169.539],[23.587,169.493],[23.522,169.377],[23.508,169.257],[23.521,169.154],[23.563,169.053],[23.682,168.903],[23.913,168.703],[24.577,168.2],[24.894,167.937],[25.122,167.695],[25.295,167.423],[25.376,167.22],[25.424,166.996],[25.44,166.751],[25.427,166.52],[25.389,166.306],[25.324,166.108],[25.234,165.927],[25.118,165.761],[24.977,165.611],[24.814,165.482],[24.635,165.376],[24.441,165.293],[24.229,165.234],[24.002,165.199],[23.595,165.192],[23.287,165.234],[23.008,165.318],[22.879,165.376],[22.646,165.518],[22.451,165.692],[22.294,165.898],[22.178,166.132],[22.108,166.387],[22.085,166.664],[29.866,169.54],[29.825,169.499],[29.779,169.486],[28.835,169.485],[28.808,169.48],[28.789,169.452],[28.788,165.368],[28.774,165.305],[28.733,165.264],[28.67,165.25],[27.428,165.25],[27.365,165.264],[27.324,165.305],[27.31,165.368],[27.309,169.452],[27.289,169.48],[27.263,169.485],[26.342,169.486],[26.264,169.528],[26.242,169.603],[26.242,170.632],[26.256,170.695],[26.297,170.736],[26.36,170.75],[29.811,170.742],[29.866,170.695],[29.88,170.632],[29.88,169.603],[32.258,169.464],[32.252,168.684],[32.264,168.648],[32.3,168.636],[33.095,168.636],[33.174,168.594],[33.195,168.519],[33.195,167.489],[33.181,167.426],[33.14,167.385],[33.095,167.372],[32.3,167.371],[32.264,167.36],[32.252,167.324],[32.258,166.536],[32.3,166.515],[33.8,166.515],[33.876,166.493],[33.91,166.446],[33.918,166.397],[33.918,165.368],[33.904,165.305],[33.849,165.258],[30.893,165.25],[30.83,165.264],[30.783,165.319],[30.775,170.632],[30.789,170.695],[30.83,170.736],[30.893,170.75],[33.8,170.75],[33.849,170.742],[33.896,170.707],[33.918,170.632],[33.918,169.603],[33.91,169.554],[33.876,169.507],[33.8,169.485],[32.3,169.485],[36.333,167.359],[36.305,167.358],[36.291,167.316],[36.291,165.368],[36.269,165.293],[36.222,165.258],[36.173,165.25],[34.932,165.25],[34.856,165.272],[34.822,165.319],[34.814,165.368],[34.814,170.632],[34.828,170.695],[34.883,170.742],[36.7,170.75],[37.002,170.725],[37.145,170.694],[37.412,170.594],[37.654,170.447],[37.862,170.259],[38.034,170.033],[38.168,169.77],[38.259,169.48],[38.305,169.165],[38.294,168.72],[38.244,168.462],[38.108,168.114],[37.978,167.915],[37.82,167.744],[37.72,167.662],[37.704,167.62],[38.346,165.372],[38.347,165.315],[38.322,165.274],[38.24,165.25],[36.959,165.25],[36.876,165.276],[36.833,165.352],[36.354,167.324],[36.296,169.464],[36.292,168.52],[36.303,168.499],[36.338,168.487],[36.549,168.502],[36.685,168.577],[36.784,168.715],[36.83,168.907],[36.83,169.06],[36.807,169.197],[36.727,169.355],[36.602,169.453],[36.44,169.485],[36.324,169.484],[44.466,168.094],[44.398,167.971],[44.236,167.753],[44.039,167.575],[43.81,167.437],[43.555,167.345],[43.418,167.316],[43.127,167.293],[42.687,167.293],[42.645,167.272],[42.64,165.368],[42.632,165.319],[42.597,165.272],[42.522,165.25],[41.28,165.25],[41.231,165.258],[41.184,165.293],[41.163,165.368],[41.163,170.632],[41.17,170.681],[41.205,170.728],[41.28,170.75],[43.202,170.744],[43.493,170.694],[43.63,170.65],[43.76,170.594],[44.002,170.447],[44.21,170.258],[44.382,170.03],[44.517,169.765],[44.608,169.471],[44.653,169.152],[44.659,168.982],[44.638,168.66],[44.573,168.364],[43.108,169.298],[43.038,169.39],[42.901,169.47],[42.687,169.485],[42.645,169.464],[42.64,168.479],[42.661,168.437],[42.847,168.436],[42.951,168.465],[43.038,168.522],[43.108,168.609],[43.155,168.724],[43.182,168.951],[43.155,169.18],[45.79,170.197],[45.936,170.357],[46.103,170.496],[46.288,170.61],[46.491,170.699],[46.711,170.762],[46.949,170.8],[47.205,170.813],[47.46,170.8],[47.698,170.762],[47.919,170.699],[48.121,170.61],[48.306,170.496],[48.474,170.357],[48.619,170.197],[48.738,170.018],[48.83,169.823],[48.896,169.61],[48.936,169.379],[48.949,169.131],[48.949,166.869],[48.936,166.621],[48.896,166.39],[48.83,166.177],[48.738,165.982],[48.619,165.803],[48.474,165.643],[48.306,165.504],[48.121,165.39],[47.919,165.301],[47.698,165.238],[47.46,165.2],[47.205,165.187],[46.949,165.2],[46.711,165.238],[46.491,165.301],[46.288,165.39],[46.103,165.504],[45.936,165.643],[45.79,165.803],[45.672,165.982],[45.579,166.177],[45.513,166.39],[45.474,166.621],[45.46,166.869],[45.46,169.131],[45.474,169.379],[45.513,169.61],[45.579,169.823],[45.672,170.018],[47.44,169.383],[47.376,169.482],[47.317,169.524],[47.245,169.545],[47.127,169.537],[47.061,169.506],[46.987,169.42],[46.939,169.247],[46.939,166.753],[46.969,166.617],[47.008,166.546],[47.093,166.476],[47.164,166.455],[47.282,166.463],[47.376,166.518],[47.44,166.617],[47.47,166.753],[47.472,169.194],[49.786,170.708],[49.823,170.74],[49.884,170.75],[51.165,170.75],[51.231,170.738],[51.273,170.701],[51.29,170.64],[51.558,168.244],[51.588,168.223],[51.604,168.236],[51.913,170.701],[51.955,170.738],[52.021,170.75],[52.98,170.75],[53.07,170.722],[53.105,170.64],[53.436,168.231],[53.471,168.216],[53.49,168.236],[53.718,170.64],[53.735,170.701],[53.774,170.738],[53.836,170.75],[55.085,170.75],[55.18,170.719],[55.195,170.624],[54.19,165.352],[54.144,165.276],[54.056,165.25],[52.972,165.25],[52.905,165.262],[52.864,165.299],[52.515,167.889],[52.489,167.906],[52.462,167.889],[52.194,165.36],[52.176,165.299],[52.135,165.262],[52.068,165.25],[50.976,165.25],[50.912,165.261],[50.868,165.295],[50.843,165.352],[49.774,170.624],[57.55,169.464],[57.545,168.684],[57.556,168.648],[57.592,168.636],[58.387,168.636],[58.466,168.594],[58.487,168.519],[58.487,167.489],[58.474,167.426],[58.432,167.385],[58.387,167.372],[57.592,167.371],[57.556,167.36],[57.545,167.324],[57.55,166.536],[57.592,166.515],[59.093,166.515],[59.168,166.493],[59.203,166.446],[59.21,166.397],[59.21,165.368],[59.196,165.305],[59.142,165.258],[56.185,165.25],[56.123,165.264],[56.075,165.319],[56.068,170.632],[56.081,170.695],[56.123,170.736],[56.185,170.75],[59.093,170.75],[59.142,170.742],[59.189,170.707],[59.21,170.632],[59.21,169.603],[59.203,169.554],[59.168,169.507],[59.093,169.485],[57.592,169.485],[61.62,167.362],[61.591,167.352],[61.583,167.316],[61.583,165.368],[61.561,165.293],[61.514,165.258],[61.465,165.25],[60.224,165.25],[60.149,165.272],[60.114,165.319],[60.106,165.368],[60.106,170.632],[60.12,170.695],[60.175,170.742],[61.992,170.75],[62.294,170.725],[62.437,170.694],[62.704,170.594],[62.946,170.447],[63.154,170.259],[63.326,170.033],[63.461,169.77],[63.551,169.48],[63.597,169.165],[63.586,168.72],[63.536,168.462],[63.4,168.114],[63.271,167.915],[63.112,167.744],[63.012,167.662],[62.996,167.62],[63.638,165.372],[63.639,165.315],[63.614,165.274],[63.532,165.25],[62.251,165.25],[62.169,165.276],[62.125,165.352],[61.646,167.324],[61.585,169.452],[61.585,168.52],[61.595,168.499],[61.63,168.487],[61.841,168.502],[61.977,168.577],[62.076,168.715],[62.122,168.907],[62.122,169.06],[62.099,169.197],[62.019,169.355],[61.895,169.453],[61.791,169.481],[61.63,169.485],[61.604,169.48]],[[0,1,2,3,4,5,6,7,8,9,10,11,12,13,14,15,16,17,18,19,20,21,22,23,24,25,26,27,28,29,30,31,32,33,34,35,36,37],[38,39,40,41,42,43,44,45,46,47,48,49,50,51,52,53,54,55,56,57,58,59,60,61,62],[63,64,65,66,67,68,69,70],[71,72,73,74,75,76,77,78,79,80,81,82,83,84,85,86,87,88,89,90,91,92,93,94,95,96,97,98,99,100,101,102,103,104,105,106,107,108,109,110,111,112,113,114,115,116,117,118,119,120,121,122,123,124,125,126,127,128,129,130,131,132,133,134,135,136,137,138,139,140,141,142,143,144,145,146,147,148,149,150,151,152,153,154,155,156,157,158,159,160,161,162,163],[164,165,166,167,168,169,170,171,172,173,174,175,176,177,178,179,180,181,182,183,184,185,186,187,188,189,190,191],[192,193,194,195,196,197,198,199,200,201,202,203,204,205,206,207,208,209,210,211,212,213,214,215,216,217,218,219,220,221,222,223,224,225,226,227,228,229,230],[231,232,233,234,235,236,237,238,239,240,241,242,243,244,245,246,247,248,249,250,251,252,253,254,255,256,257,258,259,260,261,262,263,264,265,266,267,268,269],[270,271,272,273,274,275,276,277,278,279,280,281,282,283],[284,285,286,287,288,289,290,291,292,293,294,295,296,297,298,299,300,301,302,303,304,305,306,307,308,309,310,311,312,313,314,315,316,317,318],[319,320,321,322,323,324,325,326,327,328,329,330,331,332],[333,334,335,336,337,338,339,340,341,342,343,344,345,346,347,348,349,350,351,352,353,354,355,356,357,358,359,360,361,362,363,364,365,366,367,368,369,370,371,372,373,374,375,376,377,378,379,380,381,382],[383,384,385,386,387,388,389,390,391,392,393,394,395,396,397,398,399,400],[401,402,403,404,405,406,407,408,409,410,411,412,413,414,415,416,417,418,419,420,421,422,423,424,425,426,427,428,429,430,431,432,433,434,435,436,437,438,439,440,441,442,443,444],[445,446,447,448,449,450,451,452,453,454,455,456,457,458,459,460,461,462,463,464,465,466,467,468,469,470,471,472,473,474,475,476,477,478,479,480,481,482,483],[484,485,486,487,488,489,490,491,492,493,494,495,496,497,498,499,500,501,502,503,504,505,506,507,508,509,510,511,512,513,514,515,516,517,518,519,520,521,522],[523,524,525,526,527,528,529,530,531,532,533,534,535,536,537]]],
   [[[37.762,170.358],[37.952,170.151],[38.106,169.905],[38.22,169.628],[38.288,169.326],[38.305,169.165],[38.306,168.856],[38.273,168.588],[38.207,168.34],[38.047,168.01],[37.903,167.826],[37.72,167.662],[37.704,167.62],[38.346,165.372],[38.347,165.315],[38.322,165.274],[38.24,165.25],[37.133,165.25],[37.133,170.697],[37.412,170.594],[37.536,170.526],[16.42,170.736],[16.461,170.695],[16.475,170.632],[16.475,165.368],[16.454,165.293],[16.407,165.258],[16.357,165.25],[15.116,165.25],[15.067,165.258],[15.02,165.293],[14.998,165.368],[14.996,168.584],[14.972,168.607],[14.949,168.591],[14.409,167.686],[13.885,168.591],[13.861,168.609],[13.84,168.596],[13.835,168.566],[13.827,165.319],[13.78,165.264],[13.717,165.25],[12.476,165.25],[12.401,165.272],[12.366,165.319],[12.358,165.368],[12.358,170.632],[12.38,170.707],[12.427,170.742],[12.476,170.75],[13.702,170.75],[13.788,170.728],[13.828,170.69],[14.393,169.658],[14.435,169.63],[14.99,170.664],[15.049,170.728],[15.132,170.75],[16.357,170.75],[17.312,165.337],[18.432,170.648],[18.457,170.705],[18.502,170.739],[18.649,170.75],[18.649,165.25],[17.418,165.25],[17.33,165.281],[20.119,170.679],[21.245,165.376],[21.232,165.292],[21.168,165.253],[19.849,165.252],[19.849,170.75],[20.03,170.747],[20.084,170.724],[22.099,166.971],[22.14,167.012],[22.203,167.026],[23.463,167.022],[23.504,167.004],[23.539,166.957],[23.562,166.621],[23.59,166.558],[23.655,166.487],[23.736,166.454],[23.853,166.47],[23.943,166.548],[23.98,166.635],[23.987,166.704],[23.973,166.792],[23.931,166.88],[23.861,166.967],[23.571,167.208],[22.976,167.643],[22.603,167.961],[22.376,168.238],[22.185,168.574],[22.138,168.698],[22.075,168.962],[22.054,169.249],[22.06,169.401],[22.077,169.546],[22.146,169.818],[22.199,169.946],[22.336,170.18],[22.514,170.381],[22.617,170.468],[22.851,170.616],[23.118,170.726],[23.41,170.791],[23.566,170.807],[23.892,170.807],[24.2,170.764],[24.481,170.676],[24.611,170.616],[24.846,170.468],[24.949,170.381],[25.127,170.18],[25.264,169.946],[25.316,169.818],[25.386,169.546],[25.403,169.401],[25.408,169.059],[25.377,168.99],[25.291,168.959],[24.024,168.966],[23.977,169.001],[23.959,169.042],[23.954,169.319],[23.927,169.419],[23.846,169.515],[23.76,169.546],[23.664,169.539],[23.587,169.493],[23.522,169.377],[23.508,169.257],[23.521,169.154],[23.563,169.053],[23.682,168.903],[23.913,168.703],[24.577,168.2],[24.894,167.937],[25.122,167.695],[25.295,167.423],[25.376,167.22],[25.424,166.996],[25.44,166.751],[25.427,166.52],[25.389,166.306],[25.324,166.108],[25.234,165.927],[25.118,165.761],[24.977,165.611],[24.814,165.482],[24.635,165.376],[24.441,165.293],[24.229,165.234],[24.002,165.199],[23.595,165.192],[23.287,165.234],[23.008,165.318],[22.758,165.443],[22.544,165.601],[22.368,165.791],[22.23,166.012],[22.178,166.132],[22.108,166.387],[22.085,166.664],[22.085,166.908],[29.866,169.54],[29.825,169.499],[29.779,169.486],[28.835,169.485],[28.808,169.48],[28.789,169.452],[28.788,165.368],[28.774,165.305],[28.733,165.264],[28.67,165.25],[27.428,165.25],[27.365,165.264],[27.324,165.305],[27.31,165.368],[27.309,169.452],[27.289,169.48],[27.263,169.485],[26.342,169.486],[26.264,169.528],[26.242,169.603],[26.242,170.632],[26.256,170.695],[26.297,170.736],[26.36,170.75],[29.811,170.742],[29.866,170.695],[29.88,170.632],[29.88,169.603],[32.258,169.464],[32.252,168.684],[32.264,168.648],[32.3,168.636],[33.095,168.636],[33.174,168.594],[33.195,168.519],[33.195,167.489],[33.181,167.426],[33.14,167.385],[33.095,167.372],[32.3,167.371],[32.264,167.36],[32.252,167.324],[32.258,166.536],[32.3,166.515],[33.8,166.515],[33.876,166.493],[33.91,166.446],[33.918,166.397],[33.918,165.368],[33.904,165.305],[33.849,165.258],[30.893,165.25],[30.83,165.264],[30.783,165.319],[30.775,170.632],[30.789,170.695],[30.83,170.736],[30.893,170.75],[33.8,170.75],[33.849,170.742],[33.896,170.707],[33.918,170.632],[33.918,169.603],[33.91,169.554],[33.876,169.507],[33.8,169.485],[32.3,169.485],[34.856,165.272],[34.822,165.319],[34.814,165.368],[34.817,170.666],[34.856,170.728],[34.914,170.749],[35.933,170.75],[35.933,165.25],[34.932,165.25],[63.054,170.358],[63.244,170.151],[63.398,169.905],[63.512,169.628],[63.58,169.326],[63.597,169.165],[63.598,168.856],[63.565,168.588],[63.499,168.34],[63.339,168.01],[63.195,167.826],[63.012,167.662],[62.996,167.62],[63.638,165.372],[63.639,165.315],[63.614,165.274],[63.532,165.25],[62.425,165.25],[62.425,170.697],[62.704,170.594],[62.829,170.526],[41.205,165.272],[41.17,165.319],[41.163,165.368],[41.166,170.666],[41.205,170.728],[41.263,170.749],[42.283,170.75],[42.283,165.25],[41.28,165.25],[46.103,170.496],[46.288,170.61],[46.491,170.699],[46.605,170.732],[46.605,165.268],[46.491,165.301],[46.288,165.39],[46.103,165.504],[45.936,165.643],[45.79,165.803],[45.672,165.982],[45.579,166.177],[45.513,166.39],[45.474,166.621],[45.46,166.869],[45.46,169.131],[45.474,169.379],[45.513,169.61],[45.579,169.823],[45.672,170.018],[45.79,170.197],[45.936,170.357],[49.801,170.726],[49.884,170.75],[51.165,170.75],[51.231,170.738],[51.273,170.701],[51.29,170.64],[51.558,168.244],[51.588,168.223],[51.604,168.236],[51.913,170.701],[51.955,170.738],[52.021,170.75],[52.98,170.75],[53.07,170.722],[53.105,170.64],[53.436,168.231],[53.471,168.216],[53.49,168.236],[53.718,170.64],[53.735,170.701],[53.774,170.738],[53.836,170.75],[55.085,170.75],[55.18,170.719],[55.195,170.624],[54.19,165.352],[54.144,165.276],[54.056,165.25],[52.972,165.25],[52.905,165.262],[52.864,165.299],[52.515,167.889],[52.489,167.906],[52.462,167.889],[52.194,165.36],[52.176,165.299],[52.135,165.262],[52.068,165.25],[50.976,165.25],[50.912,165.261],[50.868,165.295],[50.843,165.352],[49.774,170.624],[49.777,170.685],[57.55,169.464],[57.545,168.684],[57.556,168.648],[57.592,168.636],[58.387,168.636],[58.466,168.594],[58.487,168.519],[58.487,167.489],[58.474,167.426],[58.432,167.385],[58.387,167.372],[57.592,167.371],[57.556,167.36],[57.545,167.324],[57.55,166.536],[57.592,166.515],[59.093,166.515],[59.168,166.493],[59.203,166.446],[59.21,166.397],[59.21,165.368],[59.196,165.305],[59.142,165.258],[56.185,165.25],[56.123,165.264],[56.075,165.319],[56.068,170.632],[56.081,170.695],[56.123,170.736],[56.185,170.75],[59.093,170.75],[59.142,170.742],[59.189,170.707],[59.21,170.632],[59.21,169.603],[59.203,169.554],[59.168,169.507],[59.093,169.485],[57.592,169.485],[60.149,165.272],[60.114,165.319],[60.106,165.368],[60.11,170.666],[60.149,170.728],[60.206,170.749],[61.225,170.75],[61.225,165.25],[60.224,165.25],[48.738,170.018],[48.83,169.823],[48.896,169.61],[48.936,169.379],[48.949,169.131],[48.949,166.869],[48.936,166.621],[48.896,166.39],[48.83,166.177],[48.738,165.982],[48.619,165.803],[48.474,165.643],[48.306,165.504],[48.121,165.39],[47.919,165.301],[47.805,165.268],[47.805,170.732],[47.919,170.699],[48.121,170.61],[48.306,170.496],[48.474,170.357],[48.619,170.197],[44.321,167.857],[44.142,167.66],[43.928,167.501],[43.686,167.385],[43.483,167.33],[43.483,170.696],[43.76,170.594],[43.885,170.526],[44.111,170.357],[44.301,170.149],[44.382,170.03],[44.517,169.765],[44.568,169.621],[44.608,169.471],[44.653,169.152],[44.659,168.982],[44.638,168.66],[44.611,168.509],[44.525,168.226],[44.466,168.094]],[[0,1,2,3,4,5,6,7,8,9,10,11,12,13,14,15,16,17,18,19,20],[21,22,23,24,25,26,27,28,29,30,31,32,33,34,35,36,37,38,39,40,41,42,43,44,45,46,47,48,49,50,51,52,53,54,55,56,57,58,59],[60,61,62,63,64,65,66,67],[68,69,70,71,72,73,74,75],[76,77,78,79,80,81,82,83,84,85,86,87,88,89,90,91,92,93,94,95,96,97,98,99,100,101,102,103,104,105,106,107,108,109,110,111,112,113,114,115,116,117,118,119,120,121,122,123,124,125,126,127,128,129,130,131,132,133,134,135,136,137,138,139,140,141,142,143,144,145,146,147,148,149,150,151,152,153,154,155,156,157,158,159,160,161,162,163,164,165,166,167,168,169],[170,171,172,173,174,175,176,177,178,179,180,181,182,183,184,185,186,187,188,189,190,191,192,193,194,195,196,197],[198,199,200,201,202,203,204,205,206,207,208,209,210,211,212,213,214,215,216,217,218,219,220,221,222,223,224,225,226,227,228,229,230,231,232,233,234,235,236],[237,238,239,240,241,242,243,244,245],[246,247,248,249,250,251,252,253,254,255,256,257,258,259,260,261,262,263,264,265,266],[267,268,269,270,271,272,273,274,275],[276,277,278,279,280,281,282,283,284,285,286,287,288,289,290,291,292,293,294,295,296,297],[298,299,300,301,302,303,304,305,306,307,308,309,310,311,312,313,314,315,316,317,318,319,320,321,322,323,324,325,326,327,328,329,330,331,332,333,334,335,336,337,338,339,340,341],[342,343,344,345,346,347,348,349,350,351,352,353,354,355,356,357,358,359,360,361,362,363,364,365,366,367,368,369,370,371,372,373,374,375,376,377,378,379,380],[381,382,383,384,385,386,387,388,389],[390,391,392,393,394,395,396,397,398,399,400,401,402,403,404,405,406,407,408,409,410,411],[412,413,414,415,416,417,418,419,420,421,422,423,424,425,426,427,428,429,430,431]]]],
  ["MISSION", 105, 167, 32.38, 12.6,
   [[[95.845,169.747],[95.907,169.707],[95.929,169.632],[95.929,164.368],[95.907,164.293],[95.86,164.258],[95.811,164.25],[94.57,164.25],[94.521,164.258],[94.474,164.293],[94.452,164.368],[94.45,167.584],[94.426,167.607],[94.402,167.591],[93.862,166.686],[93.339,167.591],[93.315,167.609],[93.294,167.596],[93.289,167.566],[93.281,164.319],[93.234,164.264],[93.171,164.25],[91.93,164.25],[91.854,164.272],[91.82,164.319],[91.812,164.368],[91.812,169.632],[91.834,169.707],[91.881,169.742],[91.93,169.75],[93.155,169.75],[93.242,169.728],[93.282,169.69],[93.847,168.658],[93.888,168.63],[94.444,169.664],[94.503,169.728],[94.585,169.75],[96.856,169.681],[96.891,169.728],[96.948,169.749],[98.207,169.75],[98.283,169.728],[98.322,169.666],[98.325,164.368],[98.304,164.293],[98.242,164.253],[96.948,164.251],[96.891,164.272],[96.852,164.334],[99.26,165.957],[99.308,166.012],[99.37,166.026],[100.63,166.022],[100.671,166.004],[100.706,165.957],[100.73,165.621],[100.758,165.558],[100.822,165.487],[100.903,165.454],[101.02,165.47],[101.11,165.548],[101.147,165.635],[101.154,165.704],[101.14,165.792],[101.098,165.88],[101.028,165.967],[100.738,166.208],[100.143,166.643],[99.77,166.961],[99.543,167.238],[99.352,167.574],[99.268,167.827],[99.242,167.962],[99.221,168.249],[99.227,168.401],[99.273,168.685],[99.314,168.818],[99.366,168.946],[99.503,169.18],[99.587,169.285],[99.784,169.468],[100.019,169.616],[100.285,169.726],[100.577,169.791],[100.733,169.807],[101.059,169.807],[101.367,169.764],[101.648,169.676],[101.779,169.616],[102.013,169.468],[102.116,169.381],[102.294,169.18],[102.431,168.946],[102.484,168.818],[102.553,168.546],[102.57,168.401],[102.575,168.059],[102.545,167.99],[102.458,167.959],[101.191,167.966],[101.144,168.001],[101.126,168.042],[101.121,168.319],[101.095,168.419],[101.013,168.515],[100.928,168.546],[100.831,168.539],[100.754,168.493],[100.689,168.377],[100.675,168.257],[100.689,168.154],[100.731,168.053],[100.849,167.903],[101.08,167.703],[101.744,167.2],[102.061,166.937],[102.289,166.695],[102.462,166.423],[102.543,166.22],[102.591,165.996],[102.608,165.751],[102.595,165.52],[102.556,165.306],[102.492,165.108],[102.401,164.927],[102.286,164.761],[102.144,164.611],[101.981,164.482],[101.803,164.376],[101.608,164.293],[101.397,164.234],[101.169,164.199],[100.762,164.192],[100.455,164.234],[100.175,164.318],[100.046,164.376],[99.813,164.518],[99.618,164.692],[99.461,164.898],[99.345,165.132],[99.276,165.387],[99.252,165.664],[103.448,165.957],[103.495,166.012],[103.558,166.026],[104.818,166.022],[104.859,166.004],[104.894,165.957],[104.918,165.621],[104.945,165.558],[105.01,165.487],[105.091,165.454],[105.208,165.47],[105.298,165.548],[105.335,165.635],[105.342,165.704],[105.328,165.792],[105.286,165.88],[105.216,165.967],[104.926,166.208],[104.331,166.643],[103.958,166.961],[103.731,167.238],[103.54,167.574],[103.456,167.827],[103.43,167.962],[103.409,168.249],[103.415,168.401],[103.432,168.546],[103.501,168.818],[103.554,168.946],[103.691,169.18],[103.775,169.285],[103.972,169.468],[104.206,169.616],[104.473,169.726],[104.765,169.791],[104.921,169.807],[105.247,169.807],[105.555,169.764],[105.836,169.676],[105.966,169.616],[106.201,169.468],[106.398,169.285],[106.482,169.18],[106.619,168.946],[106.671,168.818],[106.741,168.546],[106.758,168.401],[106.763,168.059],[106.733,167.99],[106.646,167.959],[105.379,167.966],[105.332,168.001],[105.314,168.042],[105.309,168.319],[105.282,168.419],[105.201,168.515],[105.115,168.546],[105.019,168.539],[104.942,168.493],[104.877,168.377],[104.862,168.257],[104.876,168.154],[104.918,168.053],[105.037,167.903],[105.268,167.703],[105.932,167.2],[106.249,166.937],[106.477,166.695],[106.65,166.423],[106.731,166.22],[106.779,165.996],[106.795,165.751],[106.782,165.52],[106.744,165.306],[106.679,165.108],[106.589,164.927],[106.473,164.761],[106.332,164.611],[106.169,164.482],[105.99,164.376],[105.796,164.293],[105.584,164.234],[105.357,164.199],[104.95,164.192],[104.642,164.234],[104.363,164.318],[104.234,164.376],[104.001,164.518],[103.806,164.692],[103.649,164.898],[103.533,165.132],[103.463,165.387],[103.44,165.664],[107.668,169.681],[107.702,169.728],[107.76,169.749],[109.019,169.75],[109.094,169.728],[109.133,169.666],[109.137,164.368],[109.115,164.293],[109.053,164.253],[107.76,164.251],[107.702,164.272],[107.663,164.334],[110.259,169.018],[110.378,169.197],[110.524,169.357],[110.691,169.496],[110.876,169.61],[111.078,169.699],[111.299,169.762],[111.537,169.8],[111.793,169.813],[112.048,169.8],[112.286,169.762],[112.507,169.699],[112.709,169.61],[112.894,169.496],[113.061,169.357],[113.207,169.197],[113.326,169.018],[113.418,168.823],[113.484,168.61],[113.524,168.379],[113.537,168.131],[113.537,165.869],[113.524,165.621],[113.484,165.39],[113.418,165.177],[113.326,164.982],[113.207,164.803],[113.061,164.643],[112.894,164.504],[112.709,164.39],[112.507,164.301],[112.286,164.238],[112.048,164.2],[111.793,164.187],[111.537,164.2],[111.299,164.238],[111.078,164.301],[110.876,164.39],[110.691,164.504],[110.524,164.643],[110.378,164.803],[110.259,164.982],[110.167,165.177],[110.101,165.39],[110.061,165.621],[110.048,165.869],[110.048,168.131],[110.061,168.379],[110.101,168.61],[110.167,168.823],[112.042,168.342],[112.011,168.42],[111.936,168.506],[111.87,168.537],[111.752,168.545],[111.681,168.524],[111.596,168.454],[111.543,168.342],[111.527,168.247],[111.527,165.753],[111.543,165.658],[111.596,165.546],[111.681,165.476],[111.752,165.455],[111.87,165.463],[111.964,165.518],[112.028,165.617],[112.058,165.753],[112.06,168.194],[118.119,169.742],[118.174,169.695],[118.188,169.632],[118.188,164.368],[118.166,164.293],[118.119,164.258],[118.07,164.25],[116.672,164.25],[116.612,164.261],[116.571,164.295],[115.949,166.733],[115.918,166.756],[115.894,166.725],[115.91,164.368],[115.896,164.305],[115.855,164.264],[115.792,164.25],[114.566,164.25],[114.491,164.272],[114.456,164.319],[114.448,164.368],[114.448,169.632],[114.47,169.707],[114.517,169.742],[114.566,169.75],[115.949,169.75],[116.008,169.739],[116.05,169.705],[116.68,167.259],[116.711,167.228],[116.735,167.259],[116.727,169.632],[116.741,169.695],[116.782,169.736],[116.845,169.75]],[[0,1,2,3,4,5,6,7,8,9,10,11,12,13,14,15,16,17,18,19,20,21,22,23,24,25,26,27,28,29,30,31,32,33,34,35,36,37],[38,39,40,41,42,43,44,45,46,47,48,49],[50,51,52,53,54,55,56,57,58,59,60,61,62,63,64,65,66,67,68,69,70,71,72,73,74,75,76,77,78,79,80,81,82,83,84,85,86,87,88,89,90,91,92,93,94,95,96,97,98,99,100,101,102,103,104,105,106,107,108,109,110,111,112,113,114,115,116,117,118,119,120,121,122,123,124,125,126,127,128,129,130,131,132,133,134,135,136,137,138,139,140,141,142],[143,144,145,146,147,148,149,150,151,152,153,154,155,156,157,158,159,160,161,162,163,164,165,166,167,168,169,170,171,172,173,174,175,176,177,178,179,180,181,182,183,184,185,186,187,188,189,190,191,192,193,194,195,196,197,198,199,200,201,202,203,204,205,206,207,208,209,210,211,212,213,214,215,216,217,218,219,220,221,222,223,224,225,226,227,228,229,230,231,232,233,234,235],[236,237,238,239,240,241,242,243,244,245,246,247],[248,249,250,251,252,253,254,255,256,257,258,259,260,261,262,263,264,265,266,267,268,269,270,271,272,273,274,275,276,277,278,279,280,281,282,283,284,285,286,287,288,289,290,291,292,293,294,295,296,297],[298,299,300,301,302,303,304,305,306,307,308,309,310,311,312,313,314,315,316],[317,318,319,320,321,322,323,324,325,326,327,328,329,330,331,332,333,334,335,336,337,338,339,340,341,342,343,344,345,346,347,348,349,350,351]]],
   [[[95.86,169.742],[95.915,169.695],[95.929,169.632],[95.929,164.368],[95.907,164.293],[95.86,164.258],[95.811,164.25],[94.57,164.25],[94.521,164.258],[94.474,164.293],[94.452,164.368],[94.45,167.584],[94.426,167.607],[94.402,167.591],[93.862,166.686],[93.339,167.591],[93.315,167.609],[93.294,167.596],[93.289,167.566],[93.281,164.319],[93.234,164.264],[93.171,164.25],[91.93,164.25],[91.854,164.272],[91.82,164.319],[91.812,164.368],[91.812,169.632],[91.834,169.707],[91.881,169.742],[91.93,169.75],[93.155,169.75],[93.242,169.728],[93.282,169.69],[93.847,168.658],[93.888,168.63],[94.444,169.664],[94.503,169.728],[94.585,169.75],[96.856,169.681],[96.891,169.728],[96.948,169.749],[98.207,169.75],[98.283,169.728],[98.322,169.666],[98.325,164.368],[98.304,164.293],[98.242,164.253],[96.948,164.251],[96.891,164.272],[96.852,164.334],[99.26,165.957],[99.308,166.012],[99.37,166.026],[100.63,166.022],[100.671,166.004],[100.706,165.957],[100.73,165.621],[100.758,165.558],[100.822,165.487],[100.903,165.454],[101.02,165.47],[101.11,165.548],[101.147,165.635],[101.154,165.704],[101.14,165.792],[101.098,165.88],[101.028,165.967],[100.738,166.208],[100.143,166.643],[99.77,166.961],[99.543,167.238],[99.352,167.574],[99.268,167.827],[99.242,167.962],[99.221,168.249],[99.227,168.401],[99.273,168.685],[99.314,168.818],[99.366,168.946],[99.503,169.18],[99.587,169.285],[99.784,169.468],[100.019,169.616],[100.285,169.726],[100.577,169.791],[100.733,169.807],[101.059,169.807],[101.367,169.764],[101.648,169.676],[101.779,169.616],[102.013,169.468],[102.116,169.381],[102.294,169.18],[102.431,168.946],[102.484,168.818],[102.553,168.546],[102.57,168.401],[102.575,168.059],[102.545,167.99],[102.458,167.959],[101.191,167.966],[101.144,168.001],[101.126,168.042],[101.121,168.319],[101.095,168.419],[101.013,168.515],[100.928,168.546],[100.831,168.539],[100.754,168.493],[100.689,168.377],[100.675,168.257],[100.689,168.154],[100.731,168.053],[100.849,167.903],[101.08,167.703],[101.744,167.2],[102.061,166.937],[102.289,166.695],[102.462,166.423],[102.543,166.22],[102.591,165.996],[102.608,165.751],[102.595,165.52],[102.556,165.306],[102.492,165.108],[102.401,164.927],[102.286,164.761],[102.144,164.611],[101.981,164.482],[101.803,164.376],[101.608,164.293],[101.397,164.234],[101.169,164.199],[100.762,164.192],[100.455,164.234],[100.175,164.318],[100.046,164.376],[99.813,164.518],[99.618,164.692],[99.461,164.898],[99.345,165.132],[99.276,165.387],[99.252,165.664],[103.448,165.957],[103.495,166.012],[103.558,166.026],[104.818,166.022],[104.859,166.004],[104.894,165.957],[104.918,165.621],[104.945,165.558],[105.01,165.487],[105.091,165.454],[105.208,165.47],[105.298,165.548],[105.335,165.635],[105.342,165.704],[105.328,165.792],[105.286,165.88],[105.216,165.967],[104.926,166.208],[104.331,166.643],[103.958,166.961],[103.731,167.238],[103.54,167.574],[103.456,167.827],[103.43,167.962],[103.409,168.249],[103.415,168.401],[103.432,168.546],[103.501,168.818],[103.554,168.946],[103.691,169.18],[103.775,169.285],[103.972,169.468],[104.206,169.616],[104.473,169.726],[104.765,169.791],[104.921,169.807],[105.247,169.807],[105.555,169.764],[105.836,169.676],[105.966,169.616],[106.201,169.468],[106.398,169.285],[106.482,169.18],[106.619,168.946],[106.671,168.818],[106.741,168.546],[106.758,168.401],[106.763,168.059],[106.733,167.99],[106.646,167.959],[105.379,167.966],[105.332,168.001],[105.314,168.042],[105.309,168.319],[105.282,168.419],[105.201,168.515],[105.115,168.546],[105.019,168.539],[104.942,168.493],[104.877,168.377],[104.862,168.257],[104.876,168.154],[104.918,168.053],[105.037,167.903],[105.268,167.703],[105.932,167.2],[106.249,166.937],[106.477,166.695],[106.65,166.423],[106.731,166.22],[106.779,165.996],[106.795,165.751],[106.782,165.52],[106.744,165.306],[106.679,165.108],[106.589,164.927],[106.473,164.761],[106.332,164.611],[106.169,164.482],[105.99,164.376],[105.796,164.293],[105.584,164.234],[105.357,164.199],[104.95,164.192],[104.642,164.234],[104.363,164.318],[104.234,164.376],[104.001,164.518],[103.806,164.692],[103.649,164.898],[103.533,165.132],[103.463,165.387],[103.44,165.664],[107.668,169.681],[107.702,169.728],[107.76,169.749],[109.019,169.75],[109.094,169.728],[109.133,169.666],[109.137,164.368],[109.115,164.293],[109.053,164.253],[107.76,164.251],[107.702,164.272],[107.663,164.334],[110.524,169.357],[110.691,169.496],[110.876,169.61],[111.078,169.699],[111.192,169.732],[111.192,164.268],[111.078,164.301],[110.876,164.39],[110.691,164.504],[110.524,164.643],[110.378,164.803],[110.259,164.982],[110.167,165.177],[110.101,165.39],[110.061,165.621],[110.048,165.869],[110.048,168.131],[110.061,168.379],[110.101,168.61],[110.167,168.823],[110.259,169.018],[110.378,169.197],[118.119,169.742],[118.174,169.695],[118.188,169.632],[118.188,164.368],[118.166,164.293],[118.119,164.258],[118.07,164.25],[116.672,164.25],[116.612,164.261],[116.571,164.295],[115.949,166.733],[115.918,166.756],[115.894,166.725],[115.91,164.368],[115.896,164.305],[115.855,164.264],[115.792,164.25],[114.566,164.25],[114.491,164.272],[114.456,164.319],[114.448,164.368],[114.448,169.632],[114.47,169.707],[114.517,169.742],[114.566,169.75],[115.949,169.75],[116.008,169.739],[116.05,169.705],[116.68,167.259],[116.711,167.228],[116.735,167.259],[116.727,169.632],[116.741,169.695],[116.782,169.736],[116.845,169.75],[113.207,169.197],[113.326,169.018],[113.418,168.823],[113.484,168.61],[113.524,168.379],[113.537,168.131],[113.537,165.869],[113.524,165.621],[113.484,165.39],[113.418,165.177],[113.326,164.982],[113.207,164.803],[113.061,164.643],[112.894,164.504],[112.709,164.39],[112.507,164.301],[112.392,164.268],[112.392,169.732],[112.507,169.699],[112.709,169.61],[112.894,169.496],[113.061,169.357]],[[0,1,2,3,4,5,6,7,8,9,10,11,12,13,14,15,16,17,18,19,20,21,22,23,24,25,26,27,28,29,30,31,32,33,34,35,36,37],[38,39,40,41,42,43,44,45,46,47,48,49],[50,51,52,53,54,55,56,57,58,59,60,61,62,63,64,65,66,67,68,69,70,71,72,73,74,75,76,77,78,79,80,81,82,83,84,85,86,87,88,89,90,91,92,93,94,95,96,97,98,99,100,101,102,103,104,105,106,107,108,109,110,111,112,113,114,115,116,117,118,119,120,121,122,123,124,125,126,127,128,129,130,131,132,133,134,135,136,137,138,139,140,141,142],[143,144,145,146,147,148,149,150,151,152,153,154,155,156,157,158,159,160,161,162,163,164,165,166,167,168,169,170,171,172,173,174,175,176,177,178,179,180,181,182,183,184,185,186,187,188,189,190,191,192,193,194,195,196,197,198,199,200,201,202,203,204,205,206,207,208,209,210,211,212,213,214,215,216,217,218,219,220,221,222,223,224,225,226,227,228,229,230,231,232,233,234,235],[236,237,238,239,240,241,242,243,244,245,246,247],[248,249,250,251,252,253,254,255,256,257,258,259,260,261,262,263,264,265,266,267,268,269],[270,271,272,273,274,275,276,277,278,279,280,281,282,283,284,285,286,287,288,289,290,291,292,293,294,295,296,297,298,299,300,301,302,303,304],[305,306,307,308,309,310,311,312,313,314,315,316,317,318,319,320,321,322,323,324,325,326]]]],
  ["LIGHTS_DIM", 165, 167, 30.35, 12.6,
   [[[152.833,169.681],[152.88,169.736],[152.943,169.75],[154.491,169.75],[154.823,169.728],[154.979,169.701],[155.271,169.614],[155.406,169.554],[155.651,169.405],[155.857,169.22],[156.023,169.0],[156.09,168.878],[156.188,168.616],[156.237,168.33],[156.243,168.179],[156.243,165.821],[156.219,165.524],[156.145,165.25],[156.09,165.122],[155.945,164.886],[155.759,164.683],[155.651,164.595],[155.406,164.446],[155.271,164.386],[154.979,164.299],[154.661,164.255],[152.943,164.25],[152.88,164.264],[152.839,164.305],[152.825,164.368],[154.539,165.539],[154.61,165.579],[154.698,165.679],[154.739,165.766],[154.761,165.868],[154.764,168.143],[154.728,168.294],[154.649,168.409],[154.54,168.473],[154.35,168.485],[154.314,168.473],[154.303,168.438],[154.303,165.562],[154.314,165.527],[154.335,165.516],[157.178,169.681],[157.213,169.728],[157.271,169.749],[158.53,169.75],[158.605,169.728],[158.644,169.666],[158.648,164.368],[158.626,164.293],[158.564,164.253],[157.271,164.251],[157.213,164.272],[157.174,164.334],[163.615,169.742],[163.67,169.695],[163.684,169.632],[163.684,164.368],[163.662,164.293],[163.615,164.258],[163.566,164.25],[162.325,164.25],[162.276,164.258],[162.229,164.293],[162.207,164.368],[162.205,167.584],[162.181,167.607],[162.157,167.591],[161.618,166.686],[161.094,167.591],[161.07,167.609],[161.049,167.596],[161.044,167.566],[161.036,164.319],[160.989,164.264],[160.926,164.25],[159.685,164.25],[159.609,164.272],[159.575,164.319],[159.567,164.368],[159.567,169.632],[159.589,169.707],[159.636,169.742],[159.685,169.75],[160.91,169.75],[160.997,169.728],[161.037,169.69],[161.602,168.658],[161.643,168.63],[162.199,169.664],[162.258,169.728],[162.34,169.75],[168.597,169.747],[168.659,169.707],[168.681,169.632],[168.681,164.368],[168.659,164.293],[168.612,164.258],[168.563,164.25],[167.322,164.25],[167.273,164.258],[167.226,164.293],[167.204,164.368],[167.202,167.584],[167.178,167.607],[167.154,167.591],[166.615,166.686],[166.091,167.591],[166.067,167.609],[166.046,167.596],[166.041,167.566],[166.033,164.319],[165.986,164.264],[165.923,164.25],[164.682,164.25],[164.606,164.272],[164.572,164.319],[164.564,164.368],[164.564,169.632],[164.586,169.707],[164.633,169.742],[164.682,169.75],[165.907,169.75],[165.994,169.728],[166.034,169.69],[166.599,168.658],[166.641,168.63],[167.196,169.664],[167.255,169.728],[167.338,169.75],[171.089,168.473],[171.078,168.438],[171.078,167.684],[171.089,167.648],[171.125,167.636],[171.92,167.636],[171.965,167.622],[172.006,167.581],[172.02,167.519],[172.02,166.489],[171.999,166.414],[171.92,166.372],[171.125,166.371],[171.089,166.36],[171.078,166.324],[171.083,165.536],[171.125,165.515],[172.625,165.515],[172.701,165.493],[172.735,165.446],[172.743,165.397],[172.743,164.368],[172.729,164.305],[172.674,164.258],[169.718,164.25],[169.655,164.264],[169.608,164.319],[169.6,169.632],[169.614,169.695],[169.655,169.736],[169.718,169.75],[172.625,169.75],[172.674,169.742],[172.721,169.707],[172.743,169.632],[172.743,168.603],[172.735,168.554],[172.701,168.507],[172.625,168.485],[171.125,168.485],[175.158,166.359],[175.13,166.358],[175.116,166.316],[175.116,164.368],[175.094,164.293],[175.047,164.258],[174.998,164.25],[173.757,164.25],[173.681,164.272],[173.647,164.319],[173.639,164.368],[173.639,169.632],[173.653,169.695],[173.708,169.742],[175.525,169.75],[175.679,169.744],[175.97,169.694],[176.237,169.594],[176.479,169.447],[176.687,169.259],[176.859,169.033],[176.993,168.77],[177.084,168.48],[177.13,168.165],[177.119,167.72],[177.069,167.462],[176.933,167.114],[176.803,166.915],[176.645,166.744],[176.545,166.662],[176.529,166.62],[177.171,164.372],[177.172,164.315],[177.147,164.274],[177.065,164.25],[175.784,164.25],[175.701,164.276],[175.658,164.352],[175.179,166.324],[175.121,168.464],[175.117,167.52],[175.128,167.499],[175.163,167.487],[175.374,167.502],[175.51,167.577],[175.609,167.715],[175.655,167.907],[175.655,168.06],[175.632,168.197],[175.552,168.355],[175.427,168.453],[175.265,168.485],[175.149,168.484]],[[0,1,2,3,4,5,6,7,8,9,10,11,12,13,14,15,16,17,18,19,20,21,22,23,24,25,26,27,28,29],[30,31,32,33,34,35,36,37,38,39,40,41,42,43,44],[45,46,47,48,49,50,51,52,53,54,55,56],[57,58,59,60,61,62,63,64,65,66,67,68,69,70,71,72,73,74,75,76,77,78,79,80,81,82,83,84,85,86,87,88,89,90,91,92,93,94],[95,96,97,98,99,100,101,102,103,104,105,106,107,108,109,110,111,112,113,114,115,116,117,118,119,120,121,122,123,124,125,126,127,128,129,130,131,132],[133,134,135,136,137,138,139,140,141,142,143,144,145,146,147,148,149,150,151,152,153,154,155,156,157,158,159,160,161,162,163,164,165,166,167,168,169,170,171,172],[173,174,175,176,177,178,179,180,181,182,183,184,185,186,187,188,189,190,191,192,193,194,195,196,197,198,199,200,201,202,203,204,205,206,207,208,209,210,211],[212,213,214,215,216,217,218,219,220,221,222,223,224,225]]],
   [[[176.479,169.447],[176.687,169.259],[176.859,169.033],[176.931,168.905],[177.045,168.628],[177.113,168.326],[177.13,168.165],[177.131,167.856],[177.098,167.588],[177.032,167.34],[176.872,167.01],[176.728,166.826],[176.545,166.662],[176.529,166.62],[177.173,164.366],[177.162,164.292],[177.098,164.253],[175.958,164.25],[175.958,169.697],[176.237,169.594],[152.857,169.719],[152.943,169.75],[153.928,169.75],[153.928,164.25],[152.926,164.251],[152.868,164.272],[152.829,164.334],[152.825,169.632],[155.651,169.405],[155.857,169.22],[156.023,169.0],[156.145,168.75],[156.219,168.476],[156.243,168.179],[156.237,165.67],[156.188,165.384],[156.145,165.25],[156.09,165.122],[155.945,164.886],[155.759,164.683],[155.534,164.516],[155.271,164.386],[155.128,164.337],[155.128,169.663],[155.406,169.554],[157.178,169.681],[157.213,169.728],[157.271,169.749],[158.53,169.75],[158.605,169.728],[158.644,169.666],[158.648,164.368],[158.626,164.293],[158.564,164.253],[157.271,164.251],[157.213,164.272],[157.174,164.334],[163.615,169.742],[163.67,169.695],[163.684,169.632],[163.684,164.368],[163.662,164.293],[163.615,164.258],[163.566,164.25],[162.325,164.25],[162.276,164.258],[162.229,164.293],[162.207,164.368],[162.205,167.584],[162.181,167.607],[162.157,167.591],[161.618,166.686],[161.094,167.591],[161.07,167.609],[161.049,167.596],[161.044,167.566],[161.036,164.319],[160.989,164.264],[160.926,164.25],[159.685,164.25],[159.609,164.272],[159.575,164.319],[159.567,164.368],[159.567,169.632],[159.589,169.707],[159.636,169.742],[159.685,169.75],[160.91,169.75],[160.997,169.728],[161.037,169.69],[161.602,168.658],[161.643,168.63],[162.199,169.664],[162.258,169.728],[162.34,169.75],[168.612,169.742],[168.667,169.695],[168.681,169.632],[168.681,164.368],[168.659,164.293],[168.612,164.258],[168.563,164.25],[167.322,164.25],[167.273,164.258],[167.226,164.293],[167.204,164.368],[167.202,167.584],[167.178,167.607],[167.154,167.591],[166.615,166.686],[166.091,167.591],[166.067,167.609],[166.046,167.596],[166.041,167.566],[166.033,164.319],[165.986,164.264],[165.923,164.25],[164.682,164.25],[164.606,164.272],[164.572,164.319],[164.564,164.368],[164.564,169.632],[164.586,169.707],[164.633,169.742],[164.682,169.75],[165.907,169.75],[165.994,169.728],[166.034,169.69],[166.599,168.658],[166.641,168.63],[167.196,169.664],[167.255,169.728],[167.338,169.75],[171.089,168.473],[171.078,168.438],[171.078,167.684],[171.089,167.648],[171.125,167.636],[171.92,167.636],[171.965,167.622],[172.006,167.581],[172.02,167.519],[172.02,166.489],[171.999,166.414],[171.92,166.372],[171.125,166.371],[171.089,166.36],[171.078,166.324],[171.083,165.536],[171.125,165.515],[172.625,165.515],[172.701,165.493],[172.735,165.446],[172.743,165.397],[172.743,164.368],[172.729,164.305],[172.674,164.258],[169.718,164.25],[169.655,164.264],[169.608,164.319],[169.6,169.632],[169.614,169.695],[169.655,169.736],[169.718,169.75],[172.625,169.75],[172.674,169.742],[172.721,169.707],[172.743,169.632],[172.743,168.603],[172.735,168.554],[172.701,168.507],[172.625,168.485],[171.125,168.485],[173.694,164.264],[173.653,164.305],[173.639,164.368],[173.642,169.666],[173.681,169.728],[173.739,169.749],[174.758,169.75],[174.758,164.25],[173.757,164.25]],[[0,1,2,3,4,5,6,7,8,9,10,11,12,13,14,15,16,17,18,19],[20,21,22,23,24,25,26,27],[28,29,30,31,32,33,34,35,36,37,38,39,40,41,42,43,44],[45,46,47,48,49,50,51,52,53,54,55,56],[57,58,59,60,61,62,63,64,65,66,67,68,69,70,71,72,73,74,75,76,77,78,79,80,81,82,83,84,85,86,87,88,89,90,91,92,93,94],[95,96,97,98,99,100,101,102,103,104,105,106,107,108,109,110,111,112,113,114,115,116,117,118,119,120,121,122,123,124,125,126,127,128,129,130,131,132],[133,134,135,136,137,138,139,140,141,142,143,144,145,146,147,148,149,150,151,152,153,154,155,156,157,158,159,160,161,162,163,164,165,166,167,168,169,170,171,172],[173,174,175,176,177,178,179,180,181]]]],
  ["START", 32, 116, 27.42, 12.6,
   [[[21.326,114.942],[21.365,115.004],[21.422,115.025],[22.683,115.025],[22.741,115.004],[22.776,114.957],[22.799,114.621],[22.827,114.558],[22.892,114.487],[23.004,114.452],[23.115,114.484],[23.196,114.574],[23.222,114.668],[23.22,114.748],[23.192,114.836],[23.136,114.923],[23.048,115.014],[22.808,115.208],[22.213,115.642],[21.84,115.961],[21.612,116.238],[21.422,116.574],[21.338,116.827],[21.312,116.962],[21.291,117.249],[21.296,117.401],[21.343,117.685],[21.383,117.818],[21.435,117.946],[21.573,118.18],[21.75,118.381],[21.853,118.468],[22.088,118.616],[22.355,118.726],[22.647,118.791],[22.802,118.807],[23.129,118.807],[23.437,118.764],[23.718,118.676],[23.848,118.616],[24.083,118.468],[24.186,118.381],[24.363,118.18],[24.501,117.946],[24.553,117.818],[24.594,117.685],[24.64,117.401],[24.645,117.059],[24.614,116.99],[24.528,116.959],[23.261,116.966],[23.214,117.001],[23.196,117.042],[23.19,117.319],[23.164,117.419],[23.083,117.515],[22.997,117.546],[22.901,117.539],[22.824,117.493],[22.759,117.377],[22.744,117.257],[22.758,117.154],[22.8,117.053],[22.919,116.903],[23.149,116.703],[23.814,116.2],[24.131,115.937],[24.359,115.695],[24.532,115.422],[24.613,115.22],[24.661,114.996],[24.677,114.751],[24.664,114.52],[24.626,114.306],[24.561,114.108],[24.471,113.927],[24.355,113.761],[24.214,113.611],[24.051,113.482],[23.872,113.376],[23.677,113.293],[23.466,113.234],[23.239,113.199],[22.832,113.192],[22.524,113.234],[22.245,113.318],[22.116,113.376],[21.883,113.518],[21.688,113.692],[21.53,113.898],[21.415,114.132],[21.345,114.387],[21.322,114.664],[29.113,117.569],[29.074,117.507],[29.016,117.486],[28.071,117.485],[28.036,117.473],[28.026,117.452],[28.024,113.368],[28.01,113.305],[27.969,113.264],[27.906,113.25],[26.665,113.25],[26.602,113.264],[26.561,113.305],[26.547,113.368],[26.546,117.452],[26.535,117.473],[26.5,117.485],[25.579,117.486],[25.5,117.528],[25.479,117.603],[25.479,118.632],[25.493,118.695],[25.534,118.736],[25.596,118.75],[29.048,118.742],[29.095,118.707],[29.116,118.65],[32.271,113.965],[32.22,113.996],[31.529,113.996],[31.495,113.986],[31.474,113.955],[31.389,113.326],[31.36,113.278],[31.306,113.253],[30.036,113.25],[29.968,113.264],[29.934,113.306],[29.934,113.376],[31.049,118.648],[31.094,118.724],[31.149,118.747],[32.613,118.75],[32.701,118.724],[32.736,118.679],[33.862,113.376],[33.85,113.292],[33.813,113.26],[33.752,113.25],[32.487,113.25],[32.421,113.262],[32.367,113.326],[32.084,115.133],[32.098,115.161],[31.882,116.589],[31.859,116.621],[31.835,116.589],[31.648,115.161],[31.664,115.133],[31.686,115.128],[36.253,115.359],[36.225,115.358],[36.211,115.316],[36.211,113.368],[36.19,113.293],[36.143,113.258],[36.094,113.25],[34.852,113.25],[34.777,113.272],[34.742,113.319],[34.734,113.368],[34.734,118.632],[34.748,118.695],[34.803,118.742],[36.62,118.75],[36.922,118.725],[37.065,118.694],[37.332,118.594],[37.574,118.447],[37.782,118.259],[37.954,118.033],[38.089,117.77],[38.18,117.48],[38.225,117.165],[38.214,116.72],[38.164,116.462],[38.028,116.114],[37.899,115.915],[37.74,115.744],[37.64,115.662],[37.624,115.62],[38.267,113.372],[38.267,113.315],[38.242,113.274],[38.16,113.25],[36.879,113.25],[36.797,113.276],[36.754,113.352],[36.274,115.324],[36.217,117.464],[36.213,116.52],[36.223,116.499],[36.259,116.487],[36.469,116.502],[36.605,116.577],[36.705,116.715],[36.751,116.907],[36.751,117.06],[36.727,117.197],[36.648,117.355],[36.523,117.453],[36.361,117.485],[36.244,117.484],[42.701,117.554],[42.667,117.507],[42.609,117.486],[41.664,117.485],[41.629,117.473],[41.618,117.452],[41.617,113.368],[41.603,113.305],[41.562,113.264],[41.499,113.25],[40.258,113.25],[40.195,113.264],[40.154,113.305],[40.14,113.368],[40.139,117.452],[40.128,117.473],[40.093,117.485],[39.172,117.486],[39.093,117.528],[39.071,117.603],[39.071,118.632],[39.085,118.695],[39.126,118.736],[39.189,118.75],[42.641,118.742],[42.687,118.707],[42.708,118.65]],[[0,1,2,3,4,5,6,7,8,9,10,11,12,13,14,15,16,17,18,19,20,21,22,23,24,25,26,27,28,29,30,31,32,33,34,35,36,37,38,39,40,41,42,43,44,45,46,47,48,49,50,51,52,53,54,55,56,57,58,59,60,61,62,63,64,65,66,67,68,69,70,71,72,73,74,75,76,77,78,79,80,81,82,83,84,85,86,87,88,89,90,91,92],[93,94,95,96,97,98,99,100,101,102,103,104,105,106,107,108,109,110,111,112,113,114,115,116,117,118,119],[120,121,122,123,124,125,126,127,128,129,130,131,132,133,134,135,136,137,138,139,140,141,142,143,144],[145,146,147,148,149,150,151,152],[153,154,155,156,157,158,159,160,161,162,163,164,165,166,167,168,169,170,171,172,173,174,175,176,177,178,179,180,181,182,183,184,185,186,187,188,189,190,191],[192,193,194,195,196,197,198,199,200,201,202,203,204,205],[206,207,208,209,210,211,212,213,214,215,216,217,218,219,220,221,222,223,224,225,226,227,228,229,230,231,232]]],
   [[[37.457,118.526],[37.682,118.358],[37.782,118.259],[37.954,118.033],[38.089,117.77],[38.14,117.628],[38.208,117.326],[38.225,117.165],[38.227,116.856],[38.193,116.588],[38.127,116.34],[37.967,116.01],[37.823,115.826],[37.64,115.662],[37.624,115.62],[38.268,113.366],[38.258,113.292],[38.194,113.253],[37.054,113.25],[37.054,118.697],[37.201,118.65],[21.33,114.957],[21.377,115.012],[21.44,115.026],[22.7,115.022],[22.741,115.004],[22.776,114.957],[22.799,114.621],[22.827,114.558],[22.892,114.487],[22.973,114.454],[23.09,114.47],[23.18,114.548],[23.217,114.635],[23.224,114.704],[23.21,114.792],[23.168,114.88],[23.098,114.967],[22.808,115.208],[22.213,115.642],[21.84,115.961],[21.612,116.238],[21.422,116.574],[21.338,116.827],[21.312,116.962],[21.291,117.249],[21.296,117.401],[21.343,117.685],[21.383,117.818],[21.435,117.946],[21.573,118.18],[21.75,118.381],[21.853,118.468],[22.088,118.616],[22.355,118.726],[22.647,118.791],[22.802,118.807],[23.129,118.807],[23.437,118.764],[23.718,118.676],[23.848,118.616],[24.083,118.468],[24.186,118.381],[24.363,118.18],[24.501,117.946],[24.553,117.818],[24.594,117.685],[24.64,117.401],[24.645,117.059],[24.614,116.99],[24.528,116.959],[23.261,116.966],[23.214,117.001],[23.196,117.042],[23.19,117.319],[23.164,117.419],[23.083,117.515],[22.997,117.546],[22.901,117.539],[22.824,117.493],[22.759,117.377],[22.744,117.257],[22.758,117.154],[22.8,117.053],[22.919,116.903],[23.149,116.703],[23.814,116.2],[24.131,115.937],[24.359,115.695],[24.532,115.422],[24.613,115.22],[24.661,114.996],[24.677,114.751],[24.664,114.52],[24.626,114.306],[24.561,114.108],[24.471,113.927],[24.355,113.761],[24.214,113.611],[24.051,113.482],[23.872,113.376],[23.677,113.293],[23.466,113.234],[23.239,113.199],[22.832,113.192],[22.524,113.234],[22.245,113.318],[22.116,113.376],[21.883,113.518],[21.688,113.692],[21.53,113.898],[21.415,114.132],[21.345,114.387],[21.322,114.664],[29.109,117.554],[29.074,117.507],[29.016,117.486],[28.071,117.485],[28.036,117.473],[28.026,117.452],[28.024,113.368],[28.01,113.305],[27.969,113.264],[27.906,113.25],[26.665,113.25],[26.602,113.264],[26.561,113.305],[26.547,113.368],[26.546,117.452],[26.535,117.473],[26.5,117.485],[25.579,117.486],[25.5,117.528],[25.479,117.603],[25.479,118.632],[25.493,118.695],[25.534,118.736],[25.596,118.75],[29.048,118.742],[29.095,118.707],[29.116,118.65],[29.934,113.306],[29.934,113.376],[31.049,118.648],[31.075,118.705],[31.119,118.739],[31.266,118.75],[31.266,113.25],[30.036,113.25],[29.968,113.264],[32.721,118.705],[32.746,118.648],[33.862,113.376],[33.85,113.292],[33.786,113.253],[32.466,113.252],[32.466,118.75],[32.647,118.747],[34.789,113.264],[34.748,113.305],[34.734,113.368],[34.738,118.666],[34.777,118.728],[34.834,118.749],[35.854,118.75],[35.854,113.25],[34.852,113.25],[42.701,117.554],[42.667,117.507],[42.609,117.486],[41.664,117.485],[41.629,117.473],[41.618,117.452],[41.617,113.368],[41.603,113.305],[41.562,113.264],[41.499,113.25],[40.258,113.25],[40.195,113.264],[40.154,113.305],[40.14,113.368],[40.139,117.452],[40.128,117.473],[40.093,117.485],[39.172,117.486],[39.093,117.528],[39.071,117.603],[39.071,118.632],[39.085,118.695],[39.126,118.736],[39.189,118.75],[42.641,118.742],[42.687,118.707],[42.708,118.65]],[[0,1,2,3,4,5,6,7,8,9,10,11,12,13,14,15,16,17,18,19,20],[21,22,23,24,25,26,27,28,29,30,31,32,33,34,35,36,37,38,39,40,41,42,43,44,45,46,47,48,49,50,51,52,53,54,55,56,57,58,59,60,61,62,63,64,65,66,67,68,69,70,71,72,73,74,75,76,77,78,79,80,81,82,83,84,85,86,87,88,89,90,91,92,93,94,95,96,97,98,99,100,101,102,103,104,105,106,107,108,109,110,111,112,113],[114,115,116,117,118,119,120,121,122,123,124,125,126,127,128,129,130,131,132,133,134,135,136,137,138,139,140],[141,142,143,144,145,146,147,148,149],[150,151,152,153,154,155,156,157],[158,159,160,161,162,163,164,165,166],[167,168,169,170,171,172,173,174,175,176,177,178,179,180,181,182,183,184,185,186,187,188,189,190,191,192,193]]]],
  ["PAUSE", 82, 116, 26.73, 12.6,
   [[[80.691,118.666],[80.73,118.728],[80.806,118.75],[82.065,118.749],[82.122,118.728],[82.157,118.681],[82.167,114.7],[82.193,114.589],[82.228,114.531],[82.301,114.472],[82.393,114.452],[82.484,114.472],[82.533,114.507],[82.587,114.589],[82.611,114.7],[82.621,118.681],[82.668,118.736],[82.731,118.75],[83.972,118.75],[84.035,118.736],[84.076,118.695],[84.09,118.632],[84.09,114.884],[84.066,114.562],[84.037,114.411],[83.943,114.128],[83.878,113.996],[83.717,113.759],[83.518,113.56],[83.281,113.399],[83.149,113.334],[82.866,113.24],[82.557,113.193],[82.226,113.193],[82.066,113.211],[81.768,113.281],[81.497,113.399],[81.26,113.56],[81.061,113.759],[80.9,113.996],[80.835,114.128],[80.782,114.266],[80.711,114.562],[80.688,114.884],[75.047,116.364],[74.94,116.094],[74.795,115.857],[74.616,115.66],[74.402,115.501],[74.159,115.385],[73.892,115.316],[73.601,115.293],[73.161,115.293],[73.119,115.272],[73.114,113.368],[73.082,113.281],[72.996,113.25],[71.754,113.25],[71.668,113.281],[71.636,113.368],[71.636,118.632],[71.668,118.719],[71.754,118.75],[73.676,118.744],[73.967,118.694],[74.104,118.65],[74.234,118.594],[74.476,118.447],[74.684,118.258],[74.856,118.03],[74.991,117.765],[75.042,117.621],[75.11,117.315],[75.133,116.982],[75.111,116.66],[73.629,117.18],[73.55,117.347],[73.425,117.451],[73.263,117.485],[73.146,117.484],[73.119,117.464],[73.114,116.479],[73.135,116.437],[73.321,116.436],[73.425,116.465],[73.512,116.522],[73.582,116.609],[73.629,116.724],[73.653,116.868],[73.653,117.034],[78.24,113.965],[78.189,113.996],[77.498,113.996],[77.464,113.986],[77.443,113.955],[77.359,113.326],[77.329,113.278],[77.275,113.253],[76.005,113.25],[75.938,113.264],[75.904,113.306],[75.903,113.376],[77.019,118.648],[77.064,118.724],[77.118,118.747],[78.582,118.75],[78.671,118.724],[78.705,118.679],[79.831,113.376],[79.819,113.292],[79.783,113.26],[79.721,113.25],[78.456,113.25],[78.39,113.262],[78.336,113.326],[78.053,115.133],[78.067,115.161],[77.851,116.589],[77.828,116.621],[77.804,116.589],[77.617,115.161],[77.633,115.133],[77.655,115.128],[85.009,114.957],[85.056,115.012],[85.119,115.026],[86.379,115.022],[86.42,115.004],[86.455,114.957],[86.479,114.621],[86.507,114.558],[86.571,114.487],[86.652,114.454],[86.769,114.47],[86.859,114.548],[86.896,114.635],[86.903,114.704],[86.889,114.792],[86.847,114.88],[86.777,114.967],[86.487,115.208],[85.892,115.642],[85.519,115.961],[85.292,116.238],[85.101,116.574],[85.017,116.827],[84.991,116.962],[84.97,117.249],[84.976,117.401],[85.022,117.685],[85.063,117.818],[85.115,117.946],[85.252,118.18],[85.336,118.285],[85.533,118.468],[85.767,118.616],[86.034,118.726],[86.326,118.791],[86.482,118.807],[86.808,118.807],[87.116,118.764],[87.397,118.676],[87.528,118.616],[87.762,118.468],[87.865,118.381],[88.043,118.18],[88.18,117.946],[88.232,117.818],[88.302,117.546],[88.319,117.401],[88.324,117.059],[88.294,116.99],[88.207,116.959],[86.94,116.966],[86.893,117.001],[86.875,117.042],[86.87,117.319],[86.843,117.419],[86.762,117.515],[86.677,117.546],[86.58,117.539],[86.503,117.493],[86.438,117.377],[86.424,117.257],[86.438,117.154],[86.479,117.053],[86.598,116.903],[86.829,116.703],[87.493,116.2],[87.81,115.937],[88.038,115.695],[88.211,115.422],[88.292,115.22],[88.34,114.996],[88.356,114.751],[88.344,114.52],[88.305,114.306],[88.241,114.108],[88.15,113.927],[88.035,113.761],[87.893,113.611],[87.73,113.482],[87.552,113.376],[87.357,113.293],[87.146,113.234],[86.918,113.199],[86.511,113.192],[86.204,113.234],[85.924,113.318],[85.795,113.376],[85.562,113.518],[85.367,113.692],[85.21,113.898],[85.094,114.132],[85.025,114.387],[85.001,114.664],[90.71,117.473],[90.698,117.438],[90.698,116.684],[90.71,116.648],[90.745,116.636],[91.541,116.636],[91.586,116.622],[91.627,116.581],[91.641,116.519],[91.641,115.489],[91.619,115.414],[91.541,115.372],[90.745,115.371],[90.71,115.36],[90.698,115.324],[90.703,114.536],[90.745,114.515],[92.246,114.515],[92.321,114.493],[92.356,114.446],[92.364,114.397],[92.364,113.368],[92.35,113.305],[92.295,113.258],[89.339,113.25],[89.276,113.264],[89.229,113.319],[89.221,118.632],[89.235,118.695],[89.276,118.736],[89.339,118.75],[92.246,118.75],[92.295,118.742],[92.342,118.707],[92.364,118.632],[92.364,117.603],[92.356,117.554],[92.321,117.507],[92.246,117.485],[90.745,117.485]],[[0,1,2,3,4,5,6,7,8,9,10,11,12,13,14,15,16,17,18,19,20,21,22,23,24,25,26,27,28,29,30,31,32,33,34,35,36,37,38,39,40,41,42,43],[44,45,46,47,48,49,50,51,52,53,54,55,56,57,58,59,60,61,62,63,64,65,66,67,68,69,70,71,72,73,74],[75,76,77,78,79,80,81,82,83,84,85,86,87,88,89],[90,91,92,93,94,95,96,97,98,99,100,101,102,103,104,105,106,107,108,109,110,111,112,113,114],[115,116,117,118,119,120,121,122],[123,124,125,126,127,128,129,130,131,132,133,134,135,136,137,138,139,140,141,142,143,144,145,146,147,148,149,150,151,152,153,154,155,156,157,158,159,160,161,162,163,164,165,166,167,168,169,170,171,172,173,174,175,176,177,178,179,180,181,182,183,184,185,186,187,188,189,190,191,192,193,194,195,196,197,198,199,200,201,202,203,204,205,206,207,208,209,210,211,212,213,214,215],[216,217,218,219,220,221,222,223,224,225,226,227,228,229,230,231,232,233,234,235,236,237,238,239,240,241,242,243,244,245,246,247,248,249,250,251,252,253,254,255]]],
   [[[80.691,118.666],[80.73,118.728],[80.806,118.75],[82.065,118.749],[82.122,118.728],[82.157,118.681],[82.167,114.7],[82.193,114.589],[82.228,114.531],[82.301,114.472],[82.393,114.452],[82.484,114.472],[82.533,114.507],[82.587,114.589],[82.611,114.7],[82.621,118.681],[82.668,118.736],[82.731,118.75],[83.972,118.75],[84.035,118.736],[84.076,118.695],[84.09,118.632],[84.09,114.884],[84.066,114.562],[84.037,114.411],[83.943,114.128],[83.878,113.996],[83.717,113.759],[83.518,113.56],[83.281,113.399],[83.149,113.334],[82.866,113.24],[82.557,113.193],[82.226,113.193],[82.066,113.211],[81.768,113.281],[81.497,113.399],[81.26,113.56],[81.061,113.759],[80.9,113.996],[80.835,114.128],[80.782,114.266],[80.711,114.562],[80.688,114.884],[71.691,113.264],[71.65,113.305],[71.636,113.368],[71.64,118.666],[71.679,118.728],[71.737,118.749],[72.757,118.75],[72.757,113.25],[71.754,113.25],[75.904,113.306],[75.903,113.376],[77.019,118.648],[77.044,118.705],[77.088,118.739],[77.236,118.75],[77.236,113.25],[76.005,113.25],[75.938,113.264],[78.69,118.705],[78.716,118.648],[79.831,113.376],[79.819,113.292],[79.755,113.253],[78.436,113.252],[78.436,118.75],[78.616,118.747],[85.009,114.957],[85.056,115.012],[85.119,115.026],[86.379,115.022],[86.42,115.004],[86.455,114.957],[86.479,114.621],[86.507,114.558],[86.571,114.487],[86.652,114.454],[86.769,114.47],[86.859,114.548],[86.896,114.635],[86.903,114.704],[86.889,114.792],[86.847,114.88],[86.777,114.967],[86.487,115.208],[85.892,115.642],[85.519,115.961],[85.292,116.238],[85.101,116.574],[85.017,116.827],[84.991,116.962],[84.97,117.249],[84.976,117.401],[85.022,117.685],[85.063,117.818],[85.115,117.946],[85.252,118.18],[85.336,118.285],[85.533,118.468],[85.767,118.616],[86.034,118.726],[86.326,118.791],[86.482,118.807],[86.808,118.807],[87.116,118.764],[87.397,118.676],[87.528,118.616],[87.762,118.468],[87.865,118.381],[88.043,118.18],[88.18,117.946],[88.232,117.818],[88.302,117.546],[88.319,117.401],[88.324,117.059],[88.294,116.99],[88.207,116.959],[86.94,116.966],[86.893,117.001],[86.875,117.042],[86.87,117.319],[86.843,117.419],[86.762,117.515],[86.677,117.546],[86.58,117.539],[86.503,117.493],[86.438,117.377],[86.424,117.257],[86.438,117.154],[86.479,117.053],[86.598,116.903],[86.829,116.703],[87.493,116.2],[87.81,115.937],[88.038,115.695],[88.211,115.422],[88.292,115.22],[88.34,114.996],[88.356,114.751],[88.344,114.52],[88.305,114.306],[88.241,114.108],[88.15,113.927],[88.035,113.761],[87.893,113.611],[87.73,113.482],[87.552,113.376],[87.357,113.293],[87.146,113.234],[86.918,113.199],[86.511,113.192],[86.204,113.234],[85.924,113.318],[85.795,113.376],[85.562,113.518],[85.367,113.692],[85.21,113.898],[85.094,114.132],[85.025,114.387],[85.001,114.664],[90.71,117.473],[90.698,117.438],[90.698,116.684],[90.71,116.648],[90.745,116.636],[91.541,116.636],[91.586,116.622],[91.627,116.581],[91.641,116.519],[91.641,115.489],[91.619,115.414],[91.541,115.372],[90.745,115.371],[90.71,115.36],[90.698,115.324],[90.703,114.536],[90.745,114.515],[92.246,114.515],[92.321,114.493],[92.356,114.446],[92.364,114.397],[92.364,113.368],[92.35,113.305],[92.295,113.258],[89.339,113.25],[89.276,113.264],[89.229,113.319],[89.221,118.632],[89.235,118.695],[89.276,118.736],[89.339,118.75],[92.246,118.75],[92.295,118.742],[92.342,118.707],[92.364,118.632],[92.364,117.603],[92.356,117.554],[92.321,117.507],[92.246,117.485],[90.745,117.485],[74.872,115.971],[74.71,115.753],[74.513,115.575],[74.284,115.437],[74.159,115.385],[73.957,115.33],[73.957,118.696],[74.234,118.594],[74.359,118.526],[74.585,118.357],[74.684,118.258],[74.856,118.03],[74.991,117.765],[75.042,117.621],[75.11,117.315],[75.127,117.152],[75.133,116.982],[75.111,116.66],[75.047,116.364],[74.999,116.226]],[[0,1,2,3,4,5,6,7,8,9,10,11,12,13,14,15,16,17,18,19,20,21,22,23,24,25,26,27,28,29,30,31,32,33,34,35,36,37,38,39,40,41,42,43],[44,45,46,47,48,49,50,51,52],[53,54,55,56,57,58,59,60,61],[62,63,64,65,66,67,68,69],[70,71,72,73,74,75,76,77,78,79,80,81,82,83,84,85,86,87,88,89,90,91,92,93,94,95,96,97,98,99,100,101,102,103,104,105,106,107,108,109,110,111,112,113,114,115,116,117,118,119,120,121,122,123,124,125,126,127,128,129,130,131,132,133,134,135,136,137,138,139,140,141,142,143,144,145,146,147,148,149,150,151,152,153,154,155,156,157,158,159,160,161,162],[163,164,165,166,167,168,169,170,171,172,173,174,175,176,177,178,179,180,181,182,183,184,185,186,187,188,189,190,191,192,193,194,195,196,197,198,199,200,201,202],[203,204,205,206,207,208,209,210,211,212,213,214,215,216,217,218,219,220,221,222]]]],
  ["INTERCOM", 130, 114, 38.76, 12.6,
   [[[113.626,116.681],[113.66,116.728],[113.718,116.749],[114.977,116.75],[115.052,116.728],[115.092,116.666],[115.095,111.368],[115.073,111.293],[115.011,111.253],[113.718,111.251],[113.66,111.272],[113.621,111.334],[119.725,116.742],[119.78,116.695],[119.794,116.632],[119.794,111.368],[119.772,111.293],[119.725,111.258],[119.676,111.25],[118.277,111.25],[118.218,111.261],[118.176,111.295],[117.554,113.733],[117.523,113.756],[117.499,113.725],[117.515,111.368],[117.501,111.305],[117.46,111.264],[117.397,111.25],[116.171,111.25],[116.096,111.272],[116.061,111.319],[116.054,111.368],[116.054,116.632],[116.075,116.707],[116.122,116.742],[116.171,116.75],[117.554,116.75],[117.614,116.739],[117.656,116.705],[118.285,114.259],[118.316,114.228],[118.34,114.259],[118.332,116.632],[118.346,116.695],[118.387,116.736],[118.45,116.75],[124.319,115.554],[124.285,115.507],[124.227,115.486],[123.282,115.485],[123.247,115.473],[123.236,115.452],[123.235,111.368],[123.221,111.305],[123.18,111.264],[123.117,111.25],[121.876,111.25],[121.813,111.264],[121.772,111.305],[121.758,111.368],[121.757,115.452],[121.746,115.473],[121.711,115.485],[120.789,115.486],[120.711,115.528],[120.689,115.603],[120.689,116.632],[120.703,116.695],[120.744,116.736],[120.807,116.75],[124.258,116.742],[124.305,116.707],[124.326,116.65],[126.712,115.473],[126.7,115.438],[126.7,114.684],[126.712,114.648],[126.747,114.636],[127.543,114.636],[127.588,114.622],[127.629,114.581],[127.643,114.519],[127.643,113.489],[127.621,113.414],[127.543,113.372],[126.747,113.371],[126.712,113.36],[126.7,113.324],[126.705,112.536],[126.747,112.515],[128.248,112.515],[128.323,112.493],[128.358,112.446],[128.366,112.397],[128.366,111.368],[128.352,111.305],[128.297,111.258],[125.341,111.25],[125.278,111.264],[125.231,111.319],[125.223,116.632],[125.237,116.695],[125.278,116.736],[125.341,116.75],[128.248,116.75],[128.297,116.742],[128.344,116.707],[128.366,116.632],[128.366,115.603],[128.358,115.554],[128.323,115.507],[128.248,115.485],[126.747,115.485],[130.78,113.359],[130.753,113.358],[130.739,113.316],[130.739,111.368],[130.717,111.293],[130.67,111.258],[130.621,111.25],[129.379,111.25],[129.304,111.272],[129.269,111.319],[129.261,111.368],[129.261,116.632],[129.275,116.695],[129.33,116.742],[131.147,116.75],[131.45,116.725],[131.592,116.694],[131.859,116.594],[132.101,116.447],[132.309,116.259],[132.481,116.033],[132.616,115.77],[132.707,115.48],[132.752,115.165],[132.741,114.72],[132.692,114.462],[132.555,114.114],[132.426,113.915],[132.267,113.744],[132.167,113.662],[132.151,113.62],[132.794,111.372],[132.794,111.315],[132.77,111.274],[132.687,111.25],[131.406,111.25],[131.324,111.276],[131.281,111.352],[130.801,113.324],[130.744,115.464],[130.74,114.52],[130.75,114.499],[130.786,114.487],[130.996,114.502],[131.132,114.577],[131.232,114.715],[131.278,114.907],[131.278,115.06],[131.254,115.197],[131.175,115.355],[131.05,115.453],[130.888,115.485],[130.771,115.484],[133.731,115.839],[133.822,116.032],[133.939,116.207],[134.082,116.365],[134.246,116.502],[134.429,116.614],[134.629,116.701],[134.847,116.763],[135.082,116.8],[135.335,116.813],[135.586,116.8],[135.82,116.763],[136.036,116.701],[136.236,116.614],[136.419,116.502],[136.584,116.365],[136.728,116.207],[136.846,116.032],[136.938,115.839],[137.003,115.628],[137.043,115.4],[137.055,115.098],[137.034,115.038],[136.987,114.999],[135.696,114.951],[135.631,114.963],[135.582,115.027],[135.577,115.3],[135.549,115.411],[135.462,115.513],[135.37,115.546],[135.266,115.539],[135.182,115.493],[135.121,115.411],[135.093,115.3],[135.091,112.735],[135.108,112.616],[135.158,112.527],[135.236,112.471],[135.335,112.452],[135.434,112.471],[135.512,112.527],[135.571,112.653],[135.582,112.981],[135.608,113.03],[135.66,113.054],[136.956,113.017],[137.013,112.993],[137.048,112.942],[137.05,112.696],[137.002,112.388],[136.906,112.107],[136.84,111.977],[136.763,111.855],[136.58,111.64],[136.359,111.464],[136.235,111.391],[135.962,111.278],[135.662,111.21],[135.335,111.187],[135.084,111.2],[134.85,111.238],[134.634,111.301],[134.434,111.39],[134.251,111.504],[134.086,111.643],[133.942,111.803],[133.824,111.981],[133.732,112.175],[133.667,112.387],[133.627,112.615],[133.614,112.861],[133.614,115.155],[133.627,115.4],[133.666,115.628],[138.116,116.018],[138.234,116.197],[138.38,116.357],[138.547,116.496],[138.732,116.61],[138.935,116.699],[139.155,116.762],[139.393,116.8],[139.649,116.813],[139.904,116.8],[140.142,116.762],[140.363,116.699],[140.565,116.61],[140.75,116.496],[140.918,116.357],[141.063,116.197],[141.182,116.018],[141.274,115.823],[141.34,115.61],[141.38,115.379],[141.393,115.131],[141.393,112.869],[141.38,112.621],[141.34,112.39],[141.274,112.177],[141.182,111.982],[141.063,111.803],[140.918,111.643],[140.75,111.504],[140.565,111.39],[140.363,111.301],[140.142,111.238],[139.904,111.2],[139.649,111.187],[139.393,111.2],[139.155,111.238],[138.935,111.301],[138.732,111.39],[138.547,111.504],[138.38,111.643],[138.234,111.803],[138.116,111.982],[138.023,112.177],[137.957,112.39],[137.917,112.621],[137.904,112.869],[137.904,115.131],[137.917,115.379],[137.957,115.61],[138.023,115.823],[139.898,115.342],[139.867,115.42],[139.792,115.506],[139.726,115.537],[139.608,115.545],[139.505,115.506],[139.452,115.454],[139.399,115.342],[139.383,115.247],[139.383,112.753],[139.399,112.658],[139.452,112.546],[139.505,112.494],[139.608,112.455],[139.726,112.463],[139.82,112.518],[139.884,112.617],[139.914,112.753],[139.916,115.194],[146.313,116.742],[146.368,116.695],[146.382,116.632],[146.382,111.368],[146.36,111.293],[146.313,111.258],[146.264,111.25],[145.023,111.25],[144.974,111.258],[144.927,111.293],[144.905,111.368],[144.903,114.584],[144.879,114.607],[144.855,114.591],[144.316,113.686],[143.792,114.591],[143.768,114.609],[143.747,114.596],[143.742,114.566],[143.734,111.319],[143.687,111.264],[143.624,111.25],[142.383,111.25],[142.308,111.272],[142.273,111.319],[142.265,111.368],[142.265,116.632],[142.287,116.707],[142.334,116.742],[142.383,116.75],[143.609,116.75],[143.695,116.728],[143.735,116.69],[144.3,115.658],[144.342,115.63],[144.897,116.664],[144.956,116.728],[145.039,116.75]],[[0,1,2,3,4,5,6,7,8,9,10,11],[12,13,14,15,16,17,18,19,20,21,22,23,24,25,26,27,28,29,30,31,32,33,34,35,36,37,38,39,40,41,42,43,44,45,46],[47,48,49,50,51,52,53,54,55,56,57,58,59,60,61,62,63,64,65,66,67,68,69,70,71,72,73],[74,75,76,77,78,79,80,81,82,83,84,85,86,87,88,89,90,91,92,93,94,95,96,97,98,99,100,101,102,103,104,105,106,107,108,109,110,111,112,113],[114,115,116,117,118,119,120,121,122,123,124,125,126,127,128,129,130,131,132,133,134,135,136,137,138,139,140,141,142,143,144,145,146,147,148,149,150,151,152],[153,154,155,156,157,158,159,160,161,162,163,164,165,166],[167,168,169,170,171,172,173,174,175,176,177,178,179,180,181,182,183,184,185,186,187,188,189,190,191,192,193,194,195,196,197,198,199,200,201,202,203,204,205,206,207,208,209,210,211,212,213,214,215,216,217,218,219,220,221,222,223,224,225,226,227,228,229,230,231,232,233,234,235,236,237,238,239,240,241],[242,243,244,245,246,247,248,249,250,251,252,253,254,255,256,257,258,259,260,261,262,263,264,265,266,267,268,269,270,271,272,273,274,275,276,277,278,279,280,281,282,283,284,285,286,287,288,289,290,291],[292,293,294,295,296,297,298,299,300,301,302,303,304,305,306,307,308,309,310],[311,312,313,314,315,316,317,318,319,320,321,322,323,324,325,326,327,328,329,330,331,332,333,334,335,336,337,338,339,340,341,342,343,344,345,346,347,348]]],
   [[[132.101,116.447],[132.21,116.358],[132.399,116.151],[132.554,115.905],[132.667,115.628],[132.735,115.326],[132.752,115.165],[132.754,114.856],[132.721,114.588],[132.654,114.34],[132.494,114.01],[132.35,113.826],[132.167,113.662],[132.151,113.62],[132.795,111.366],[132.785,111.292],[132.721,111.253],[131.581,111.25],[131.581,116.697],[131.859,116.594],[113.626,116.681],[113.66,116.728],[113.718,116.749],[114.977,116.75],[115.052,116.728],[115.092,116.666],[115.095,111.368],[115.073,111.293],[115.011,111.253],[113.718,111.251],[113.66,111.272],[113.621,111.334],[119.725,116.742],[119.78,116.695],[119.794,116.632],[119.794,111.368],[119.772,111.293],[119.725,111.258],[119.676,111.25],[118.277,111.25],[118.218,111.261],[118.176,111.295],[117.554,113.733],[117.523,113.756],[117.499,113.725],[117.515,111.368],[117.501,111.305],[117.46,111.264],[117.397,111.25],[116.171,111.25],[116.096,111.272],[116.061,111.319],[116.054,111.368],[116.054,116.632],[116.075,116.707],[116.122,116.742],[116.171,116.75],[117.554,116.75],[117.614,116.739],[117.656,116.705],[118.285,114.259],[118.316,114.228],[118.34,114.259],[118.332,116.632],[118.346,116.695],[118.387,116.736],[118.45,116.75],[124.313,115.54],[124.272,115.499],[124.227,115.486],[123.282,115.485],[123.247,115.473],[123.236,115.452],[123.235,111.368],[123.221,111.305],[123.18,111.264],[123.117,111.25],[121.876,111.25],[121.813,111.264],[121.772,111.305],[121.758,111.368],[121.757,115.452],[121.746,115.473],[121.711,115.485],[120.789,115.486],[120.711,115.528],[120.689,115.603],[120.689,116.632],[120.703,116.695],[120.744,116.736],[120.807,116.75],[124.258,116.742],[124.313,116.695],[124.327,116.632],[124.327,115.603],[126.705,115.464],[126.7,114.684],[126.712,114.648],[126.747,114.636],[127.543,114.636],[127.621,114.594],[127.643,114.519],[127.643,113.489],[127.629,113.426],[127.588,113.385],[127.543,113.372],[126.747,113.371],[126.712,113.36],[126.7,113.324],[126.705,112.536],[126.747,112.515],[128.248,112.515],[128.323,112.493],[128.358,112.446],[128.366,112.397],[128.366,111.368],[128.352,111.305],[128.297,111.258],[125.341,111.25],[125.278,111.264],[125.231,111.319],[125.223,116.632],[125.237,116.695],[125.278,116.736],[125.341,116.75],[128.248,116.75],[128.297,116.742],[128.344,116.707],[128.366,116.632],[128.366,115.603],[128.358,115.554],[128.323,115.507],[128.248,115.485],[126.747,115.485],[129.316,111.264],[129.275,111.305],[129.261,111.368],[129.265,116.666],[129.304,116.728],[129.362,116.749],[130.381,116.75],[130.381,111.25],[129.379,111.25],[133.731,115.839],[133.822,116.032],[133.939,116.207],[134.082,116.365],[134.246,116.502],[134.429,116.614],[134.629,116.701],[134.847,116.763],[135.082,116.8],[135.335,116.813],[135.586,116.8],[135.82,116.763],[136.036,116.701],[136.236,116.614],[136.419,116.502],[136.584,116.365],[136.728,116.207],[136.846,116.032],[136.938,115.839],[137.003,115.628],[137.043,115.4],[137.055,115.098],[137.034,115.038],[136.987,114.999],[135.696,114.951],[135.631,114.963],[135.582,115.027],[135.577,115.3],[135.549,115.411],[135.462,115.513],[135.37,115.546],[135.266,115.539],[135.182,115.493],[135.121,115.411],[135.093,115.3],[135.091,112.735],[135.108,112.616],[135.158,112.527],[135.236,112.471],[135.335,112.452],[135.434,112.471],[135.512,112.527],[135.571,112.653],[135.582,112.981],[135.608,113.03],[135.66,113.054],[136.956,113.017],[137.013,112.993],[137.048,112.942],[137.05,112.696],[137.002,112.388],[136.906,112.107],[136.84,111.977],[136.763,111.855],[136.58,111.64],[136.359,111.464],[136.235,111.391],[135.962,111.278],[135.662,111.21],[135.335,111.187],[135.084,111.2],[134.85,111.238],[134.634,111.301],[134.434,111.39],[134.251,111.504],[134.086,111.643],[133.942,111.803],[133.824,111.981],[133.732,112.175],[133.667,112.387],[133.627,112.615],[133.614,112.861],[133.614,115.155],[133.627,115.4],[133.666,115.628],[138.38,116.357],[138.547,116.496],[138.732,116.61],[138.935,116.699],[139.049,116.732],[139.049,111.268],[138.935,111.301],[138.732,111.39],[138.547,111.504],[138.38,111.643],[138.234,111.803],[138.116,111.982],[138.023,112.177],[137.957,112.39],[137.917,112.621],[137.904,112.869],[137.904,115.131],[137.917,115.379],[137.957,115.61],[138.023,115.823],[138.116,116.018],[138.234,116.197],[146.327,116.736],[146.368,116.695],[146.382,116.632],[146.382,111.368],[146.36,111.293],[146.313,111.258],[146.264,111.25],[145.023,111.25],[144.974,111.258],[144.927,111.293],[144.905,111.368],[144.903,114.584],[144.879,114.607],[144.855,114.591],[144.316,113.686],[143.792,114.591],[143.768,114.609],[143.747,114.596],[143.742,114.566],[143.734,111.319],[143.687,111.264],[143.624,111.25],[142.383,111.25],[142.308,111.272],[142.273,111.319],[142.265,111.368],[142.265,116.632],[142.287,116.707],[142.334,116.742],[142.383,116.75],[143.609,116.75],[143.695,116.728],[143.735,116.69],[144.3,115.658],[144.342,115.63],[144.897,116.664],[144.956,116.728],[145.039,116.75],[146.264,116.75],[141.182,116.018],[141.274,115.823],[141.34,115.61],[141.38,115.379],[141.393,115.131],[141.393,112.869],[141.38,112.621],[141.34,112.39],[141.274,112.177],[141.182,111.982],[141.063,111.803],[140.918,111.643],[140.75,111.504],[140.565,111.39],[140.363,111.301],[140.249,111.268],[140.249,116.732],[140.363,116.699],[140.565,116.61],[140.75,116.496],[140.918,116.357],[141.063,116.197]],[[0,1,2,3,4,5,6,7,8,9,10,11,12,13,14,15,16,17,18,19],[20,21,22,23,24,25,26,27,28,29,30,31],[32,33,34,35,36,37,38,39,40,41,42,43,44,45,46,47,48,49,50,51,52,53,54,55,56,57,58,59,60,61,62,63,64,65,66],[67,68,69,70,71,72,73,74,75,76,77,78,79,80,81,82,83,84,85,86,87,88,89,90,91,92,93,94],[95,96,97,98,99,100,101,102,103,104,105,106,107,108,109,110,111,112,113,114,115,116,117,118,119,120,121,122,123,124,125,126,127,128,129,130,131,132,133],[134,135,136,137,138,139,140,141,142],[143,144,145,146,147,148,149,150,151,152,153,154,155,156,157,158,159,160,161,162,163,164,165,166,167,168,169,170,171,172,173,174,175,176,177,178,179,180,181,182,183,184,185,186,187,188,189,190,191,192,193,194,195,196,197,198,199,200,201,202,203,204,205,206,207,208,209,210,211,212,213,214,215,216,217],[218,219,220,221,222,223,224,225,226,227,228,229,230,231,232,233,234,235,236,237,238,239],[240,241,242,243,244,245,246,247,248,249,250,251,252,253,254,255,256,257,258,259,260,261,262,263,264,265,266,267,268,269,270,271,272,273,274,275,276,277,278],[279,280,281,282,283,284,285,286,287,288,289,290,291,292,293,294,295,296,297,298,299,300]]]],
  ["CMD_ALL_CALL", 175, 112, 38.4, 12.6,
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
