whyvas/filament-falcon/cad/panels/CMD_B.scad

// GENERATED by cad/tools/gen_panels.py from cad/tools/layouts.py - edit the layout there.
// Commander console, failures + crew motion: dad's right-hand console on the fixed rear dais, behind CMD_A
// Nominal 200 x 200 mm (printed 199.5 x 199.5).
PART = "preview";
PANEL_ID = "CMD_B";
W = 200;
H = 200;
SEAM_L = false;
SEAM_R = false;
CUTS = [["btn16", 55, 128], ["btn16", 145, 128], ["btn16", 55, 86], ["btn16", 145, 86], ["key19", 32, 38], ["tog12", 95, 38], ["estop22", 165, 38]];
SLOTS = [];
GROOVES = [[6, 22, 194, 76]];
LABELS = [
  ["FAILURES", 100, 170, 51.45, 14.0,
   [[[99.309,173.9],[99.377,173.98],[99.469,174.0],[101.3,173.999],[101.384,173.968],[101.434,173.9],[101.446,173.829],[101.448,168.109],[101.469,167.997],[101.537,167.863],[101.643,167.777],[101.777,167.749],[101.869,167.761],[101.981,167.828],[102.059,167.948],[102.095,168.109],[102.097,173.829],[102.109,173.9],[102.177,173.98],[102.269,174.0],[104.074,174.0],[104.166,173.98],[104.225,173.92],[104.246,173.829],[104.246,168.377],[104.211,167.909],[104.169,167.689],[104.031,167.277],[103.937,167.086],[103.703,166.74],[103.414,166.451],[103.069,166.217],[102.877,166.123],[102.466,165.986],[102.016,165.917],[101.535,165.917],[101.302,165.943],[100.868,166.046],[100.474,166.217],[100.129,166.451],[99.839,166.74],[99.606,167.086],[99.511,167.277],[99.374,167.689],[99.331,167.909],[99.297,168.377],[99.297,173.829],[117.857,168.483],[117.926,168.563],[118.017,168.583],[119.85,168.578],[119.91,168.551],[119.96,168.483],[119.974,168.101],[119.994,167.994],[120.035,167.903],[120.129,167.799],[120.247,167.752],[120.336,167.751],[120.417,167.774],[120.488,167.82],[120.548,167.887],[120.601,168.014],[120.611,168.114],[120.591,168.243],[120.53,168.371],[120.429,168.497],[120.007,168.848],[119.141,169.48],[118.849,169.716],[118.599,169.944],[118.483,170.069],[118.268,170.347],[118.074,170.663],[117.99,170.835],[117.922,171.015],[117.83,171.399],[117.8,171.817],[117.808,172.037],[117.876,172.451],[117.935,172.645],[118.01,172.83],[118.211,173.171],[118.333,173.323],[118.618,173.59],[118.96,173.806],[119.348,173.964],[119.773,174.06],[119.999,174.083],[120.473,174.083],[120.921,174.02],[121.33,173.893],[121.52,173.806],[121.862,173.59],[122.147,173.323],[122.269,173.171],[122.47,172.83],[122.545,172.645],[122.646,172.249],[122.672,172.037],[122.679,171.54],[122.634,171.44],[122.58,171.406],[122.509,171.394],[120.737,171.394],[120.666,171.406],[120.597,171.456],[120.571,171.516],[120.563,171.918],[120.525,172.063],[120.474,172.143],[120.407,172.203],[120.282,172.248],[120.142,172.239],[120.03,172.172],[119.974,172.097],[119.936,172.003],[119.914,171.829],[119.935,171.678],[119.996,171.531],[120.168,171.313],[120.503,171.023],[121.47,170.291],[121.931,169.909],[122.263,169.556],[122.439,169.297],[122.514,169.16],[122.632,168.866],[122.702,168.54],[122.726,168.183],[122.707,167.848],[122.651,167.537],[122.557,167.249],[122.426,166.984],[122.257,166.743],[122.051,166.526],[121.815,166.337],[121.555,166.183],[121.271,166.063],[120.964,165.977],[120.634,165.926],[120.28,165.909],[120.041,165.916],[119.594,165.977],[119.188,166.099],[119.0,166.183],[118.662,166.389],[118.378,166.643],[118.149,166.943],[117.98,167.283],[117.879,167.654],[117.846,168.057],[79.44,172.143],[79.423,172.091],[79.423,170.994],[79.44,170.943],[79.491,170.926],[80.649,170.924],[80.714,170.905],[80.774,170.846],[80.794,170.754],[80.794,169.257],[80.783,169.186],[80.732,169.117],[80.649,169.087],[79.491,169.086],[79.453,169.078],[79.43,169.055],[79.423,166.171],[79.411,166.1],[79.377,166.046],[79.323,166.011],[79.251,166.0],[77.446,166.0],[77.374,166.011],[77.295,166.08],[77.274,166.171],[77.274,173.829],[77.295,173.92],[77.354,173.98],[77.446,174.0],[81.674,174.0],[81.746,173.989],[81.814,173.938],[81.846,173.829],[81.846,172.331],[81.834,172.26],[81.784,172.192],[81.674,172.16],[79.491,172.16],[86.293,167.048],[86.263,167.076],[86.223,167.086],[85.217,167.086],[85.168,167.07],[85.138,167.025],[85.015,166.111],[84.971,166.04],[84.893,166.004],[83.046,166.0],[82.948,166.02],[82.898,166.081],[82.897,166.183],[84.52,173.851],[84.557,173.934],[84.622,173.983],[84.664,173.996],[86.794,174.0],[86.887,173.983],[86.952,173.934],[86.974,173.897],[88.611,166.183],[88.594,166.061],[88.54,166.015],[88.451,166.0],[86.611,166.0],[86.515,166.018],[86.48,166.04],[86.437,166.111],[86.037,168.749],[86.045,168.779],[85.731,170.857],[85.697,170.903],[85.663,170.857],[85.39,168.779],[85.414,168.739],[85.446,168.731],[85.983,168.731],[89.891,173.9],[89.942,173.968],[90.026,173.999],[91.857,174.0],[91.967,173.968],[92.023,173.878],[92.029,166.171],[91.997,166.062],[91.907,166.005],[90.026,166.001],[89.942,166.032],[89.885,166.122],[89.88,173.829],[93.434,173.9],[93.503,173.98],[93.594,174.0],[95.4,174.0],[95.491,173.98],[95.551,173.92],[95.571,173.829],[95.573,167.888],[95.602,167.848],[95.64,167.84],[97.869,167.84],[97.978,167.808],[98.029,167.74],[98.04,167.669],[98.04,166.171],[98.02,166.08],[97.96,166.02],[97.869,166.0],[93.594,166.0],[93.503,166.02],[93.443,166.08],[93.423,166.171],[93.423,173.829],[107.827,169.068],[107.786,169.067],[107.766,169.006],[107.766,166.171],[107.734,166.062],[107.666,166.011],[107.594,166.0],[105.789,166.0],[105.679,166.032],[105.629,166.1],[105.617,166.171],[105.617,173.829],[105.637,173.92],[105.717,173.989],[105.789,174.0],[108.36,174.0],[108.584,173.991],[109.007,173.919],[109.396,173.774],[109.748,173.559],[110.05,173.286],[110.3,172.957],[110.497,172.574],[110.629,172.153],[110.695,171.694],[110.703,171.451],[110.679,171.047],[110.606,170.672],[110.552,170.495],[110.408,170.165],[110.22,169.876],[109.989,169.628],[109.843,169.508],[109.821,169.447],[110.755,166.178],[110.756,166.095],[110.72,166.034],[110.6,166.0],[108.737,166.0],[108.617,166.037],[108.554,166.149],[107.857,169.017],[107.773,172.13],[107.768,170.756],[107.783,170.726],[107.834,170.709],[108.064,170.714],[108.14,170.73],[108.211,170.756],[108.338,170.84],[108.443,170.964],[108.483,171.04],[108.537,171.217],[108.55,171.319],[108.55,171.542],[108.516,171.741],[108.447,171.904],[108.4,171.971],[108.346,172.029],[108.219,172.113],[108.146,172.139],[107.983,172.16],[107.813,172.158],[114.183,172.143],[114.166,172.091],[114.166,170.994],[114.183,170.943],[114.234,170.926],[115.391,170.924],[115.457,170.905],[115.517,170.846],[115.537,170.754],[115.537,169.257],[115.505,169.148],[115.457,169.106],[115.391,169.087],[114.234,169.086],[114.183,169.069],[114.166,169.017],[114.173,167.87],[114.196,167.848],[114.234,167.84],[116.417,167.84],[116.527,167.808],[116.577,167.74],[116.589,167.669],[116.589,166.171],[116.568,166.08],[116.489,166.011],[116.417,166.0],[112.189,166.0],[112.097,166.02],[112.029,166.1],[112.017,166.171],[112.017,173.829],[112.037,173.92],[112.097,173.98],[112.189,174.0],[116.417,174.0],[116.489,173.989],[116.557,173.938],[116.589,173.829],[116.589,172.331],[116.577,172.26],[116.527,172.192],[116.417,172.16],[114.234,172.16]],[[0,1,2,3,4,5,6,7,8,9,10,11,12,13,14,15,16,17,18,19,20,21,22,23,24,25,26,27,28,29,30,31,32,33,34,35,36,37,38,39,40,41,42,43,44,45,46],[47,48,49,50,51,52,53,54,55,56,57,58,59,60,61,62,63,64,65,66,67,68,69,70,71,72,73,74,75,76,77,78,79,80,81,82,83,84,85,86,87,88,89,90,91,92,93,94,95,96,97,98,99,100,101,102,103,104,105,106,107,108,109,110,111,112,113,114,115,116,117,118,119,120,121,122,123,124,125,126,127,128,129,130,131,132,133,134,135,136,137,138,139,140,141,142,143,144,145,146,147,148,149,150,151],[152,153,154,155,156,157,158,159,160,161,162,163,164,165,166,167,168,169,170,171,172,173,174,175,176,177,178,179,180,181,182,183,184,185,186,187,188,189],[190,191,192,193,194,195,196,197,198,199,200,201,202,203,204,205,206,207,208,209,210,211,212,213,214,215,216,217,218],[219,220,221,222,223,224,225,226,227],[228,229,230,231,232,233,234,235,236,237,238,239,240],[241,242,243,244,245,246,247,248,249,250,251,252,253,254,255,256,257,258,259,260,261,262,263],[264,265,266,267,268,269,270,271,272,273,274,275,276,277,278,279,280,281,282,283,284,285,286,287,288,289,290,291,292,293,294,295,296,297,298,299,300,301,302,303,304,305],[306,307,308,309,310,311,312,313,314,315,316,317,318,319,320,321,322,323,324,325,326],[327,328,329,330,331,332,333,334,335,336,337,338,339,340,341,342,343,344,345,346,347,348,349,350,351,352,353,354,355,356,357,358,359,360,361,362,363,364,365,366,367,368,369,370]]],
   [[[99.309,173.9],[99.377,173.98],[99.469,174.0],[101.3,173.999],[101.384,173.968],[101.434,173.9],[101.446,173.829],[101.448,168.109],[101.469,167.997],[101.537,167.863],[101.643,167.777],[101.777,167.749],[101.869,167.761],[101.981,167.828],[102.059,167.948],[102.095,168.109],[102.097,173.829],[102.109,173.9],[102.177,173.98],[102.269,174.0],[104.074,174.0],[104.166,173.98],[104.225,173.92],[104.246,173.829],[104.246,168.377],[104.211,167.909],[104.169,167.689],[104.031,167.277],[103.937,167.086],[103.703,166.74],[103.414,166.451],[103.069,166.217],[102.877,166.123],[102.466,165.986],[102.016,165.917],[101.535,165.917],[101.302,165.943],[100.868,166.046],[100.474,166.217],[100.129,166.451],[99.839,166.74],[99.606,167.086],[99.511,167.277],[99.374,167.689],[99.331,167.909],[99.297,168.377],[99.297,173.829],[109.396,173.774],[109.748,173.559],[110.05,173.286],[110.3,172.957],[110.497,172.574],[110.571,172.368],[110.67,171.928],[110.695,171.694],[110.697,171.246],[110.649,170.856],[110.552,170.495],[110.408,170.165],[110.319,170.015],[110.11,169.747],[109.843,169.508],[109.821,169.447],[110.757,166.169],[110.742,166.061],[110.689,166.015],[110.649,166.004],[108.718,166.002],[108.718,173.974],[109.007,173.919],[109.206,173.855],[117.857,168.483],[117.926,168.563],[118.017,168.583],[119.85,168.578],[119.91,168.551],[119.96,168.483],[119.974,168.101],[119.994,167.994],[120.035,167.903],[120.129,167.799],[120.247,167.752],[120.336,167.751],[120.417,167.774],[120.488,167.82],[120.548,167.887],[120.601,168.014],[120.611,168.114],[120.591,168.243],[120.53,168.371],[120.429,168.497],[120.007,168.848],[119.141,169.48],[118.849,169.716],[118.599,169.944],[118.483,170.069],[118.268,170.347],[118.074,170.663],[117.99,170.835],[117.922,171.015],[117.83,171.399],[117.8,171.817],[117.808,172.037],[117.876,172.451],[117.935,172.645],[118.01,172.83],[118.211,173.171],[118.333,173.323],[118.618,173.59],[118.96,173.806],[119.348,173.964],[119.773,174.06],[119.999,174.083],[120.473,174.083],[120.921,174.02],[121.33,173.893],[121.52,173.806],[121.862,173.59],[122.147,173.323],[122.269,173.171],[122.47,172.83],[122.545,172.645],[122.646,172.249],[122.672,172.037],[122.679,171.54],[122.634,171.44],[122.58,171.406],[122.509,171.394],[120.737,171.394],[120.666,171.406],[120.597,171.456],[120.571,171.516],[120.563,171.918],[120.525,172.063],[120.474,172.143],[120.407,172.203],[120.282,172.248],[120.142,172.239],[120.03,172.172],[119.974,172.097],[119.936,172.003],[119.914,171.829],[119.935,171.678],[119.996,171.531],[120.168,171.313],[120.503,171.023],[121.47,170.291],[121.931,169.909],[122.263,169.556],[122.439,169.297],[122.514,169.16],[122.632,168.866],[122.702,168.54],[122.726,168.183],[122.707,167.848],[122.651,167.537],[122.557,167.249],[122.426,166.984],[122.257,166.743],[122.051,166.526],[121.815,166.337],[121.555,166.183],[121.271,166.063],[120.964,165.977],[120.634,165.926],[120.28,165.909],[120.041,165.916],[119.594,165.977],[119.188,166.099],[119.0,166.183],[118.662,166.389],[118.378,166.643],[118.149,166.943],[117.98,167.283],[117.879,167.654],[117.846,168.057],[79.43,172.13],[79.423,170.994],[79.44,170.943],[79.491,170.926],[80.649,170.924],[80.714,170.905],[80.774,170.846],[80.794,170.754],[80.794,169.257],[80.783,169.186],[80.732,169.117],[80.649,169.087],[79.491,169.086],[79.453,169.078],[79.43,169.055],[79.423,166.171],[79.411,166.1],[79.377,166.046],[79.323,166.011],[79.251,166.0],[77.446,166.0],[77.374,166.011],[77.295,166.08],[77.274,166.171],[77.274,173.829],[77.295,173.92],[77.354,173.98],[77.446,174.0],[81.674,174.0],[81.746,173.989],[81.814,173.938],[81.846,173.829],[81.846,172.331],[81.834,172.26],[81.784,172.192],[81.674,172.16],[79.491,172.16],[79.453,172.152],[84.893,166.004],[83.046,166.0],[82.991,166.005],[82.917,166.046],[82.892,166.127],[84.52,173.851],[84.557,173.934],[84.622,173.983],[84.664,173.996],[85.109,174.0],[85.109,166.803],[85.015,166.111],[84.971,166.04],[86.952,173.934],[86.989,173.851],[88.611,166.183],[88.594,166.061],[88.54,166.015],[88.5,166.004],[86.611,166.0],[86.559,166.004],[86.48,166.04],[86.437,166.111],[86.309,166.978],[86.309,174.0],[86.844,173.996],[86.887,173.983],[89.891,173.9],[89.942,173.968],[90.026,173.999],[91.857,174.0],[91.967,173.968],[92.023,173.878],[92.029,166.171],[91.997,166.062],[91.907,166.005],[90.026,166.001],[89.942,166.032],[89.885,166.122],[89.88,173.829],[93.434,173.9],[93.503,173.98],[93.594,174.0],[95.4,174.0],[95.491,173.98],[95.551,173.92],[95.571,173.829],[95.573,167.888],[95.602,167.848],[95.64,167.84],[97.869,167.84],[97.978,167.808],[98.029,167.74],[98.04,167.669],[98.04,166.171],[98.02,166.08],[97.96,166.02],[97.869,166.0],[93.594,166.0],[93.503,166.02],[93.443,166.08],[93.423,166.171],[93.423,173.829],[105.679,166.032],[105.629,166.1],[105.617,166.171],[105.622,173.878],[105.679,173.968],[105.763,173.999],[107.518,174.0],[107.518,166.0],[105.789,166.0],[114.173,172.13],[114.166,170.994],[114.183,170.943],[114.234,170.926],[115.391,170.924],[115.457,170.905],[115.505,170.864],[115.537,170.754],[115.537,169.257],[115.517,169.166],[115.457,169.106],[115.391,169.087],[114.234,169.086],[114.183,169.069],[114.166,169.017],[114.173,167.87],[114.196,167.848],[114.234,167.84],[116.417,167.84],[116.527,167.808],[116.577,167.74],[116.589,167.669],[116.589,166.171],[116.568,166.08],[116.489,166.011],[116.417,166.0],[112.189,166.0],[112.097,166.02],[112.029,166.1],[112.017,166.171],[112.017,173.829],[112.037,173.92],[112.097,173.98],[112.189,174.0],[116.417,174.0],[116.489,173.989],[116.557,173.938],[116.589,173.829],[116.589,172.331],[116.577,172.26],[116.527,172.192],[116.417,172.16],[114.234,172.16],[114.196,172.152]],[[0,1,2,3,4,5,6,7,8,9,10,11,12,13,14,15,16,17,18,19,20,21,22,23,24,25,26,27,28,29,30,31,32,33,34,35,36,37,38,39,40,41,42,43,44,45,46],[47,48,49,50,51,52,53,54,55,56,57,58,59,60,61,62,63,64,65,66,67,68,69,70],[71,72,73,74,75,76,77,78,79,80,81,82,83,84,85,86,87,88,89,90,91,92,93,94,95,96,97,98,99,100,101,102,103,104,105,106,107,108,109,110,111,112,113,114,115,116,117,118,119,120,121,122,123,124,125,126,127,128,129,130,131,132,133,134,135,136,137,138,139,140,141,142,143,144,145,146,147,148,149,150,151,152,153,154,155,156,157,158,159,160,161,162,163,164,165,166,167,168,169,170,171,172,173,174,175],[176,177,178,179,180,181,182,183,184,185,186,187,188,189,190,191,192,193,194,195,196,197,198,199,200,201,202,203,204,205,206,207,208,209,210,211,212,213],[214,215,216,217,218,219,220,221,222,223,224,225,226],[227,228,229,230,231,232,233,234,235,236,237,238,239,240],[241,242,243,244,245,246,247,248,249,250,251,252,253],[254,255,256,257,258,259,260,261,262,263,264,265,266,267,268,269,270,271,272,273,274,275,276],[277,278,279,280,281,282,283,284,285],[286,287,288,289,290,291,292,293,294,295,296,297,298,299,300,301,302,303,304,305,306,307,308,309,310,311,312,313,314,315,316,317,318,319,320,321,322,323,324,325,326,327,328,329]]]],
  ["ENGINE_FIRE", 55, 148, 46.1, 12.6,
   [[[36.437,149.473],[36.426,149.438],[36.426,148.684],[36.437,148.648],[36.473,148.636],[37.268,148.636],[37.314,148.622],[37.355,148.581],[37.369,148.519],[37.369,147.489],[37.347,147.414],[37.268,147.372],[36.473,147.371],[36.437,147.36],[36.426,147.324],[36.431,146.536],[36.473,146.515],[37.974,146.515],[38.049,146.493],[38.084,146.446],[38.091,146.397],[38.091,145.368],[38.077,145.305],[38.023,145.258],[35.066,145.25],[35.004,145.264],[34.956,145.319],[34.949,150.632],[34.963,150.695],[35.004,150.736],[35.066,150.75],[37.974,150.75],[38.023,150.742],[38.07,150.707],[38.091,150.632],[38.091,149.603],[38.084,149.554],[38.049,149.507],[37.974,149.485],[36.473,149.485],[42.658,150.742],[42.713,150.695],[42.727,150.632],[42.727,145.368],[42.705,145.293],[42.658,145.258],[42.609,145.25],[41.211,145.25],[41.151,145.261],[41.109,145.295],[40.488,147.733],[40.456,147.756],[40.433,147.725],[40.449,145.368],[40.435,145.305],[40.394,145.264],[40.331,145.25],[39.105,145.25],[39.03,145.272],[38.995,145.319],[38.987,145.368],[38.987,150.632],[39.009,150.707],[39.056,150.742],[39.105,150.75],[40.488,150.75],[40.547,150.739],[40.589,150.705],[41.219,148.259],[41.25,148.228],[41.274,148.259],[41.266,150.632],[41.28,150.695],[41.321,150.736],[41.384,150.75],[43.756,149.874],[43.848,150.059],[43.966,150.228],[44.11,150.381],[44.276,150.513],[44.458,150.621],[44.658,150.705],[44.875,150.765],[45.109,150.801],[45.359,150.813],[45.686,150.791],[45.986,150.726],[46.126,150.676],[46.384,150.546],[46.605,150.378],[46.787,150.172],[46.864,150.055],[46.984,149.798],[47.056,149.513],[47.074,149.361],[47.08,148.943],[47.066,148.88],[47.025,148.839],[46.962,148.825],[45.672,148.833],[45.625,148.868],[45.606,148.909],[45.601,149.266],[45.573,149.391],[45.487,149.508],[45.395,149.545],[45.291,149.538],[45.206,149.485],[45.145,149.391],[45.118,149.266],[45.118,146.734],[45.162,146.574],[45.206,146.515],[45.26,146.475],[45.324,146.455],[45.395,146.455],[45.487,146.492],[45.573,146.609],[45.601,146.734],[45.598,147.193],[45.57,147.213],[45.43,147.228],[45.389,147.269],[45.376,147.314],[45.375,148.236],[45.406,148.322],[45.493,148.354],[46.962,148.354],[47.025,148.34],[47.072,148.285],[47.08,146.79],[47.056,146.483],[47.026,146.339],[46.93,146.07],[46.787,145.828],[46.605,145.622],[46.384,145.454],[46.126,145.324],[45.986,145.274],[45.686,145.209],[45.359,145.187],[45.109,145.199],[44.875,145.236],[44.658,145.296],[44.458,145.381],[44.276,145.49],[44.11,145.623],[43.966,145.777],[43.848,145.947],[43.756,146.133],[43.691,146.336],[43.652,146.555],[43.639,146.79],[43.639,149.218],[43.652,149.453],[43.691,149.672],[48.005,150.695],[48.046,150.736],[48.109,150.75],[49.351,150.75],[49.426,150.728],[49.465,150.666],[49.469,145.368],[49.447,145.293],[49.385,145.253],[48.092,145.251],[48.034,145.272],[47.995,145.334],[47.991,150.632],[54.112,150.736],[54.153,150.695],[54.167,150.632],[54.167,145.368],[54.145,145.293],[54.098,145.258],[54.049,145.25],[52.651,145.25],[52.591,145.261],[52.549,145.295],[51.928,147.733],[51.896,147.756],[51.873,147.725],[51.889,145.368],[51.875,145.305],[51.834,145.264],[51.771,145.25],[50.545,145.25],[50.47,145.272],[50.435,145.319],[50.427,145.368],[50.427,150.632],[50.449,150.707],[50.496,150.742],[50.545,150.75],[51.928,150.75],[51.987,150.739],[52.029,150.705],[52.659,148.259],[52.69,148.228],[52.714,148.259],[52.706,150.632],[52.72,150.695],[52.761,150.736],[52.824,150.75],[54.049,150.75],[56.615,149.473],[56.603,149.438],[56.603,148.684],[56.615,148.648],[56.65,148.636],[57.446,148.636],[57.491,148.622],[57.532,148.581],[57.546,148.519],[57.546,147.489],[57.524,147.414],[57.446,147.372],[56.65,147.371],[56.615,147.36],[56.603,147.324],[56.608,146.536],[56.65,146.515],[58.151,146.515],[58.226,146.493],[58.261,146.446],[58.269,146.397],[58.269,145.368],[58.255,145.305],[58.2,145.258],[55.244,145.25],[55.181,145.264],[55.134,145.319],[55.126,150.632],[55.14,150.695],[55.181,150.736],[55.244,150.75],[58.151,150.75],[58.2,150.742],[58.247,150.707],[58.269,150.632],[58.269,149.603],[58.261,149.554],[58.226,149.507],[58.151,149.485],[56.65,149.485],[62.618,149.473],[62.606,149.438],[62.606,148.684],[62.618,148.648],[62.653,148.636],[63.448,148.636],[63.494,148.622],[63.535,148.581],[63.549,148.519],[63.541,147.44],[63.506,147.393],[63.448,147.372],[62.653,147.371],[62.611,147.35],[62.606,145.368],[62.574,145.281],[62.488,145.25],[61.197,145.258],[61.143,145.305],[61.129,145.368],[61.129,150.632],[61.143,150.695],[61.184,150.736],[61.246,150.75],[64.154,150.75],[64.203,150.742],[64.25,150.707],[64.271,150.632],[64.271,149.603],[64.264,149.554],[64.229,149.507],[64.154,149.485],[62.653,149.485],[65.081,150.681],[65.115,150.728],[65.173,150.749],[66.432,150.75],[66.507,150.728],[66.547,150.666],[66.55,145.368],[66.528,145.293],[66.466,145.253],[65.173,145.251],[65.115,145.272],[65.076,145.334],[69.022,147.362],[68.994,147.352],[68.986,147.316],[68.986,145.368],[68.964,145.293],[68.917,145.258],[68.868,145.25],[67.626,145.25],[67.551,145.272],[67.516,145.319],[67.509,145.368],[67.509,150.632],[67.523,150.695],[67.577,150.742],[69.394,150.75],[69.548,150.744],[69.839,150.694],[70.106,150.594],[70.348,150.447],[70.556,150.259],[70.728,150.033],[70.863,149.77],[70.954,149.48],[70.999,149.165],[70.988,148.72],[70.939,148.462],[70.802,148.114],[70.673,147.915],[70.514,147.744],[70.414,147.662],[70.398,147.62],[71.041,145.372],[71.041,145.315],[71.017,145.274],[70.934,145.25],[69.654,145.25],[69.571,145.276],[69.528,145.352],[69.049,147.324],[68.987,149.452],[68.987,148.52],[68.998,148.499],[69.033,148.487],[69.243,148.502],[69.379,148.577],[69.479,148.715],[69.525,148.907],[69.525,149.06],[69.501,149.197],[69.422,149.355],[69.297,149.453],[69.193,149.481],[69.033,149.485],[69.007,149.48],[73.391,149.464],[73.386,148.684],[73.398,148.648],[73.433,148.636],[74.228,148.636],[74.307,148.594],[74.329,148.519],[74.329,147.489],[74.315,147.426],[74.274,147.385],[74.228,147.372],[73.433,147.371],[73.398,147.36],[73.386,147.324],[73.391,146.536],[73.433,146.515],[74.934,146.515],[75.009,146.493],[75.044,146.446],[75.051,146.397],[75.051,145.368],[75.037,145.305],[74.983,145.258],[72.026,145.25],[71.964,145.264],[71.916,145.319],[71.909,150.632],[71.923,150.695],[71.964,150.736],[72.026,150.75],[74.934,150.75],[74.983,150.742],[75.03,150.707],[75.051,150.632],[75.051,149.603],[75.044,149.554],[75.009,149.507],[74.934,149.485],[73.433,149.485]],[[0,1,2,3,4,5,6,7,8,9,10,11,12,13,14,15,16,17,18,19,20,21,22,23,24,25,26,27,28,29,30,31,32,33,34,35,36,37,38,39],[40,41,42,43,44,45,46,47,48,49,50,51,52,53,54,55,56,57,58,59,60,61,62,63,64,65,66,67,68,69,70,71,72,73,74],[75,76,77,78,79,80,81,82,83,84,85,86,87,88,89,90,91,92,93,94,95,96,97,98,99,100,101,102,103,104,105,106,107,108,109,110,111,112,113,114,115,116,117,118,119,120,121,122,123,124,125,126,127,128,129,130,131,132,133,134,135,136,137,138,139,140,141,142,143,144,145,146,147,148,149,150,151,152,153,154,155],[156,157,158,159,160,161,162,163,164,165,166,167,168],[169,170,171,172,173,174,175,176,177,178,179,180,181,182,183,184,185,186,187,188,189,190,191,192,193,194,195,196,197,198,199,200,201,202,203,204],[205,206,207,208,209,210,211,212,213,214,215,216,217,218,219,220,221,222,223,224,225,226,227,228,229,230,231,232,233,234,235,236,237,238,239,240,241,242,243,244],[245,246,247,248,249,250,251,252,253,254,255,256,257,258,259,260,261,262,263,264,265,266,267,268,269,270,271,272,273,274,275,276,277],[278,279,280,281,282,283,284,285,286,287,288,289],[290,291,292,293,294,295,296,297,298,299,300,301,302,303,304,305,306,307,308,309,310,311,312,313,314,315,316,317,318,319,320,321,322,323,324,325,326,327,328],[329,330,331,332,333,334,335,336,337,338,339,340,341,342,343],[344,345,346,347,348,349,350,351,352,353,354,355,356,357,358,359,360,361,362,363,364,365,366,367,368,369,370,371,372,373,374,375,376,377,378,379,380,381,382]]],
   [[[36.437,149.473],[36.426,149.438],[36.426,148.684],[36.437,148.648],[36.473,148.636],[37.268,148.636],[37.314,148.622],[37.355,148.581],[37.369,148.519],[37.369,147.489],[37.347,147.414],[37.268,147.372],[36.473,147.371],[36.437,147.36],[36.426,147.324],[36.431,146.536],[36.473,146.515],[37.974,146.515],[38.049,146.493],[38.084,146.446],[38.091,146.397],[38.091,145.368],[38.077,145.305],[38.023,145.258],[35.066,145.25],[35.004,145.264],[34.956,145.319],[34.949,150.632],[34.963,150.695],[35.004,150.736],[35.066,150.75],[37.974,150.75],[38.023,150.742],[38.07,150.707],[38.091,150.632],[38.091,149.603],[38.084,149.554],[38.049,149.507],[37.974,149.485],[36.473,149.485],[42.658,150.742],[42.713,150.695],[42.727,150.632],[42.727,145.368],[42.705,145.293],[42.658,145.258],[42.609,145.25],[41.211,145.25],[41.151,145.261],[41.109,145.295],[40.488,147.733],[40.456,147.756],[40.433,147.725],[40.449,145.368],[40.435,145.305],[40.394,145.264],[40.331,145.25],[39.105,145.25],[39.03,145.272],[38.995,145.319],[38.987,145.368],[38.987,150.632],[39.009,150.707],[39.056,150.742],[39.105,150.75],[40.488,150.75],[40.547,150.739],[40.589,150.705],[41.219,148.259],[41.25,148.228],[41.274,148.259],[41.266,150.632],[41.28,150.695],[41.321,150.736],[41.384,150.75],[43.756,149.874],[43.848,150.059],[43.966,150.228],[44.11,150.381],[44.276,150.513],[44.458,150.621],[44.658,150.705],[44.875,150.765],[45.109,150.801],[45.359,150.813],[45.686,150.791],[45.986,150.726],[46.126,150.676],[46.384,150.546],[46.605,150.378],[46.787,150.172],[46.864,150.055],[46.984,149.798],[47.056,149.513],[47.074,149.361],[47.08,148.943],[47.066,148.88],[47.025,148.839],[46.962,148.825],[45.672,148.833],[45.625,148.868],[45.606,148.909],[45.601,149.266],[45.573,149.391],[45.487,149.508],[45.395,149.545],[45.291,149.538],[45.206,149.485],[45.145,149.391],[45.118,149.266],[45.118,146.734],[45.162,146.574],[45.206,146.515],[45.26,146.475],[45.324,146.455],[45.395,146.455],[45.487,146.492],[45.573,146.609],[45.601,146.734],[45.598,147.193],[45.57,147.213],[45.43,147.228],[45.389,147.269],[45.376,147.314],[45.375,148.236],[45.406,148.322],[45.493,148.354],[46.962,148.354],[47.025,148.34],[47.072,148.285],[47.08,146.79],[47.056,146.483],[47.026,146.339],[46.93,146.07],[46.787,145.828],[46.605,145.622],[46.384,145.454],[46.126,145.324],[45.986,145.274],[45.686,145.209],[45.359,145.187],[45.109,145.199],[44.875,145.236],[44.658,145.296],[44.458,145.381],[44.276,145.49],[44.11,145.623],[43.966,145.777],[43.848,145.947],[43.756,146.133],[43.691,146.336],[43.652,146.555],[43.639,146.79],[43.639,149.218],[43.652,149.453],[43.691,149.672],[48.005,150.695],[48.046,150.736],[48.109,150.75],[49.351,150.75],[49.426,150.728],[49.465,150.666],[49.469,145.368],[49.447,145.293],[49.385,145.253],[48.092,145.251],[48.034,145.272],[47.995,145.334],[47.991,150.632],[54.112,150.736],[54.153,150.695],[54.167,150.632],[54.167,145.368],[54.145,145.293],[54.098,145.258],[54.049,145.25],[52.651,145.25],[52.591,145.261],[52.549,145.295],[51.928,147.733],[51.896,147.756],[51.873,147.725],[51.889,145.368],[51.875,145.305],[51.834,145.264],[51.771,145.25],[50.545,145.25],[50.47,145.272],[50.435,145.319],[50.427,145.368],[50.427,150.632],[50.449,150.707],[50.496,150.742],[50.545,150.75],[51.928,150.75],[51.987,150.739],[52.029,150.705],[52.659,148.259],[52.69,148.228],[52.714,148.259],[52.706,150.632],[52.72,150.695],[52.761,150.736],[52.824,150.75],[54.049,150.75],[56.615,149.473],[56.603,149.438],[56.603,148.684],[56.615,148.648],[56.65,148.636],[57.446,148.636],[57.491,148.622],[57.532,148.581],[57.546,148.519],[57.546,147.489],[57.524,147.414],[57.446,147.372],[56.65,147.371],[56.615,147.36],[56.603,147.324],[56.608,146.536],[56.65,146.515],[58.151,146.515],[58.226,146.493],[58.261,146.446],[58.269,146.397],[58.269,145.368],[58.255,145.305],[58.2,145.258],[55.244,145.25],[55.181,145.264],[55.134,145.319],[55.126,150.632],[55.14,150.695],[55.181,150.736],[55.244,150.75],[58.151,150.75],[58.2,150.742],[58.247,150.707],[58.269,150.632],[58.269,149.603],[58.261,149.554],[58.226,149.507],[58.151,149.485],[56.65,149.485],[70.457,150.358],[70.647,150.151],[70.801,149.905],[70.914,149.628],[70.982,149.326],[70.999,149.165],[71.001,148.856],[70.968,148.588],[70.901,148.34],[70.741,148.01],[70.597,147.826],[70.414,147.662],[70.398,147.62],[71.041,145.372],[71.041,145.315],[71.017,145.274],[70.934,145.25],[69.828,145.25],[69.828,150.697],[70.106,150.594],[70.231,150.526],[62.611,149.464],[62.606,148.684],[62.618,148.648],[62.653,148.636],[63.448,148.636],[63.494,148.622],[63.535,148.581],[63.549,148.519],[63.541,147.44],[63.506,147.393],[63.448,147.372],[62.653,147.371],[62.611,147.35],[62.606,145.368],[62.574,145.281],[62.488,145.25],[61.197,145.258],[61.143,145.305],[61.129,145.368],[61.129,150.632],[61.143,150.695],[61.184,150.736],[61.246,150.75],[64.154,150.75],[64.203,150.742],[64.25,150.707],[64.271,150.632],[64.271,149.603],[64.264,149.554],[64.229,149.507],[64.154,149.485],[62.653,149.485],[65.081,150.681],[65.115,150.728],[65.173,150.749],[66.432,150.75],[66.507,150.728],[66.547,150.666],[66.55,145.368],[66.528,145.293],[66.466,145.253],[65.173,145.251],[65.115,145.272],[65.076,145.334],[67.551,145.272],[67.516,145.319],[67.509,145.368],[67.512,150.666],[67.551,150.728],[67.609,150.749],[68.628,150.75],[68.628,145.25],[67.626,145.25],[73.391,149.464],[73.386,148.684],[73.398,148.648],[73.433,148.636],[74.228,148.636],[74.307,148.594],[74.329,148.519],[74.329,147.489],[74.315,147.426],[74.274,147.385],[74.228,147.372],[73.433,147.371],[73.398,147.36],[73.386,147.324],[73.391,146.536],[73.433,146.515],[74.934,146.515],[75.009,146.493],[75.044,146.446],[75.051,146.397],[75.051,145.368],[75.037,145.305],[74.983,145.258],[72.026,145.25],[71.964,145.264],[71.916,145.319],[71.909,150.632],[71.923,150.695],[71.964,150.736],[72.026,150.75],[74.934,150.75],[74.983,150.742],[75.03,150.707],[75.051,150.632],[75.051,149.603],[75.044,149.554],[75.009,149.507],[74.934,149.485],[73.433,149.485]],[[0,1,2,3,4,5,6,7,8,9,10,11,12,13,14,15,16,17,18,19,20,21,22,23,24,25,26,27,28,29,30,31,32,33,34,35,36,37,38,39],[40,41,42,43,44,45,46,47,48,49,50,51,52,53,54,55,56,57,58,59,60,61,62,63,64,65,66,67,68,69,70,71,72,73,74],[75,76,77,78,79,80,81,82,83,84,85,86,87,88,89,90,91,92,93,94,95,96,97,98,99,100,101,102,103,104,105,106,107,108,109,110,111,112,113,114,115,116,117,118,119,120,121,122,123,124,125,126,127,128,129,130,131,132,133,134,135,136,137,138,139,140,141,142,143,144,145,146,147,148,149,150,151,152,153,154,155],[156,157,158,159,160,161,162,163,164,165,166,167,168],[169,170,171,172,173,174,175,176,177,178,179,180,181,182,183,184,185,186,187,188,189,190,191,192,193,194,195,196,197,198,199,200,201,202,203,204],[205,206,207,208,209,210,211,212,213,214,215,216,217,218,219,220,221,222,223,224,225,226,227,228,229,230,231,232,233,234,235,236,237,238,239,240,241,242,243,244],[245,246,247,248,249,250,251,252,253,254,255,256,257,258,259,260,261,262,263,264,265],[266,267,268,269,270,271,272,273,274,275,276,277,278,279,280,281,282,283,284,285,286,287,288,289,290,291,292,293,294,295,296,297],[298,299,300,301,302,303,304,305,306,307,308,309],[310,311,312,313,314,315,316,317,318],[319,320,321,322,323,324,325,326,327,328,329,330,331,332,333,334,335,336,337,338,339,340,341,342,343,344,345,346,347,348,349,350,351,352,353,354,355,356,357]]]],
  ["CABIN_LEAK", 145, 148, 45.09, 12.6,
   [[[125.572,149.839],[125.663,150.032],[125.78,150.207],[125.923,150.365],[126.088,150.502],[126.27,150.614],[126.47,150.701],[126.688,150.763],[126.923,150.8],[127.176,150.813],[127.427,150.8],[127.661,150.763],[127.877,150.701],[128.077,150.614],[128.26,150.502],[128.425,150.365],[128.569,150.207],[128.687,150.032],[128.779,149.839],[128.844,149.628],[128.884,149.4],[128.896,149.098],[128.875,149.038],[128.828,148.999],[127.537,148.951],[127.472,148.963],[127.423,149.027],[127.418,149.3],[127.39,149.411],[127.304,149.513],[127.212,149.546],[127.108,149.539],[127.023,149.493],[126.962,149.411],[126.934,149.3],[126.932,146.735],[126.949,146.616],[126.999,146.527],[127.077,146.471],[127.176,146.452],[127.275,146.471],[127.353,146.527],[127.412,146.653],[127.423,146.981],[127.449,147.03],[127.501,147.054],[128.797,147.017],[128.854,146.993],[128.889,146.942],[128.891,146.696],[128.843,146.388],[128.747,146.107],[128.681,145.977],[128.604,145.855],[128.421,145.64],[128.201,145.464],[128.076,145.391],[127.803,145.278],[127.503,145.21],[127.176,145.187],[126.925,145.2],[126.692,145.238],[126.475,145.301],[126.275,145.39],[126.092,145.504],[125.927,145.643],[125.783,145.803],[125.665,145.981],[125.573,146.175],[125.508,146.387],[125.468,146.615],[125.455,146.861],[125.455,149.155],[125.468,149.4],[125.507,149.628],[132.048,145.97],[132.0,145.996],[131.309,145.996],[131.275,145.986],[131.254,145.955],[131.17,145.326],[131.14,145.278],[131.086,145.253],[129.816,145.25],[129.749,145.264],[129.715,145.306],[129.714,145.376],[130.83,150.648],[130.875,150.724],[130.929,150.747],[132.393,150.75],[132.457,150.739],[132.517,150.679],[133.642,145.376],[133.63,145.292],[133.594,145.26],[133.532,145.25],[132.267,145.25],[132.201,145.262],[132.147,145.326],[131.873,147.14],[131.662,148.589],[131.639,148.621],[131.615,148.589],[131.428,147.161],[131.437,147.14],[131.466,147.128],[131.835,147.128],[134.557,145.272],[134.523,145.319],[134.515,145.368],[134.515,150.632],[134.529,150.695],[134.57,150.736],[134.632,150.75],[136.33,150.739],[136.584,150.707],[136.818,150.654],[137.031,150.579],[137.223,150.483],[137.394,150.365],[137.542,150.226],[137.663,150.065],[137.757,149.882],[137.824,149.677],[137.864,149.451],[137.877,149.202],[137.865,148.971],[137.828,148.761],[137.766,148.572],[137.678,148.402],[137.566,148.254],[137.418,148.115],[137.405,148.087],[137.589,147.913],[137.733,147.734],[137.844,147.532],[137.924,147.309],[137.972,147.065],[137.988,146.798],[137.974,146.559],[137.934,146.339],[137.868,146.138],[137.774,145.956],[137.655,145.794],[137.508,145.651],[137.341,145.528],[137.16,145.428],[136.964,145.35],[136.754,145.295],[136.529,145.261],[136.29,145.25],[134.632,145.25],[136.47,147.299],[136.388,147.451],[136.315,147.516],[136.18,147.552],[136.025,147.551],[135.997,147.531],[135.992,146.562],[136.013,146.52],[136.172,146.515],[136.266,146.529],[136.383,146.605],[136.445,146.691],[136.487,146.803],[136.508,146.94],[136.5,147.169],[136.013,148.61],[136.186,148.617],[136.275,148.654],[136.343,148.715],[136.392,148.801],[136.422,148.911],[136.422,149.179],[136.392,149.289],[136.343,149.375],[136.275,149.436],[136.186,149.473],[136.025,149.484],[135.993,149.452],[135.992,148.652],[138.875,150.681],[138.91,150.728],[138.968,150.749],[140.227,150.75],[140.302,150.728],[140.341,150.666],[140.345,145.368],[140.323,145.293],[140.261,145.253],[138.968,145.251],[138.91,145.272],[138.871,145.334],[144.974,150.742],[145.029,150.695],[145.043,150.632],[145.043,145.368],[145.021,145.293],[144.974,145.258],[144.925,145.25],[143.527,145.25],[143.467,145.261],[143.426,145.295],[142.804,147.733],[142.773,147.756],[142.749,147.725],[142.765,145.368],[142.751,145.305],[142.71,145.264],[142.647,145.25],[141.421,145.25],[141.346,145.272],[141.311,145.319],[141.303,145.368],[141.303,150.632],[141.325,150.707],[141.372,150.742],[141.421,150.75],[142.804,150.75],[142.863,150.739],[142.905,150.705],[143.535,148.259],[143.566,148.228],[143.59,148.259],[143.582,150.632],[143.596,150.695],[143.637,150.736],[143.7,150.75],[147.974,150.681],[148.021,150.736],[148.084,150.75],[149.325,150.75],[149.388,150.736],[149.429,150.695],[149.443,150.632],[149.445,146.548],[149.464,146.52],[149.49,146.515],[151.023,146.515],[151.098,146.493],[151.132,146.446],[151.14,146.397],[151.14,145.368],[151.126,145.305],[151.085,145.264],[151.023,145.25],[148.084,145.25],[148.021,145.264],[147.98,145.305],[147.966,145.368],[153.509,149.473],[153.498,149.438],[153.498,148.684],[153.509,148.648],[153.545,148.636],[154.34,148.636],[154.385,148.622],[154.426,148.581],[154.44,148.519],[154.44,147.489],[154.419,147.414],[154.34,147.372],[153.545,147.371],[153.509,147.36],[153.498,147.324],[153.503,146.536],[153.545,146.515],[155.045,146.515],[155.121,146.493],[155.155,146.446],[155.163,146.397],[155.163,145.368],[155.149,145.305],[155.094,145.258],[152.138,145.25],[152.075,145.264],[152.028,145.319],[152.02,150.632],[152.034,150.695],[152.075,150.736],[152.138,150.75],[155.045,150.75],[155.094,150.742],[155.141,150.707],[155.163,150.632],[155.163,149.603],[155.155,149.554],[155.121,149.507],[155.045,149.485],[153.545,149.485],[158.311,145.975],[158.267,145.996],[157.575,145.996],[157.542,145.986],[157.521,145.955],[157.436,145.326],[157.406,145.278],[157.352,145.253],[156.083,145.25],[156.015,145.264],[155.981,145.306],[155.98,145.376],[157.096,150.648],[157.141,150.724],[157.195,150.747],[158.66,150.75],[158.723,150.739],[158.783,150.679],[159.909,145.376],[159.897,145.292],[159.86,145.26],[159.799,145.25],[158.534,145.25],[158.468,145.262],[158.414,145.326],[158.144,147.149],[157.929,148.589],[157.905,148.621],[157.882,148.589],[157.694,147.161],[157.703,147.14],[157.733,147.128],[158.102,147.128],[160.795,150.695],[160.836,150.736],[160.899,150.75],[162.14,150.75],[162.227,150.719],[162.258,150.632],[162.258,149.076],[162.263,149.052],[162.284,149.041],[162.313,149.069],[162.973,150.656],[163.028,150.726],[163.115,150.75],[164.411,150.75],[164.466,150.74],[164.505,150.711],[164.521,150.666],[164.505,150.609],[163.394,148.259],[164.537,145.384],[164.542,145.305],[164.519,145.27],[164.442,145.25],[163.138,145.25],[163.052,145.274],[162.997,145.344],[162.385,146.977],[162.364,146.994],[162.334,146.967],[162.259,146.763],[162.258,145.368],[162.227,145.281],[162.14,145.25],[160.899,145.25],[160.85,145.258],[160.803,145.293],[160.781,145.368],[160.781,150.632]],[[0,1,2,3,4,5,6,7,8,9,10,11,12,13,14,15,16,17,18,19,20,21,22,23,24,25,26,27,28,29,30,31,32,33,34,35,36,37,38,39,40,41,42,43,44,45,46,47,48,49,50,51,52,53,54,55,56,57,58,59,60,61,62,63,64,65,66,67,68,69,70,71,72,73,74],[75,76,77,78,79,80,81,82,83,84,85,86,87,88,89,90,91,92,93,94,95,96,97,98,99],[100,101,102,103,104,105,106,107],[108,109,110,111,112,113,114,115,116,117,118,119,120,121,122,123,124,125,126,127,128,129,130,131,132,133,134,135,136,137,138,139,140,141,142,143,144,145,146,147,148,149,150,151,152],[153,154,155,156,157,158,159,160,161,162,163,164,165,166,167],[168,169,170,171,172,173,174,175,176,177,178,179,180,181],[182,183,184,185,186,187,188,189,190,191,192,193],[194,195,196,197,198,199,200,201,202,203,204,205,206,207,208,209,210,211,212,213,214,215,216,217,218,219,220,221,222,223,224,225,226,227,228],[229,230,231,232,233,234,235,236,237,238,239,240,241,242,243,244,245,246,247,248,249,250],[251,252,253,254,255,256,257,258,259,260,261,262,263,264,265,266,267,268,269,270,271,272,273,274,275,276,277,278,279,280,281,282,283,284,285,286,287,288,289,290],[291,292,293,294,295,296,297,298,299,300,301,302,303,304,305,306,307,308,309,310,311,312,313,314,315],[316,317,318,319,320,321,322,323],[324,325,326,327,328,329,330,331,332,333,334,335,336,337,338,339,340,341,342,343,344,345,346,347,348,349,350,351,352,353,354,355,356,357,358,359,360,361]]],
   [[[137.542,150.226],[137.663,150.065],[137.757,149.882],[137.824,149.677],[137.864,149.451],[137.877,149.202],[137.865,148.971],[137.828,148.761],[137.766,148.572],[137.678,148.402],[137.566,148.254],[137.418,148.115],[137.405,148.087],[137.589,147.913],[137.733,147.734],[137.844,147.532],[137.924,147.309],[137.972,147.065],[137.988,146.798],[137.974,146.559],[137.934,146.339],[137.868,146.138],[137.774,145.956],[137.655,145.794],[137.508,145.651],[137.341,145.528],[137.16,145.428],[136.964,145.35],[136.807,145.308],[136.807,150.656],[137.031,150.579],[137.223,150.483],[137.394,150.365],[125.663,150.032],[125.78,150.207],[125.923,150.365],[126.088,150.502],[126.27,150.614],[126.47,150.701],[126.688,150.763],[126.923,150.8],[127.176,150.813],[127.427,150.8],[127.661,150.763],[127.877,150.701],[128.077,150.614],[128.26,150.502],[128.425,150.365],[128.569,150.207],[128.687,150.032],[128.779,149.839],[128.844,149.628],[128.884,149.4],[128.896,149.098],[128.875,149.038],[128.828,148.999],[127.537,148.951],[127.472,148.963],[127.423,149.027],[127.418,149.3],[127.39,149.411],[127.304,149.513],[127.212,149.546],[127.108,149.539],[127.023,149.493],[126.962,149.411],[126.934,149.3],[126.932,146.735],[126.949,146.616],[126.999,146.527],[127.077,146.471],[127.176,146.452],[127.275,146.471],[127.353,146.527],[127.412,146.653],[127.423,146.981],[127.449,147.03],[127.501,147.054],[128.797,147.017],[128.854,146.993],[128.889,146.942],[128.891,146.696],[128.843,146.388],[128.747,146.107],[128.681,145.977],[128.604,145.855],[128.421,145.64],[128.201,145.464],[128.076,145.391],[127.803,145.278],[127.503,145.21],[127.176,145.187],[126.925,145.2],[126.692,145.238],[126.475,145.301],[126.275,145.39],[126.092,145.504],[125.927,145.643],[125.783,145.803],[125.665,145.981],[125.573,146.175],[125.508,146.387],[125.468,146.615],[125.455,146.861],[125.455,149.155],[125.468,149.4],[125.507,149.628],[125.572,149.839],[129.71,145.337],[130.83,150.648],[130.855,150.705],[130.899,150.739],[131.047,150.75],[131.047,145.25],[129.816,145.25],[129.728,145.281],[132.501,150.705],[132.527,150.648],[133.642,145.376],[133.63,145.292],[133.566,145.253],[132.247,145.252],[132.247,150.75],[132.427,150.747],[134.529,145.305],[134.515,145.368],[134.518,150.666],[134.557,150.728],[134.615,150.749],[135.607,150.75],[135.607,145.25],[134.615,145.251],[134.57,145.264],[138.881,150.695],[138.922,150.736],[138.985,150.75],[140.227,150.75],[140.302,150.728],[140.341,150.666],[140.345,145.368],[140.323,145.293],[140.261,145.253],[138.968,145.251],[138.91,145.272],[138.871,145.334],[138.868,150.632],[144.974,150.742],[145.029,150.695],[145.043,150.632],[145.043,145.368],[145.021,145.293],[144.974,145.258],[144.925,145.25],[143.527,145.25],[143.467,145.261],[143.426,145.295],[142.804,147.733],[142.773,147.756],[142.749,147.725],[142.765,145.368],[142.751,145.305],[142.71,145.264],[142.647,145.25],[141.421,145.25],[141.346,145.272],[141.311,145.319],[141.303,145.368],[141.303,150.632],[141.325,150.707],[141.372,150.742],[141.421,150.75],[142.804,150.75],[142.863,150.739],[142.905,150.705],[143.535,148.259],[143.566,148.228],[143.59,148.259],[143.582,150.632],[143.596,150.695],[143.637,150.736],[143.7,150.75],[147.98,150.695],[148.021,150.736],[148.084,150.75],[149.325,150.75],[149.388,150.736],[149.429,150.695],[149.443,150.632],[149.445,146.548],[149.464,146.52],[149.49,146.515],[151.023,146.515],[151.098,146.493],[151.132,146.446],[151.14,146.397],[151.14,145.368],[151.126,145.305],[151.085,145.264],[151.023,145.25],[148.084,145.25],[148.021,145.264],[147.98,145.305],[147.966,145.368],[147.966,150.632],[153.503,149.464],[153.498,148.684],[153.509,148.648],[153.545,148.636],[154.34,148.636],[154.419,148.594],[154.44,148.519],[154.44,147.489],[154.426,147.426],[154.385,147.385],[154.34,147.372],[153.545,147.371],[153.509,147.36],[153.498,147.324],[153.503,146.536],[153.545,146.515],[155.045,146.515],[155.121,146.493],[155.155,146.446],[155.163,146.397],[155.163,145.368],[155.149,145.305],[155.094,145.258],[152.138,145.25],[152.075,145.264],[152.028,145.319],[152.02,150.632],[152.034,150.695],[152.075,150.736],[152.138,150.75],[155.045,150.75],[155.094,150.742],[155.141,150.707],[155.163,150.632],[155.163,149.603],[155.155,149.554],[155.121,149.507],[155.045,149.485],[153.545,149.485],[155.981,145.306],[155.98,145.376],[157.096,150.648],[157.121,150.705],[157.166,150.739],[157.313,150.75],[157.313,145.25],[156.083,145.25],[156.015,145.264],[158.783,150.679],[159.909,145.376],[159.897,145.292],[159.833,145.253],[158.513,145.252],[158.513,150.75],[158.694,150.747],[158.748,150.724],[160.795,150.695],[160.836,150.736],[160.899,150.75],[162.14,150.75],[162.227,150.719],[162.258,150.632],[162.258,149.076],[162.263,149.052],[162.284,149.041],[162.313,149.069],[162.973,150.656],[163.028,150.726],[163.115,150.75],[164.411,150.75],[164.466,150.74],[164.505,150.711],[164.521,150.666],[164.505,150.609],[163.394,148.259],[164.537,145.384],[164.542,145.305],[164.519,145.27],[164.442,145.25],[163.138,145.25],[163.052,145.274],[162.997,145.344],[162.385,146.977],[162.364,146.994],[162.334,146.967],[162.259,146.763],[162.258,145.368],[162.227,145.281],[162.14,145.25],[160.899,145.25],[160.85,145.258],[160.803,145.293],[160.781,145.368],[160.781,150.632]],[[0,1,2,3,4,5,6,7,8,9,10,11,12,13,14,15,16,17,18,19,20,21,22,23,24,25,26,27,28,29,30,31,32],[33,34,35,36,37,38,39,40,41,42,43,44,45,46,47,48,49,50,51,52,53,54,55,56,57,58,59,60,61,62,63,64,65,66,67,68,69,70,71,72,73,74,75,76,77,78,79,80,81,82,83,84,85,86,87,88,89,90,91,92,93,94,95,96,97,98,99,100,101,102,103,104,105,106,107],[108,109,110,111,112,113,114,115],[116,117,118,119,120,121,122,123],[124,125,126,127,128,129,130,131,132],[133,134,135,136,137,138,139,140,141,142,143,144,145],[146,147,148,149,150,151,152,153,154,155,156,157,158,159,160,161,162,163,164,165,166,167,168,169,170,171,172,173,174,175,176,177,178,179,180],[181,182,183,184,185,186,187,188,189,190,191,192,193,194,195,196,197,198,199,200,201,202,203],[204,205,206,207,208,209,210,211,212,213,214,215,216,217,218,219,220,221,222,223,224,225,226,227,228,229,230,231,232,233,234,235,236,237,238,239,240,241,242],[243,244,245,246,247,248,249,250,251],[252,253,254,255,256,257,258,259],[260,261,262,263,264,265,266,267,268,269,270,271,272,273,274,275,276,277,278,279,280,281,282,283,284,285,286,287,288,289,290,291,292,293,294,295,296,297]]]],
  ["POWER_FAULT", 55, 106, 51.93, 12.6,
   [[[66.0,108.681],[66.047,108.736],[66.11,108.75],[67.369,108.749],[67.427,108.728],[67.461,108.681],[67.471,104.7],[67.485,104.623],[67.532,104.531],[67.605,104.472],[67.697,104.452],[67.788,104.472],[67.837,104.507],[67.891,104.589],[67.916,104.7],[67.925,108.681],[67.972,108.736],[68.035,108.75],[69.276,108.75],[69.339,108.736],[69.38,108.695],[69.394,108.632],[69.394,104.884],[69.371,104.562],[69.3,104.266],[69.247,104.128],[69.182,103.996],[69.022,103.759],[68.822,103.56],[68.585,103.399],[68.453,103.334],[68.171,103.24],[67.861,103.193],[67.53,103.193],[67.371,103.211],[67.072,103.281],[66.801,103.399],[66.564,103.56],[66.365,103.759],[66.204,103.996],[66.139,104.128],[66.045,104.411],[65.998,104.72],[65.992,104.884],[35.396,106.226],[35.269,105.971],[35.107,105.753],[34.91,105.575],[34.681,105.437],[34.557,105.385],[34.289,105.316],[33.998,105.293],[33.558,105.293],[33.516,105.272],[33.511,103.368],[33.479,103.281],[33.393,103.25],[32.151,103.25],[32.065,103.281],[32.034,103.368],[32.034,108.632],[32.065,108.719],[32.151,108.75],[34.073,108.744],[34.222,108.725],[34.501,108.65],[34.631,108.594],[34.873,108.447],[35.081,108.258],[35.253,108.03],[35.388,107.765],[35.479,107.471],[35.524,107.152],[35.525,106.818],[35.482,106.509],[34.006,107.242],[33.947,107.347],[33.822,107.451],[33.66,107.485],[33.543,107.484],[33.516,107.464],[33.511,106.479],[33.532,106.437],[33.718,106.436],[33.822,106.465],[33.909,106.522],[33.979,106.609],[34.026,106.724],[34.05,106.868],[34.041,107.11],[36.543,108.018],[36.662,108.197],[36.807,108.357],[36.974,108.496],[37.159,108.61],[37.362,108.699],[37.582,108.762],[37.82,108.8],[38.076,108.813],[38.331,108.8],[38.569,108.762],[38.79,108.699],[38.992,108.61],[39.177,108.496],[39.345,108.357],[39.49,108.197],[39.609,108.018],[39.701,107.823],[39.767,107.61],[39.807,107.379],[39.82,107.131],[39.82,104.869],[39.807,104.621],[39.767,104.39],[39.701,104.177],[39.609,103.982],[39.49,103.803],[39.345,103.643],[39.177,103.504],[38.992,103.39],[38.79,103.301],[38.569,103.238],[38.331,103.2],[38.076,103.187],[37.82,103.2],[37.582,103.238],[37.362,103.301],[37.159,103.39],[36.974,103.504],[36.807,103.643],[36.662,103.803],[36.543,103.982],[36.45,104.177],[36.384,104.39],[36.345,104.621],[36.331,104.869],[36.331,107.131],[36.345,107.379],[36.384,107.61],[36.45,107.823],[38.325,107.342],[38.294,107.42],[38.219,107.506],[38.153,107.537],[38.035,107.545],[37.933,107.506],[37.879,107.454],[37.84,107.383],[37.811,107.247],[37.811,104.753],[37.84,104.617],[37.879,104.546],[37.933,104.494],[38.035,104.455],[38.153,104.463],[38.247,104.518],[38.311,104.617],[38.341,104.753],[38.343,107.194],[40.672,108.726],[40.755,108.75],[42.036,108.75],[42.102,108.738],[42.144,108.701],[42.161,108.64],[42.429,106.244],[42.459,106.223],[42.475,106.236],[42.784,108.701],[42.826,108.738],[42.892,108.75],[43.851,108.75],[43.941,108.722],[43.976,108.64],[44.307,106.231],[44.342,106.216],[44.361,106.236],[44.589,108.64],[44.606,108.701],[44.645,108.738],[44.707,108.75],[45.956,108.75],[46.051,108.719],[46.066,108.624],[45.061,103.352],[45.016,103.276],[44.927,103.25],[43.843,103.25],[43.777,103.262],[43.735,103.299],[43.386,105.889],[43.36,105.906],[43.333,105.889],[43.065,103.36],[43.048,103.299],[43.006,103.262],[42.939,103.25],[41.847,103.25],[41.783,103.261],[41.739,103.295],[41.714,103.352],[40.645,108.624],[40.648,108.685],[48.421,107.464],[48.416,106.684],[48.427,106.648],[48.463,106.636],[49.258,106.636],[49.337,106.594],[49.359,106.519],[49.359,105.489],[49.345,105.426],[49.304,105.385],[49.258,105.372],[48.463,105.371],[48.427,105.36],[48.416,105.324],[48.421,104.536],[48.463,104.515],[49.964,104.515],[50.039,104.493],[50.074,104.446],[50.081,104.397],[50.081,103.368],[50.067,103.305],[50.013,103.258],[47.056,103.25],[46.994,103.264],[46.946,103.319],[46.939,108.632],[46.953,108.695],[46.994,108.736],[47.056,108.75],[49.964,108.75],[50.013,108.742],[50.06,108.707],[50.081,108.632],[50.081,107.603],[50.074,107.554],[50.039,107.507],[49.964,107.485],[48.463,107.485],[52.496,105.359],[52.468,105.358],[52.454,105.316],[52.454,103.368],[52.432,103.293],[52.386,103.258],[52.336,103.25],[51.095,103.25],[51.02,103.272],[50.985,103.319],[50.977,103.368],[50.977,108.632],[50.991,108.695],[51.046,108.742],[52.863,108.75],[53.017,108.744],[53.308,108.694],[53.575,108.594],[53.817,108.447],[54.025,108.259],[54.197,108.033],[54.332,107.77],[54.422,107.48],[54.468,107.165],[54.457,106.72],[54.407,106.462],[54.271,106.114],[54.142,105.915],[53.983,105.744],[53.883,105.662],[53.867,105.62],[54.509,103.372],[54.51,103.315],[54.485,103.274],[54.403,103.25],[53.122,103.25],[53.04,103.276],[52.996,103.352],[52.517,105.324],[52.46,107.464],[52.456,106.52],[52.466,106.499],[52.501,106.487],[52.712,106.502],[52.848,106.577],[52.948,106.715],[52.993,106.907],[52.993,107.06],[52.97,107.197],[52.89,107.355],[52.766,107.453],[52.604,107.485],[52.487,107.484],[58.83,107.473],[58.819,107.438],[58.819,106.684],[58.83,106.648],[58.866,106.636],[59.661,106.636],[59.706,106.622],[59.747,106.581],[59.761,106.519],[59.754,105.44],[59.719,105.393],[59.661,105.372],[58.866,105.371],[58.824,105.35],[58.819,103.368],[58.787,103.281],[58.701,103.25],[57.41,103.258],[57.355,103.305],[57.341,103.368],[57.341,108.632],[57.355,108.695],[57.396,108.736],[57.459,108.75],[60.366,108.75],[60.416,108.742],[60.462,108.707],[60.484,108.632],[60.484,107.603],[60.476,107.554],[60.442,107.507],[60.366,107.485],[58.866,107.485],[63.542,103.97],[63.494,103.996],[62.802,103.996],[62.768,103.986],[62.748,103.955],[62.663,103.326],[62.633,103.278],[62.579,103.253],[61.309,103.25],[61.242,103.264],[61.208,103.306],[61.207,103.376],[62.323,108.648],[62.368,108.724],[62.422,108.747],[63.886,108.75],[63.975,108.724],[64.01,108.679],[65.136,103.376],[65.123,103.292],[65.087,103.26],[65.026,103.25],[63.761,103.25],[63.694,103.262],[63.641,103.326],[63.366,105.14],[63.156,106.589],[63.132,106.621],[63.109,106.589],[62.921,105.161],[62.937,105.133],[62.959,105.128],[63.329,105.128],[70.351,108.695],[70.392,108.736],[70.455,108.75],[71.696,108.75],[71.759,108.736],[71.8,108.695],[71.814,108.632],[71.816,104.548],[71.826,104.527],[71.861,104.515],[73.394,104.515],[73.469,104.493],[73.504,104.446],[73.511,104.397],[73.511,103.368],[73.497,103.305],[73.456,103.264],[73.394,103.25],[70.455,103.25],[70.392,103.264],[70.351,103.305],[70.337,103.368],[70.337,108.632],[77.952,107.54],[77.911,107.499],[77.866,107.486],[76.921,107.485],[76.886,107.473],[76.876,107.452],[76.874,103.368],[76.86,103.305],[76.819,103.264],[76.756,103.25],[75.515,103.25],[75.452,103.264],[75.411,103.305],[75.397,103.368],[75.396,107.452],[75.385,107.473],[75.35,107.485],[74.429,107.486],[74.35,107.528],[74.329,107.603],[74.329,108.632],[74.343,108.695],[74.384,108.736],[74.446,108.75],[77.898,108.742],[77.952,108.695],[77.966,108.632],[77.966,107.603]],[[0,1,2,3,4,5,6,7,8,9,10,11,12,13,14,15,16,17,18,19,20,21,22,23,24,25,26,27,28,29,30,31,32,33,34,35,36,37,38,39,40,41,42,43],[44,45,46,47,48,49,50,51,52,53,54,55,56,57,58,59,60,61,62,63,64,65,66,67,68,69,70,71,72,73,74],[75,76,77,78,79,80,81,82,83,84,85,86,87,88,89],[90,91,92,93,94,95,96,97,98,99,100,101,102,103,104,105,106,107,108,109,110,111,112,113,114,115,116,117,118,119,120,121,122,123,124,125,126,127,128,129,130,131,132,133,134,135,136,137,138,139],[140,141,142,143,144,145,146,147,148,149,150,151,152,153,154,155,156,157,158],[159,160,161,162,163,164,165,166,167,168,169,170,171,172,173,174,175,176,177,178,179,180,181,182,183,184,185,186,187,188,189,190,191,192,193,194,195,196,197,198,199,200,201,202],[203,204,205,206,207,208,209,210,211,212,213,214,215,216,217,218,219,220,221,222,223,224,225,226,227,228,229,230,231,232,233,234,235,236,237,238,239,240,241],[242,243,244,245,246,247,248,249,250,251,252,253,254,255,256,257,258,259,260,261,262,263,264,265,266,267,268,269,270,271,272,273,274,275,276,277,278,279,280],[281,282,283,284,285,286,287,288,289,290,291,292,293,294],[295,296,297,298,299,300,301,302,303,304,305,306,307,308,309,310,311,312,313,314,315,316,317,318,319,320,321,322,323,324,325,326,327],[328,329,330,331,332,333,334,335,336,337,338,339,340,341,342,343,344,345,346,347,348,349,350,351,352],[353,354,355,356,357,358,359,360],[361,362,363,364,365,366,367,368,369,370,371,372,373,374,375,376,377,378,379,380,381,382,383],[384,385,386,387,388,389,390,391,392,393,394,395,396,397,398,399,400,401,402,403,404,405,406,407,408,409,410,411]]],
   [[[32.089,103.264],[32.048,103.305],[32.034,103.368],[32.037,108.666],[32.076,108.728],[32.134,108.749],[33.154,108.75],[33.154,103.25],[32.151,103.25],[36.974,108.496],[37.159,108.61],[37.362,108.699],[37.476,108.732],[37.476,103.268],[37.362,103.301],[37.159,103.39],[36.974,103.504],[36.807,103.643],[36.662,103.803],[36.543,103.982],[36.45,104.177],[36.384,104.39],[36.345,104.621],[36.331,104.869],[36.331,107.131],[36.345,107.379],[36.384,107.61],[36.45,107.823],[36.543,108.018],[36.662,108.197],[36.807,108.357],[40.672,108.726],[40.755,108.75],[42.036,108.75],[42.102,108.738],[42.144,108.701],[42.161,108.64],[42.429,106.244],[42.459,106.223],[42.475,106.236],[42.784,108.701],[42.826,108.738],[42.892,108.75],[43.851,108.75],[43.941,108.722],[43.976,108.64],[44.307,106.231],[44.342,106.216],[44.361,106.236],[44.589,108.64],[44.606,108.701],[44.645,108.738],[44.707,108.75],[45.956,108.75],[46.051,108.719],[46.066,108.624],[45.061,103.352],[45.016,103.276],[44.927,103.25],[43.843,103.25],[43.777,103.262],[43.735,103.299],[43.386,105.889],[43.36,105.906],[43.333,105.889],[43.065,103.36],[43.048,103.299],[43.006,103.262],[42.939,103.25],[41.847,103.25],[41.783,103.261],[41.739,103.295],[41.714,103.352],[40.645,108.624],[40.648,108.685],[48.421,107.464],[48.416,106.684],[48.427,106.648],[48.463,106.636],[49.258,106.636],[49.337,106.594],[49.359,106.519],[49.359,105.489],[49.345,105.426],[49.304,105.385],[49.258,105.372],[48.463,105.371],[48.427,105.36],[48.416,105.324],[48.421,104.536],[48.463,104.515],[49.964,104.515],[50.039,104.493],[50.074,104.446],[50.081,104.397],[50.081,103.368],[50.067,103.305],[50.013,103.258],[47.056,103.25],[46.994,103.264],[46.946,103.319],[46.939,108.632],[46.953,108.695],[46.994,108.736],[47.056,108.75],[49.964,108.75],[50.013,108.742],[50.06,108.707],[50.081,108.632],[50.081,107.603],[50.074,107.554],[50.039,107.507],[49.964,107.485],[48.463,107.485],[51.02,103.272],[50.985,103.319],[50.977,103.368],[50.981,108.666],[51.02,108.728],[51.077,108.749],[52.096,108.75],[52.096,103.25],[51.095,103.25],[39.609,108.018],[39.701,107.823],[39.767,107.61],[39.807,107.379],[39.82,107.131],[39.82,104.869],[39.807,104.621],[39.767,104.39],[39.701,104.177],[39.609,103.982],[39.49,103.803],[39.345,103.643],[39.177,103.504],[38.992,103.39],[38.79,103.301],[38.676,103.268],[38.676,108.732],[38.79,108.699],[38.992,108.61],[39.177,108.496],[39.345,108.357],[39.49,108.197],[35.192,105.857],[35.013,105.66],[34.799,105.501],[34.557,105.385],[34.354,105.33],[34.354,108.696],[34.631,108.594],[34.756,108.526],[34.982,108.357],[35.081,108.258],[35.253,108.03],[35.388,107.765],[35.439,107.621],[35.507,107.315],[35.524,107.152],[35.53,106.982],[35.509,106.66],[35.482,106.509],[35.396,106.226],[35.337,106.094],[66.0,108.681],[66.047,108.736],[66.11,108.75],[67.369,108.749],[67.427,108.728],[67.461,108.681],[67.471,104.7],[67.485,104.623],[67.532,104.531],[67.605,104.472],[67.697,104.452],[67.788,104.472],[67.837,104.507],[67.891,104.589],[67.916,104.7],[67.925,108.681],[67.972,108.736],[68.035,108.75],[69.276,108.75],[69.339,108.736],[69.38,108.695],[69.394,108.632],[69.394,104.884],[69.371,104.562],[69.3,104.266],[69.247,104.128],[69.182,103.996],[69.022,103.759],[68.822,103.56],[68.585,103.399],[68.453,103.334],[68.171,103.24],[67.861,103.193],[67.53,103.193],[67.371,103.211],[67.072,103.281],[66.801,103.399],[66.564,103.56],[66.365,103.759],[66.204,103.996],[66.139,104.128],[66.045,104.411],[65.998,104.72],[65.992,104.884],[53.925,108.358],[54.115,108.151],[54.269,107.905],[54.383,107.628],[54.451,107.326],[54.468,107.165],[54.469,106.856],[54.436,106.588],[54.37,106.34],[54.21,106.01],[54.066,105.826],[53.883,105.662],[53.867,105.62],[54.509,103.372],[54.51,103.315],[54.485,103.274],[54.403,103.25],[53.296,103.25],[53.296,108.697],[53.575,108.594],[53.7,108.526],[58.824,107.464],[58.819,106.684],[58.83,106.648],[58.866,106.636],[59.661,106.636],[59.706,106.622],[59.747,106.581],[59.761,106.519],[59.754,105.44],[59.719,105.393],[59.661,105.372],[58.866,105.371],[58.824,105.35],[58.819,103.368],[58.787,103.281],[58.701,103.25],[57.41,103.258],[57.355,103.305],[57.341,103.368],[57.341,108.632],[57.355,108.695],[57.396,108.736],[57.459,108.75],[60.366,108.75],[60.416,108.742],[60.462,108.707],[60.484,108.632],[60.484,107.603],[60.476,107.554],[60.442,107.507],[60.366,107.485],[58.866,107.485],[61.203,103.337],[62.323,108.648],[62.348,108.705],[62.393,108.739],[62.54,108.75],[62.54,103.25],[61.309,103.25],[61.242,103.264],[61.221,103.281],[64.01,108.679],[65.136,103.376],[65.123,103.292],[65.059,103.253],[63.74,103.252],[63.74,108.75],[63.921,108.747],[63.975,108.724],[70.351,108.695],[70.392,108.736],[70.455,108.75],[71.696,108.75],[71.759,108.736],[71.8,108.695],[71.814,108.632],[71.816,104.548],[71.826,104.527],[71.861,104.515],[73.394,104.515],[73.469,104.493],[73.504,104.446],[73.511,104.397],[73.511,103.368],[73.497,103.305],[73.456,103.264],[73.394,103.25],[70.455,103.25],[70.392,103.264],[70.351,103.305],[70.337,103.368],[70.337,108.632],[77.952,107.54],[77.911,107.499],[77.866,107.486],[76.921,107.485],[76.886,107.473],[76.876,107.452],[76.874,103.368],[76.86,103.305],[76.819,103.264],[76.756,103.25],[75.515,103.25],[75.452,103.264],[75.411,103.305],[75.397,103.368],[75.396,107.452],[75.385,107.473],[75.35,107.485],[74.429,107.486],[74.35,107.528],[74.329,107.603],[74.329,108.632],[74.343,108.695],[74.384,108.736],[74.446,108.75],[77.898,108.742],[77.952,108.695],[77.966,108.632],[77.966,107.603]],[[0,1,2,3,4,5,6,7,8],[9,10,11,12,13,14,15,16,17,18,19,20,21,22,23,24,25,26,27,28,29,30],[31,32,33,34,35,36,37,38,39,40,41,42,43,44,45,46,47,48,49,50,51,52,53,54,55,56,57,58,59,60,61,62,63,64,65,66,67,68,69,70,71,72,73,74],[75,76,77,78,79,80,81,82,83,84,85,86,87,88,89,90,91,92,93,94,95,96,97,98,99,100,101,102,103,104,105,106,107,108,109,110,111,112,113],[114,115,116,117,118,119,120,121,122],[123,124,125,126,127,128,129,130,131,132,133,134,135,136,137,138,139,140,141,142,143,144],[145,146,147,148,149,150,151,152,153,154,155,156,157,158,159,160,161,162,163,164],[165,166,167,168,169,170,171,172,173,174,175,176,177,178,179,180,181,182,183,184,185,186,187,188,189,190,191,192,193,194,195,196,197,198,199,200,201,202,203,204,205,206,207,208],[209,210,211,212,213,214,215,216,217,218,219,220,221,222,223,224,225,226,227,228,229],[230,231,232,233,234,235,236,237,238,239,240,241,242,243,244,245,246,247,248,249,250,251,252,253,254,255,256,257,258,259,260,261],[262,263,264,265,266,267,268,269,270],[271,272,273,274,275,276,277,278],[279,280,281,282,283,284,285,286,287,288,289,290,291,292,293,294,295,296,297,298,299,300,301],[302,303,304,305,306,307,308,309,310,311,312,313,314,315,316,317,318,319,320,321,322,323,324,325,326,327,328,329]]]],
  ["SENSOR_GLITCH", 145, 106, 56.86, 12.6,
   [[[119.61,104.957],[119.657,105.012],[119.72,105.026],[120.979,105.022],[121.021,105.004],[121.055,104.957],[121.079,104.621],[121.107,104.558],[121.171,104.487],[121.253,104.454],[121.37,104.47],[121.46,104.548],[121.496,104.635],[121.503,104.704],[121.489,104.792],[121.447,104.88],[121.377,104.967],[121.088,105.208],[120.493,105.642],[120.12,105.961],[119.892,106.238],[119.701,106.574],[119.617,106.827],[119.591,106.962],[119.57,107.249],[119.576,107.401],[119.593,107.546],[119.663,107.818],[119.715,107.946],[119.853,108.18],[120.03,108.381],[120.133,108.468],[120.368,108.616],[120.635,108.726],[120.927,108.791],[121.082,108.807],[121.408,108.807],[121.716,108.764],[121.997,108.676],[122.128,108.616],[122.363,108.468],[122.466,108.381],[122.643,108.18],[122.781,107.946],[122.833,107.818],[122.902,107.546],[122.92,107.401],[122.924,107.059],[122.894,106.99],[122.808,106.959],[121.541,106.966],[121.494,107.001],[121.475,107.042],[121.47,107.319],[121.444,107.419],[121.363,107.515],[121.277,107.546],[121.181,107.539],[121.104,107.493],[121.039,107.377],[121.024,107.257],[121.038,107.154],[121.08,107.053],[121.199,106.903],[121.429,106.703],[122.093,106.2],[122.411,105.937],[122.639,105.695],[122.811,105.422],[122.892,105.22],[122.941,104.996],[122.957,104.751],[122.944,104.52],[122.905,104.306],[122.841,104.108],[122.751,103.927],[122.635,103.761],[122.493,103.611],[122.331,103.482],[122.152,103.376],[121.957,103.293],[121.746,103.234],[121.519,103.199],[121.111,103.192],[120.804,103.234],[120.525,103.318],[120.395,103.376],[120.163,103.518],[119.968,103.692],[119.81,103.898],[119.694,104.132],[119.625,104.387],[119.602,104.664],[125.303,107.464],[125.298,106.684],[125.31,106.648],[125.345,106.636],[126.141,106.636],[126.219,106.594],[126.241,106.519],[126.241,105.489],[126.227,105.426],[126.186,105.385],[126.141,105.372],[125.345,105.371],[125.31,105.36],[125.298,105.324],[125.303,104.536],[125.345,104.515],[126.846,104.515],[126.921,104.493],[126.956,104.446],[126.964,104.397],[126.964,103.368],[126.95,103.305],[126.895,103.258],[123.939,103.25],[123.876,103.264],[123.829,103.319],[123.821,108.632],[123.835,108.695],[123.876,108.736],[123.939,108.75],[126.846,108.75],[126.895,108.742],[126.942,108.707],[126.964,108.632],[126.964,107.603],[126.956,107.554],[126.921,107.507],[126.846,107.485],[125.345,107.485],[131.545,108.736],[131.586,108.695],[131.6,108.632],[131.6,103.368],[131.578,103.293],[131.531,103.258],[131.482,103.25],[130.083,103.25],[130.024,103.261],[129.982,103.295],[129.36,105.733],[129.329,105.756],[129.305,105.725],[129.321,103.368],[129.307,103.305],[129.266,103.264],[129.203,103.25],[127.978,103.25],[127.902,103.272],[127.868,103.319],[127.86,103.368],[127.86,108.632],[127.881,108.707],[127.928,108.742],[127.978,108.75],[129.36,108.75],[129.42,108.739],[129.462,108.705],[130.091,106.259],[130.123,106.228],[130.146,106.259],[130.138,108.632],[130.152,108.695],[130.193,108.736],[130.256,108.75],[131.482,108.75],[132.535,104.957],[132.582,105.012],[132.645,105.026],[133.904,105.022],[133.946,105.004],[133.98,104.957],[134.004,104.621],[134.032,104.558],[134.096,104.487],[134.178,104.454],[134.295,104.47],[134.385,104.548],[134.421,104.635],[134.428,104.704],[134.414,104.792],[134.372,104.88],[134.303,104.967],[134.013,105.208],[133.418,105.642],[133.045,105.961],[132.817,106.238],[132.626,106.574],[132.542,106.827],[132.516,106.962],[132.495,107.249],[132.501,107.401],[132.518,107.546],[132.588,107.818],[132.64,107.946],[132.778,108.18],[132.862,108.285],[133.058,108.468],[133.293,108.616],[133.56,108.726],[133.852,108.791],[134.007,108.807],[134.333,108.807],[134.641,108.764],[134.922,108.676],[135.053,108.616],[135.288,108.468],[135.391,108.381],[135.568,108.18],[135.706,107.946],[135.758,107.818],[135.827,107.546],[135.845,107.401],[135.849,107.059],[135.819,106.99],[135.733,106.959],[134.466,106.966],[134.419,107.001],[134.4,107.042],[134.395,107.319],[134.369,107.419],[134.288,107.515],[134.202,107.546],[134.106,107.539],[134.029,107.493],[133.964,107.377],[133.949,107.257],[133.963,107.154],[134.005,107.053],[134.124,106.903],[134.354,106.703],[135.018,106.2],[135.336,105.937],[135.564,105.695],[135.736,105.422],[135.817,105.22],[135.866,104.996],[135.882,104.751],[135.869,104.52],[135.83,104.306],[135.766,104.108],[135.676,103.927],[135.56,103.761],[135.418,103.611],[135.256,103.482],[135.077,103.376],[134.882,103.293],[134.671,103.234],[134.444,103.199],[134.036,103.192],[133.729,103.234],[133.45,103.318],[133.32,103.376],[133.088,103.518],[132.893,103.692],[132.735,103.898],[132.619,104.132],[132.55,104.387],[132.527,104.664],[137.029,108.197],[137.174,108.357],[137.342,108.496],[137.527,108.61],[137.729,108.699],[137.95,108.762],[138.188,108.8],[138.443,108.813],[138.699,108.8],[138.937,108.762],[139.157,108.699],[139.36,108.61],[139.545,108.496],[139.712,108.357],[139.857,108.197],[139.976,108.018],[140.069,107.823],[140.135,107.61],[140.174,107.379],[140.188,107.131],[140.188,104.869],[140.174,104.621],[140.135,104.39],[140.069,104.177],[139.976,103.982],[139.857,103.803],[139.712,103.643],[139.545,103.504],[139.36,103.39],[139.157,103.301],[138.937,103.238],[138.699,103.2],[138.443,103.187],[138.188,103.2],[137.95,103.238],[137.729,103.301],[137.527,103.39],[137.342,103.504],[137.174,103.643],[137.029,103.803],[136.91,103.982],[136.818,104.177],[136.752,104.39],[136.712,104.621],[136.699,104.869],[136.699,107.131],[136.712,107.379],[136.752,107.61],[136.818,107.823],[136.91,108.018],[138.679,107.383],[138.615,107.482],[138.555,107.524],[138.484,107.545],[138.366,107.537],[138.3,107.506],[138.225,107.42],[138.178,107.247],[138.178,104.753],[138.194,104.658],[138.247,104.546],[138.3,104.494],[138.403,104.455],[138.521,104.463],[138.615,104.518],[138.679,104.617],[138.708,104.753],[138.71,107.194],[142.613,105.362],[142.584,105.352],[142.576,105.316],[142.576,103.368],[142.554,103.293],[142.507,103.258],[142.458,103.25],[141.217,103.25],[141.141,103.272],[141.107,103.319],[141.099,103.368],[141.099,108.632],[141.113,108.695],[141.168,108.742],[142.985,108.75],[143.287,108.725],[143.43,108.694],[143.697,108.594],[143.939,108.447],[144.147,108.259],[144.319,108.033],[144.453,107.77],[144.544,107.48],[144.59,107.165],[144.579,106.72],[144.529,106.462],[144.393,106.114],[144.263,105.915],[144.105,105.744],[144.005,105.662],[143.989,105.62],[144.631,103.372],[144.632,103.315],[144.607,103.274],[144.525,103.25],[143.244,103.25],[143.161,103.276],[143.118,103.352],[142.639,105.324],[142.577,107.452],[142.577,106.52],[142.588,106.499],[142.623,106.487],[142.834,106.502],[142.97,106.577],[143.069,106.715],[143.115,106.907],[143.115,107.06],[143.092,107.197],[143.012,107.355],[142.887,107.453],[142.784,107.481],[142.623,107.485],[142.588,107.473],[147.534,107.874],[147.626,108.059],[147.743,108.228],[147.888,108.381],[148.053,108.513],[148.236,108.621],[148.436,108.705],[148.652,108.765],[148.886,108.801],[149.137,108.813],[149.464,108.791],[149.617,108.764],[149.903,108.676],[150.161,108.546],[150.382,108.378],[150.478,108.279],[150.641,108.055],[150.761,107.798],[150.833,107.513],[150.851,107.361],[150.858,106.943],[150.844,106.88],[150.803,106.839],[150.74,106.825],[149.449,106.833],[149.402,106.868],[149.384,106.909],[149.379,107.266],[149.351,107.391],[149.264,107.508],[149.172,107.545],[149.068,107.538],[148.983,107.485],[148.923,107.391],[148.895,107.266],[148.895,104.734],[148.94,104.574],[148.983,104.515],[149.038,104.475],[149.101,104.455],[149.172,104.455],[149.264,104.492],[149.351,104.609],[149.379,104.734],[149.375,105.193],[149.348,105.213],[149.208,105.228],[149.166,105.269],[149.153,105.314],[149.153,106.236],[149.184,106.322],[149.27,106.354],[150.74,106.354],[150.803,106.34],[150.85,106.285],[150.858,104.79],[150.833,104.483],[150.803,104.339],[150.707,104.07],[150.565,103.828],[150.382,103.622],[150.161,103.454],[149.903,103.324],[149.764,103.274],[149.464,103.209],[149.137,103.187],[148.886,103.199],[148.652,103.236],[148.436,103.296],[148.236,103.381],[148.053,103.49],[147.888,103.623],[147.743,103.777],[147.626,103.947],[147.534,104.133],[147.468,104.336],[147.429,104.555],[147.416,104.79],[147.416,107.218],[147.429,107.453],[147.468,107.672],[151.783,108.695],[151.824,108.736],[151.887,108.75],[153.128,108.75],[153.191,108.736],[153.232,108.695],[153.246,108.632],[153.247,104.548],[153.258,104.527],[153.293,104.515],[154.825,104.515],[154.901,104.493],[154.935,104.446],[154.943,104.397],[154.943,103.368],[154.929,103.305],[154.888,103.264],[154.825,103.25],[151.887,103.25],[151.824,103.264],[151.783,103.305],[151.769,103.368],[151.769,108.632],[155.837,108.695],[155.878,108.736],[155.941,108.75],[157.183,108.75],[157.258,108.728],[157.297,108.666],[157.3,103.368],[157.279,103.293],[157.217,103.253],[155.923,103.251],[155.866,103.272],[155.827,103.334],[155.823,108.632],[161.826,107.554],[161.791,107.507],[161.734,107.486],[160.789,107.485],[160.754,107.473],[160.743,107.452],[160.742,103.368],[160.728,103.305],[160.687,103.264],[160.624,103.25],[159.382,103.25],[159.32,103.264],[159.279,103.305],[159.265,103.368],[159.263,107.452],[159.253,107.473],[159.218,107.485],[158.296,107.486],[158.218,107.528],[158.196,107.603],[158.196,108.632],[158.21,108.695],[158.251,108.736],[158.314,108.75],[161.765,108.742],[161.812,108.707],[161.833,108.65],[162.89,108.032],[163.007,108.207],[163.15,108.365],[163.315,108.502],[163.497,108.614],[163.697,108.701],[163.915,108.763],[164.15,108.8],[164.403,108.813],[164.654,108.8],[164.888,108.763],[165.104,108.701],[165.304,108.614],[165.487,108.502],[165.653,108.365],[165.797,108.207],[165.914,108.032],[166.006,107.839],[166.072,107.628],[166.111,107.4],[166.123,107.098],[166.102,107.038],[166.055,106.999],[164.765,106.951],[164.699,106.963],[164.65,107.027],[164.645,107.3],[164.617,107.411],[164.531,107.513],[164.439,107.546],[164.335,107.539],[164.25,107.493],[164.189,107.411],[164.161,107.3],[164.16,104.735],[164.176,104.616],[164.226,104.527],[164.304,104.471],[164.403,104.452],[164.502,104.471],[164.58,104.527],[164.639,104.653],[164.65,104.981],[164.676,105.03],[164.729,105.054],[166.024,105.017],[166.081,104.993],[166.116,104.942],[166.118,104.696],[166.07,104.388],[165.974,104.107],[165.908,103.977],[165.745,103.742],[165.649,103.64],[165.428,103.464],[165.303,103.391],[165.03,103.278],[164.73,103.21],[164.403,103.187],[164.152,103.2],[163.919,103.238],[163.702,103.301],[163.502,103.39],[163.32,103.504],[163.154,103.643],[163.01,103.803],[162.892,103.981],[162.8,104.175],[162.735,104.387],[162.696,104.615],[162.683,104.861],[162.683,107.155],[162.695,107.4],[162.734,107.628],[162.799,107.839],[170.375,108.736],[170.416,108.695],[170.43,108.632],[170.43,103.368],[170.416,103.305],[170.375,103.264],[170.312,103.25],[169.07,103.25],[168.984,103.281],[168.952,103.368],[168.951,105.339],[168.932,105.366],[168.905,105.371],[168.544,105.371],[168.509,105.36],[168.497,105.324],[168.497,103.368],[168.475,103.293],[168.428,103.258],[168.379,103.25],[167.137,103.25],[167.075,103.264],[167.034,103.305],[167.02,103.368],[167.02,108.632],[167.034,108.695],[167.075,108.736],[167.137,108.75],[168.379,108.75],[168.465,108.719],[168.497,108.632],[168.498,106.669],[168.518,106.642],[168.544,106.636],[168.905,106.636],[168.941,106.648],[168.952,106.684],[168.952,108.632],[168.974,108.707],[169.021,108.742],[169.07,108.75],[170.312,108.75]],[[0,1,2,3,4,5,6,7,8,9,10,11,12,13,14,15,16,17,18,19,20,21,22,23,24,25,26,27,28,29,30,31,32,33,34,35,36,37,38,39,40,41,42,43,44,45,46,47,48,49,50,51,52,53,54,55,56,57,58,59,60,61,62,63,64,65,66,67,68,69,70,71,72,73,74,75,76,77,78,79,80,81,82,83,84,85,86,87,88,89,90,91,92],[93,94,95,96,97,98,99,100,101,102,103,104,105,106,107,108,109,110,111,112,113,114,115,116,117,118,119,120,121,122,123,124,125,126,127,128,129,130,131],[132,133,134,135,136,137,138,139,140,141,142,143,144,145,146,147,148,149,150,151,152,153,154,155,156,157,158,159,160,161,162,163,164,165,166,167],[168,169,170,171,172,173,174,175,176,177,178,179,180,181,182,183,184,185,186,187,188,189,190,191,192,193,194,195,196,197,198,199,200,201,202,203,204,205,206,207,208,209,210,211,212,213,214,215,216,217,218,219,220,221,222,223,224,225,226,227,228,229,230,231,232,233,234,235,236,237,238,239,240,241,242,243,244,245,246,247,248,249,250,251,252,253,254,255,256,257,258,259,260],[261,262,263,264,265,266,267,268,269,270,271,272,273,274,275,276,277,278,279,280,281,282,283,284,285,286,287,288,289,290,291,292,293,294,295,296,297,298,299,300,301,302,303,304,305,306,307,308,309,310],[311,312,313,314,315,316,317,318,319,320,321,322,323,324,325,326,327,328],[329,330,331,332,333,334,335,336,337,338,339,340,341,342,343,344,345,346,347,348,349,350,351,352,353,354,355,356,357,358,359,360,361,362,363,364,365,366,367],[368,369,370,371,372,373,374,375,376,377,378,379,380,381,382],[383,384,385,386,387,388,389,390,391,392,393,394,395,396,397,398,399,400,401,402,403,404,405,406,407,408,409,410,411,412,413,414,415,416,417,418,419,420,421,422,423,424,425,426,427,428,429,430,431,432,433,434,435,436,437,438,439,440,441,442,443,444,445,446,447,448,449,450,451,452,453,454,455,456,457,458,459,460,461,462,463],[464,465,466,467,468,469,470,471,472,473,474,475,476,477,478,479,480,481,482,483,484,485,486],[487,488,489,490,491,492,493,494,495,496,497,498,499],[500,501,502,503,504,505,506,507,508,509,510,511,512,513,514,515,516,517,518,519,520,521,522,523,524,525,526],[527,528,529,530,531,532,533,534,535,536,537,538,539,540,541,542,543,544,545,546,547,548,549,550,551,552,553,554,555,556,557,558,559,560,561,562,563,564,565,566,567,568,569,570,571,572,573,574,575,576,577,578,579,580,581,582,583,584,585,586,587,588,589,590,591,592,593,594,595,596,597,598,599,600,601],[602,603,604,605,606,607,608,609,610,611,612,613,614,615,616,617,618,619,620,621,622,623,624,625,626,627,628,629,630,631,632,633,634,635,636,637,638,639,640,641,642,643]]],
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
