whyvas/filament-falcon/cad/panels/OPS_DASH_A.scad

// GENERATED by cad/tools/gen_panels.py from cad/tools/layouts.py - edit the layout there.
// Ops dash, left piece (power): pod lower band in front of the RIGHT seat, inboard half
// Nominal 200 x 160 mm (printed 199.5 x 159.5).
PART = "preview";
PANEL_ID = "OPS_DASH_A";
W = 200;
H = 160;
SEAM_L = false;
SEAM_R = true;
CUTS = [["tog6", 35, 100], ["led5", 35, 84], ["tog6", 100, 100], ["led5", 100, 84], ["tog6", 165, 100], ["led5", 165, 84], ["tog6", 35, 44], ["led5", 35, 28], ["tog6", 100, 44], ["led5", 100, 28], ["arc19", 165, 44]];
SLOTS = [];
GROOVES = [];
LABELS = [
  ["REACTOR", 35, 118, 35.81, 12.6,
   [[[21.619,117.354],[21.586,117.358],[21.572,117.316],[21.572,115.368],[21.55,115.293],[21.503,115.258],[21.454,115.25],[20.213,115.25],[20.138,115.272],[20.103,115.319],[20.095,115.368],[20.095,120.632],[20.109,120.695],[20.164,120.742],[21.981,120.75],[22.135,120.744],[22.426,120.694],[22.693,120.594],[22.935,120.447],[23.143,120.259],[23.315,120.033],[23.45,119.77],[23.54,119.48],[23.586,119.165],[23.575,118.72],[23.525,118.462],[23.389,118.114],[23.259,117.915],[23.101,117.744],[23.001,117.662],[22.985,117.62],[23.627,115.372],[23.628,115.315],[23.603,115.274],[23.521,115.25],[22.24,115.25],[22.157,115.276],[22.114,115.352],[21.584,119.473],[21.572,119.438],[21.573,118.52],[21.584,118.499],[21.619,118.487],[21.83,118.502],[21.966,118.577],[22.065,118.715],[22.111,118.907],[22.111,119.06],[22.088,119.197],[22.008,119.355],[21.883,119.453],[21.78,119.481],[21.619,119.485],[25.984,119.473],[25.972,119.438],[25.972,118.684],[25.984,118.648],[26.019,118.636],[26.815,118.636],[26.86,118.622],[26.901,118.581],[26.915,118.519],[26.915,117.489],[26.893,117.414],[26.815,117.372],[26.019,117.371],[25.984,117.36],[25.972,117.324],[25.977,116.536],[26.019,116.515],[27.52,116.515],[27.595,116.493],[27.63,116.446],[27.638,116.397],[27.638,115.368],[27.624,115.305],[27.569,115.258],[24.613,115.25],[24.55,115.264],[24.503,115.319],[24.495,120.632],[24.509,120.695],[24.55,120.736],[24.613,120.75],[27.52,120.75],[27.569,120.742],[27.616,120.707],[27.638,120.632],[27.638,119.603],[27.63,119.554],[27.595,119.507],[27.52,119.485],[26.019,119.485],[30.789,115.97],[30.741,115.996],[30.05,115.996],[30.016,115.986],[29.995,115.955],[29.911,115.326],[29.881,115.278],[29.827,115.253],[28.557,115.25],[28.49,115.264],[28.456,115.306],[28.455,115.376],[29.571,120.648],[29.616,120.724],[29.67,120.747],[31.134,120.75],[31.223,120.724],[31.258,120.679],[32.384,115.376],[32.371,115.292],[32.335,115.26],[32.274,115.25],[31.009,115.25],[30.942,115.262],[30.889,115.326],[30.614,117.14],[30.404,118.589],[30.38,118.621],[30.356,118.589],[30.169,117.161],[30.185,117.133],[30.207,117.128],[30.576,117.128],[33.325,119.839],[33.416,120.032],[33.533,120.207],[33.676,120.365],[33.841,120.502],[34.023,120.614],[34.223,120.701],[34.441,120.763],[34.676,120.8],[34.929,120.813],[35.18,120.8],[35.414,120.763],[35.631,120.701],[35.83,120.614],[36.013,120.502],[36.179,120.365],[36.323,120.207],[36.44,120.032],[36.532,119.839],[36.598,119.628],[36.637,119.4],[36.649,119.098],[36.628,119.038],[36.581,118.999],[35.291,118.951],[35.225,118.963],[35.176,119.027],[35.171,119.3],[35.143,119.411],[35.057,119.513],[34.965,119.546],[34.861,119.539],[34.776,119.493],[34.715,119.411],[34.688,119.3],[34.686,116.735],[34.702,116.616],[34.752,116.527],[34.83,116.471],[34.929,116.452],[35.028,116.471],[35.106,116.527],[35.165,116.653],[35.176,116.981],[35.202,117.03],[35.255,117.054],[36.55,117.017],[36.607,116.993],[36.642,116.942],[36.644,116.696],[36.596,116.388],[36.5,116.107],[36.434,115.977],[36.357,115.855],[36.175,115.64],[35.954,115.464],[35.829,115.391],[35.556,115.278],[35.256,115.21],[34.929,115.187],[34.679,115.2],[34.445,115.238],[34.228,115.301],[34.028,115.39],[33.846,115.504],[33.68,115.643],[33.536,115.803],[33.418,115.981],[33.326,116.175],[33.261,116.387],[33.222,116.615],[33.209,116.861],[33.209,119.155],[33.222,119.4],[33.261,119.628],[41.113,119.554],[41.078,119.507],[41.021,119.486],[40.076,119.485],[40.04,119.473],[40.03,119.452],[40.029,115.368],[40.015,115.305],[39.974,115.264],[39.911,115.25],[38.669,115.25],[38.606,115.264],[38.565,115.305],[38.551,115.368],[38.55,119.452],[38.54,119.473],[38.504,119.485],[37.583,119.486],[37.505,119.528],[37.483,119.603],[37.483,120.632],[37.497,120.695],[37.538,120.736],[37.601,120.75],[41.052,120.742],[41.099,120.707],[41.12,120.65],[42.181,120.018],[42.299,120.197],[42.445,120.357],[42.612,120.496],[42.797,120.61],[43.0,120.699],[43.22,120.762],[43.458,120.8],[43.714,120.813],[43.969,120.8],[44.207,120.762],[44.428,120.699],[44.63,120.61],[44.815,120.496],[44.983,120.357],[45.128,120.197],[45.247,120.018],[45.339,119.823],[45.405,119.61],[45.445,119.379],[45.458,119.131],[45.458,116.869],[45.445,116.621],[45.405,116.39],[45.339,116.177],[45.247,115.982],[45.128,115.803],[44.983,115.643],[44.815,115.504],[44.63,115.39],[44.428,115.301],[44.207,115.238],[43.969,115.2],[43.714,115.187],[43.458,115.2],[43.22,115.238],[43.0,115.301],[42.797,115.39],[42.612,115.504],[42.445,115.643],[42.299,115.803],[42.181,115.982],[42.088,116.177],[42.022,116.39],[41.982,116.621],[41.969,116.869],[41.969,119.131],[41.982,119.379],[42.022,119.61],[42.088,119.823],[43.963,119.342],[43.932,119.42],[43.857,119.506],[43.791,119.537],[43.673,119.545],[43.57,119.506],[43.517,119.454],[43.478,119.383],[43.448,119.247],[43.448,116.753],[43.478,116.617],[43.517,116.546],[43.57,116.494],[43.673,116.455],[43.791,116.463],[43.885,116.518],[43.949,116.617],[43.979,116.753],[43.981,119.194],[47.888,117.359],[47.86,117.358],[47.846,117.316],[47.846,115.368],[47.825,115.293],[47.778,115.258],[47.729,115.25],[46.487,115.25],[46.412,115.272],[46.377,115.319],[46.369,115.368],[46.369,120.632],[46.383,120.695],[46.438,120.742],[48.255,120.75],[48.409,120.744],[48.7,120.694],[48.967,120.594],[49.209,120.447],[49.417,120.259],[49.589,120.033],[49.724,119.77],[49.815,119.48],[49.86,119.165],[49.849,118.72],[49.799,118.462],[49.663,118.114],[49.534,117.915],[49.375,117.744],[49.275,117.662],[49.259,117.62],[49.902,115.372],[49.902,115.315],[49.877,115.274],[49.795,115.25],[48.514,115.25],[48.432,115.276],[48.389,115.352],[47.909,117.324],[47.852,119.464],[47.848,118.52],[47.858,118.499],[47.894,118.487],[48.104,118.502],[48.24,118.577],[48.34,118.715],[48.386,118.907],[48.386,119.06],[48.362,119.197],[48.282,119.355],[48.158,119.453],[47.996,119.485],[47.879,119.484]],[[0,1,2,3,4,5,6,7,8,9,10,11,12,13,14,15,16,17,18,19,20,21,22,23,24,25,26,27,28,29,30,31,32,33,34,35,36,37],[38,39,40,41,42,43,44,45,46,47,48,49,50,51,52],[53,54,55,56,57,58,59,60,61,62,63,64,65,66,67,68,69,70,71,72,73,74,75,76,77,78,79,80,81,82,83,84,85,86,87,88,89,90,91,92],[93,94,95,96,97,98,99,100,101,102,103,104,105,106,107,108,109,110,111,112,113,114,115,116,117],[118,119,120,121,122,123,124,125],[126,127,128,129,130,131,132,133,134,135,136,137,138,139,140,141,142,143,144,145,146,147,148,149,150,151,152,153,154,155,156,157,158,159,160,161,162,163,164,165,166,167,168,169,170,171,172,173,174,175,176,177,178,179,180,181,182,183,184,185,186,187,188,189,190,191,192,193,194,195,196,197,198,199,200],[201,202,203,204,205,206,207,208,209,210,211,212,213,214,215,216,217,218,219,220,221,222,223,224,225,226,227],[228,229,230,231,232,233,234,235,236,237,238,239,240,241,242,243,244,245,246,247,248,249,250,251,252,253,254,255,256,257,258,259,260,261,262,263,264,265,266,267,268,269,270,271,272,273,274,275,276,277],[278,279,280,281,282,283,284,285,286,287,288,289,290,291,292,293,294,295,296],[297,298,299,300,301,302,303,304,305,306,307,308,309,310,311,312,313,314,315,316,317,318,319,320,321,322,323,324,325,326,327,328,329,330,331,332,333,334,335],[336,337,338,339,340,341,342,343,344,345,346,347,348,349]]],
   [[[22.935,120.447],[23.043,120.358],[23.233,120.151],[23.387,119.905],[23.501,119.628],[23.569,119.326],[23.586,119.165],[23.587,118.856],[23.554,118.588],[23.488,118.34],[23.328,118.01],[23.184,117.826],[23.001,117.662],[22.985,117.62],[23.629,115.366],[23.618,115.292],[23.554,115.253],[22.414,115.25],[22.414,120.697],[22.693,120.594],[20.15,115.264],[20.109,115.305],[20.095,115.368],[20.098,120.666],[20.138,120.728],[20.195,120.749],[21.214,120.75],[21.214,115.25],[20.213,115.25],[25.984,119.473],[25.972,119.438],[25.972,118.684],[25.984,118.648],[26.019,118.636],[26.815,118.636],[26.86,118.622],[26.901,118.581],[26.915,118.519],[26.915,117.489],[26.893,117.414],[26.815,117.372],[26.019,117.371],[25.984,117.36],[25.972,117.324],[25.977,116.536],[26.019,116.515],[27.52,116.515],[27.595,116.493],[27.63,116.446],[27.638,116.397],[27.638,115.368],[27.624,115.305],[27.569,115.258],[24.613,115.25],[24.55,115.264],[24.503,115.319],[24.495,120.632],[24.509,120.695],[24.55,120.736],[24.613,120.75],[27.52,120.75],[27.569,120.742],[27.616,120.707],[27.638,120.632],[27.638,119.603],[27.63,119.554],[27.595,119.507],[27.52,119.485],[26.019,119.485],[28.451,115.337],[29.571,120.648],[29.596,120.705],[29.641,120.739],[29.788,120.75],[29.788,115.25],[28.557,115.25],[28.49,115.264],[28.456,115.306],[31.258,120.679],[32.384,115.376],[32.371,115.292],[32.307,115.253],[30.988,115.252],[30.988,120.75],[31.169,120.747],[31.223,120.724],[33.325,119.839],[33.416,120.032],[33.533,120.207],[33.676,120.365],[33.841,120.502],[34.023,120.614],[34.223,120.701],[34.441,120.763],[34.676,120.8],[34.929,120.813],[35.18,120.8],[35.414,120.763],[35.631,120.701],[35.83,120.614],[36.013,120.502],[36.179,120.365],[36.323,120.207],[36.44,120.032],[36.532,119.839],[36.598,119.628],[36.637,119.4],[36.649,119.098],[36.628,119.038],[36.581,118.999],[35.291,118.951],[35.225,118.963],[35.176,119.027],[35.171,119.3],[35.143,119.411],[35.057,119.513],[34.965,119.546],[34.861,119.539],[34.776,119.493],[34.715,119.411],[34.688,119.3],[34.686,116.735],[34.702,116.616],[34.752,116.527],[34.83,116.471],[34.929,116.452],[35.028,116.471],[35.106,116.527],[35.165,116.653],[35.176,116.981],[35.202,117.03],[35.255,117.054],[36.55,117.017],[36.607,116.993],[36.642,116.942],[36.644,116.696],[36.596,116.388],[36.5,116.107],[36.434,115.977],[36.357,115.855],[36.175,115.64],[35.954,115.464],[35.829,115.391],[35.556,115.278],[35.256,115.21],[34.929,115.187],[34.679,115.2],[34.445,115.238],[34.228,115.301],[34.028,115.39],[33.846,115.504],[33.68,115.643],[33.536,115.803],[33.418,115.981],[33.326,116.175],[33.261,116.387],[33.222,116.615],[33.209,116.861],[33.209,119.155],[33.222,119.4],[33.261,119.628],[49.317,120.358],[49.507,120.151],[49.661,119.905],[49.775,119.628],[49.843,119.326],[49.86,119.165],[49.862,118.856],[49.828,118.588],[49.762,118.34],[49.602,118.01],[49.458,117.826],[49.275,117.662],[49.259,117.62],[49.902,115.372],[49.902,115.315],[49.877,115.274],[49.795,115.25],[48.689,115.25],[48.689,120.697],[48.967,120.594],[49.092,120.526],[41.107,119.54],[41.066,119.499],[41.021,119.486],[40.076,119.485],[40.04,119.473],[40.03,119.452],[40.029,115.368],[40.015,115.305],[39.974,115.264],[39.911,115.25],[38.669,115.25],[38.606,115.264],[38.565,115.305],[38.551,115.368],[38.55,119.452],[38.54,119.473],[38.504,119.485],[37.583,119.486],[37.505,119.528],[37.483,119.603],[37.483,120.632],[37.497,120.695],[37.538,120.736],[37.601,120.75],[41.052,120.742],[41.107,120.695],[41.121,120.632],[41.121,119.603],[42.445,120.357],[42.612,120.496],[42.797,120.61],[43.0,120.699],[43.114,120.732],[43.114,115.268],[43.0,115.301],[42.797,115.39],[42.612,115.504],[42.445,115.643],[42.299,115.803],[42.181,115.982],[42.088,116.177],[42.022,116.39],[41.982,116.621],[41.969,116.869],[41.969,119.131],[41.982,119.379],[42.022,119.61],[42.088,119.823],[42.181,120.018],[42.299,120.197],[46.412,115.272],[46.377,115.319],[46.369,115.368],[46.373,120.666],[46.412,120.728],[46.469,120.749],[47.489,120.75],[47.489,115.25],[46.487,115.25],[45.247,120.018],[45.339,119.823],[45.405,119.61],[45.445,119.379],[45.458,119.131],[45.458,116.869],[45.445,116.621],[45.405,116.39],[45.339,116.177],[45.247,115.982],[45.128,115.803],[44.983,115.643],[44.815,115.504],[44.63,115.39],[44.428,115.301],[44.314,115.268],[44.314,120.732],[44.428,120.699],[44.63,120.61],[44.815,120.496],[44.983,120.357],[45.128,120.197]],[[0,1,2,3,4,5,6,7,8,9,10,11,12,13,14,15,16,17,18,19],[20,21,22,23,24,25,26,27,28],[29,30,31,32,33,34,35,36,37,38,39,40,41,42,43,44,45,46,47,48,49,50,51,52,53,54,55,56,57,58,59,60,61,62,63,64,65,66,67,68],[69,70,71,72,73,74,75,76,77],[78,79,80,81,82,83,84,85],[86,87,88,89,90,91,92,93,94,95,96,97,98,99,100,101,102,103,104,105,106,107,108,109,110,111,112,113,114,115,116,117,118,119,120,121,122,123,124,125,126,127,128,129,130,131,132,133,134,135,136,137,138,139,140,141,142,143,144,145,146,147,148,149,150,151,152,153,154,155,156,157,158,159,160],[161,162,163,164,165,166,167,168,169,170,171,172,173,174,175,176,177,178,179,180,181],[182,183,184,185,186,187,188,189,190,191,192,193,194,195,196,197,198,199,200,201,202,203,204,205,206,207,208,209],[210,211,212,213,214,215,216,217,218,219,220,221,222,223,224,225,226,227,228,229,230,231],[232,233,234,235,236,237,238,239,240],[241,242,243,244,245,246,247,248,249,250,251,252,253,254,255,256,257,258,259,260,261,262]]]],
  ["LIFE_SUPPORT", 100, 118, 51.94, 12.6,
   [[[97.647,120.681],[97.694,120.736],[97.757,120.75],[99.016,120.749],[99.074,120.728],[99.108,120.681],[99.118,116.7],[99.144,116.589],[99.179,116.531],[99.252,116.472],[99.344,116.452],[99.435,116.472],[99.484,116.507],[99.538,116.589],[99.562,116.7],[99.572,120.681],[99.619,120.736],[99.682,120.75],[100.923,120.75],[100.986,120.736],[101.027,120.695],[101.041,120.632],[101.041,116.884],[101.018,116.562],[100.988,116.411],[100.894,116.128],[100.829,115.996],[100.668,115.759],[100.469,115.56],[100.232,115.399],[100.1,115.334],[99.817,115.24],[99.508,115.193],[99.177,115.193],[99.017,115.211],[98.719,115.281],[98.448,115.399],[98.211,115.56],[98.012,115.759],[97.851,115.996],[97.786,116.128],[97.692,116.411],[97.645,116.72],[97.639,116.884],[77.037,120.681],[77.085,120.736],[77.147,120.75],[78.389,120.75],[78.452,120.736],[78.493,120.695],[78.507,120.632],[78.508,116.548],[78.519,116.527],[78.554,116.515],[80.086,116.515],[80.161,116.493],[80.196,116.446],[80.204,116.397],[80.204,115.368],[80.19,115.305],[80.149,115.264],[80.086,115.25],[77.147,115.25],[77.085,115.264],[77.044,115.305],[77.03,115.368],[81.092,120.681],[81.126,120.728],[81.184,120.749],[82.443,120.75],[82.519,120.728],[82.558,120.666],[82.561,115.368],[82.539,115.293],[82.477,115.253],[81.184,115.251],[81.126,115.272],[81.087,115.334],[85.002,119.464],[84.997,118.684],[85.009,118.648],[85.044,118.636],[85.839,118.636],[85.885,118.622],[85.926,118.581],[85.94,118.519],[85.932,117.44],[85.897,117.393],[85.839,117.372],[85.044,117.371],[85.002,117.35],[84.997,115.368],[84.965,115.281],[84.879,115.25],[83.588,115.258],[83.534,115.305],[83.52,115.368],[83.52,120.632],[83.534,120.695],[83.575,120.736],[83.638,120.75],[86.545,120.75],[86.594,120.742],[86.641,120.707],[86.662,120.632],[86.662,119.603],[86.655,119.554],[86.62,119.507],[86.545,119.485],[85.044,119.485],[88.946,119.464],[88.941,118.684],[88.953,118.648],[88.988,118.636],[89.784,118.636],[89.862,118.594],[89.884,118.519],[89.884,117.489],[89.87,117.426],[89.829,117.385],[89.784,117.372],[88.988,117.371],[88.953,117.36],[88.941,117.324],[88.946,116.536],[88.988,116.515],[90.489,116.515],[90.564,116.493],[90.599,116.446],[90.607,116.397],[90.607,115.368],[90.593,115.305],[90.538,115.258],[87.582,115.25],[87.519,115.264],[87.472,115.319],[87.464,120.632],[87.478,120.695],[87.519,120.736],[87.582,120.75],[90.489,120.75],[90.538,120.742],[90.585,120.707],[90.607,120.632],[90.607,119.603],[90.599,119.554],[90.564,119.507],[90.489,119.485],[88.988,119.485],[93.443,116.957],[93.49,117.012],[93.553,117.026],[94.813,117.022],[94.854,117.004],[94.889,116.957],[94.912,116.621],[94.94,116.558],[95.005,116.487],[95.086,116.454],[95.203,116.47],[95.293,116.548],[95.33,116.635],[95.337,116.704],[95.323,116.792],[95.281,116.88],[95.211,116.967],[94.921,117.208],[94.326,117.642],[93.953,117.961],[93.726,118.238],[93.535,118.574],[93.451,118.827],[93.425,118.962],[93.404,119.249],[93.41,119.401],[93.427,119.546],[93.496,119.818],[93.549,119.946],[93.686,120.18],[93.864,120.381],[94.079,120.547],[94.201,120.616],[94.468,120.726],[94.76,120.791],[94.916,120.807],[95.242,120.807],[95.55,120.764],[95.831,120.676],[95.961,120.616],[96.196,120.468],[96.299,120.381],[96.477,120.18],[96.614,119.946],[96.666,119.818],[96.736,119.546],[96.753,119.401],[96.758,119.059],[96.728,118.99],[96.641,118.959],[95.374,118.966],[95.327,119.001],[95.309,119.042],[95.304,119.319],[95.277,119.419],[95.196,119.515],[95.11,119.546],[95.014,119.539],[94.937,119.493],[94.872,119.377],[94.858,119.257],[94.871,119.154],[94.913,119.053],[95.032,118.903],[95.263,118.703],[95.927,118.2],[96.244,117.937],[96.472,117.695],[96.645,117.422],[96.726,117.22],[96.774,116.996],[96.79,116.751],[96.777,116.52],[96.739,116.306],[96.674,116.108],[96.584,115.927],[96.468,115.761],[96.327,115.611],[96.164,115.482],[95.985,115.376],[95.791,115.293],[95.579,115.234],[95.352,115.199],[94.945,115.192],[94.638,115.234],[94.358,115.318],[94.229,115.376],[93.996,115.518],[93.801,115.692],[93.644,115.898],[93.528,116.132],[93.458,116.387],[93.435,116.664],[105.272,118.094],[105.127,117.857],[105.041,117.753],[104.845,117.575],[104.616,117.437],[104.491,117.385],[104.224,117.316],[103.933,117.293],[103.493,117.293],[103.451,117.272],[103.445,115.368],[103.438,115.319],[103.403,115.272],[103.328,115.25],[102.086,115.25],[102.037,115.258],[101.99,115.293],[101.968,115.368],[101.968,120.632],[101.976,120.681],[102.011,120.728],[102.086,120.75],[104.008,120.744],[104.299,120.694],[104.435,120.65],[104.566,120.594],[104.808,120.447],[105.016,120.258],[105.188,120.03],[105.323,119.765],[105.414,119.471],[105.459,119.152],[105.465,118.982],[105.443,118.66],[105.379,118.364],[103.914,119.298],[103.844,119.39],[103.707,119.47],[103.493,119.485],[103.451,119.464],[103.445,118.479],[103.466,118.437],[103.653,118.436],[103.757,118.465],[103.844,118.522],[103.914,118.609],[103.961,118.724],[103.988,118.951],[103.961,119.18],[109.601,118.094],[109.456,117.857],[109.371,117.753],[109.174,117.575],[108.945,117.437],[108.821,117.385],[108.553,117.316],[108.262,117.293],[107.822,117.293],[107.78,117.272],[107.775,115.368],[107.767,115.319],[107.732,115.272],[107.657,115.25],[106.415,115.25],[106.366,115.258],[106.319,115.293],[106.297,115.368],[106.297,120.632],[106.305,120.681],[106.34,120.728],[106.415,120.75],[108.337,120.744],[108.628,120.694],[108.765,120.65],[108.895,120.594],[109.137,120.447],[109.345,120.258],[109.517,120.03],[109.652,119.765],[109.743,119.471],[109.788,119.152],[109.794,118.982],[109.773,118.66],[109.708,118.364],[108.243,119.298],[108.173,119.39],[108.036,119.47],[107.822,119.485],[107.78,119.464],[107.775,118.479],[107.796,118.437],[107.982,118.436],[108.086,118.465],[108.173,118.522],[108.243,118.609],[108.305,118.792],[108.317,118.951],[108.29,119.18],[110.807,120.018],[110.925,120.197],[111.071,120.357],[111.238,120.496],[111.423,120.61],[111.626,120.699],[111.846,120.762],[112.084,120.8],[112.34,120.813],[112.595,120.8],[112.833,120.762],[113.054,120.699],[113.256,120.61],[113.441,120.496],[113.609,120.357],[113.754,120.197],[113.873,120.018],[113.965,119.823],[114.031,119.61],[114.071,119.379],[114.084,119.131],[114.084,116.869],[114.071,116.621],[114.031,116.39],[113.965,116.177],[113.873,115.982],[113.754,115.803],[113.609,115.643],[113.441,115.504],[113.256,115.39],[113.054,115.301],[112.833,115.238],[112.595,115.2],[112.34,115.187],[112.084,115.2],[111.846,115.238],[111.626,115.301],[111.423,115.39],[111.238,115.504],[111.071,115.643],[110.925,115.803],[110.807,115.982],[110.714,116.177],[110.648,116.39],[110.609,116.621],[110.595,116.869],[110.595,119.131],[110.609,119.379],[110.648,119.61],[110.714,119.823],[112.589,119.342],[112.558,119.42],[112.483,119.506],[112.417,119.537],[112.299,119.545],[112.196,119.506],[112.143,119.454],[112.09,119.342],[112.074,119.247],[112.074,116.753],[112.09,116.658],[112.143,116.546],[112.196,116.494],[112.299,116.455],[112.417,116.463],[112.511,116.518],[112.575,116.617],[112.605,116.753],[112.607,119.194],[116.509,117.362],[116.48,117.352],[116.472,117.316],[116.472,115.368],[116.451,115.293],[116.404,115.258],[116.355,115.25],[115.113,115.25],[115.038,115.272],[115.003,115.319],[114.995,115.368],[114.995,120.632],[115.009,120.695],[115.064,120.742],[116.881,120.75],[117.184,120.725],[117.326,120.694],[117.593,120.594],[117.835,120.447],[118.043,120.259],[118.215,120.033],[118.35,119.77],[118.441,119.48],[118.486,119.165],[118.475,118.72],[118.425,118.462],[118.289,118.114],[118.16,117.915],[118.001,117.744],[117.901,117.662],[117.885,117.62],[118.528,115.372],[118.528,115.315],[118.504,115.274],[118.421,115.25],[117.14,115.25],[117.058,115.276],[117.015,115.352],[116.535,117.324],[116.474,119.452],[116.474,118.52],[116.484,118.499],[116.52,118.487],[116.73,118.502],[116.866,118.577],[116.966,118.715],[117.012,118.907],[117.012,119.06],[116.988,119.197],[116.909,119.355],[116.784,119.453],[116.68,119.481],[116.52,119.485],[116.484,119.473],[122.956,119.54],[122.915,119.499],[122.87,119.486],[121.925,119.485],[121.89,119.473],[121.88,119.452],[121.878,115.368],[121.864,115.305],[121.823,115.264],[121.76,115.25],[120.519,115.25],[120.456,115.264],[120.415,115.305],[120.401,115.368],[120.4,119.452],[120.389,119.473],[120.354,119.485],[119.433,119.486],[119.354,119.528],[119.332,119.603],[119.332,120.632],[119.346,120.695],[119.387,120.736],[119.45,120.75],[122.902,120.742],[122.956,120.695],[122.97,120.632],[122.97,119.603]],[[0,1,2,3,4,5,6,7,8,9,10,11,12,13,14,15,16,17,18,19,20,21,22,23,24,25,26,27,28,29,30,31,32,33,34,35,36,37,38,39,40,41,42,43],[44,45,46,47,48,49,50,51,52,53,54,55,56,57,58,59,60,61,62,63,64,65],[66,67,68,69,70,71,72,73,74,75,76,77],[78,79,80,81,82,83,84,85,86,87,88,89,90,91,92,93,94,95,96,97,98,99,100,101,102,103,104,105,106,107,108,109],[110,111,112,113,114,115,116,117,118,119,120,121,122,123,124,125,126,127,128,129,130,131,132,133,134,135,136,137,138,139,140,141,142,143,144,145,146,147,148],[149,150,151,152,153,154,155,156,157,158,159,160,161,162,163,164,165,166,167,168,169,170,171,172,173,174,175,176,177,178,179,180,181,182,183,184,185,186,187,188,189,190,191,192,193,194,195,196,197,198,199,200,201,202,203,204,205,206,207,208,209,210,211,212,213,214,215,216,217,218,219,220,221,222,223,224,225,226,227,228,229,230,231,232,233,234,235,236,237,238,239,240,241],[242,243,244,245,246,247,248,249,250,251,252,253,254,255,256,257,258,259,260,261,262,263,264,265,266,267,268,269,270,271,272,273,274,275,276],[277,278,279,280,281,282,283,284,285,286,287,288,289,290],[291,292,293,294,295,296,297,298,299,300,301,302,303,304,305,306,307,308,309,310,311,312,313,314,315,316,317,318,319,320,321,322,323,324,325],[326,327,328,329,330,331,332,333,334,335,336,337,338,339],[340,341,342,343,344,345,346,347,348,349,350,351,352,353,354,355,356,357,358,359,360,361,362,363,364,365,366,367,368,369,370,371,372,373,374,375,376,377,378,379,380,381,382,383,384,385,386,387,388,389],[390,391,392,393,394,395,396,397,398,399,400,401,402,403,404,405,406,407,408],[409,410,411,412,413,414,415,416,417,418,419,420,421,422,423,424,425,426,427,428,429,430,431,432,433,434,435,436,437,438,439,440,441,442,443,444,445,446,447],[448,449,450,451,452,453,454,455,456,457,458,459,460,461,462],[463,464,465,466,467,468,469,470,471,472,473,474,475,476,477,478,479,480,481,482,483,484,485,486,487,488,489,490]]],
   [[[97.647,120.681],[97.694,120.736],[97.757,120.75],[99.016,120.749],[99.074,120.728],[99.108,120.681],[99.118,116.7],[99.144,116.589],[99.179,116.531],[99.252,116.472],[99.344,116.452],[99.435,116.472],[99.484,116.507],[99.538,116.589],[99.562,116.7],[99.572,120.681],[99.619,120.736],[99.682,120.75],[100.923,120.75],[100.986,120.736],[101.027,120.695],[101.041,120.632],[101.041,116.884],[101.018,116.562],[100.988,116.411],[100.894,116.128],[100.829,115.996],[100.668,115.759],[100.469,115.56],[100.232,115.399],[100.1,115.334],[99.817,115.24],[99.508,115.193],[99.177,115.193],[99.017,115.211],[98.719,115.281],[98.448,115.399],[98.211,115.56],[98.012,115.759],[97.851,115.996],[97.786,116.128],[97.692,116.411],[97.645,116.72],[97.639,116.884],[77.044,120.695],[77.085,120.736],[77.147,120.75],[78.389,120.75],[78.452,120.736],[78.493,120.695],[78.507,120.632],[78.508,116.548],[78.519,116.527],[78.554,116.515],[80.086,116.515],[80.161,116.493],[80.196,116.446],[80.204,116.397],[80.204,115.368],[80.19,115.305],[80.149,115.264],[80.086,115.25],[77.147,115.25],[77.085,115.264],[77.044,115.305],[77.03,115.368],[77.03,120.632],[81.098,120.695],[81.139,120.736],[81.202,120.75],[82.443,120.75],[82.519,120.728],[82.558,120.666],[82.561,115.368],[82.539,115.293],[82.477,115.253],[81.184,115.251],[81.126,115.272],[81.087,115.334],[81.084,120.632],[85.002,119.464],[84.997,118.684],[85.009,118.648],[85.044,118.636],[85.839,118.636],[85.885,118.622],[85.926,118.581],[85.94,118.519],[85.932,117.44],[85.897,117.393],[85.839,117.372],[85.044,117.371],[85.002,117.35],[84.997,115.368],[84.965,115.281],[84.879,115.25],[83.588,115.258],[83.534,115.305],[83.52,115.368],[83.52,120.632],[83.534,120.695],[83.575,120.736],[83.638,120.75],[86.545,120.75],[86.594,120.742],[86.641,120.707],[86.662,120.632],[86.662,119.603],[86.655,119.554],[86.62,119.507],[86.545,119.485],[85.044,119.485],[88.946,119.464],[88.941,118.684],[88.953,118.648],[88.988,118.636],[89.784,118.636],[89.862,118.594],[89.884,118.519],[89.884,117.489],[89.87,117.426],[89.829,117.385],[89.784,117.372],[88.988,117.371],[88.953,117.36],[88.941,117.324],[88.946,116.536],[88.988,116.515],[90.489,116.515],[90.564,116.493],[90.599,116.446],[90.607,116.397],[90.607,115.368],[90.593,115.305],[90.538,115.258],[87.582,115.25],[87.519,115.264],[87.472,115.319],[87.464,120.632],[87.478,120.695],[87.519,120.736],[87.582,120.75],[90.489,120.75],[90.538,120.742],[90.585,120.707],[90.607,120.632],[90.607,119.603],[90.599,119.554],[90.564,119.507],[90.489,119.485],[88.988,119.485],[93.449,116.971],[93.49,117.012],[93.553,117.026],[94.813,117.022],[94.854,117.004],[94.889,116.957],[94.912,116.621],[94.94,116.558],[95.005,116.487],[95.086,116.454],[95.203,116.47],[95.293,116.548],[95.33,116.635],[95.337,116.704],[95.323,116.792],[95.281,116.88],[95.211,116.967],[94.921,117.208],[94.326,117.642],[93.953,117.961],[93.726,118.238],[93.535,118.574],[93.451,118.827],[93.425,118.962],[93.404,119.249],[93.41,119.401],[93.427,119.546],[93.496,119.818],[93.549,119.946],[93.686,120.18],[93.864,120.381],[94.079,120.547],[94.201,120.616],[94.468,120.726],[94.76,120.791],[94.916,120.807],[95.242,120.807],[95.55,120.764],[95.831,120.676],[95.961,120.616],[96.196,120.468],[96.299,120.381],[96.477,120.18],[96.614,119.946],[96.666,119.818],[96.736,119.546],[96.753,119.401],[96.758,119.059],[96.728,118.99],[96.641,118.959],[95.374,118.966],[95.327,119.001],[95.309,119.042],[95.304,119.319],[95.277,119.419],[95.196,119.515],[95.11,119.546],[95.014,119.539],[94.937,119.493],[94.872,119.377],[94.858,119.257],[94.871,119.154],[94.913,119.053],[95.032,118.903],[95.263,118.703],[95.927,118.2],[96.244,117.937],[96.472,117.695],[96.645,117.422],[96.726,117.22],[96.774,116.996],[96.79,116.751],[96.777,116.52],[96.739,116.306],[96.674,116.108],[96.584,115.927],[96.468,115.761],[96.327,115.611],[96.164,115.482],[95.985,115.376],[95.791,115.293],[95.579,115.234],[95.352,115.199],[94.945,115.192],[94.638,115.234],[94.358,115.318],[94.108,115.443],[93.894,115.601],[93.718,115.791],[93.58,116.012],[93.528,116.132],[93.458,116.387],[93.435,116.664],[93.435,116.908],[102.011,115.272],[101.976,115.319],[101.968,115.368],[101.972,120.666],[102.011,120.728],[102.068,120.749],[103.088,120.75],[103.088,115.25],[102.086,115.25],[105.127,117.857],[104.947,117.66],[104.734,117.501],[104.491,117.385],[104.288,117.33],[104.288,120.696],[104.566,120.594],[104.691,120.526],[104.916,120.357],[105.016,120.258],[105.188,120.03],[105.323,119.765],[105.374,119.621],[105.414,119.471],[105.459,119.152],[105.465,118.982],[105.443,118.66],[105.417,118.509],[105.331,118.226],[105.272,118.094],[117.944,120.358],[118.133,120.151],[118.287,119.905],[118.401,119.628],[118.469,119.326],[118.486,119.165],[118.488,118.856],[118.454,118.588],[118.388,118.34],[118.228,118.01],[118.084,117.826],[117.901,117.662],[117.885,117.62],[118.528,115.372],[118.528,115.315],[118.504,115.274],[118.421,115.25],[117.315,115.25],[117.315,120.697],[117.593,120.594],[117.718,120.526],[106.34,115.272],[106.305,115.319],[106.297,115.368],[106.301,120.666],[106.34,120.728],[106.398,120.749],[107.418,120.75],[107.418,115.25],[106.415,115.25],[111.238,120.496],[111.423,120.61],[111.626,120.699],[111.74,120.732],[111.74,115.268],[111.626,115.301],[111.423,115.39],[111.238,115.504],[111.071,115.643],[110.925,115.803],[110.807,115.982],[110.714,116.177],[110.648,116.39],[110.609,116.621],[110.595,116.869],[110.595,119.131],[110.609,119.379],[110.648,119.61],[110.714,119.823],[110.807,120.018],[110.925,120.197],[111.071,120.357],[115.038,115.272],[115.003,115.319],[114.995,115.368],[114.999,120.666],[115.038,120.728],[115.096,120.749],[116.115,120.75],[116.115,115.25],[115.113,115.25],[122.956,119.54],[122.915,119.499],[122.87,119.486],[121.925,119.485],[121.89,119.473],[121.88,119.452],[121.878,115.368],[121.864,115.305],[121.823,115.264],[121.76,115.25],[120.519,115.25],[120.456,115.264],[120.415,115.305],[120.401,115.368],[120.4,119.452],[120.389,119.473],[120.354,119.485],[119.433,119.486],[119.354,119.528],[119.332,119.603],[119.332,120.632],[119.346,120.695],[119.387,120.736],[119.45,120.75],[122.902,120.742],[122.956,120.695],[122.97,120.632],[122.97,119.603],[113.873,120.018],[113.965,119.823],[114.031,119.61],[114.071,119.379],[114.084,119.131],[114.084,116.869],[114.071,116.621],[114.031,116.39],[113.965,116.177],[113.873,115.982],[113.754,115.803],[113.609,115.643],[113.441,115.504],[113.256,115.39],[113.054,115.301],[112.94,115.268],[112.94,120.732],[113.054,120.699],[113.256,120.61],[113.441,120.496],[113.609,120.357],[113.754,120.197],[109.456,117.857],[109.277,117.66],[109.063,117.501],[108.821,117.385],[108.618,117.33],[108.618,120.696],[108.895,120.594],[109.02,120.526],[109.246,120.357],[109.436,120.149],[109.517,120.03],[109.652,119.765],[109.703,119.621],[109.771,119.315],[109.788,119.152],[109.794,118.982],[109.773,118.66],[109.746,118.509],[109.66,118.226],[109.601,118.094]],[[0,1,2,3,4,5,6,7,8,9,10,11,12,13,14,15,16,17,18,19,20,21,22,23,24,25,26,27,28,29,30,31,32,33,34,35,36,37,38,39,40,41,42,43],[44,45,46,47,48,49,50,51,52,53,54,55,56,57,58,59,60,61,62,63,64,65,66],[67,68,69,70,71,72,73,74,75,76,77,78,79],[80,81,82,83,84,85,86,87,88,89,90,91,92,93,94,95,96,97,98,99,100,101,102,103,104,105,106,107,108,109,110,111],[112,113,114,115,116,117,118,119,120,121,122,123,124,125,126,127,128,129,130,131,132,133,134,135,136,137,138,139,140,141,142,143,144,145,146,147,148,149,150],[151,152,153,154,155,156,157,158,159,160,161,162,163,164,165,166,167,168,169,170,171,172,173,174,175,176,177,178,179,180,181,182,183,184,185,186,187,188,189,190,191,192,193,194,195,196,197,198,199,200,201,202,203,204,205,206,207,208,209,210,211,212,213,214,215,216,217,218,219,220,221,222,223,224,225,226,227,228,229,230,231,232,233,234,235,236,237,238,239,240,241,242,243,244],[245,246,247,248,249,250,251,252,253],[254,255,256,257,258,259,260,261,262,263,264,265,266,267,268,269,270,271,272,273],[274,275,276,277,278,279,280,281,282,283,284,285,286,287,288,289,290,291,292,293,294],[295,296,297,298,299,300,301,302,303],[304,305,306,307,308,309,310,311,312,313,314,315,316,317,318,319,320,321,322,323,324,325],[326,327,328,329,330,331,332,333,334],[335,336,337,338,339,340,341,342,343,344,345,346,347,348,349,350,351,352,353,354,355,356,357,358,359,360,361,362],[363,364,365,366,367,368,369,370,371,372,373,374,375,376,377,378,379,380,381,382,383,384],[385,386,387,388,389,390,391,392,393,394,395,396,397,398,399,400,401,402,403,404]]]],
  ["SHIELDS", 165, 118, 32.82, 12.6,
   [[[151.627,116.942],[151.666,117.004],[151.723,117.025],[152.984,117.025],[153.042,117.004],[153.077,116.957],[153.1,116.621],[153.128,116.558],[153.193,116.487],[153.305,116.452],[153.416,116.484],[153.497,116.574],[153.523,116.668],[153.521,116.748],[153.493,116.836],[153.437,116.923],[153.349,117.014],[153.109,117.208],[152.514,117.642],[152.141,117.961],[151.913,118.238],[151.723,118.574],[151.676,118.698],[151.613,118.962],[151.592,119.249],[151.598,119.401],[151.615,119.546],[151.684,119.818],[151.736,119.946],[151.874,120.18],[152.051,120.381],[152.154,120.468],[152.389,120.616],[152.656,120.726],[152.948,120.791],[153.104,120.807],[153.43,120.807],[153.738,120.764],[154.019,120.676],[154.149,120.616],[154.384,120.468],[154.487,120.381],[154.664,120.18],[154.802,119.946],[154.854,119.818],[154.924,119.546],[154.941,119.401],[154.946,119.059],[154.915,118.99],[154.829,118.959],[153.562,118.966],[153.515,119.001],[153.497,119.042],[153.491,119.319],[153.465,119.419],[153.384,119.515],[153.298,119.546],[153.202,119.539],[153.125,119.493],[153.06,119.377],[153.045,119.257],[153.059,119.154],[153.101,119.053],[153.22,118.903],[153.45,118.703],[154.115,118.2],[154.432,117.937],[154.66,117.695],[154.833,117.422],[154.914,117.22],[154.962,116.996],[154.978,116.751],[154.965,116.52],[154.927,116.306],[154.862,116.108],[154.772,115.927],[154.656,115.761],[154.515,115.611],[154.352,115.482],[154.173,115.376],[153.978,115.293],[153.767,115.234],[153.54,115.199],[153.133,115.192],[152.825,115.234],[152.546,115.318],[152.417,115.376],[152.184,115.518],[151.989,115.692],[151.831,115.898],[151.716,116.132],[151.646,116.387],[151.623,116.664],[159.184,120.742],[159.239,120.695],[159.252,120.632],[159.252,115.368],[159.239,115.305],[159.197,115.264],[159.135,115.25],[157.893,115.25],[157.807,115.281],[157.775,115.368],[157.774,117.339],[157.754,117.366],[157.728,117.371],[157.367,117.371],[157.331,117.36],[157.32,117.324],[157.32,115.368],[157.298,115.293],[157.251,115.258],[157.202,115.25],[155.96,115.25],[155.898,115.264],[155.856,115.305],[155.843,115.368],[155.843,120.632],[155.856,120.695],[155.898,120.736],[155.96,120.75],[157.202,120.75],[157.288,120.719],[157.32,120.632],[157.321,118.669],[157.341,118.642],[157.367,118.636],[157.728,118.636],[157.764,118.648],[157.775,118.684],[157.775,120.632],[157.797,120.707],[157.844,120.742],[157.893,120.75],[160.219,120.681],[160.254,120.728],[160.311,120.749],[161.57,120.75],[161.646,120.728],[161.685,120.666],[161.688,115.368],[161.666,115.293],[161.604,115.253],[160.311,115.251],[160.254,115.272],[160.215,115.334],[164.136,119.473],[164.124,119.438],[164.124,118.684],[164.136,118.648],[164.171,118.636],[164.967,118.636],[165.012,118.622],[165.053,118.581],[165.067,118.519],[165.067,117.489],[165.045,117.414],[164.967,117.372],[164.171,117.371],[164.136,117.36],[164.124,117.324],[164.129,116.536],[164.171,116.515],[165.672,116.515],[165.747,116.493],[165.782,116.446],[165.79,116.397],[165.79,115.368],[165.776,115.305],[165.721,115.258],[162.765,115.25],[162.702,115.264],[162.655,115.319],[162.647,120.632],[162.661,120.695],[162.702,120.736],[162.765,120.75],[165.672,120.75],[165.721,120.742],[165.768,120.707],[165.79,120.632],[165.79,119.603],[165.782,119.554],[165.747,119.507],[165.672,119.485],[164.171,119.485],[166.693,120.681],[166.74,120.736],[166.803,120.75],[168.045,120.75],[168.108,120.736],[168.149,120.695],[168.162,120.632],[168.164,116.548],[168.174,116.527],[168.21,116.515],[169.742,116.515],[169.817,116.493],[169.852,116.446],[169.86,116.397],[169.86,115.368],[169.846,115.305],[169.805,115.264],[169.742,115.25],[166.803,115.25],[166.74,115.264],[166.699,115.305],[166.685,115.368],[170.754,120.695],[170.795,120.736],[170.858,120.75],[172.405,120.75],[172.738,120.728],[172.893,120.701],[173.185,120.614],[173.321,120.554],[173.566,120.405],[173.771,120.22],[173.938,120.0],[174.005,119.878],[174.103,119.616],[174.151,119.33],[174.157,119.179],[174.157,116.821],[174.133,116.524],[174.06,116.25],[174.005,116.122],[173.859,115.886],[173.673,115.683],[173.448,115.516],[173.321,115.446],[173.043,115.337],[172.893,115.299],[172.575,115.255],[170.858,115.25],[170.795,115.264],[170.754,115.305],[170.74,115.368],[170.74,120.632],[172.49,116.556],[172.586,116.641],[172.635,116.721],[172.666,116.815],[172.68,116.924],[172.678,119.143],[172.642,119.294],[172.564,119.409],[172.454,119.473],[172.264,119.485],[172.229,119.473],[172.217,119.438],[172.217,116.562],[172.229,116.527],[172.264,116.515],[172.415,116.528],[175.061,116.957],[175.108,117.012],[175.171,117.026],[176.431,117.022],[176.472,117.004],[176.507,116.957],[176.53,116.621],[176.558,116.558],[176.623,116.487],[176.704,116.454],[176.821,116.47],[176.911,116.548],[176.948,116.635],[176.955,116.704],[176.941,116.792],[176.899,116.88],[176.829,116.967],[176.539,117.208],[175.944,117.642],[175.571,117.961],[175.343,118.238],[175.153,118.574],[175.106,118.698],[175.043,118.962],[175.022,119.249],[175.028,119.401],[175.045,119.546],[175.114,119.818],[175.166,119.946],[175.304,120.18],[175.481,120.381],[175.584,120.468],[175.819,120.616],[176.086,120.726],[176.378,120.791],[176.534,120.807],[176.86,120.807],[177.168,120.764],[177.449,120.676],[177.579,120.616],[177.814,120.468],[177.917,120.381],[178.094,120.18],[178.232,119.946],[178.284,119.818],[178.325,119.685],[178.371,119.401],[178.376,119.059],[178.345,118.99],[178.259,118.959],[176.992,118.966],[176.945,119.001],[176.927,119.042],[176.921,119.319],[176.895,119.419],[176.814,119.515],[176.728,119.546],[176.632,119.539],[176.555,119.493],[176.49,119.377],[176.475,119.257],[176.489,119.154],[176.531,119.053],[176.65,118.903],[176.88,118.703],[177.545,118.2],[177.862,117.937],[178.09,117.695],[178.263,117.422],[178.344,117.22],[178.392,116.996],[178.408,116.751],[178.395,116.52],[178.357,116.306],[178.292,116.108],[178.202,115.927],[178.086,115.761],[177.945,115.611],[177.782,115.482],[177.603,115.376],[177.408,115.293],[177.197,115.234],[176.97,115.199],[176.563,115.192],[176.255,115.234],[175.976,115.318],[175.847,115.376],[175.614,115.518],[175.419,115.692],[175.261,115.898],[175.146,116.132],[175.076,116.387],[175.053,116.664]],[[0,1,2,3,4,5,6,7,8,9,10,11,12,13,14,15,16,17,18,19,20,21,22,23,24,25,26,27,28,29,30,31,32,33,34,35,36,37,38,39,40,41,42,43,44,45,46,47,48,49,50,51,52,53,54,55,56,57,58,59,60,61,62,63,64,65,66,67,68,69,70,71,72,73,74,75,76,77,78,79,80,81,82,83,84,85,86,87,88,89,90,91,92],[93,94,95,96,97,98,99,100,101,102,103,104,105,106,107,108,109,110,111,112,113,114,115,116,117,118,119,120,121,122,123,124,125,126,127,128,129,130,131,132,133],[134,135,136,137,138,139,140,141,142,143,144,145],[146,147,148,149,150,151,152,153,154,155,156,157,158,159,160,161,162,163,164,165,166,167,168,169,170,171,172,173,174,175,176,177,178,179,180,181,182,183,184,185],[186,187,188,189,190,191,192,193,194,195,196,197,198,199,200,201,202,203,204,205,206,207],[208,209,210,211,212,213,214,215,216,217,218,219,220,221,222,223,224,225,226,227,228,229,230,231,232,233,234,235,236,237,238],[239,240,241,242,243,244,245,246,247,248,249,250,251,252,253,254],[255,256,257,258,259,260,261,262,263,264,265,266,267,268,269,270,271,272,273,274,275,276,277,278,279,280,281,282,283,284,285,286,287,288,289,290,291,292,293,294,295,296,297,298,299,300,301,302,303,304,305,306,307,308,309,310,311,312,313,314,315,316,317,318,319,320,321,322,323,324,325,326,327,328,329,330,331,332,333,334,335,336,337,338,339,340,341,342,343,344,345,346,347]]],
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
