whyvas/filament-falcon/cad/panels/OPS_DASH_B.scad

// GENERATED by cad/tools/gen_panels.py from cad/tools/layouts.py - edit the layout there.
// Ops dash, right piece (mode + payload): pod lower band in front of the RIGHT seat, outboard half
// Nominal 200 x 160 mm (printed 199.5 x 159.5).
PART = "preview";
PANEL_ID = "OPS_DASH_B";
W = 200;
H = 160;
SEAM_L = true;
SEAM_R = false;
CUTS = [["ec11", 42, 92], ["btn16", 165, 100], ["tog6", 40, 44], ["led5", 40, 28], ["tog6", 105, 44], ["led5", 105, 28], ["btn16", 168, 44]];
SLOTS = [];
GROOVES = [];
LABELS = [
  ["MODE", 42, 118, 22.88, 12.6,
   [[[37.595,120.747],[37.657,120.707],[37.679,120.632],[37.679,115.368],[37.657,115.293],[37.61,115.258],[37.561,115.25],[36.319,115.25],[36.27,115.258],[36.223,115.293],[36.201,115.368],[36.199,118.584],[36.175,118.607],[36.152,118.591],[35.612,117.686],[35.088,118.591],[35.065,118.609],[35.043,118.596],[35.039,118.566],[35.031,115.319],[34.984,115.264],[34.921,115.25],[33.679,115.25],[33.604,115.272],[33.569,115.319],[33.561,115.368],[33.561,120.632],[33.583,120.707],[33.63,120.742],[33.679,120.75],[34.905,120.75],[34.991,120.728],[35.032,120.69],[35.596,119.658],[35.638,119.63],[36.194,120.664],[36.252,120.728],[36.335,120.75],[38.67,119.823],[38.762,120.018],[38.881,120.197],[39.026,120.357],[39.193,120.496],[39.378,120.61],[39.581,120.699],[39.801,120.762],[40.039,120.8],[40.295,120.813],[40.551,120.8],[40.789,120.762],[41.009,120.699],[41.212,120.61],[41.397,120.496],[41.564,120.357],[41.709,120.197],[41.828,120.018],[41.92,119.823],[41.986,119.61],[42.026,119.379],[42.039,119.131],[42.039,116.869],[42.026,116.621],[41.986,116.39],[41.92,116.177],[41.828,115.982],[41.709,115.803],[41.564,115.643],[41.397,115.504],[41.212,115.39],[41.009,115.301],[40.789,115.238],[40.551,115.2],[40.295,115.187],[40.039,115.2],[39.801,115.238],[39.581,115.301],[39.378,115.39],[39.193,115.504],[39.026,115.643],[38.881,115.803],[38.762,115.982],[38.67,116.177],[38.604,116.39],[38.564,116.621],[38.551,116.869],[38.551,119.131],[38.564,119.379],[38.604,119.61],[40.554,119.296],[40.513,119.42],[40.438,119.506],[40.373,119.537],[40.255,119.545],[40.152,119.506],[40.099,119.454],[40.059,119.383],[40.03,119.247],[40.03,116.753],[40.059,116.617],[40.099,116.546],[40.152,116.494],[40.255,116.455],[40.373,116.463],[40.466,116.518],[40.531,116.617],[40.56,116.753],[42.959,120.681],[43.006,120.736],[43.069,120.75],[44.616,120.75],[44.949,120.728],[45.105,120.701],[45.396,120.614],[45.532,120.554],[45.777,120.405],[45.982,120.22],[46.149,120.0],[46.216,119.878],[46.271,119.75],[46.344,119.476],[46.369,119.179],[46.369,116.821],[46.344,116.524],[46.271,116.25],[46.216,116.122],[46.07,115.886],[45.982,115.78],[45.777,115.595],[45.532,115.446],[45.254,115.337],[44.949,115.272],[44.786,115.255],[43.069,115.25],[43.006,115.264],[42.965,115.305],[42.951,115.368],[44.664,116.539],[44.735,116.579],[44.824,1
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
