whyvas/filament-falcon/docs/game/screenshots/27_commander_setup.jpg

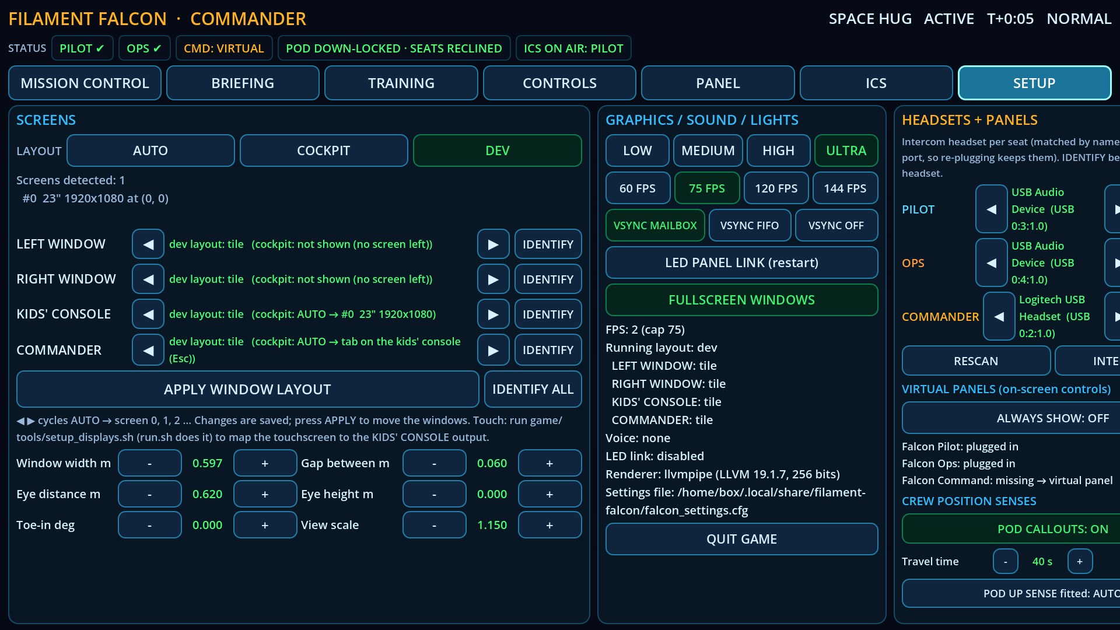
docs/game/screenshots/27_commander_setup.jpg
