whyvas/filament-falcon/docs/game/screenshots/33_commander_setup.jpg

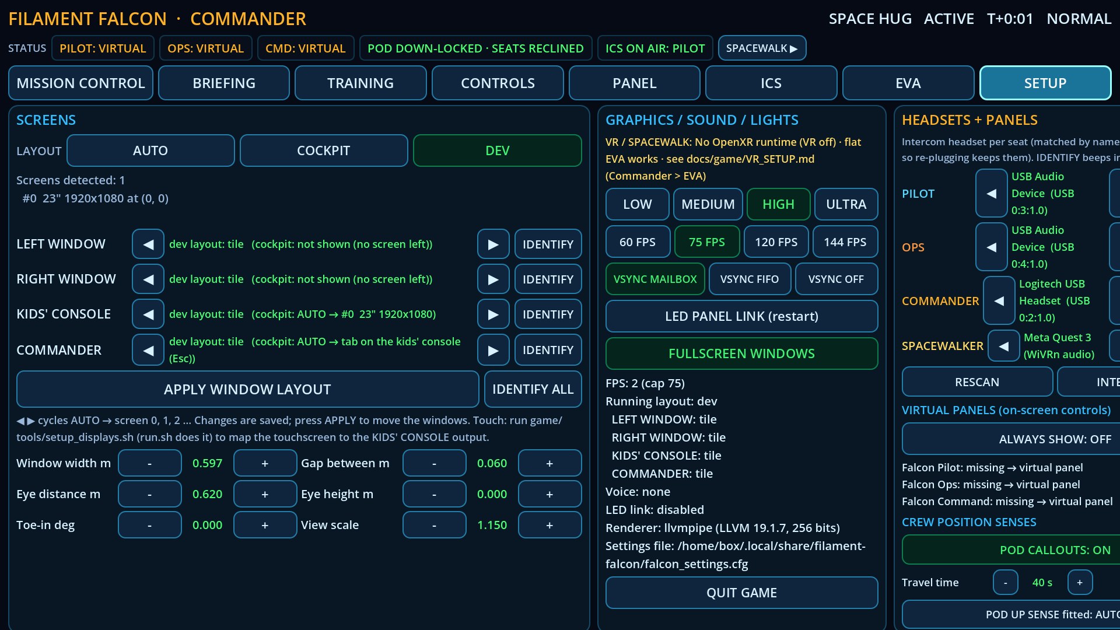
docs/game/screenshots/33_commander_setup.jpg
