whyvas/filament-falcon/game/tools/x11_no_input_hint.py

#!/usr/bin/env python3
"""Tell the window manager never to give a window keyboard focus (ICCCM WM_HINTS input=False).

    x11_no_input_hint.py WINDOW_ID [--restore]

The game runs this on the KIDS' CONSOLE window when the Commander has its own screen, so a tap on
the touchscreen can't make Cinnamon move keyboard focus off the Commander window. The window still
gets touches and clicks. --restore sets input=True again. Uses libX11 through ctypes (no extra
packages); exits 0 quietly when there is no X display or libX11.
"""
import ctypes
import ctypes.util
import sys

INPUT_HINT = 1


class XWMHints(ctypes.Structure):
    _fields_ = [
        ("flags", ctypes.c_long), ("input", ctypes.c_int), ("initial_state", ctypes.c_int),
        ("icon_pixmap", ctypes.c_ulong), ("icon_window", ctypes.c_ulong),
        ("icon_x", ctypes.c_int), ("icon_y", ctypes.c_int),
        ("icon_mask", ctypes.c_ulong), ("window_group", ctypes.c_ulong),
    ]
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
