whyvas/filament-falcon/(commit log)

2026-10-08 Firmware: ESP32-S3 HID joystick firmware for Falcon Pilot/Ops/Command, LED map + input map
2026-10-08 Align controls with CAD panels, LED map from panel_labels.json, wiring diagrams, docs, udev rules
2026-10-08 Game: Godot project core - 6DOF sim, systems, missions, input (firmware map), LEDs, audio
2026-10-09 CAD + frame: parametric OpenSCAD panel library, 11 backlit panels, printed parts, 3MF/PNG exports, wooden frame drawings, cut list, BOM
    - cad/lib: 40 mm grid M5 mounting, standard cut-outs, through-panel lettering,
    WS2812B light boxes, seam pins, missile-switch guards
    - cad/panels (generated from cad/tools/layouts.py): Pilot, Ops, Overhead, Commander
    - cad/parts: throttle quadrant, gear lever, joystick housing + adapter, 15.6in bezel,
    VESA100 monitor hangers, ESP32-S3 enclosures, cable clips, limit-switch mounts
    - cad/export: multi-material + single-material 3MF for every panel, 3MF for every
    part (validated), PNG renders + assembled overview
    - frame: parametric 2x4/ply frame model, pi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
    [CMD_A.scad, CMD_A_multimaterial.3mf, CMD_A_single_body.3mf, CMD_A_single_letter_inserts_WHITE.3mf, CMD_B.scad, CMD_B_multimaterial.3mf, CMD_B_single_body.3mf, CMD_B_single_letter_inserts_WHITE.3mf]
2026-10-09 game: playable v0.1 - display manager, HUD/console UI, flight bots, docs
    - DisplayManager: N out-the-window views (display/views) with generic off-axis
    frusta from physical screen rectangles, per-output warp-shader hook (future
    projector dome), cockpit (one window per screen) and tiled dev mode
    - Frame pacing for 144/75/60 Hz screens: 75 FPS cap + MAILBOX vsync per window
    - Scaled-space rendering for distant bodies (float32 frustum limit), atmosphere
    on camera-centred proxy, ship hull hidden from cockpit eye (render layer 11)
    - HUD (pilot/ops), touchscreen console (MISSION/NAV/SYSTEMS/CHECKLIST/CAMERAS/
    CONTROLS/SETUP) sized for 22in 1080p touch
    - Mission tuning: launch guidance, lun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
2026-10-09 Mechanical v0.2: reclining cradle + drop-down instrument pod, real displays, harness hub, dome study
    - frame: seats on a floor-level base; kid cradle reclines 35 deg (2 x 10" 1500 N actuators),
    then the pod (monitors, dash, overhead) swings 95->40 deg about the reclined head centre
    (2 x 12" 1000 N actuators, 2 gas struts, near-neutral); hard stops, pawl locks up/down,
    hardwired limit-switch interlock, two-hand control at dad's fixed seat; clearance checks;
    new drawings, cut list, BOM, README
    - displays: Sceptre C275B-144R (VESA 100) / C275W-1920RN (VESA 75) standoffs, TD2220
    flat console trim (6 pieces) + VESA riser, GPU cabling (docs/mechanical/displays.md)
    - harness hub for the B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
    [CMD_A.scad, CMD_A_multimaterial.3mf, CMD_A_single_body.3mf, CMD_A_single_letter_inserts_WHITE.3mf, CMD_B.scad, CMD_B_multimaterial.3mf, CMD_B_single_body.3mf, CMD_B_single_letter_inserts_WHITE.3mf]
2026-10-09 game: visual realism pass - exposure, clouds/planet/atmosphere, PBR station+ship, pad tower+smoke, heat haze, minimal HUD, R-bar docking, pad orbit readout
2026-10-09 Add BOM spreadsheet and project README
    [Filament_Falcon_BOM.csv, Filament_Falcon_BOM.xlsx]
2026-10-09 Location: Fredericton, NB; rebuild BOM and project book
    [Filament_Falcon_BOM.csv, Filament_Falcon_BOM.xlsx]
2026-10-10 Game: four-screen cockpit - kids' touch console + Commander screen, auto touch mapping
    - Four roles (left window, right window, kids' console, commander) assigned by xrandr
    output name / physical size (console ~22" or portrait, commander = biggest spare
    screen, windows left to right); any role can be pinned via display/<role>_output or
    <role>_screen and on Commander > SETUP. Dev mode tiles all four views; with three
    screens the Commander UI becomes a console tab (Esc). Portrait console supported,
    landscape recommended. Old fixed screen indices migrate (layout_version 2).
    - Kids' console rebuilt as pure instruments + controls: FLIGHT (ADI, speed/altitude
    tapes, fuel, engine/gear/f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
    [build_book.py]
2026-10-11 Pod: single 1500 N actuator + steel torque tube, lift-biased struts (frame v0.3)
    - one 12" 1500 N self-locking actuator in the left casing (RVMARINEPAT LA03-12-300-1500N, 420 mm retracted)
    - 2x2x1/8 in steel torque tube ties the right cheek (298 N m/deg)
    - gas struts ~1050 N, M8 eye ends; net torque +16..+88 N m so an actuator/clevis failure sends the pod UP
    - one pod limit set (left cheek); drawings, renders (overview_pod_drive), cut list, frame BOM/README, mechanical README, SPEC
    - spreadsheet BOM motion section updated, LibreOffice-recalculated
    [Filament_Falcon_BOM.csv, Filament_Falcon_BOM.xlsx, cut_list.csv, frame.scad, overview.scad]
2026-10-11 ICS intercom (3 USB headsets, VOX/PTT, radio FX, ALL-CALL, mission-control channel), virtual panels + sticks for unplugged boards, crew-position v0.2 (pod/cradle senses, callouts, diagram 04), docs +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
2026-10-11 Intercom buttons on the CAD panels, 3 position senses, BOM + book
    - PILOT_PTT (16 mm, PILOT_SIDE beside the throttle, Pilot bit 11), OPS_PTT (16 mm,
    OPS_SIDE end nearest the Ops seat, Ops bit 13), CMD_ALL_CALL (16 mm, CMD_A next to
    INTERCOM, Command bit 7), all with backlit labels; START/PAUSE/INTERCOM respaced
    - regenerated panels, 3MFs, renders, validation, switch_bom, shared/panel_labels.json,
    placeholder shared/led_segments.json (242 LEDs) + firmware led map (all 4 envs build),
    game virtual panels (PTT/ALL-CALL actions)
    - frame/BOM, frame README, sheet 04, electronics README + diagram 04: 3 read-only
    position senses (cradle reclined, pod down-locked, pod up-locked optional) via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
    [CMD_A.scad, CMD_A_multimaterial.3mf, CMD_A_single_body.3mf, CMD_A_single_letter_inserts_WHITE.3mf, Filament_Falcon_BOM.csv, Filament_Falcon_BOM.xlsx, OPS_SIDE.scad, OPS_SIDE_multimaterial.3mf]
2026-10-12 VR spacewalks for Meta Quest 3 (WiVRn): separate EVA client, full-body avatar in windows/cams, 5 EVAs, 4th ICS seat, flat mode, docs + tests
    - EVA client process (godot --xr-mode on -- --eva-client / run.sh --eva-vr) owns OpenXR,
    streams the astronaut pose to the cockpit at ~90 Hz over UDP 47820; cockpit interpolates (45 ms)
    and never loads OpenXR
    - procedural EMU avatar (IK arms, gloves, visor, helmet lamps, PLSS/SAFER, tether), visible in the
    LEFT/RIGHT windows and every camera feed; helmet cam hides head/body layers; wave/point/knock/palm
    - spacewalks: window visit, antenna swap, asteroid sample + beacon, moonwalk, Canadarm rescue;
    Mission EVA overlay objective; console EVA page (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
    [build_book.py, falcon_ics.py, test_falcon_ics.py]
2026-10-12 Panels: one multi-material 3MF, panel and letters as separate objects
    Each panel file was a single mesh, so slicers opened it as one colour. There is now one 3MF per panel: a black panel object and a white letters object, with both filaments assigned for PrusaSlicer, OrcaSlicer and Bambu Studio. The letter object is the face lettering plus the 0.8 mm backing box behind each label. The single-body and press-fit insert files are removed.
    [CMD_A.3mf, CMD_A_multimaterial.3mf, CMD_A_single_body.3mf, CMD_A_single_letter_inserts_WHITE.3mf, CMD_B.3mf, CMD_B_multimaterial.3mf, CMD_B_single_body.3mf, CMD_B_single_letter_inserts_WHITE.3mf]
2026-10-14 Panel 3MFs: one two-colour file per panel (body + letters as separate objects)
    - cad/export/3mf/panels/<ID>.3mf replaces *_multimaterial / *_single_body /
    *_single_letter_inserts_WHITE; sm_body / sm_inserts removed from ff_panel.scad
    - threemf.py: each part is its own mesh object with its own base material
    (pid/pindex), grouped as components of one assembly (shared coordinates);
    Bambu/Orca model_settings.config (body = filament 1, letters = 2) and
    PrusaSlicer Slic3r_PE_model.config extruders
    - build.py validation: watertight bodies/letters, light-box walls behind every
    label, letters 0..3 mm, letters/body overlap (0 mm3), XML structure + extruders
    - docs/mechanical/README print sec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
    [CMD_A.3mf, CMD_A_multimaterial.3mf, CMD_A_single_body.3mf, CMD_A_single_letter_inserts_WHITE.3mf, CMD_B.3mf, CMD_B_multimaterial.3mf, CMD_B_single_body.3mf, CMD_B_single_letter_inserts_WHITE.3mf]
2026-10-15 Audio: fix garbled intercom (10 ms blocks, 30 ms cushion), sfx soft-clip + bigger buffer, engine whine/RCS thunk/fan beat, troubleshooting doc
    [falcon_ics.py]
2026-10-15 EVA VR: OpenXR action map + grip_pose, spawn outside hull at airlock, gloves, XR diagnostics log; realistic non-tiling starfield
2026-10-15 Starship-style Falcon (stainless, tiles, flaps, Raptors, crew windows), solid EVA hull collision, 3 cm VR near plane, articulated analog gloves + fabric suit, kids' crew avatars with WAVE + idle look
2026-10-15 ICS: per-station MIC IN/AUDIO OUT pickers with live meters (no stealing, persisted, live), name+port matching, unique devices per station, unmute/resume sources, per-station logging, no duplicate hel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
2026-10-15 Commander ICS: framed per-station cards, MIC IN/AUDIO OUT dropdowns with friendly names (free devices only), scrollable pages + wrapping SETUP, headless UI-fit test
2026-10-19 10 new kid missions: REAL ISS (TLE), CITY LIGHTS, HOUSTON A PROBLEM, SPLASHDOWN, CATCH THE SPACEWALKER, PLANT THE FLAG, CAPTAIN'S LOG (ICS recording), ALIEN SIGNAL, GROUND CREW (LAN phone page), BEDT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
    [falcon_ics.py]
2026-10-20 Clean quit: Commander top-bar QUIT GAME (confirm), close/Alt+F4 on any window quits (helpers, VR client, WiVRn, ground server stopped); fetch_assets.sh: run from anywhere, Moon fallback URLs + TIF/JP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
2026-10-20 VR: fix moonwalk jitter (smooth client clock, entities advanced between snapshots), 90 Hz + matched physics tick; OpenXR hand tracking with auto switch, pinch/fist gestures, per-finger gloves
2026-10-20 Earth: HD textures (16k Blue Marble, 8k night/clouds, GEBCO normal map + land mask) streamed on a worker thread and cached compressed; sun/view transmittance, aerial perspective, ozone, GGX ocean gli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
2026-10-20 Cities: Geofabrik NB .pbf via pyosmium (osmium-tool cut, 30-day If-Modified-Since refresh), cached extracts + shared DEM tiles + versioned up-to-date builds, parallel chunk build with per-vertex land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
2026-10-24 ICS outputs: AUDIO OUT picks stored by USB port (identical headsets swap .2 node names), analog sink + native channels, sinks unmuted/unsuspended, pacat errors logged + auto-reattach, per-station OUT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
    [falcon_ics.py, test_falcon_ics.py]
2026-10-24 Real-size Earth (6371 km, real Moon): PlanetLOD cube-sphere quadtree + floating origin, EarthTerrain (region hook > area packs > global DEM/mask > noise), missions retuned; area manager (tools/area_m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
    [area_manager.py, build_region.py]
2026-10-24 Docked/clamped ship carries its anchor along each step (real-size orbit: station moves ~64 m per tick, EVA antenna job missed the station); smoke 16/16 + EVA pass
2026-10-25 Terrain threading: fix SIGSEGV in EarthTerrain.sample on LOD workers
    LOD worker threads read EarthTerrain.packs, body.sites and the region render_hook per vertex
    while the main thread swapped them (area delete/rebuild -> reload_packs) or freed the region,
    and add_site/clear_sites mutated the sites array in place.
    - PlanetLOD/RegionView.quiesce(): wait for + drop in-flight chunk builds; World calls it
    before reload_packs, before a region is swapped/freed, and on quit (shutdown_workers)
    - sites are copy-on-write (old lists kept alive); hooks are set via set_hooks (no write
    when unchanged); hot path stays lock-free (no per-vertex mutex cost)
    - the Earth HD texture decode task is tracked so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
2026-10-25 Areas: format error, map ids, idempotent delete, >120 km clamp/split
    - commander_ui: the SET name used '%g' (Godot has no %g) -> 'unsupported format character'
    and the raw format string became the area name; labels are concatenated, never used as
    format strings
    - map/UI ids (area_45.964_-66.643) are normalised the same way as the CLI; the CLI looks up
    registry ids before presets, so custom ids work
    - delete is idempotent ('already deleted'), drops queued jobs, cancels a running job and
    removes it when the runner stops; status skips half-deleted areas; the UI disables DELETE
    while it runs
    - boxes over 120 km: --fit clamp (120 km box around the centre) or --fit split (<=64 tiles
    <i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
    [area_manager.py]
2026-10-25 VR hand tracking: glove orientation + finger curls from joint positions
    Root cause: Godot's OpenXR module stores hand joints in its humanoid-skeleton convention
    (OpenXR basis * bone adjustment: +Y along the bone to the fingertip, +Z out of the palm, X
    mirrored). The glove (fingers -Z, palm pad -Y) was given the PALM joint basis directly, so its
    fingers pointed out of the back of the hand and curled toward the wrist. Curls were unsigned.
    - HandPose: palm frame from joint positions (wrist->middle knuckle, pinky->index knuckles,
    palm normal with per-hand sign), signed per-finger flexion (hyperextension doesn't curl)
    - AstronautModel.pose_fingers() factored out of apply_pose
    - --hand-test: syn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
2026-10-25 VR: orderly quit (end the OpenXR session first) + no status log spam
    Quit crash: the cockpit SIGKILLed the VR client right after sending 'quit' and then stopped
    WiVRn; the client itself (and window close via Game.quit_game) called get_tree().quit() with the
    XR session live and LOD workers running, so teardown raced the runtime
    (XR_ERROR_SESSION_NOT_STOPPING, spatial-entity disconnect, leaked RIDs, SIGSEGV in
    pthread_mutex_lock).
    - EvaClient.quit_clean(): stop sim + world workers, use_xr off, wait a drawn frame,
    XRInterface.uninitialize(), quit next frame; guarded against double quit; Game.quit_game
    in the client delegates to it
    - EvaLink.stop_client(): waits up to 4 s for the client to e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
2026-10-26 Touchscreen no longer steals the mouse pointer or keyboard focus
    run.sh floats the TD2220 (XI2 multi-touch) or gives a plain absolute touch pointer its own
    master pointer while the game runs (tools/touch_isolate.sh), with a watcher that restores it
    on exit/crash. With a separate Commander screen the console window is unfocusable and carries
    WM_HINTS input=False (tools/x11_no_input_hint.py). FALCON_TOUCH_ISOLATE=0 / --no-touch-isolate
    turns it off; no-op on Wayland, without xinput or touchscreen.
    [x11_no_input_hint.py]
2026-10-26 EVA: spacewalker is its own inertial body in every view
    - release / detach (rail push-off, flat rail, canopy frame, arm) inherits the hull
    velocity at that point (w x r) + push-off / arm tip motion (was ship-relative / 0)
    - tether limit and hull bumps react to velocity relative to the turning hull
    - ship motion fed to the sim (and the VR client) = actual ang_vel + proper accel
    (all of it, not only when thrusting), zero while paused / docked / landed
    - EvaView placed like the hull model (ship offset from the floating origin), so
    windows, camera feeds and the VR head agree, also with the free camera
    - tests/eva_frame_test.gd (--eva-frame-test), docs
2026-10-26 Touch: mouse cursor no longer vanishes after a tap
    Cause: Cinnamon's muffin hides the cursor (XFixes, screen-wide) when the last
    device is a touchscreen and shows it only on a core-pointer slave switch. The
    auto mode looked for 'direct touch' but xinput prints 'Touch mode: direct', so
    real touchscreens went on the 'Falcon Touch' master, and mouse moves never
    switched the core pointer back -> cursor stayed hidden.
    - touch_isolate.sh: detect 'Touch mode: direct' -> float; warn about unclutter
    - tools/x11_show_cursor.py: XTEST 1 px nudge so the WM shows the cursor again
    - display_manager: after touches keep mouse_mode VISIBLE (+1 Hz) and run the
    nudge (<= 1/s, trailing); FALCON_CURSOR_NUDGE=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
    [x11_show_cursor.py]
2026-10-26 EVA: tether pull-back (hand over hand, REEL IN) and flying with the spacewalker outside
    - EvaSim tether: retractable reel + stiff damped spring at full length (tension, warn 1500 N,
    snap 4500 N); grab the line (VR grip near it / flat T) and pull hand over hand with momentum;
    REEL IN (VR stick click hold / flat V / crew assist button) at an adjustable speed, stops at the hatch
    - Moon surface frame: ground plane + ground velocity + ship acceleration relative to the Moon as
    inputs, so on liftoff a standing walker is left behind, a ladder holder carried, a tethered one lifted
    - Engine no longer hard-blocked during EVA: ignition asks the Commander BURN GO / NO-GO
    - Eva ends the walk when le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
2026-10-28 AREAS: job runner really starts (was an endless run->run hand-over), flock lock + stale-job recovery, start errors/log/progress in the UI, RUN/RETRY NOW, status says why jobs wait; multi-extract OSM 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
    [area_manager.py, build_region.py]
2026-10-28 Nav map: lit Earth/Moon globes from the NASA textures (terminator, city lights, clouds, atmosphere), ground sites, low-altitude GROUND close-up with OSM overlay (tools/nav_overlay.py)
2026-10-28 AREAS map: OSM roads (by tier), rivers, lakes and city/town/village names by zoom from a compact vector layer (tools/map_layer.py -> maps/*.ffml), lazy background load, culled cached buckets, BUILD M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
